fmarples/18649_team4/README.md

# Team 4 Lab 2

**Managed session:** `start.py` starts/connects the Pi bridge and wheel GUI;
`stop.py` stops only the managed pair. Start can cause motion; keep hands clear
and pedals released. See [session ownership and logs](doc/ONE_CLICK_START.md).

`main` contains the combined Part 3 actuator implementation and Part 4 Zephyr
scheduling. Use the current firmware for combined motor, brake, steering and
blinker testing; there is no separate Part 4 application or required rollback.
Part 3.5 ADC acquisition is implemented with nominal ACS712 5A calibration and
upper-ADC-rail clipping at -4320 mA for reversed motor sensors and +4320 mA for
servo. There is no symmetric current cap. Physical calibration and combined timing remain pending.

## Code

- `stm32_zephyr/`: NUCLEO-F401RE firmware, UART parsing, motor/PID control,
  steering, blinkers, self-test, scheduling, current interface and timing markers.
- `pi/`: UDP-to-UART bridge, CRC protocol and optional GPIO timing markers.
- `windows/`: wheel-proxy launcher with event-filtered physical-input logs and
  read-only current charts, servo console and firmware build helper.
- `bringup/encoder_test/` and `bringup/motor_test/`: independent diagnostics.
- `tests/` and `test_protocol.py`: software and explicitly invoked hardware tests.
- `tools/`: generated-build checks, bounded QEMU runner and status-log summary.

The Part 3 integration commit is `3b04a43`; the Part 4 implementation commit is
`18da014`. The retired branches are preserved as archive tags.

## Architecture and operating policy

`Logitech wheel -> Windows proxy -> UDP 8000 -> Pi -> USART1 -> STM32 actuators`

The Pi link uses 115200 baud, 8N1. Commands carry raw wheel/pedal values and
buttons; status carries system state and current validity. Deploy matching
Pi and STM32 versions and all `pi/*.py` dependencies together. Read-only status
returns to the laptop on UDP 8002, separate from force-feedback UDP 8001.

One priority-1 owner applies motor outputs before steering and lamps. Status,
current sampling and USB diagnostics run at priorities 2, 3 and 4 respectively.
The three current channels use ADC1 with nominal calibration; failed or stale
acquisition is unavailable. Current telemetry does not control actuators.

Steering embeds the tracked 1200/1600/2000 us calibration. Boot and fault/link
recovery wait for healthy Pi commands and a centered wheel before LIVE. Vehicle
steering does not require a USB heartbeat; manual calibration retains its lease.
The servo console's OFF command does not stop motors. See the
[integration design](doc/INTEGRATION.md) and [protocol](PROTOCOL.md) for details.

## Team documentation

- [Lab 4 PCB design files, power calculations, pin map and BOM](lab4/README.md)

- [September 28 bench summary: changes, tests and remaining work](doc/SESSION_2026-09-28.md)
- [Actuator stability investigation and verification](doc/ACTUATOR_STABILITY.md)
- [Task table and scheduling rationale](PART4_TASK_TABLE.md)
- [Hardware BOM/power record](doc/HARDWARE.md) and [pin assignments](doc/STM32_PINOUT.md)
- [Encoder calibration](doc/ENCODER_SPEC.md) and [motor characterization](doc/MOTOR_CHARACTERIZATION.md)
- [Current-sensor backend contract](doc/CURRENT_SENSOR_HANDOFF.md)
- [GUI telemetry and physical input logging](doc/GUI_TELEMETRY.md)
- [ADC hang diagnosis and grounding verification](doc/CURRENT_ADC_DIAGNOSIS.md)
- [Centered-start steering policy and evidence](doc/STEERING_AUTONOMOUS.md)
- [Timing points and measurement method](doc/PART4_TIMING.md)
- [Blank measurement worksheet](doc/PART4_MEASUREMENTS.csv)
- [Software verification record](doc/PART4_SOFTWARE_RESULTS.md)
- [Steering evidence](doc/PART3_3_RESULTS.md) and [blinker evidence](doc/PART3_4_RESULTS.md)
- [Lab 2 handout](doc/18-449_649%20Lab2%20-%20Sensors%20and%20Actuators%20v1_0.pdf)

The integrated image builds and software verification is recorded in the linked
reports, including host-dependent test skips. Combined motor/steering operation
and three-channel current acquisition have been observed on the stability branch.
Transient link timeouts, current calibration and physical timing remain open;
software test results do not certify those measurements.

## Build and software checks

From the repository root on Windows, with an installed Zephyr workspace/SDK:

```powershell
.\windows\build_part4.ps1 -ZephyrWorkspace 'C:\path\to\zephyrproject' -Sdk 'C:\path\to\zephyr-sdk'
```

This only builds and checks configuration; it does not flash or open hardware.
Output: `build/part4/zephyr/zephyr.bin`. Generic software checks in the appropriate
Python environment are:

```sh
python -m unittest discover -s tests -p "test_*.py" -v
python test_protocol.py -v
```

Native C wrappers may skip without host GCC; the ARM/QEMU suite lives in
`tests/integration/`. Build outputs and run logs are ignored by Git.
Personal operator walkthroughs and tutoring notes are maintained outside this
repository.
