fmarples/18649_team4/lab4/review-package/Drill-report.txt

Drill report for Lab4.kicad_pcb
Created on 2026-11-02T14:50:01

Copper Layer Stackup:
    =============================================================
    L1 :  F.Cu                      front
    L2 :  In1.Cu                    in1
    L3 :  In2.Cu                    in2
    L4 :  B.Cu                      back

Drill file 'Lab4-PTH.drl' contains
    plated through holes:
    =============================================================
    T1  0.300mm  0.0118"  (997 holes))
    T2  0.400mm  0.0157"  (63 holes))
    T3  0.800mm  0.0315"  (3 holes))
    T4  1.000mm  0.0394"  (192 holes))
    T5  1.020mm  0.0402"  (36 holes))
    T6  1.100mm  0.0433"  (15 holes))
    T7  1.200mm  0.0472"  (2 holes))
    T8  1.780mm  0.0701"  (4 holes))
    T9  1.800mm  0.0709"  (9 holes))
    T10  2.890mm  0.1138"  (2 holes))

    Total plated holes count 1323

Drill file 'Lab4-NPTH.drl' contains
    unplated through holes:
    =============================================================
    T1  1.600mm  0.0630"  (4 holes))
    T2  2.700mm  0.1063"  (4 holes))
    T3  4.000mm  0.1575"  (4 holes))

    Total unplated holes count 12
