fmarples/18649_team4/lab4/CAN-geometry-review.md

# CAN copper geometry review

## November 2 local-pair update

Front B (U15/J14) and Pi B (U35/J34) now share adjacent In2 runs with short
front-layer escapes. Each line uses one via. Same-layer proximity within
1 mm is 93.4%/83.2% for Front B and 90.2%/70.4% for Pi B, with longer local
paths as the tradeoff. Four other local interfaces retain their existing
routes. This is not complete pair coupling or signal-integrity qualification.
See [the complete comparison](November2-Anson-review-check.json).
The main bus routes are unchanged; the current reference-plane scan below
is regenerated against the revised fills.

## November 1 update

The new 0.381 mm CAN-to-zone clearance enlarges the cleared areas around
plated contacts. The refreshed scan records 41 reference-plane gaps outside
the older 1 mm hole-exclusion screen: 12 on CAN_A_H, 10 on CAN_A_L, 10 on
CAN_B_H and 9 on CAN_B_L. All 41 lie within the required clearance around
the actual CAN pad/via shapes; none is an unexplained gap away from those
contacts. [CAN-geometry-check.json](CAN-geometry-check.json) retains their
coordinates and classification. These intentional gaps are still gaps:
the classification does not establish continuous reference copper or
qualify signal integrity. The zero-gap result below describes the earlier
October revision, before the larger clearance rule.

26 October 2026. We measured the saved board geometry with
`check_can_geometry.py`; [CAN-geometry-check.json](CAN-geometry-check.json)
records the source hash and individual inspection coordinates. This review
does not qualify signal integrity or release the board for fabrication.

## Recorded geometry

| Net | Total copper length, including branches | In2 portion | Signal vias |
| --- | ---: | ---: | ---: |
| CAN_A_H | 256.566 mm | 32.471 mm | 4 |
| CAN_A_L | 251.328 mm | 66.210 mm | 13 |
| CAN_B_H | 242.011 mm | 32.471 mm | 4 |
| CAN_B_L | 236.772 mm | 72.710 mm | 13 |

All four nets use 0.20 mm traces on F.Cu and In2.Cu. Totals include test,
termination and node branches; subtracting H and L totals does not give
end-to-end timing skew. About 52–60% of their length has the opposite line
within 0.65 mm on the same layer. This nearest-line measurement does not
establish parallel coupling, nor is that fraction a pass/fail criterion.

For a straight front-layer pair with 0.20 mm traces and 0.40 mm edge spacing,
the approximate microstrip equations in [TI SLVA531A, section 7.1](https://www.ti.com/lit/an/slva531a/slva531a.pdf)
give 124 ohms differential using our [reference stack](Layer-stack.md):
0.21040 mm dielectric, Dk 4.4 and 0.035 mm copper. This is a nominal geometry
calculation. It omits solder mask, nearby coplanar fill, bends, pad transitions,
In2 routing and fabrication tolerances; it is not a whole-bus impedance claim.

## Ground-reference repair and remaining review

The checker samples trace centerlines at intervals no greater than 0.5 mm,
excluding samples within 1 mm of the same signal's through-hole pads/vias.
The F.Cu routes have In1 ground underneath at the remaining sample points.
In2 is closest to B.Cu, whose ground fill contains other routes.

The previous scan found nine CAN_A_H and three CAN_A_L reference-void samples
near the front CAN circuit. We rerouted the bottom 3.3 V feed around the
affected area and moved the F_MOSI crossing. The updated scan finds **zero
reference-void samples on all four nets** outside the excluded pad/via areas.
The CAN backbone copper itself is unchanged, so the lengths above are unchanged.
Sampling does not establish a continuous reference everywhere.

The replacement 3.3 V feed uses four added vias and a 0.50 mm minimum width;
its length increases from 10.833 mm to 47.303 mm. Clear sections are wider.
The F_MOSI replacement decreases from 10.533 mm to 9.292 mm without added
signal vias. [Supply-path-review.md](Supply-path-review.md) records the
resistance cost of preserving the CAN reference. We also added one ground
stitch near the CAN_B_L transition at (151.4, 209.4) mm after relocating a
ground via away from a solder pad. Coordinates are KiCad board coordinates.

## Branch and detour assessment — October 27

The new [digital geometry check](Digital-geometry-check.json) separates the
termination-to-termination path from branch copper. Whole segments and full
1.6 mm via barrels are counted; these are not extracted electrical lengths.

| Net | Main path | Vias on main path | Longest bus-side branch |
| --- | ---: | ---: | ---: |
| A H | 238.781 mm | 4 | 18.591 mm |
| A L | 231.967 mm | 8 | 24.921 mm |
| B H | 220.098 mm | 4 | 24.450 mm |
| B L | 213.284 mm | 8 | 30.921 mm |

Local transceiver-to-isolation copper adds 24.290–35.468 mm and two vias,
plus the jumper contact. Even adding the two largest figures gives about
66.4 mm before the contact, below the 0.3 m stub guideline for 1 Mbps in
[TI's CAN physical-layer guide](https://www.ti.com/lit/an/slla270/slla270.pdf).
That comparison is a scale check, not a controlled-impedance guarantee.

At an assumed 7 ps/mm propagation delay, a roughly 0.31 m path including
local connections has about 2.2 ns one-way delay. This is short relative to
the transceiver's 25 ns minimum high-speed rise-time test value. We therefore
keep the short routes rather than add length merely to equalize the counts.
The recorded main H/L difference is 6.814 mm on each bus; whole-item lengths
cannot establish precise skew. Preserve ground references, separation from
switching copper and the documented stack in subsequent edits. Source:
[SN65HVD231 datasheet](https://www.ti.com/lit/ds/symlink/sn65hvd231.pdf).

The digital branch/detour assessment is complete for this revision. Exact
impedance, reflections and EMC remain unqualified; evaluate the assembled
bus rather than treating this comparison as a measured waveform result.

The distance calculation passed analytic checks for a point on a segment,
beside it and beyond its endpoint. Native DRC and targeted connectivity checks
verify connections separately; they do not validate transmission-line behavior.
