fmarples/18649_team4/lab4/Layer-stack.md

# Four-layer routing reference

**October 30 fabrication handoff:** 4 layers, nominal 1.6 mm,
**JLC04161H-7628, 1 oz outer / 0.5 oz inner copper**. These are the current
saved-board settings; no 2 oz copper or controlled-impedance order is requested.
The same specification is included in the review package's `REVIEW-ONLY.txt`.
This records the intended order settings, not a message sent to staff or an order.

26 October 2026. We use **JLC04161H-7628**, nominal 1.6 mm, as the
reference stack for the remaining layout review. The intended copper weights
are 1 oz outer / 0.5 oz inner. This records a design baseline, not an order or
a controlled-impedance qualification. Confirm the same stack in the final
fabrication package and order settings.

| Layer / material | Published thickness | Our use |
| --- | ---: | --- |
| F.Cu | 0.035 mm | Components, local signals, power and ground fill |
| 7628 prepreg | 0.21040 mm | Dielectric, published Dk 4.4 |
| In1.Cu | 0.0152 mm | Ground plane |
| Core | 1.065 mm | Dielectric, published Dk 4.6 |
| In2.Cu | 0.0152 mm | Signals and provisional supply branches |
| 7628 prepreg | 0.21040 mm | Dielectric, published Dk 4.4 |
| B.Cu | 0.035 mm | Pi socket, signals, power and ground fill |

Source: [JLCPCB stackup table](https://jlcpcb.com/impedance), checked October 26.
These are the fabricator's listed nominal values; they are not measurements of
our board. KiCad now records the detailed copper/dielectric thicknesses and
dielectric constants above as well as four copper layers and nominal 1.6 mm
board thickness. The copper/dielectric sum is 1.5862 mm, before solder mask;
it is consistent with the fabricator's nominal 1.6 mm stack description.
The same published table was rechecked on October 28. This is still not an
impedance-controlled order or a production thickness measurement.

In2 is much closer to B.Cu than to In1.Cu in this arrangement. We therefore
must review the bottom ground fill beneath inner signal routes as well as the
In1 plane. Merely moving a signal to an inner layer does not give it a
continuous nearby ground reference. CAN pair spacing, detours, layer changes
and return continuity still need final refinement. The initial
[CAN geometry audit](CAN-geometry-review.md) records the measured copper and
the repaired reference crossings; its nominal front-pair estimate is not a fabrication
impedance qualification.

The inner copper is thinner than the outer copper. The new supply joins
establish connectivity; they are not a final current rating. Before release,
check the worst supply-path voltage drop and widen or parallel the trunks as
needed. The multiamp Pi, servo and motor paths need their own copper-width and
via review. No hardware tests or fabrication approval are implied.
