fmarples/18649_team4/lab4/Return-path-review.md

# Ground, feedback and supply routing review

26 October 2026. This is a review of the saved copper, not a powered test or
fabrication release. [Return-path-check.json](Return-path-check.json) records
the board hash and geometric/connectivity observations. Run
`check_return_paths.py` with KiCad Python to regenerate it; use the native DRC
report for disconnected copper islands.

## Connections and remaining geometry checks

The three lower feedback resistors now have explicit 0.20 mm front-copper
branches to their regulator ground pins. All three paths pass a connectivity
check with zones excluded during traversal. Their pad-center separation is
6.729 mm. The earlier revision connected them through pours only; that
limitation is now corrected. Because the traces share the ground pour, these
checks do not establish an isolated quiet return or measured noise performance.
Before release, review the actual feedback branch and input/output capacitor
return geometry against the [TPS564252 layout guidance](https://www.ti.com/lit/ds/symlink/tps564252.pdf),
especially the separate feedback return, compact input loop and wide output
capacitor return. Effective capacitance under DC bias remains a separate check.

Both INA180 inputs have explicit paths to the corresponding R1 shunt pads.
Keep these as separate sense branches at the shunt terminals while refining
the connected servo load route; do not move a sense connection onto a distant power
trace. The [INA180 layout guidance](https://www.ti.com/lit/ds/symlink/ina180.pdf)
calls for Kelvin connections and closely matched input routing. Final loop
area and noise coupling still need review. U2/U3 are ACS712 magnetic current
sensors; their motor-current paths need a width/return review, not external
shunt-input routing.

## CAN ground transitions

We added twenty ground vias near CAN signal-layer transitions. The placement
search targeted sites with no ground via or ground through-hole pad within
3 mm, then added a clear site within 2.5 mm. These distances are design-review
targets, not a manufacturer signal-integrity limit. The JSON records every
CAN signal via's distance to the nearest ground transition.

The plane-centerline samples also include ordinary pad/via clearance holes.
A sampled void is a location to inspect, not automatically an electrical
failure. Check the filled In1 plane and bottom ground fill, especially where
routes change layers. [Layer-stack.md](Layer-stack.md) explains why In2 signals
also need the nearby B.Cu reference reviewed. The [CAN geometry audit](CAN-geometry-review.md) now records branch-inclusive
lengths, pair proximity and the repaired bus-A reference crossings. Rerouting
the adjacent 3.3 V and MOSI copper leaves zero CAN reference-void samples
outside the checker's own-pad/via exclusions. That checker uses In1 for F.Cu
and B.Cu for In2, unlike the broad In1-only screening in Return-path-check.json.
We added one further ground stitch near CAN_B_L after moving a ground via
off a solder land. All CAN transitions remain within our 3 mm review target.
The branch/detour assessment is recorded in CAN-geometry-review.md.
Controlled impedance and assembled-bus waveforms remain unqualified.

## Initial supply resistance screening

The new 3.3 V joins connect the main MCU/CAN supply groups to the regulator;
both encoder pull-ups are now connected. The 5 V regulator now reaches all
5 V load groups. The servo shunt reaches J90, and the motor outputs reach
their sensors, connectors and flyback diodes. The existing input-power circuit is now connected. Final current/return
sizing and battery/protection decisions remain unfinished.

[Supply-path-review.md](Supply-path-review.md) now uses actual saved conductor
geometry to screen 3.3 V, 5 V, motor and servo paths. It flags the long supply paths for
load allocation and widening/parallel-via review. The October 27 allocation
and widening results are now recorded in that review. The calculation does not
establish thermal current capability or guaranteed load voltage.

As a calculation example, using copper resistivity 1.72e-8 ohm-metres at about
20 degrees C, a 100 mm long, 0.8 mm wide trace has resistance
`R = resistivity * length / (width * thickness)`:

| Copper thickness | Calculated resistance | Drop at assumed 0.8 A |
| --- | ---: | ---: |
| 0.0152 mm inner copper | 0.141 ohm | 0.113 V |
| 0.035 mm outer copper | 0.0614 ohm | 0.0491 V |

These examples exclude vias, connectors, return resistance and heating, and
are not a calculation of the complete board. Use actual branch loads and
route lengths to check the worst load voltage, then widen or parallel supply
trunks as needed. Check thermal current capability separately. A successful
connectivity check alone does not settle either requirement.

## Routed sense/feedback geometry — October 27

The three feedback returns are explicit 9.250 mm front traces with no vias.
The shunt IN+ route is 22.912 mm with two vias; IN− is 21.453 mm with four.
The servo load route from R1.2 to J90.2 is 98.918 mm with one via. The
shared-conductor check uses object identities and finds zero shared trace/via
objects between either sense branch and its corresponding load route.
This confirms separate routed taps at the shunt. It does not establish
matched loop area, immunity to switching pickup or zero current in shared
pad copper. Keep the sense taps at the shunt; do not add balancing meanders
merely to equalize via count.

The geometry review is complete at this level. The later
[ground-plane DC screen](Ground-plane-review.md) now models the saved In1
fill and shared return currents. It closes the bulk-plane calculation for
the stated scenarios, not local connection resistance or thermal/noise
qualification. Zero unconnected items proves connectivity, not a bound on
ground bounce. Ripple, ADC noise and loaded temperature are assembly/bring-up
tests, not requests to measure the unbuilt PCB before Thursday.

## Supply-width follow-up — October 27

The later supply widening preserves the CAN backbones, via locations,
reference-plane definitions and all pad connections. We restored the old
widths around six front-ground patches after the initial candidate split
one patch; the accepted revision has zero missing ground connections. Fresh
CAN-reference and nearest-ground-transition checks pass their existing
criteria. This verifies connectivity/reference coverage at the checked
locations, not plane voltage drop or switching-noise performance.
