fmarples/18649_team4/doc/INTEGRATION.md

# Integrated firmware

`main` contains one Zephyr application combining Parts 3.1-3.4 with Part 4
scheduling and instrumentation. Part 4 is not a separate replacement for the
actuator implementation: combined Part 3 tests use this same firmware.
The older motor-only commit is an archived diagnostic baseline, not required
for normal combined testing.

## Components and integration decisions

- Motor/encoder/PID implementation from `983cb1b`, combined with steering,
  blinkers and self-test in `3b04a43`.
- Existing 1320 counts/revolution, corrected forward signs, average wheel-speed
  control, 23..300 RPM active targets, 60%/200 ms startup and 40..100% running
  PWM policy retained. Motor/PID tuning was not changed by Part 4.
- Motor PWM remains on TIM3/PB4 and TIM2/PB10 at 10 kHz. Servo PWM is independently
  generated on TIM4/PB9 at 50 Hz. PA5/D13 belongs only to front-right blinker.
- One owner applies motor outputs before servicing servo and lamps. Status,
  current workqueue and USB console have lower application priorities.
- State codes: motor fault 5, self-test 6, actuator fault 7. Pi and STM32 modules
  must use the matching CRC protocol; deploy all `pi/*.py` dependencies together.
- Team steering calibration is tracked as 1200/1600/2000 us in
  `config/servo_calibration.json`; actual mechanical limits require verification
  after linkage changes.

## Fault and operating policy

A/button 0 now latches self-test on the Pi, which stops every UART command
write instead of forwarding A. The existing 60 ms STM32 timeout then requests
dynamic motor braking and hazards and disables LIVE steering. The Pi preserves
the 400 ms double-press window and 20 ms release debounce; status reception and
forwarding continue while latched. A self-test appears as ERROR_TIMEOUT (2),
not the firmware's direct-command SELF_TEST (6). See
[the protocol](../PROTOCOL.md#blinkers-self-test-and-steering) for recovery and
the 10 ms requirements-table versus 100 ms checkoff timing conflict. B1 retains the motor implementation's latched
enable-low/coast stop until reset. A peripheral output failure latches an
actuator fault. Failed output hardware cannot guarantee physical braking.

Servo embeds the 1200/1600/2000 us calibration and waits for healthy Pi commands
and a centered wheel before LIVE, both at boot and after link/fault recovery.
Vehicle steering requires no USB heartbeat. Manual calibration retains its
500 ms USB lease. Explicit OFF stays off until AUTO or a manual command; the
servo console's OFF command does not stop motors. See [steering policy and
verification](STEERING_AUTONOMOUS.md).

## Part 4 additions

Commit `18da014` adds the priority-3 dedicated current workqueue/cache interface,
timing markers, logging and build/test support. Application priorities are
control 1, status 2, current workqueue 3 and console 4. The UART command timeout
is 60 ms; Pi UDP freshness is 80 ms. See the [task table](../PART4_TASK_TABLE.md)
for cadence, synchronization, latency targets and upstream fault distinctions.

Part 3.5 now acquires ADC1 channels 0/1/8 with nominal ACS712 5A calibration,
signed readings and upper-ADC-rail endpoints of -4320 mA for reversed motor
sensors and +4320 mA for servo, without a symmetric current cap. Failed or stale
acquisition is unavailable. No current-based control decision is implemented.
Physical calibration remains pending; the [sensor interface](CURRENT_SENSOR_HANDOFF.md)
defines conversion, validity and verification limits.

## Verification and references

The integrated image builds and software tests pass. Individual steering and
blinker operation has been reported; combined-board operation and physical
timing have not been demonstrated by these commits. See the
[software evidence](PART4_SOFTWARE_RESULTS.md), [pin map](STM32_PINOUT.md),
[hardware record](HARDWARE.md), [timing points](PART4_TIMING.md) and
[measurement worksheet](PART4_MEASUREMENTS.csv).

Firmware build output is `build/part4/zephyr/zephyr.bin`. No rollback to the
motor-only image is required to test the integrated implementation.
