fmarples/18649_team4/lab4/review-package/Current-evidence.md

# Current evidence and measurement record

## Current operating estimate — October 29

The bare-Pi planning allowance is now 1.5 A plus 0.3 A for other 5 V loads.
The regulated-output total is 14.4084 W; with the 0.72 A motor proxy,
Ibat is 2.247 A at 11.1 V / 85% before input losses. The updated 80%-efficiency
model including stated hot-copper/FET/fuse/harness allowances gives
2.19–2.50 A across 12.6–10.5 V. None is a measured or guaranteed maximum.
The servo duty assumption gives 0.39 A average and 0.953 A RMS; heating must
not be calculated from the average alone. See
[Prototype-operating-review.md](Prototype-operating-review.md) and
[Prototype-power-check.json](Prototype-power-check.json).

The older 3.3 A 5 V cases below are retained as dated stress records. They
are not the current normal-use budget or required sustained 3 A Pi tests.
Actual startup/workload/temperature tests follow assembly.

## Selected LiPo scenario — October 28

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

## October 24 review clarification

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

## Existing Lab 2 evidence

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

## Values used for design

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

For measured rail averages at their actual voltages:

`Ibat ≈ Imotor_supply + (Vservo·Iservo/ηservo + V5·I5/η5 + Vlogic·Ilogic/ηlogic)/Vbat`.

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

## Estimates and assignment requirements

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

## Measurement protocol

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

## October 24 servo source review and preliminary average case

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

## October 25 estimate sensitivity and measurement scope

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

We checked how the existing estimates change with input voltage and efficiency:

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
