fmarples/18649_team4/doc/assets/JGB37-520R30-12-spec.png

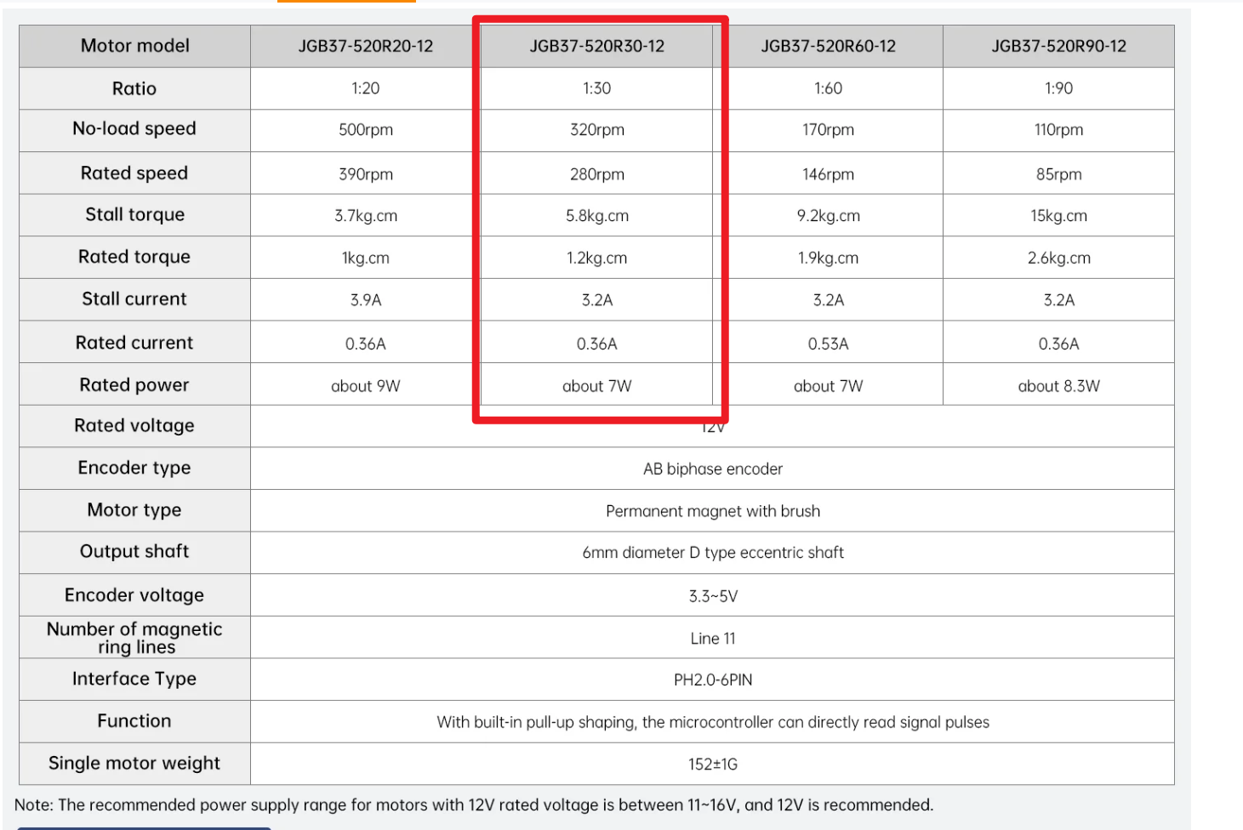
doc/assets/JGB37-520R30-12-spec.png
