fmarples/18649_team4/lab4/Chassis-CAD-comparison.png

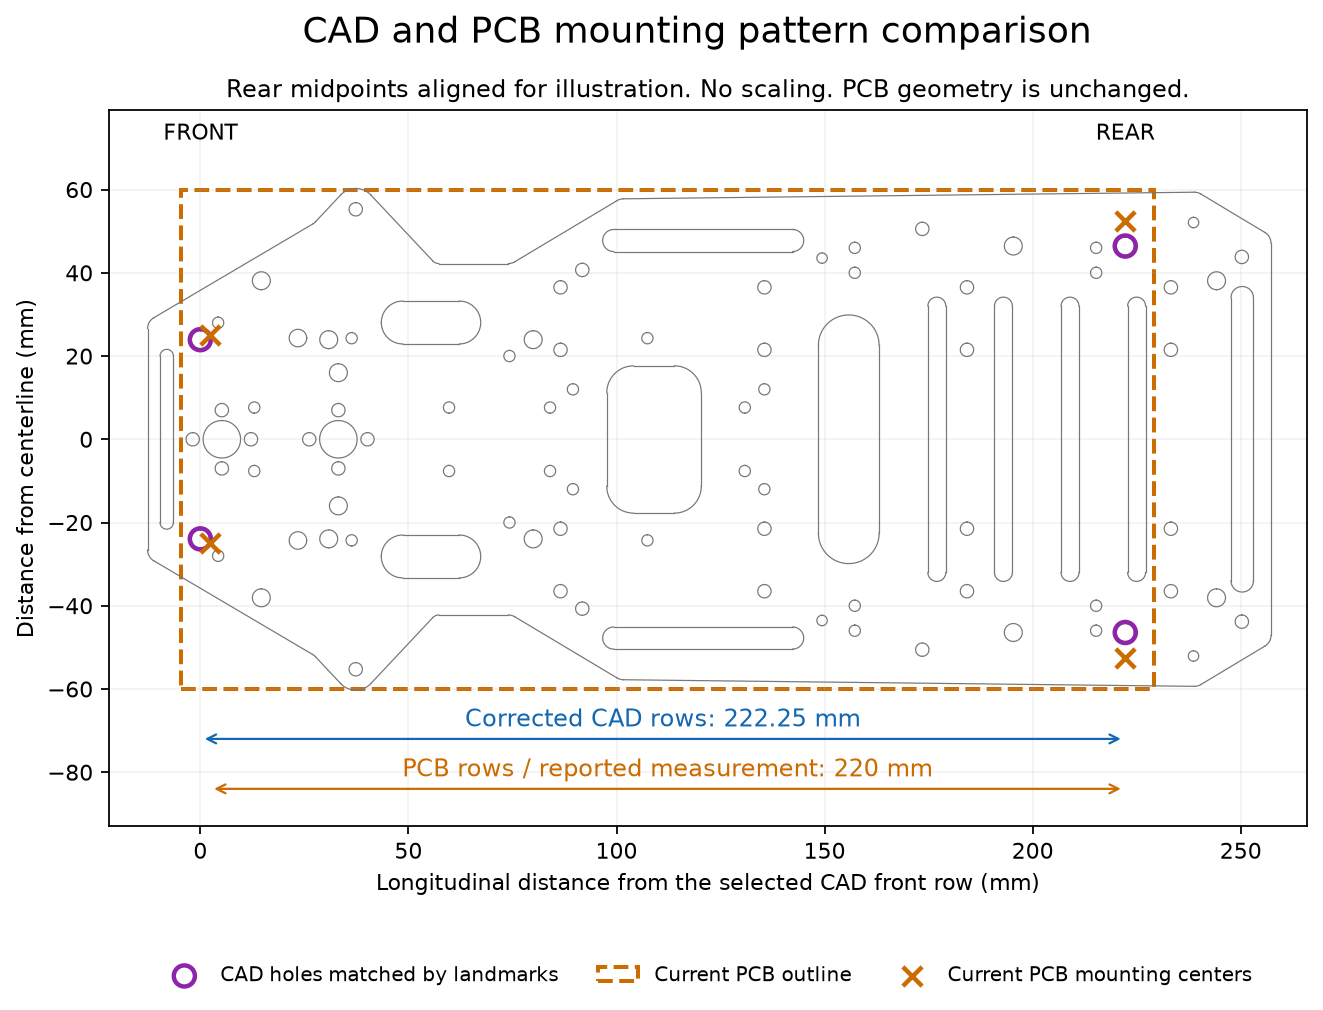
lab4/Chassis-CAD-comparison.png
