fmarples/18649_team4/lab4/Chassis-hole-correspondence.png

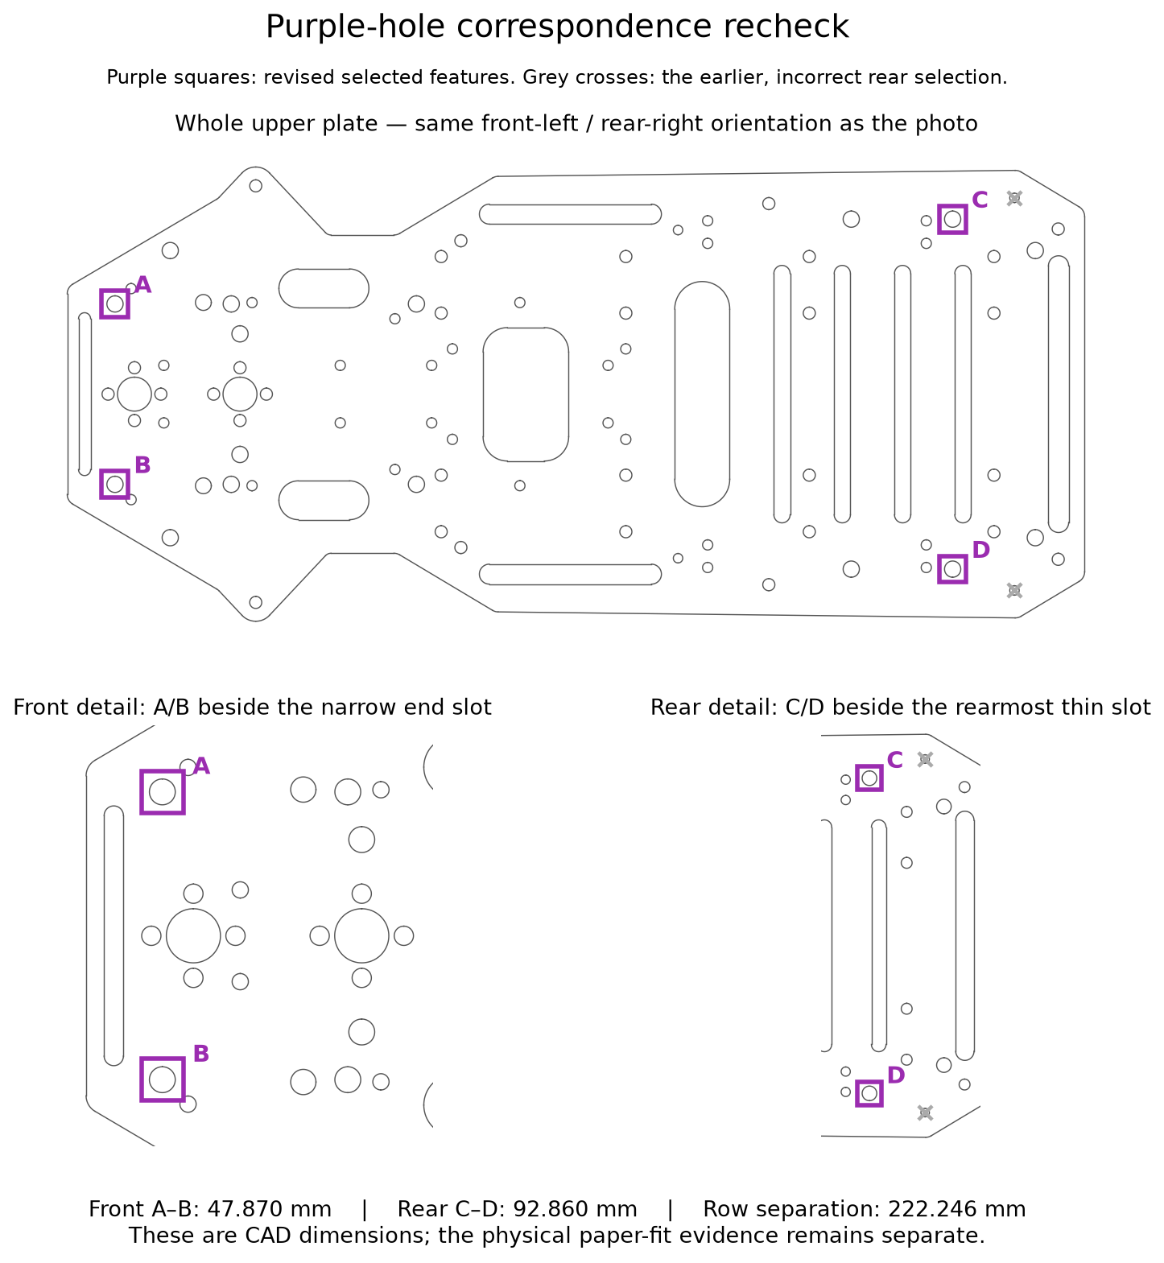
lab4/Chassis-hole-correspondence.png
