fmarples/18649_team4/lab4/measurements/chassis-mounting-2026-10-23.jpg

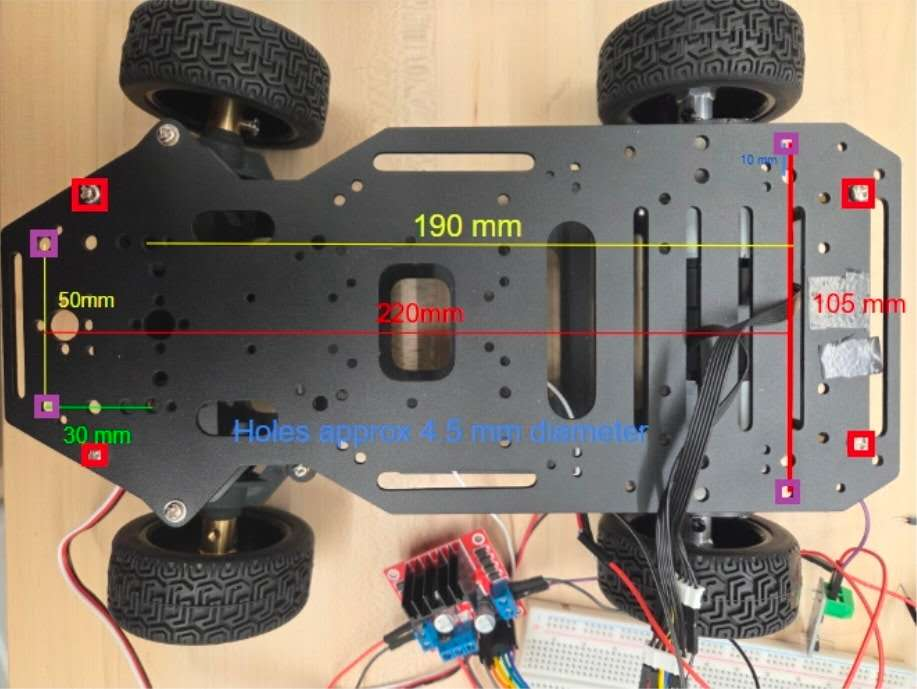
lab4/measurements/chassis-mounting-2026-10-23.jpg
