fmarples/18649_team4/lab4/Pi-stack-side-view.png

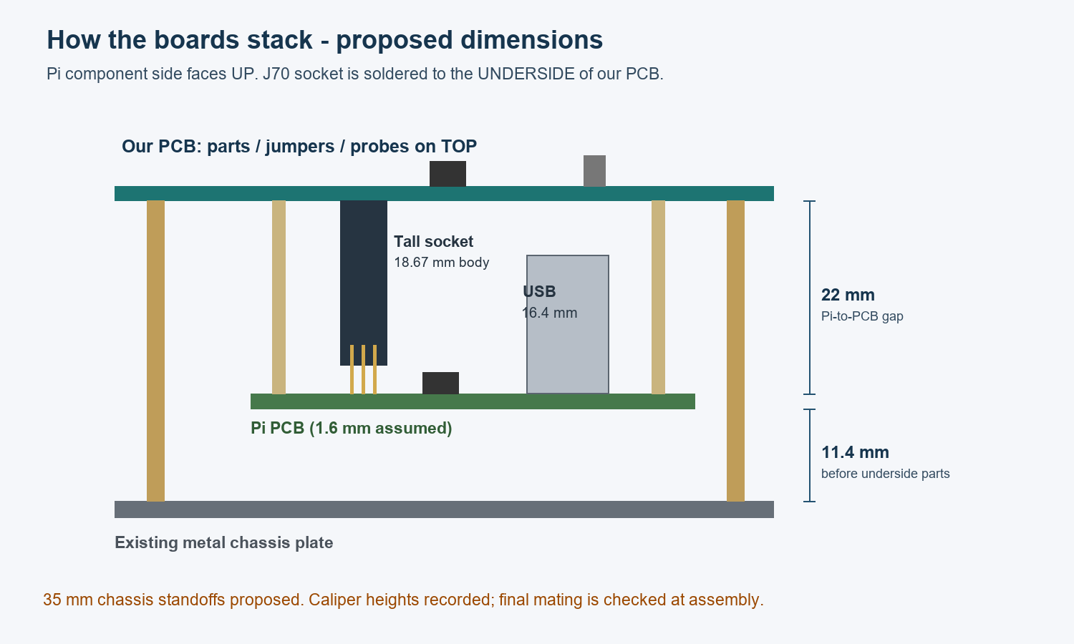
lab4/Pi-stack-side-view.png
