fmarples/18649_team4/lab4/Placement-overview.png

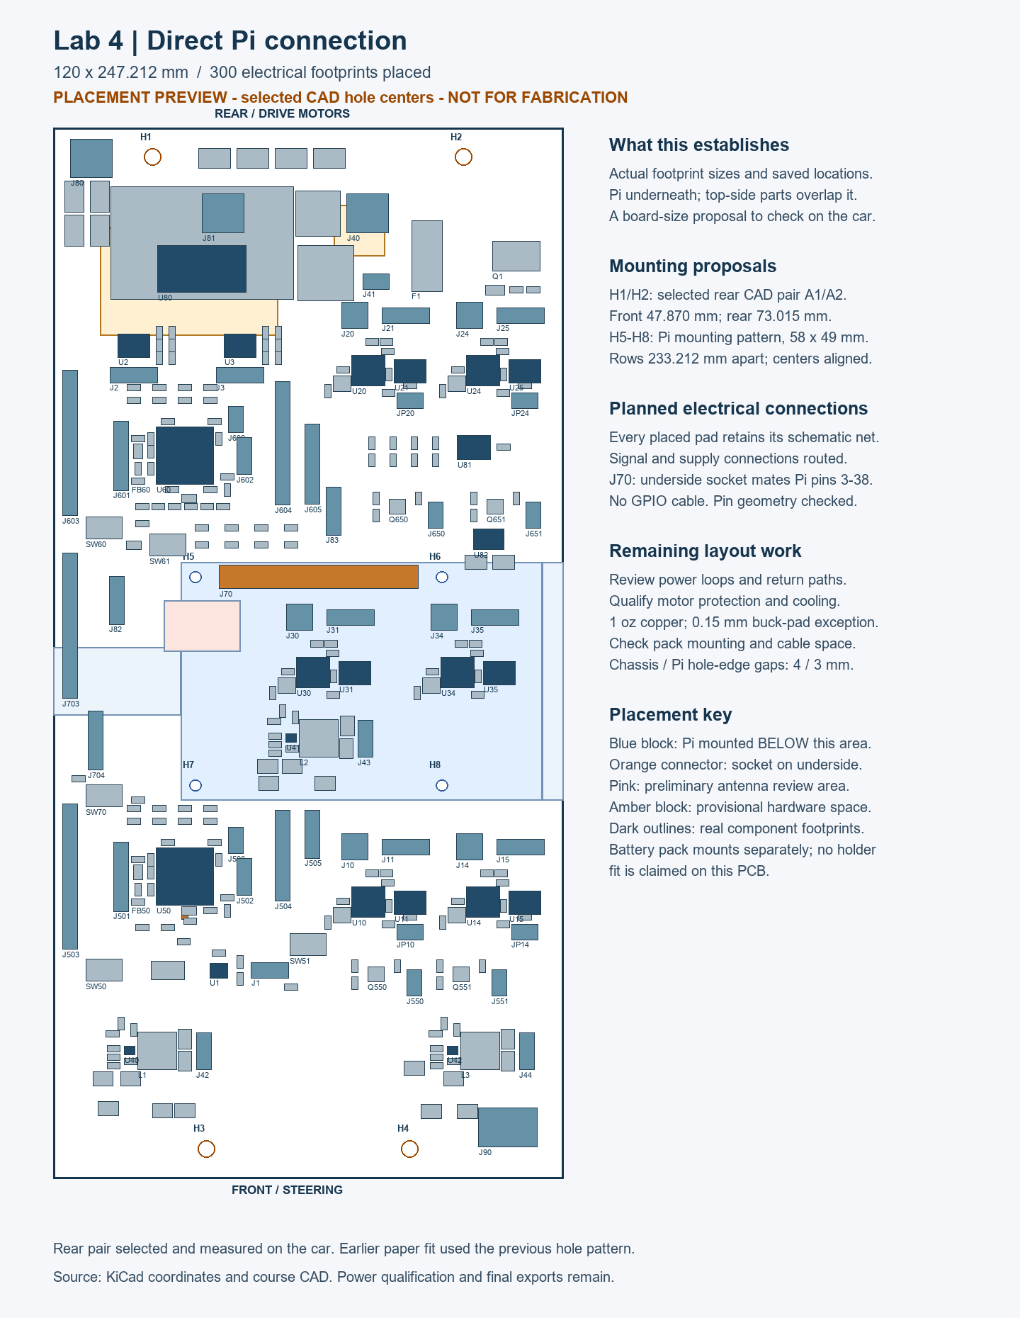
lab4/Placement-overview.png
