fmarples/18649_team4/lab4/review-package/Gerber-bottom.png

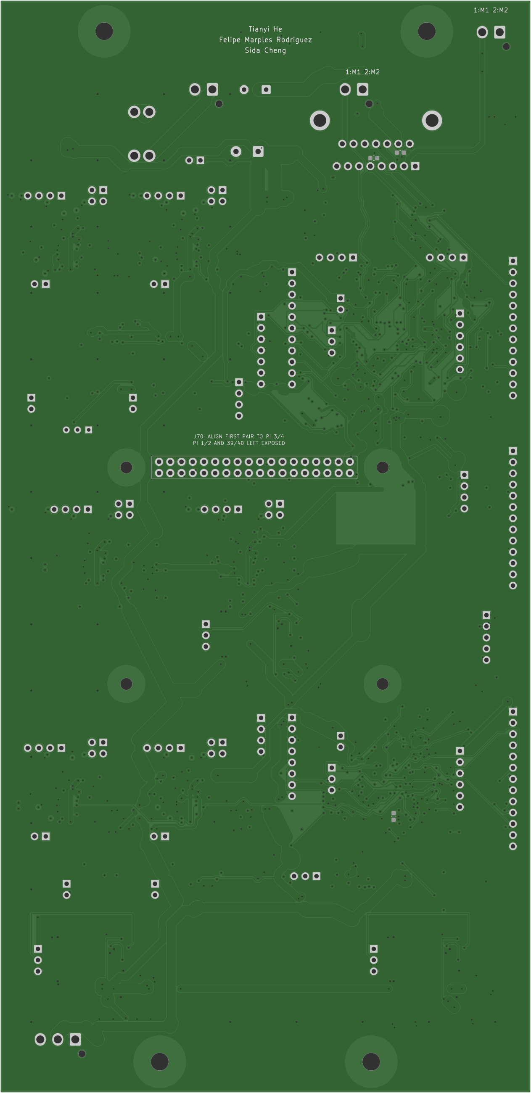
lab4/review-package/Gerber-bottom.png
