fmarples/18649_team4/lab4/review-package/Gerber-top.png

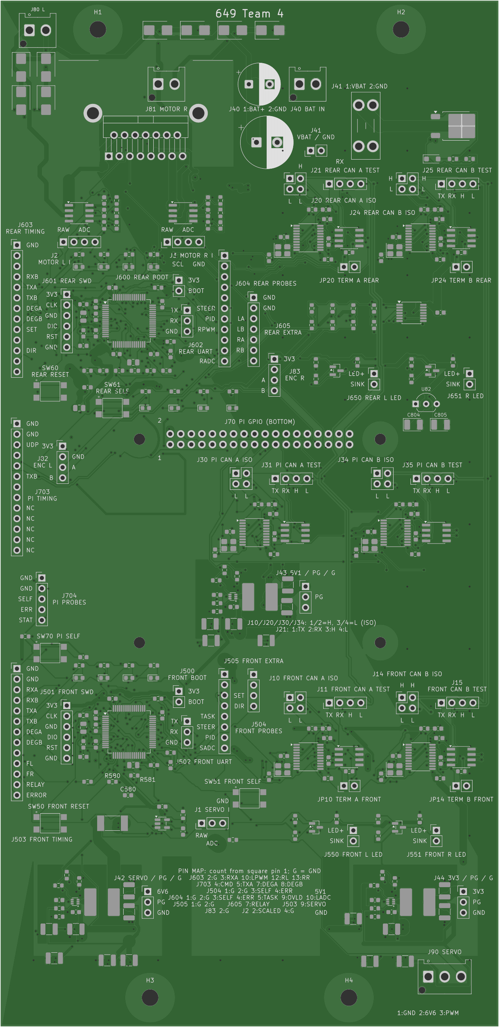
lab4/review-package/Gerber-top.png
