fmarples/18649_team4/lab4/review-package/PCB-bottom.png

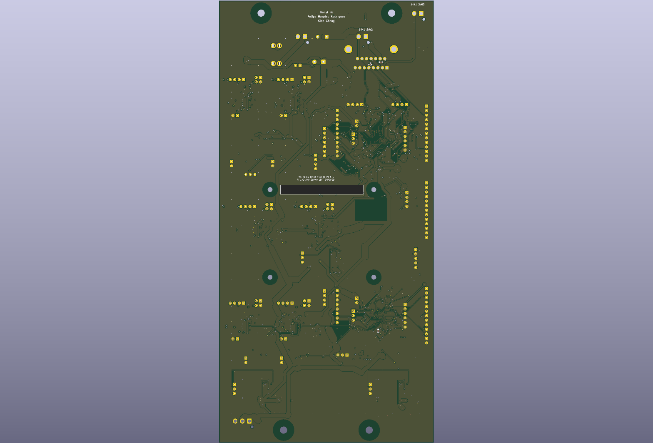
lab4/review-package/PCB-bottom.png
