fmarples/18649_team4/lab4/review-package/PCB-top.png

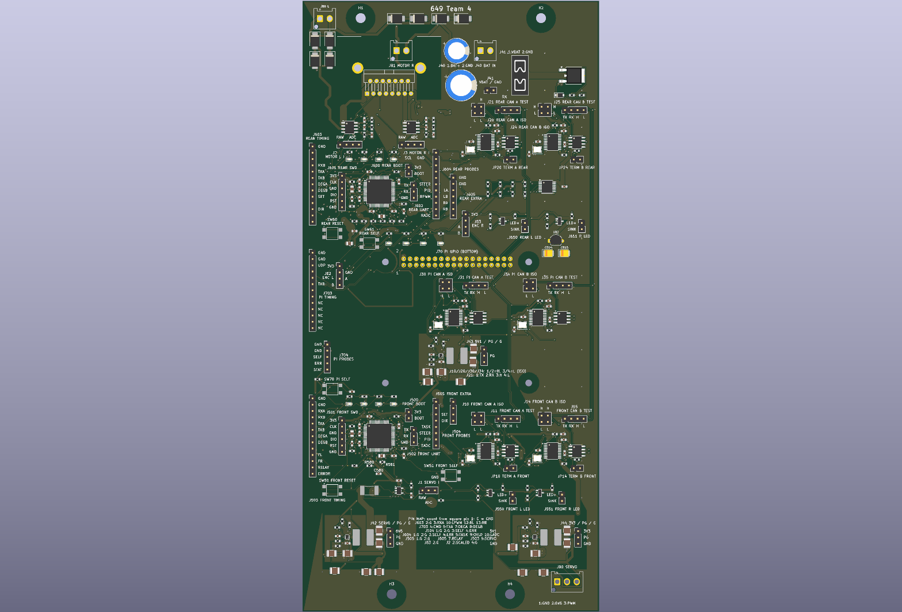
lab4/review-package/PCB-top.png
