fmarples/18649_team4/lab4/BOM-JLC-hybrid.csv

References | Quantity | MPN | Value | Footprint | Extra_for_hand_rework | Check | Assembly | Procurement | LCSC | Source_URL | Manufacturer | Course_stock | Supplier_URL | JLC_selected_MPN | Match_status
U10 U14 U20 U24 U30 U34 | 6 | MCP2515T-I/ST | MCP2515T-I/ST | Package_SO:TSSOP-20_4.4x6.5mm_P0.65mm | 1 | Preliminary; verify before fabrication | Historical JLC comparison; course requires team assembly | Not selected for assembly ordering; use BOM-Hand-assembly.csv | C185941 | https://jlcpcb.com/partdetail/MicrochipTech-MCP2515T_IST/C185941 | Microchip Technology | Course v3 exact MPN | https://www.digikey.com/short/9n43978z | MCP2515T-I/ST | Exact MPN/package catalog identity verified; live stock/quote pending
U11 U15 U21 U25 U31 U35 | 6 | SN65HVD231DR | SN65HVD231DR | Package_SO:SOIC-8_3.9x4.9mm_P1.27mm | 1 | Exact MPN appears in course v3 stock list; TI SOIC-8 pinout checked | Historical JLC comparison; course requires team assembly | Not selected for assembly ordering; use BOM-Hand-assembly.csv | C129257 | https://jlcpcb.com/partdetail/TexasInstruments-SN65HVD231DR/C129257 | Texas Instruments | Course v3 exact MPN | https://www.digikey.com/short/2q3q8t40 | SN65HVD231DR | Exact MPN/package catalog identity verified; live stock/quote pending
Y10 Y14 Y20 Y24 Y30 Y34 | 6 | CX3225SB16000H0FLJCC | 16 MHz | Crystal:Crystal_SMD_3225-4Pin_3.2x2.5mm | 1 | Load capacitor values require crystal CL and PCB stray capacitance | Historical JLC comparison; course requires team assembly | Not selected for assembly ordering; use BOM-Hand-assembly.csv |  |  | KYOCERA AVX | Course v3 exact MPN | https://www.digikey.com/short/vq8f334d | CX3225SB16000H0FLJCC | Exact library match pending
C100 C101 C140 C141 C200 C201 C240 C241 C300 C301 C340 C341 | 12 | GRM1885C1H180JA01D | 18p C0G 50V | Capacitor_SMD:C_0603_1608Metric | 1 | CL=12pF; equal 18pF caps assume 3pF effective stray; tune after layout/clock measurement | Historical JLC comparison; course requires team assembly | Not selected for assembly ordering; use BOM-Hand-assembly.csv |  |  | Murata | Not in course v3 by exact MPN; additional sourcing | https://www.digikey.com/en/products/detail/murata-electronics/GRM1885C1H180JA01D/586919 | GRM1885C1H180JA01D | Exact library match pending
R100 R101 R140 R141 R200 R201 R240 R241 R300 R301 R340 R341 R3 R4 R6 R7 R400 R413 R423 R433 R804 R805 R806 R807 | 24 | CRCW060310K0FKEA | 10k | Resistor_SMD:R_0603_1608Metric | 2 | Preliminary; verify before fabrication; Calculated design; not bench validated; Calculated circuit; not hardware validated | Historical JLC comparison; course requires team assembly | Not selected for assembly ordering; use BOM-Hand-assembly.csv |  |  | Vishay | Course v3 exact MPN | https://www.digikey.com/short/br7d02pp | CRCW060310K0FKEA | Exact library match pending
C102 C103 C104 C142 C143 C144 C202 C203 C204 C242 C243 C244 C302 C303 C304 C342 C343 C344 C1 C2 C3 C5 C6 C8 C701 C801 C803 C580 | 28 | KGM15AR71C104KT | 100n | Capacitor_SMD:C_0603_1608Metric | 3 | Preliminary; verify before fabrication; Locate at associated supply pin; verify effective capacitance; Local decoupling; effective capacitance and layout to verify | Historical JLC comparison; course requires team assembly | Not selected for assembly ordering; use BOM-Hand-assembly.csv |  |  | KYOCERA AVX | Course v3 exact MPN | https://www.digikey.com/short/dzn7v8v4 | KGM15AR71C104KT | Exact library match pending
J10 J20 J30 | 3 |  | CAN A isolation | Connector_PinHeader_2.54mm:PinHeader_2x02_P2.54mm_Vertical | 1 | Shunts 1-2 and 3-4; remove both to isolate this node | Historical JLC comparison; course requires team assembly | Not selected for assembly ordering; use BOM-Hand-assembly.csv |  |  | Unspecified | Course v3 generic header; verify row/pin dimensions |  |  | Exact library match pending
J11 J21 J31 | 3 |  | CAN A test | Connector_PinHeader_2.54mm:PinHeader_1x04_P2.54mm_Vertical | 1 | Preliminary; verify before fabrication | Historical JLC comparison; course requires team assembly | Not selected for assembly ordering; use BOM-Hand-assembly.csv |  |  | Unspecified | Course v3 generic header; verify row/pin dimensions |  |  | Exact library match pending
JP10 JP20 | 2 |  | TERM A | Connector_PinHeader_2.54mm:PinHeader_1x02_P2.54mm_Vertical | 1 | Preliminary; verify before fabrication | Historical JLC comparison; course requires team assembly | Not selected for assembly ordering; use BOM-Hand-assembly.csv |  |  | Unspecified | Course v3 generic header; verify row/pin dimensions |  |  | Exact library match pending
R102 R142 R202 R242 | 4 | RC0603FR-07120RL | 120R | Resistor_SMD:R_0603_1608Metric | 1 | Preliminary; verify before fabrication | Historical JLC comparison; course requires team assembly | Not selected for assembly ordering; use BOM-Hand-assembly.csv |  |  | YAGEO | Course v3 exact MPN | https://www.digikey.com/short/3v4wdv91 | RC0603FR-07120RL | Exact library match pending
J14 J24 J34 | 3 |  | CAN B isolation | Connector_PinHeader_2.54mm:PinHeader_2x02_P2.54mm_Vertical | 1 | Shunts 1-2 and 3-4; remove both to isolate this node | Historical JLC comparison; course requires team assembly | Not selected for assembly ordering; use BOM-Hand-assembly.csv |  |  | Unspecified | Course v3 generic header; verify row/pin dimensions |  |  | Exact library match pending
J15 J25 J35 | 3 |  | CAN B test | Connector_PinHeader_2.54mm:PinHeader_1x04_P2.54mm_Vertical | 1 | Preliminary; verify before fabrication | Historical JLC comparison; course requires team assembly | Not selected for assembly ordering; use BOM-Hand-assembly.csv |  |  | Unspecified | Course v3 generic header; verify row/pin dimensions |  |  | Exact library match pending
JP14 JP24 | 2 |  | TERM B | Connector_PinHeader_2.54mm:PinHeader_1x02_P2.54mm_Vertical | 1 | Preliminary; verify before fabrication | Historical JLC comparison; course requires team assembly | Not selected for assembly ordering; use BOM-Hand-assembly.csv |  |  | Unspecified | Course v3 generic header; verify row/pin dimensions |  |  | Exact library match pending
R1 | 1 | WSL2512R0100FEA | 10mR / 1W / 1% | Lab4_Power:Vishay_WSL2512_7m_to_500m | 4 | Vishay 30100 p2 land pattern; 10mOhm 1W 1%; 0.16W at 4A; Kelvin routing still required | Historical JLC comparison; course requires team assembly | Not selected for assembly ordering; use BOM-Hand-assembly.csv | C844901 | https://jlcpcb.com/partdetail/VishayIntertech-WSL2512R0100FEA/C844901 | Vishay Dale | Additional purchase / exact candidate | https://www.digikey.com/en/products/detail/vishay-dale/WSL2512R0100FEA/712561 | WSL2512R0100FEA | Exact MPN/package catalog identity verified; live stock/quote pending
U1 | 1 | INA180A2IDBVR | INA180A2IDBVR | Package_TO_SOT_SMD:SOT-23-5 | 1 | Preliminary; verify before fabrication | Historical JLC comparison; course requires team assembly | Not selected for assembly ordering; use BOM-Hand-assembly.csv | C192764 | https://jlcpcb.com/partdetail/TexasInstruments-INA180A2IDBVR/C192764 | Texas Instruments | Additional purchase / exact candidate | https://www.digikey.com/en/products/detail/texas-instruments/INA180A2IDBVR/8132987 | INA180A2IDBVR | Exact MPN/package catalog identity verified; live stock/quote pending
R2 | 1 | RC0603FR-074K7L | 4.7k | Resistor_SMD:R_0603_1608Metric | 1 | Preliminary; verify before fabrication | Historical JLC comparison; course requires team assembly | Not selected for assembly ordering; use BOM-Hand-assembly.csv |  |  | YAGEO | Course v3 exact MPN | https://www.digikey.com/short/p9rj0720 | RC0603FR-074K7L | Exact library match pending
J1 | 1 |  | Sense test points | Connector_PinHeader_2.54mm:PinHeader_1x03_P2.54mm_Vertical | 1 | Preliminary; verify before fabrication | Historical JLC comparison; course requires team assembly | Not selected for assembly ordering; use BOM-Hand-assembly.csv |  |  | Unspecified | Course v3 generic header; verify row/pin dimensions |  |  | Exact library match pending
U2 U3 | 2 | ACS712ELCTR-05B-T | ACS712ELCTR-05B-T | Package_SO:SOIC-8_3.9x4.9mm_P1.27mm | 1 | Preliminary; verify before fabrication | Historical JLC comparison; course requires team assembly | Not selected for assembly ordering; use BOM-Hand-assembly.csv | C44471 | https://jlcpcb.com/partdetail/45473-ACS712ELCTR_05BT/C44471 | Allegro MicroSystems | Course v3 exact MPN | https://www.digikey.com/short/jv429bvf | ACS712ELCTR-05B-T | Exact manufacturer/MPN/package catalog identity; stock and assembly acceptance pending
C4 C7 | 2 | GCM1885C2A102FA16D | 1n | Capacitor_SMD:C_0603_1608Metric | 1 | Preliminary; verify before fabrication | Historical JLC comparison; course requires team assembly | Not selected for assembly ordering; use BOM-Hand-assembly.csv |  |  | Murata | Course v3 exact MPN | https://www.digikey.com/short/9t2hw2r4 | GCM1885C2A102FA16D | Exact library match pending
R5 R8 R510 R511 R512 R513 R610 R611 R612 R613 R710 R711 R712 R713 | 14 | ERJ-3EKF1001V | 1k | Resistor_SMD:R_0603_1608Metric | 1 | Preliminary; verify before fabrication; Schematic connected; placement and hardware validation pending | Historical JLC comparison; course requires team assembly | Not selected for assembly ordering; use BOM-Hand-assembly.csv |  |  | Panasonic | Course v3 exact MPN | https://www.digikey.com/short/n7qdn882 | ERJ-3EKF1001V | Exact library match pending
J2 J3 | 2 |  | Current test | Connector_PinHeader_2.54mm:PinHeader_1x04_P2.54mm_Vertical | 1 | Preliminary; verify before fabrication | Historical JLC comparison; course requires team assembly | Not selected for assembly ordering; use BOM-Hand-assembly.csv |  |  | Unspecified | Course v3 generic header; verify row/pin dimensions |  |  | Exact library match pending
J40 | 1 | DF63M-2P-3.96DSA | Battery input: 1=+ 2=GND | Connector_Hirose:Hirose_DF63M-2P-3.96DSA_1x02_P3.96mm_Vertical | 1 | Teammate connector proposal; 14A header rating; verify wire/contact derating and fuse | Historical JLC comparison; course requires team assembly | Not selected for assembly ordering; use BOM-Hand-assembly.csv |  |  | Hirose | Not in course v3 by exact MPN; additional sourcing | https://www.digikey.com/en/products/detail/hirose-electric-co-ltd/DF63M-2P-3-96DSA/9695031 | DF63M-2P-3.96DSA | Exact library match pending
F1 | 1 | 3568 | Fuse: rating TBD | Fuse:Fuseholder_Blade_Mini_Keystone_3568 | 1 | Fuse must coordinate with holder/wire rating and measured inrush; not selected from peak estimate alone | Historical JLC comparison; course requires team assembly | Not selected for assembly ordering; use BOM-Hand-assembly.csv |  |  | Keystone Electronics | Not in course v3 by exact MPN; additional sourcing | https://www.digikey.com/en/products/detail/keystone-electronics/3568/2137306 | 3568 | Exact library match pending
Q1 | 1 | DMPH3010LK3-13 | DMPH3010LK3-13 | Package_TO_SOT_SMD:TO-252-2 | 1 | Reverse-polarity: drain toward battery, source toward load. Manufacturer G1 D2 S3. Not a reverse-current blocker. | Historical JLC comparison; course requires team assembly | Not selected for assembly ordering; use BOM-Hand-assembly.csv |  |  | Diodes Incorporated | Not in course v3 by exact MPN; additional sourcing | https://www.digikey.com/en/products/detail/diodes-incorporated/DMPH3010LK3-13/7352990 | DMPH3010LK3-13 | Exact library match pending
R401 R412 | 2 | RC0603FR-0747KL | 47k | Resistor_SMD:R_0603_1608Metric | 1 | Calculated design; not bench validated | Historical JLC comparison; course requires team assembly | Not selected for assembly ordering; use BOM-Hand-assembly.csv |  |  | YAGEO | Course v3 exact MPN | https://www.digikey.com/short/c4nn83n9 | RC0603FR-0747KL | Exact library match pending
D40 | 1 | BZT52C12 | 12V gate clamp | Diode_SMD:D_SOD-123F | 1 | Cathode at source, anode at gate; clamp protects VGS, not the battery rail | Historical JLC comparison; course requires team assembly | Not selected for assembly ordering; use BOM-Hand-assembly.csv |  |  | Diotec | Not in course v3 by exact MPN; additional sourcing | https://www.digikey.com/en/products/detail/diotec-semiconductor/BZT52C12/22189788 | BZT52C12 | Exact library match pending
C400 | 1 | UPW1E102MHD | 1000u / 25V | Capacitor_THT:CP_Radial_D12.5mm_P5.00mm | 1 | Nichicon: diameter 12.5 mm, height 20 mm, pitch 5 mm; 1.66 A high-frequency ripple rating. Application ripple/thermal check pending. | Historical JLC comparison; course requires team assembly | Not selected for assembly ordering; use BOM-Hand-assembly.csv |  |  | Nichicon | Not in course v3 by exact MPN; additional sourcing | https://www.digikey.com/en/products/detail/nichicon/UPW1E102MHD/589572 | UPW1E102MHD | Exact library match pending
J41 | 1 |  | VBAT test | Connector_PinHeader_2.54mm:PinHeader_1x02_P2.54mm_Vertical | 1 | Calculated design; not bench validated | Historical JLC comparison; course requires team assembly | Not selected for assembly ordering; use BOM-Hand-assembly.csv |  |  | Unspecified | Course v3 generic header; verify row/pin dimensions |  |  | Exact library match pending
U40 U41 U42 | 3 | TPS564252DRLR | TPS564252DRLR | Package_TO_SOT_SMD:SOT-563 | 1 | Calculated design; not bench validated | Historical JLC comparison; course requires team assembly | Not selected for assembly ordering; use BOM-Hand-assembly.csv | C19191267 | https://jlcpcb.com/partdetail/TexasInstruments-TPS564252DRLR/C19191267 | Texas Instruments | Course v3 exact MPN | https://www.digikey.com/short/b8vwdnm0 | TPS564252DRLR | Exact MPN/package catalog identity verified; live stock/quote pending
L1 L2 L3 | 3 | SDCHA1V8040-4R7-R | 4.7uH / 5.8A | Lab4_Power:Eaton_SDCHA1V8040 | 1 | 5.8 A thermal / 6.7 A saturation at datasheet conditions; validate ripple/temperature | Historical JLC comparison; course requires team assembly | Not selected for assembly ordering; use BOM-Hand-assembly.csv |  |  | Eaton | Course v3 exact MPN | https://www.digikey.com/short/v01w3qmn | SDCHA1V8040-4R7-R | Exact library match pending
C410 C412 C413 C415 C416 C417 C418 C420 C422 C423 C425 C426 C427 C430 C432 C433 C435 C436 C437 | 19 | GRM32ER61E226KE15L | 22u 25V X5R 10%, input/output banks | Capacitor_SMD:C_1210_3225Metric | 4 | Revised banks; 3 per input; 4/3/3 servo/Pi/logic outputs. See Capacitor-bank-review.md. | Historical JLC comparison; course requires team assembly | Not selected for assembly ordering; use BOM-Hand-assembly.csv |  |  | Murata | Not in course v3 by exact MPN; additional sourcing | https://www.digikey.com/en/products/detail/murata-electronics/GRM32ER61E226KE15L/965931 | GRM32ER61E226KE15L | Exact library match pending; no assembly order
C411 C421 C431 | 3 | GRM188R71H104KA93D | 100n / 50V | Capacitor_SMD:C_0603_1608Metric | 1 | Higher voltage input bypass than 16 V shelf capacitor | Historical JLC comparison; course requires team assembly | Not selected for assembly ordering; use BOM-Hand-assembly.csv |  |  | Murata | Not in course v3 by exact MPN; additional sourcing | https://www.digikey.com/en/products/detail/murata-electronics/GRM188R71H104KA93D/587143 | GRM188R71H104KA93D | Exact library match pending
R410 | 1 | RC0603FR-07100KL | 100k 1% | Resistor_SMD:R_0603_1608Metric | 1 | Calculated design; not bench validated | Historical JLC comparison; course requires team assembly | Not selected for assembly ordering; use BOM-Hand-assembly.csv |  |  | YAGEO | Not in course v3 by exact MPN; additional sourcing | https://www.digikey.com/en/products/detail/yageo/RC0603FR-07100KL/726889 | RC0603FR-07100KL | Exact library match pending
R411 | 1 | CRCW060310K0FKEA | 10k 1% | Resistor_SMD:R_0603_1608Metric | 1 | Calculated design; not bench validated | Historical JLC comparison; course requires team assembly | Not selected for assembly ordering; use BOM-Hand-assembly.csv |  |  | Vishay | Course v3 exact MPN | https://www.digikey.com/short/br7d02pp | CRCW060310K0FKEA | Exact library match pending
R431 R421 R581 | 3 | RT0603BRD0710KL | 10k 0.1% | Resistor_SMD:R_0603_1608Metric | 2 | Calculated design; not bench validated | Historical JLC comparison; course requires team assembly | Not selected for assembly ordering; use BOM-Hand-assembly.csv |  |  | YAGEO | Additional DigiKey purchase; 0.1% logic feedback divider | https://www.digikey.com/en/products/detail/yageo/RT0603BRD0710KL/4340589 | RT0603BRD0710KL | Historical comparison only; library match not verified
R414 R424 R434 | 3 | CRCW060310K0FKEA | 10k PG pullup | Resistor_SMD:R_0603_1608Metric | 1 | Calculated design; not bench validated | Historical JLC comparison; course requires team assembly | Not selected for assembly ordering; use BOM-Hand-assembly.csv |  |  | Vishay | Course v3 exact MPN | https://www.digikey.com/short/br7d02pp | CRCW060310K0FKEA | Exact library match pending
J42 J43 J44 | 3 |  | Rail / PG / GND | Connector_PinHeader_2.54mm:PinHeader_1x03_P2.54mm_Vertical | 1 | Calculated design; not bench validated | Historical JLC comparison; course requires team assembly | Not selected for assembly ordering; use BOM-Hand-assembly.csv |  |  | Unspecified | Course v3 generic header; verify row/pin dimensions |  |  | Exact library match pending
R420 | 1 | RT0603BRD0775KL | 75k 0.1% | Resistor_SMD:R_0603_1608Metric | 1 | Calculated design; not bench validated Procurement alternate: Susumu RG1608P-753-B-T5 (75k 0.1% 0.1W 0603 25ppm/C); use instead of primary, not both. Primary out of stock2026-10-24; alternate stock not reserved. | Historical JLC comparison; course requires team assembly | Not selected for assembly ordering; use BOM-Hand-assembly.csv |  |  | YAGEO | Not in course v3 by exact MPN; additional sourcing | https://www.digikey.com/en/products/detail/susumu/RG1608P-753-B-T5/1240628 | RT0603BRD0775KL | Exact library match pending
R422 | 1 | RC0603FR-0733KL | 33k | Resistor_SMD:R_0603_1608Metric | 1 | Calculated design; not bench validated | Historical JLC comparison; course requires team assembly | Not selected for assembly ordering; use BOM-Hand-assembly.csv |  |  | YAGEO | Not in course v3 by exact MPN; additional sourcing | https://www.digikey.com/en/products/detail/yageo/RC0603FR-0733KL/727159 | RC0603FR-0733KL | Exact library match pending
R430 | 1 | RT0603BRD0745K3L | 45.3k 0.1% | Resistor_SMD:R_0603_1608Metric | 1 | Calculated design; not bench validated | Historical JLC comparison; course requires team assembly | Not selected for assembly ordering; use BOM-Hand-assembly.csv |  |  | YAGEO | Additional DigiKey purchase; 0.1% logic feedback divider | https://www.digikey.com/en/products/detail/yageo/RT0603BRD0745K3L/5139111 | RT0603BRD0745K3L | Historical comparison only; library match not verified
R432 | 1 | RC0603FR-0722KL | 22k | Resistor_SMD:R_0603_1608Metric | 1 | Calculated design; not bench validated Procurement alternate: Panasonic Industry ERJ-3EKF2202V (22k 1% 0.1W 0603 100ppm/C); use instead of primary, not both. Primary out of stock2026-10-24; alternate stock not reserved. | Historical JLC comparison; course requires team assembly | Not selected for assembly ordering; use BOM-Hand-assembly.csv |  |  | YAGEO | Not in course v3 by exact MPN; additional sourcing | https://www.digikey.com/en/products/detail/panasonic-industry/ERJ-3EKF2202V/1746336 | RC0603FR-0722KL | Exact library match pending
U50 U60 | 2 | STM32F401RET6TR | STM32F401RET6TR | Package_QFP:LQFP-64_10x10mm_P0.5mm | 1 | DS10086 LQFP64; pin 30 VCAP1 needs 4.7uF; no PB11; GPIO modes require PCB firmware port | Historical JLC comparison; course requires team assembly | Not selected for assembly ordering; use BOM-Hand-assembly.csv | C116978 | https://jlcpcb.com/partdetail/STMicroelectronics-STM32F401RET6/C116978 | STMicroelectronics | Course v3 exact MPN | https://www.digikey.com/short/p2012wpj | STM32F401RET6TR | Carrier-only alternative verified from ST: RET6 tray, RET6TR tape/reel; same LQFP64 device
C500 C600 | 2 | KGM15AR71C104KT | 100n VDD19 | Capacitor_SMD:C_0603_1608Metric | 1 | Locate at associated supply pin; verify effective capacitance | Historical JLC comparison; course requires team assembly | Not selected for assembly ordering; use BOM-Hand-assembly.csv |  |  | KYOCERA AVX | Course v3 exact MPN | https://www.digikey.com/short/dzn7v8v4 | KGM15AR71C104KT | Exact library match pending
C501 C601 | 2 | KGM15AR71C104KT | 100n VDD32 | Capacitor_SMD:C_0603_1608Metric | 1 | Locate at associated supply pin; verify effective capacitance | Historical JLC comparison; course requires team assembly | Not selected for assembly ordering; use BOM-Hand-assembly.csv |  |  | KYOCERA AVX | Course v3 exact MPN | https://www.digikey.com/short/dzn7v8v4 | KGM15AR71C104KT | Exact library match pending
C502 C602 | 2 | KGM15AR71C104KT | 100n VDD48 | Capacitor_SMD:C_0603_1608Metric | 1 | Locate at associated supply pin; verify effective capacitance | Historical JLC comparison; course requires team assembly | Not selected for assembly ordering; use BOM-Hand-assembly.csv |  |  | KYOCERA AVX | Course v3 exact MPN | https://www.digikey.com/short/dzn7v8v4 | KGM15AR71C104KT | Exact library match pending
C503 C603 | 2 | KGM15AR71C104KT | 100n VDD64 | Capacitor_SMD:C_0603_1608Metric | 1 | Locate at associated supply pin; verify effective capacitance | Historical JLC comparison; course requires team assembly | Not selected for assembly ordering; use BOM-Hand-assembly.csv |  |  | KYOCERA AVX | Course v3 exact MPN | https://www.digikey.com/short/dzn7v8v4 | KGM15AR71C104KT | Exact library match pending
C504 C604 | 2 | KGM15AR71C104KT | 100n VBAT | Capacitor_SMD:C_0603_1608Metric | 1 | Locate at associated supply pin; verify effective capacitance | Historical JLC comparison; course requires team assembly | Not selected for assembly ordering; use BOM-Hand-assembly.csv |  |  | KYOCERA AVX | Course v3 exact MPN | https://www.digikey.com/short/dzn7v8v4 | KGM15AR71C104KT | Exact library match pending
C505 C605 | 2 | GRM21BR71C475KE51L | 4.7u VDD bulk | Capacitor_SMD:C_0805_2012Metric | 1 | Locate at associated supply pin; verify effective capacitance | Historical JLC comparison; course requires team assembly | Not selected for assembly ordering; use BOM-Hand-assembly.csv |  |  | Murata | Course v3 exact MPN | https://www.digikey.com/short/fh8p2bz3 | GRM21BR71C475KE51L | Exact library match pending
C506 C606 | 2 | GRM21BR71C475KE51L | 4.7u VCAP1 | Capacitor_SMD:C_0805_2012Metric | 1 | Locate at associated supply pin; verify effective capacitance | Historical JLC comparison; course requires team assembly | Not selected for assembly ordering; use BOM-Hand-assembly.csv |  |  | Murata | Course v3 exact MPN | https://www.digikey.com/short/fh8p2bz3 | GRM21BR71C475KE51L | Exact library match pending
FB50 FB60 | 2 | 742863160 | 600R @100MHz | Inductor_SMD:L_0603_1608Metric | 1 | VDDA analog filter; VSSA joins quiet common ground | Historical JLC comparison; course requires team assembly | Not selected for assembly ordering; use BOM-Hand-assembly.csv |  |  | Wurth Elektronik | Course v3 exact MPN | https://www.digikey.com/short/1807nprh | 742863160 | Exact library match pending
C507 C607 | 2 | KGM15AR71C104KT | 100n VDDA | Capacitor_SMD:C_0603_1608Metric | 1 | Locate at associated supply pin; verify effective capacitance | Historical JLC comparison; course requires team assembly | Not selected for assembly ordering; use BOM-Hand-assembly.csv |  |  | KYOCERA AVX | Course v3 exact MPN | https://www.digikey.com/short/dzn7v8v4 | KGM15AR71C104KT | Exact library match pending
C508 C608 | 2 | CC0603JRX7R7BB105 | 1u VDDA | Capacitor_SMD:C_0603_1608Metric | 1 | Locate at associated supply pin; verify effective capacitance | Historical JLC comparison; course requires team assembly | Not selected for assembly ordering; use BOM-Hand-assembly.csv |  |  | YAGEO | Not in course v3 by exact MPN; additional sourcing | https://www.digikey.com/en/products/detail/yageo/CC0603JRX7R7BB105/7164369 | CC0603JRX7R7BB105 | Exact library match pending
R500 R600 | 2 | CRCW060310K0FKEA | 10k BOOT0 | Resistor_SMD:R_0603_1608Metric | 1 | Schematic connected; placement and hardware validation pending | Historical JLC comparison; course requires team assembly | Not selected for assembly ordering; use BOM-Hand-assembly.csv |  |  | Vishay | Course v3 exact MPN | https://www.digikey.com/short/br7d02pp | CRCW060310K0FKEA | Exact library match pending
J500 J600 | 2 | 2.54 mm breakaway header | BOOT recovery | Connector_PinHeader_2.54mm:PinHeader_1x02_P2.54mm_Vertical | 1 | Course stock; label pin 1 and every signal; preserve physical access | Historical JLC comparison; course requires team assembly | Not selected for assembly ordering; use BOM-Hand-assembly.csv |  |  | Unspecified | Course v3 generic header; verify row/pin dimensions |  | 2.54 mm breakaway header | Exact library match pending
R501 R601 | 2 | CRCW060310K0FKEA | 10k NRST | Resistor_SMD:R_0603_1608Metric | 1 | Schematic connected; placement and hardware validation pending | Historical JLC comparison; course requires team assembly | Not selected for assembly ordering; use BOM-Hand-assembly.csv |  |  | Vishay | Course v3 exact MPN | https://www.digikey.com/short/br7d02pp | CRCW060310K0FKEA | Exact library match pending
C509 C609 | 2 | KGM15AR71C104KT | 100n NRST | Capacitor_SMD:C_0603_1608Metric | 1 | Locate at associated supply pin; verify effective capacitance | Historical JLC comparison; course requires team assembly | Not selected for assembly ordering; use BOM-Hand-assembly.csv |  |  | KYOCERA AVX | Course v3 exact MPN | https://www.digikey.com/short/dzn7v8v4 | KGM15AR71C104KT | Exact library match pending
SW50 SW51 SW60 SW61 SW70 | 5 | SWT0210-045026GSA | SWT0210-045026GSA | Lab4_Switches:GCT_SWT0210_4.5x4.5mm | 1 | GCT A1 drawing verified: physical terminals 1/2 -> logical pad 1; 3/4 -> pad 2. See Switch-footprint-review.md. | Historical JLC comparison; course requires team assembly | Not selected for assembly ordering; use BOM-Hand-assembly.csv |  |  | GCT | Course v3 exact MPN | https://www.digikey.com/short/fb4tj3c7 | SWT0210-045026GSA | Exact library match pending
J501 J601 | 2 | 2.54 mm breakaway header | SWD (2.54mm) | Connector_PinHeader_2.54mm:PinHeader_1x06_P2.54mm_Vertical | 1 | Course stock; label pin 1 and every signal; preserve physical access | Historical JLC comparison; course requires team assembly | Not selected for assembly ordering; use BOM-Hand-assembly.csv |  |  | Unspecified | Course v3 generic header; verify row/pin dimensions |  | 2.54 mm breakaway header | Exact library match pending
J502 J602 | 2 | 2.54 mm breakaway header | 3.3V TTL UART | Connector_PinHeader_2.54mm:PinHeader_1x03_P2.54mm_Vertical | 1 | Course stock; label pin 1 and every signal; preserve physical access | Historical JLC comparison; course requires team assembly | Not selected for assembly ordering; use BOM-Hand-assembly.csv |  |  | Unspecified | Course v3 generic header; verify row/pin dimensions |  | 2.54 mm breakaway header | Exact library match pending
R502 R602 R700 | 3 | CRCW060310K0FKEA | 10k TEST pullup | Resistor_SMD:R_0603_1608Metric | 1 | Schematic connected; placement and hardware validation pending | Historical JLC comparison; course requires team assembly | Not selected for assembly ordering; use BOM-Hand-assembly.csv |  |  | Vishay | Course v3 exact MPN | https://www.digikey.com/short/br7d02pp | CRCW060310K0FKEA | Exact library match pending
C510 C610 C702 | 3 | KGM15AR71C104KT | 100n TEST | Capacitor_SMD:C_0603_1608Metric | 1 | Locate at associated supply pin; verify effective capacitance | Historical JLC comparison; course requires team assembly | Not selected for assembly ordering; use BOM-Hand-assembly.csv |  |  | KYOCERA AVX | Course v3 exact MPN | https://www.digikey.com/short/dzn7v8v4 | KGM15AR71C104KT | Exact library match pending
D510 D610 D710 | 3 | LTST-C190GKT | STATUS green | LED_SMD:LED_0603_1608Metric | 1 | Active high; 1k limits current below 3.4 mA even at zero LED drop; verify visibility | Historical JLC comparison; course requires team assembly | Not selected for assembly ordering; use BOM-Hand-assembly.csv |  |  | Lite-On | Course v3 exact MPN | https://www.digikey.com/short/j2q28bwj | LTST-C190GKT | Exact library match pending
D511 D611 D711 | 3 | LTST-C190KRKT | ERR red | LED_SMD:LED_0603_1608Metric | 1 | Active high; 1k limits current below 3.4 mA even at zero LED drop; verify visibility | Historical JLC comparison; course requires team assembly | Not selected for assembly ordering; use BOM-Hand-assembly.csv |  |  | Lite-On | Course v3 exact MPN | https://www.digikey.com/short/r70ftq33 | LTST-C190KRKT | Exact library match pending
D512 D612 D712 | 3 | LTST-C190KSKT | DEG_A yellow | LED_SMD:LED_0603_1608Metric | 1 | Active high; 1k limits current below 3.4 mA even at zero LED drop; verify visibility | Historical JLC comparison; course requires team assembly | Not selected for assembly ordering; use BOM-Hand-assembly.csv |  |  | Lite-On | Course v3 exact MPN | https://www.digikey.com/short/p3j5fdrv | LTST-C190KSKT | Exact library match pending
D513 D613 D713 | 3 | LTST-C190KSKT | DEG_B yellow | LED_SMD:LED_0603_1608Metric | 1 | Active high; 1k limits current below 3.4 mA even at zero LED drop; verify visibility | Historical JLC comparison; course requires team assembly | Not selected for assembly ordering; use BOM-Hand-assembly.csv |  |  | Lite-On | Course v3 exact MPN | https://www.digikey.com/short/p3j5fdrv | LTST-C190KSKT | Exact library match pending
J503 J603 J703 | 3 | 2.54 mm breakaway header | LAB3 rows 1-13 | Connector_PinHeader_2.54mm:PinHeader_1x13_P2.54mm_Vertical | 1 | Course stock; label pin 1 and every signal; preserve physical access | Historical JLC comparison; course requires team assembly | Not selected for assembly ordering; use BOM-Hand-assembly.csv |  |  | Unspecified | Course v3 generic header; verify row/pin dimensions |  | 2.54 mm breakaway header | Exact library match pending
J504 | 1 | 2.54 mm breakaway header | Additional probes | Connector_PinHeader_2.54mm:PinHeader_1x08_P2.54mm_Vertical | 1 | Course stock; label pin 1 and every signal; preserve physical access | Historical JLC comparison; course requires team assembly | Not selected for assembly ordering; use BOM-Hand-assembly.csv |  |  | Unspecified | Course v3 generic header; verify row/pin dimensions |  | 2.54 mm breakaway header | Exact library match pending
R530 | 1 | CRCW060310K0FKEA | 10k PWM pulldown | Resistor_SMD:R_0603_1608Metric | 1 | Schematic connected; placement and hardware validation pending | Historical JLC comparison; course requires team assembly | Not selected for assembly ordering; use BOM-Hand-assembly.csv |  |  | Vishay | Course v3 exact MPN | https://www.digikey.com/short/br7d02pp | CRCW060310K0FKEA | Exact library match pending
J604 | 1 | 2.54 mm breakaway header | Additional probes | Connector_PinHeader_2.54mm:PinHeader_1x11_P2.54mm_Vertical | 1 | Course stock; label pin 1 and every signal; preserve physical access | Historical JLC comparison; course requires team assembly | Not selected for assembly ordering; use BOM-Hand-assembly.csv |  |  | Unspecified | Course v3 generic header; verify row/pin dimensions |  | 2.54 mm breakaway header | Exact library match pending
R630 R631 R632 R633 R634 R635 | 6 | CRCW060310K0FKEA | 10k boot pulldown | Resistor_SMD:R_0603_1608Metric | 1 | Schematic connected; placement and hardware validation pending | Historical JLC comparison; course requires team assembly | Not selected for assembly ordering; use BOM-Hand-assembly.csv |  |  | Vishay | Course v3 exact MPN | https://www.digikey.com/short/br7d02pp | CRCW060310K0FKEA | Exact library match pending
J70 | 1 | ESQ-118-44-L-D | Pi GPIO pins3-38 / ESQ-118-44-L-D | Lab4_Mechanical:Samtec_ESQ-118-44_2x18_PiPins3-38_H18.67 | 1 | Bottom 36-contact socket mates Pi physical pins3-38; omit1/2/39/40 to clear all Pi holes by3mm from edge. Pin4 alone supplies5V; all used signals unchanged. Align to Pi3/4, not1/2. 22mm nominal gap. Samtec ESQ/TSW catalog5.7A/contact is supporting evidence, not a tested Pi assembly. Hand solder per Samtec process limits. | Historical JLC comparison; course requires team assembly | Not selected for assembly ordering; use BOM-Hand-assembly.csv |  |  | Samtec | Not in course v3 by exact MPN; additional sourcing | https://www.mouser.co.uk/en/ProductDetail/Samtec/ESQ-118-44-L-D?qs=PB6%2FjmICvI2MYbzEyjh0rw%3D%3D | ESQ-118-44-L-D | Exact library match pending
C700 | 1 | GRM219R61C226ME15L | 22u /16V | Capacitor_SMD:C_0805_2012Metric | 1 | Locate at associated supply pin; verify effective capacitance | Historical JLC comparison; course requires team assembly | Not selected for assembly ordering; use BOM-Hand-assembly.csv |  |  | Murata | Course v3 exact MPN | https://www.digikey.com/short/tmfw2f4h | GRM219R61C226ME15L | Exact library match pending
J704 | 1 | 2.54 mm breakaway header | Pi extra probes | Connector_PinHeader_2.54mm:PinHeader_1x05_P2.54mm_Vertical | 1 | Course stock; label pin 1 and every signal; preserve physical access | Historical JLC comparison; course requires team assembly | Not selected for assembly ordering; use BOM-Hand-assembly.csv |  |  | Unspecified | Course v3 generic header; verify row/pin dimensions |  | 2.54 mm breakaway header | Exact library match pending
J505 | 1 | 2.54 mm breakaway header | Reserved / encoder probes | Connector_PinHeader_2.54mm:PinHeader_1x04_P2.54mm_Vertical | 1 | Test access; not a substitute for final rated actuator connectors | Historical JLC comparison; course requires team assembly | Not selected for assembly ordering; use BOM-Hand-assembly.csv |  |  | Unspecified | Course v3 generic header; verify row/pin dimensions |  | 2.54 mm breakaway header | Exact library match pending
J605 | 1 | 2.54 mm breakaway header | Reserved / encoder probes | Connector_PinHeader_2.54mm:PinHeader_1x07_P2.54mm_Vertical | 1 | Test access; not a substitute for final rated actuator connectors | Historical JLC comparison; course requires team assembly | Not selected for assembly ordering; use BOM-Hand-assembly.csv |  |  | Unspecified | Course v3 generic header; verify row/pin dimensions |  | 2.54 mm breakaway header | Exact library match pending
U80 | 1 | L298N | L298N | Lab4_Power:ST_L298N_Multiwatt15V_D1.1 | 1 | ST L298 rev5: 2A DC per bridge and 2A braking; no hardware current limiter in this revision | Historical JLC comparison; course requires team assembly | Not selected for assembly ordering; use BOM-Hand-assembly.csv | C19922 | https://jlcpcb.com/partdetail/STMicroelectronics-L298N/C19922 | STMicroelectronics | Course v3 exact MPN | https://www.digikey.com/short/38hmjrmb | L298N | Exact manufacturer/MPN/package catalog identity; stock and assembly acceptance pending
C800 | 1 | GRM188R71H104KA93D | 100n 50V | Capacitor_SMD:C_0603_1608Metric | 1 | Local decoupling; effective capacitance and layout to verify | Historical JLC comparison; course requires team assembly | Not selected for assembly ordering; use BOM-Hand-assembly.csv |  |  | Murata | Not in course v3 by exact MPN; additional sourcing | https://www.digikey.com/en/products/detail/murata-electronics/GRM188R71H104KA93D/587143 | GRM188R71H104KA93D | Exact library match pending
C802 | 1 | EEU-FR1E471 | 470u 25V | Capacitor_THT:CP_Radial_D10.0mm_P5.00mm | 1 | Local decoupling; effective capacitance and layout to verify | Historical JLC comparison; course requires team assembly | Not selected for assembly ordering; use BOM-Hand-assembly.csv |  |  | Panasonic | Not in course v3 by exact MPN; additional sourcing | https://www.digikey.com/en/products/detail/panasonic-electronic-components/EEU-FR1E471/2433553 | EEU-FR1E471 | Exact library match pending
D800 D801 D802 D803 D804 D805 D806 D807 | 8 | SK520B | SK520B | Diode_SMD:D_SMB | 1 | SMC Diode Solutions 5A/200V SMB; exact MPN appears in course v3 list; motor clamp polarity checked | Historical JLC comparison; course requires team assembly | Not selected for assembly ordering; use BOM-Hand-assembly.csv |  |  | SMC Diode Solutions | Course v3 exact MPN | https://www.digikey.com/short/3fz7wn2w | SK520B | Exact library match pending
J80 | 1 | DF63M-2P-3.96DSA | LEFT motor | Connector_Hirose:Hirose_DF63M-2P-3.96DSA_1x02_P3.96mm_Vertical | 1 | Board-defined pin order; build/verify adapter to existing cable before power | Historical JLC comparison; course requires team assembly | Not selected for assembly ordering; use BOM-Hand-assembly.csv |  |  | Hirose | Not in course v3 by exact MPN; additional sourcing | https://www.digikey.com/en/products/detail/hirose-electric-co-ltd/DF63M-2P-3-96DSA/9695031 | DF63M-2P-3.96DSA | Exact library match pending
J81 | 1 | DF63M-2P-3.96DSA | RIGHT motor | Connector_Hirose:Hirose_DF63M-2P-3.96DSA_1x02_P3.96mm_Vertical | 1 | Board-defined pin order; build/verify adapter to existing cable before power | Historical JLC comparison; course requires team assembly | Not selected for assembly ordering; use BOM-Hand-assembly.csv |  |  | Hirose | Not in course v3 by exact MPN; additional sourcing | https://www.digikey.com/en/products/detail/hirose-electric-co-ltd/DF63M-2P-3-96DSA/9695031 | DF63M-2P-3.96DSA | Exact library match pending
J82 | 1 | 2.54 mm breakaway header | LEFT encoder | Connector_PinHeader_2.54mm:PinHeader_1x04_P2.54mm_Vertical | 1 | Board-defined pin order; build/verify adapter to existing cable before power | Historical JLC comparison; course requires team assembly | Not selected for assembly ordering; use BOM-Hand-assembly.csv |  |  | Unspecified | Course v3 generic header; verify row/pin dimensions |  | 2.54 mm breakaway header | Exact library match pending
R800 R801 R802 R803 R540 | 5 | CRCW0603100RFKEA | 100R | Resistor_SMD:R_0603_1608Metric | 1 | Calculated circuit; not hardware validated | Historical JLC comparison; course requires team assembly | Not selected for assembly ordering; use BOM-Hand-assembly.csv |  |  | Vishay Dale | Not in course v3 by exact MPN; additional sourcing | https://www.digikey.com/en/products/detail/vishay-dale/CRCW0603100RFKEA/1174554 | CRCW0603100RFKEA | Exact library match pending
J83 | 1 | 2.54 mm breakaway header | RIGHT encoder | Connector_PinHeader_2.54mm:PinHeader_1x04_P2.54mm_Vertical | 1 | Board-defined pin order; build/verify adapter to existing cable before power | Historical JLC comparison; course requires team assembly | Not selected for assembly ordering; use BOM-Hand-assembly.csv |  |  | Unspecified | Course v3 generic header; verify row/pin dimensions |  | 2.54 mm breakaway header | Exact library match pending
U81 | 1 | SN74LVC14APWR | SN74LVC14APWR | Package_SO:TSSOP-14_4.4x5mm_P0.65mm | 1 | Inputs <=5.5V; both A/B inverted so quadrature phase order preserved; verify counter direction in firmware Source resolved: DigiKey showed 291 SN74LVC14APW available at $1.05 each on 24Oct2026. Original PWR listing is out of stock. Stock/price not reserved; confirm at purchase. | Historical JLC comparison; course requires team assembly | Not selected for assembly ordering; use BOM-Hand-assembly.csv | C7663 | https://jlcpcb.com/partdetail/TexasInstruments-SN74LVC14APWR/C7663 | Texas Instruments | Additional purchase / exact candidate | https://www.digikey.com/en/products/detail/texas-instruments/SN74LVC14APW/1591867 | SN74LVC14APWR | Exact MPN/package catalog identity verified; live stock/quote pending
J90 | 1 | DF63M-3P-3.96DSA | Servo: GND / 6.6V / PWM | Connector_Hirose:Hirose_DF63M-3P-3.96DSA_1x03_P3.96mm_Vertical | 1 | Board-defined pin order; build/verify adapter to existing cable before power | Historical JLC comparison; course requires team assembly | Not selected for assembly ordering; use BOM-Hand-assembly.csv |  |  | Hirose | Not in course v3 by exact MPN; additional sourcing | https://www.digikey.com/en/products/detail/hirose-electric-co-ltd/DF63M-3P-3-96DSA/9695039 | DF63M-3P-3.96DSA | Exact library match pending
R550 R551 R650 R651 | 4 | CRCW06032K20FKEA | 2.2k | Resistor_SMD:R_0603_1608Metric | 1 | Calculated circuit; not hardware validated | Historical JLC comparison; course requires team assembly | Not selected for assembly ordering; use BOM-Hand-assembly.csv |  |  | Vishay Dale | Not in course v3 by exact MPN; additional sourcing | https://www.digikey.com/en/products/detail/vishay-dale/CRCW06032K20FKEA/1174704 | CRCW06032K20FKEA | Exact library match pending
R560 R561 R660 R661 | 4 | CRCW0603100KFKEA | 100k | Resistor_SMD:R_0603_1608Metric | 1 | Calculated circuit; not hardware validated | Historical JLC comparison; course requires team assembly | Not selected for assembly ordering; use BOM-Hand-assembly.csv |  |  | Vishay Dale | Not in course v3 by exact MPN; additional sourcing | https://www.digikey.com/en/products/detail/vishay-dale/CRCW0603100KFKEA/1180038 | CRCW0603100KFKEA | Exact library match pending
Q550 Q551 Q650 Q651 | 4 | MMBT3904-7-F | MMBT3904 | Package_TO_SOT_SMD:SOT-23 | 1 | Low-side lamp switch; 220R limits 5.1V LED current; not for incandescent lamps | Historical JLC comparison; course requires team assembly | Not selected for assembly ordering; use BOM-Hand-assembly.csv | C94514 | https://jlcpcb.com/partdetail/DiodesIncorporated-MMBT3904_7F/C94514 | Diodes Incorporated | Not in course v3 by exact MPN; additional sourcing | https://www.digikey.com/en/products/detail/diodes-incorporated/MMBT3904-7-F/814494 | MMBT3904-7-F | Exact MPN/package catalog identity verified; live stock/quote pending
R570 R571 R670 R671 | 4 | CRCW0603220RFKEA | 220R | Resistor_SMD:R_0603_1608Metric | 1 | Calculated circuit; not hardware validated | Historical JLC comparison; course requires team assembly | Not selected for assembly ordering; use BOM-Hand-assembly.csv |  |  | Vishay Dale | Not in course v3 by exact MPN; additional sourcing | https://www.digikey.com/en/products/detail/vishay-dale/CRCW0603220RFKEA/1174590 | CRCW0603220RFKEA | Exact library match pending
J550 | 1 | 2.54 mm breakaway header | FRONT LEFT lamp | Connector_PinHeader_2.54mm:PinHeader_1x02_P2.54mm_Vertical | 1 | Board-defined pin order; build/verify adapter to existing cable before power | Historical JLC comparison; course requires team assembly | Not selected for assembly ordering; use BOM-Hand-assembly.csv |  |  | Unspecified | Course v3 generic header; verify row/pin dimensions |  | 2.54 mm breakaway header | Exact library match pending
J551 | 1 | 2.54 mm breakaway header | FRONT RIGHT lamp | Connector_PinHeader_2.54mm:PinHeader_1x02_P2.54mm_Vertical | 1 | Board-defined pin order; build/verify adapter to existing cable before power | Historical JLC comparison; course requires team assembly | Not selected for assembly ordering; use BOM-Hand-assembly.csv |  |  | Unspecified | Course v3 generic header; verify row/pin dimensions |  | 2.54 mm breakaway header | Exact library match pending
J650 | 1 | 2.54 mm breakaway header | REAR LEFT lamp | Connector_PinHeader_2.54mm:PinHeader_1x02_P2.54mm_Vertical | 1 | Board-defined pin order; build/verify adapter to existing cable before power | Historical JLC comparison; course requires team assembly | Not selected for assembly ordering; use BOM-Hand-assembly.csv |  |  | Unspecified | Course v3 generic header; verify row/pin dimensions |  | 2.54 mm breakaway header | Exact library match pending
J651 | 1 | 2.54 mm breakaway header | REAR RIGHT lamp | Connector_PinHeader_2.54mm:PinHeader_1x02_P2.54mm_Vertical | 1 | Board-defined pin order; build/verify adapter to existing cable before power | Historical JLC comparison; course requires team assembly | Not selected for assembly ordering; use BOM-Hand-assembly.csv |  |  | Unspecified | Course v3 generic header; verify row/pin dimensions |  | 2.54 mm breakaway header | Exact library match pending
U82 | 1 | MCP1700-4002E/TO | MCP1700-4002E/TO | Package_TO_SOT_THT:TO-92_Inline_Wide | 1 | 4V encoder supply; 250mA rating; 40mA planning load; pin1 GND,2 input,3 output | Historical JLC comparison; course requires team assembly | Not selected for assembly ordering; use BOM-Hand-assembly.csv |  | https://www.digikey.com/en/products/detail/microchip-technology/MCP1700-4002E-TO/2614904 | Microchip Technology | Not in course v3 by exact MPN; request from DigiKey | https://www.digikey.com/en/products/detail/microchip-technology/MCP1700-4002E-TO/2614904 | MCP1700-4002E/TO | Not selected for JLC; added for schematic consistency
C804 C805 | 2 | TPSB106K016R0800 | 10u 16V 10% low-ESR | Capacitor_Tantalum_SMD:CP_EIA-3528-21_Kemet-B | 1 | Polarized 10uF/16V tantalum; 0.8ohm maximum ESR at100kHz/25C; pad1 positive; input/output bypass for U82 | Historical JLC comparison; course requires team assembly | Not selected for assembly ordering; use BOM-Hand-assembly.csv |  | https://www.digikey.com/en/products/detail/kyocera-avx/TPSB106K016R0800/678477 | KYOCERA AVX | Not in course v3 by exact MPN; request from DigiKey | https://www.digikey.com/en/products/detail/kyocera-avx/TPSB106K016R0800/678477 | TPSB106K016R0800 | Not selected for JLC; added for schematic consistency
R580 | 1 | RT0603BRD07100KL | 100k 0.1% | Resistor_SMD:R_0603_1608Metric | 1 | Battery divider high side. 15V design ceiling; 0.1% ratio resistors. | Historical JLC comparison; course requires team assembly | Not selected for assembly ordering; use BOM-Hand-assembly.csv |  |  | YAGEO | Not in course v3; source through DigiKey | https://www.digikey.com/en/products/detail/yageo/RT0603BRD07100KL/1072187 | RT0603BRD07100KL
C414 | 1 | GRM1885C1H680JA01D | 68p C0G | Capacitor_SMD:C_0603_1608Metric | 1 | Revised with capacitor banks: servo/Pi zero near 23kHz; logic follows TI 3.3V example. Within 10-100pF guidance. Transient/phase margin unmeasured. | Historical JLC comparison; course requires team assembly | Not selected for assembly ordering; use BOM-Hand-assembly.csv |  |  | Murata | Not on course v3 list by exact MPN | https://www.digikey.com/en/products/detail/murata-electronics/GRM1885C1H680JA01D/586916 | GRM1885C1H680JA01D | Exact library match pending; no assembly order
C424 | 1 | GRM1885C1H910JA01D | 91p C0G | Capacitor_SMD:C_0603_1608Metric | 1 | Revised with capacitor banks: servo/Pi zero near 23kHz; logic follows TI 3.3V example. Within 10-100pF guidance. Transient/phase margin unmeasured. | Historical JLC comparison; course requires team assembly | Not selected for assembly ordering; use BOM-Hand-assembly.csv |  |  | Murata | Not on course v3 list by exact MPN | https://www.digikey.com/en/products/detail/murata-electronics/GRM1885C1H910JA01D/586935 | GRM1885C1H910JA01D | Exact library match pending; no assembly order
C434 | 1 | GRM1885C1H300JA01D | 30p C0G | Capacitor_SMD:C_0603_1608Metric | 1 | Revised with capacitor banks: servo/Pi zero near 23kHz; logic follows TI 3.3V example. Within 10-100pF guidance. Transient/phase margin unmeasured. | Historical JLC comparison; course requires team assembly | Not selected for assembly ordering; use BOM-Hand-assembly.csv |  |  | Murata | Not on course v3 list by exact MPN | https://www.digikey.com/en/products/detail/murata-electronics/GRM1885C1H300JA01D/587619 | GRM1885C1H300JA01D | Exact library match pending; no assembly order
