fmarples/18649_team4/lab4/TEAM_4_BOM_Lab4.xlsx

Sheet: Specialty parts
Team 4 Lab 4 BOM — specialty parts
Specialty = absent from the course v3 list. Yellow rows identify specialty parts.
Totals include proposed spares. Buy only the shortfall after checking course/team stock. OPEN items require TA review.
Source purchasing BOM (https://github.com/fmarples/18649_team4/blob/lab4/lab4/Preliminary-BOM.csv) | Course common-list confirmation (https://18449-f26.slack.com/archives/C0BRYGTD4HH/p1792789284321879) |  |  |  |  |  | TA announcement (https://18449-f26.slack.com/archives/C0BRYGTD4HH/p1793052274317539)
Reconciled October 28, 2026. 57 consolidated lines. Zero-quantity historical alternatives omitted.
Part / MPN / specification | Description | In design | Off-board | Spares | Total requested | Unit | Supplier / source | TA review / purchasing note | References | Footprint / package | Manufacturer
GRM1885C1H180JA01D | 18p C0G 50V | 12 | 0 | 1 | 13 | each | DigiKey (https://www.digikey.com/en/products/detail/murata-electronics/GRM1885C1H180JA01D/586919) | CL=12pF; equal 18pF caps assume 3pF effective stray; tune after layout/clock measurement | C100 C101 C140 C141 C200 C201 C240 C241 C300 C301 C340 C341 | Capacitor_SMD:C_0603_1608Metric | Murata
WSL2512R0100FEA | 10mR / 1W / 1% | 1 | 0 | 4 | 5 | each | DigiKey (https://www.digikey.com/en/products/detail/vishay-dale/WSL2512R0100FEA/712561) | Vishay 30100 p2 land pattern; 10mOhm 1W 1%; 0.16W at 4A; Kelvin routing still required | R1 | Lab4_Power:Vishay_WSL2512_7m_to_500m | Vishay Dale
INA180A2IDBVR | INA180A2IDBVR | 1 | 0 | 1 | 2 | each | DigiKey (https://www.digikey.com/en/products/detail/texas-instruments/INA180A2IDBVR/8132987) | Preliminary; verify before fabrication | U1 | Package_TO_SOT_SMD:SOT-23-5 | Texas Instruments
DF63M-2P-3.96DSA | Battery input: 1=+ 2=GND; LEFT motor; RIGHT motor | 3 | 0 | 3 | 6 | each | DigiKey (https://www.digikey.com/en/products/detail/hirose-electric-co-ltd/DF63M-2P-3-96DSA/9695031) | Teammate connector proposal; 14A header rating; verify wire/contact derating and fuse | J40 J80 J81 | Connector_Hirose:Hirose_DF63M-2P-3.96DSA_1x02_P3.96mm_Vertical | Hirose
3568 | Fuse: rating TBD | 1 | 0 | 1 | 2 | each | DigiKey (https://www.digikey.com/en/products/detail/keystone-electronics/3568/2137306) | Fuse must coordinate with holder/wire rating and measured inrush; not selected from peak estimate alone | F1 | Fuse:Fuseholder_Blade_Mini_Keystone_3568 | Keystone Electronics
DMPH3010LK3-13 | DMPH3010LK3-13 | 1 | 0 | 1 | 2 | each | DigiKey (https://www.digikey.com/en/products/detail/diodes-incorporated/DMPH3010LK3-13/7352990) | Reverse-polarity: drain toward battery, source toward load. Manufacturer G1 D2 S3. Not a reverse-current blocker. | Q1 | Package_TO_SOT_SMD:TO-252-2 | Diodes Incorporated
BZT52C12 | 12V gate clamp | 1 | 0 | 1 | 2 | each | DigiKey (https://www.digikey.com/en/products/detail/diotec-semiconductor/BZT52C12/22189788) | Cathode at source, anode at gate; clamp protects VGS, not the battery rail | D40 | Diode_SMD:D_SOD-123F | Diotec
UPW1E102MHD | 1000u / 25V | 1 | 0 | 1 | 2 | each | DigiKey (https://www.digikey.com/en/products/detail/nichicon/UPW1E102MHD/589572) | Nichicon: diameter 12.5 mm, height 20 mm, pitch 5 mm; 1.66 A high-frequency ripple rating. Application ripple/thermal check pending. | C400 | Capacitor_THT:CP_Radial_D12.5mm_P5.00mm | Nichicon
GRM32ER61E226KE15L | 22u 25V X5R 10%, input/output banks | 19 | 0 | 4 | 23 | each | DigiKey (https://www.digikey.com/en/products/detail/murata-electronics/GRM32ER61E226KE15L/965931) | 19 fitted + 4 spares. New 1210 banks replace six 0805 buck-output capacitors and add ten parts. Rated/typical-data sensitivity documented; transient/temperature checks follow assembly. | C410 C412 C413 C415 C416 C417 C418 C420 C422 C423 C425 C426 C427 C430 C432 C433 C435 C436 C437 | Capacitor_SMD:C_1210_3225Metric | Murata
GRM188R71H104KA93D | 100n / 50V; 100n 50V | 4 | 0 | 2 | 6 | each | DigiKey (https://www.digikey.com/en/products/detail/murata-electronics/GRM188R71H104KA93D/587143) | Higher voltage input bypass than 16 V shelf capacitor | C411 C421 C431 C800 | Capacitor_SMD:C_0603_1608Metric | Murata
RC0603FR-07100KL | 100k 1% | 1 | 0 | 1 | 2 | each | DigiKey (https://www.digikey.com/en/products/detail/yageo/RC0603FR-07100KL/726889) | Calculated design; not bench validated | R410 | Resistor_SMD:R_0603_1608Metric | YAGEO
RT0603BRD0710KL | 10k 0.1% | 3 | 0 | 2 | 5 | each | DigiKey (https://www.digikey.com/en/products/detail/yageo/RT0603BRD0710KL/4340589) | 0.1% tolerance required. Three fitted (R421/R431 feedback and R581 battery divider) plus two spares = five requested. Do not substitute 1% parts. | R431 R421 R581 | Resistor_SMD:R_0603_1608Metric | YAGEO
RT0603BRD0775KL | 75k 0.1% | 1 | 0 | 1 | 2 | each | DigiKey | Original listing out of stock. Approved equivalent: Susumu RG1608P-753-B-T5, 75k 0.1% 0603. Buy one variant only. See active CSV. | R420 | Resistor_SMD:R_0603_1608Metric | YAGEO
RC0603FR-0733KL | 33k | 1 | 0 | 1 | 2 | each | DigiKey (https://www.digikey.com/en/products/detail/yageo/RC0603FR-0733KL/727159) | Calculated design; not bench validated | R422 | Resistor_SMD:R_0603_1608Metric | YAGEO
RT0603BRD0745K3L | 45.3k 0.1% | 1 | 0 | 1 | 2 | each | DigiKey (https://www.digikey.com/en/products/detail/yageo/RT0603BRD0745K3L/5139111) | 0.1% tolerance required for revised logic-rail margin; do not substitute a 1% course resistor. One fitted plus one spare. | R430 | Resistor_SMD:R_0603_1608Metric | YAGEO
RC0603FR-0722KL | 22k | 1 | 0 | 1 | 2 | each | DigiKey | Original listing out of stock. Equivalent Panasonic ERJ-3EKF2202V, 22k 1% 0603. Buy one variant only. See active CSV. | R432 | Resistor_SMD:R_0603_1608Metric | YAGEO
CC0603JRX7R7BB105 | 1u VDDA | 2 | 0 | 1 | 3 | each | DigiKey (https://www.digikey.com/en/products/detail/yageo/CC0603JRX7R7BB105/7164369) | Locate at associated supply pin; verify effective capacitance | C508 C608 | Capacitor_SMD:C_0603_1608Metric | YAGEO
ESQ-118-44-L-D | Pi GPIO pins3-38 / ESQ-118-44-L-D | 1 | 0 | 1 | 2 | each | Review source (https://www.mouser.co.uk/en/ProductDetail/Samtec/ESQ-118-44-L-D?qs=PB6%2FjmICvI2MYbzEyjh0rw%3D%3D) | NEW Oct27 socket substitution to meet3mm hole-edge clearance. Replace old ESQ-120 request; total2 including spare. Listed stock1 only; confirm US delivery/spare availability. Pin4 supplies5V; align socket toPi3/4. | J70 | Lab4_Mechanical:Samtec_ESQ-118-44_2x18_PiPins3-38_H18.67 | Samtec
EEU-FR1E471 | 470u 25V | 1 | 0 | 1 | 2 | each | DigiKey (https://www.digikey.com/en/products/detail/panasonic-electronic-components/EEU-FR1E471/2433553) | Panasonic drawing: 10 mm diameter, 12.5 mm body length, 5 mm lead pitch; PCB footprint corrected. 25 V rating; application ripple/temperature still to qualify. | C802 | Capacitor_THT:CP_Radial_D10.0mm_P5.00mm | Panasonic
CRCW0603100RFKEA | 100R | 5 | 0 | 1 | 6 | each | DigiKey (https://www.digikey.com/en/products/detail/vishay-dale/CRCW0603100RFKEA/1174554) | Calculated circuit; not hardware validated | R800 R801 R802 R803 R540 | Resistor_SMD:R_0603_1608Metric | Vishay Dale
SN74LVC14APW | SN74LVC14APWR | 1 | 0 | 1 | 2 | each | DigiKey (https://www.digikey.com/en/products/detail/texas-instruments/SN74LVC14APW/1591867) | RESOLVED SOURCE - use reviewed SN74LVC14APW tube-pack alternative for U81, quantity 2 total. TI identifies PW/PWR as the same device in different carriers. Recheck supplier stock at purchase and record the fitted ordering code. No circuit or footprint change. | U81 | Package_SO:TSSOP-14_4.4x5mm_P0.65mm | Texas Instruments
DF63M-3P-3.96DSA | Servo: GND / 6.6V / PWM | 1 | 0 | 1 | 2 | each | DigiKey (https://www.digikey.com/en/products/detail/hirose-electric-co-ltd/DF63M-3P-3-96DSA/9695039) | Board-defined pin order; build/verify adapter to existing cable before power | J90 | Connector_Hirose:Hirose_DF63M-3P-3.96DSA_1x03_P3.96mm_Vertical | Hirose
CRCW06032K20FKEA | 2.2k | 4 | 0 | 1 | 5 | each | DigiKey (https://www.digikey.com/en/products/detail/vishay-dale/CRCW06032K20FKEA/1174704) | Calculated circuit; not hardware validated | R550 R551 R650 R651 | Resistor_SMD:R_0603_1608Metric | Vishay Dale
CRCW0603100KFKEA | 100k | 4 | 0 | 1 | 5 | each | DigiKey (https://www.digikey.com/en/products/detail/vishay-dale/CRCW0603100KFKEA/1180038) | Calculated circuit; not hardware validated | R560 R561 R660 R661 | Resistor_SMD:R_0603_1608Metric | Vishay Dale
MMBT3904-7-F | MMBT3904 | 4 | 0 | 1 | 5 | each | DigiKey (https://www.digikey.com/en/products/detail/diodes-incorporated/MMBT3904-7-F/814494) | Low-side lamp switch; 220R limits 5.1V LED current; not for incandescent lamps | Q550 Q551 Q650 Q651 | Package_TO_SOT_SMD:SOT-23 | Diodes Incorporated
CRCW0603220RFKEA | 220R | 4 | 0 | 1 | 5 | each | DigiKey (https://www.digikey.com/en/products/detail/vishay-dale/CRCW0603220RFKEA/1174590) | Calculated circuit; not hardware validated | R570 R571 R670 R671 | Resistor_SMD:R_0603_1608Metric | Vishay Dale
SNT-100-BK-T-H | Handled 2.54mm jumper caps | 0 | 18 | 2 | 20 | each | DigiKey (https://www.digikey.com/en/products/detail/samtec-inc/SNT-100-BK-T-H/2345103) | 12 isolation + 4 termination + 2 optional BOOT0 recovery caps; 2 spares. BOOT0 caps stored off-board during normal operation. Handle improves access. Reuse matching stock if available. | Off-board | Off-board / mechanical | Samtec
0297010.L | 10A MINI blade fuse: review candidate, not qualified | 0 | 2 | 2 | 4 | each | DigiKey (https://www.digikey.com/en/products/detail/littelfuse-inc/0297010-L/3305626) | OPEN: 10 A fuse candidate. Two fitted (PCB and pack-side holder) plus two spares. Coordinate with startup current, holder, wires and connectors; not per-motor protection. | Off-board | Off-board / mechanical | Littelfuse
970350365 | M3 female/female nylon chassis spacer; 35mm body, 6mm AF | 0 | 4 | 1 | 5 | each | DigiKey (https://www.digikey.com/en/products/detail/würth-elektronik/970350365/9488738) | 35mm gap; M3x0.5 threads, 10mm thread depth. Screws/washers listed separately. Smooth4.5mm chassis holes and nominal35mm/22mm stack reviewed in Mechanical-evidence.md; no repeat height measurement requested. Actual retention and full installed steering are assembly checks. | Off-board | Off-board / mechanical | Wurth Elektronik
M1269-2545-AL | M2.5 female/female aluminum Pi spacer; 22mm body, 4.5mm hex AF | 0 | 4 | 1 | 5 | each | DigiKey (https://www.digikey.com/en/products/detail/raf-electronic-hardware/M1269-2545-AL/7680971) | DigiKey-listed substitute. About5.20mm across corners within5.5mm maximum envelope; saved socket body leaves0.595mm nominal clearance at5.5mm OD. Min4.70mm thread depth; use5mm screws. Nominal22mm Pi gap/5.17mm engagement checked; mating/retention are assembly checks. The shortened Pi3-38 socket now meets the 3mm hole-edge rule; see Mounting-and-encoder-revision.md. | Off-board | Off-board / mechanical | RAF Electronic Hardware
DF63-2S-3.96C | Battery/motor cable housings | 0 | 3 | 1 | 4 | each | DigiKey (https://www.digikey.com/en/products/detail/hirose-electric-co-ltd/DF63-2S-3-96C/4972157) | One battery and two motor adapters. Exact mating family selected; pinout and actual cable continuity still require verification. | Off-board | Off-board / mechanical | Hirose
DF63A-1618SC | Battery/motor crimp contacts | 0 | 6 | 4 | 10 | each | DigiKey (https://www.digikey.com/en/products/detail/hirose-electric-co-ltd/DF63A-1618SC/14564650) | Six installed contacts plus four spares. Selected 16AWG adapter wire; original motor/battery tails may need insulated gauge transitions. Match crimp tooling to terminal and insulation; do not force thin motor wires into a 16-18AWG crimp. | Off-board | Off-board / mechanical | Hirose
DF63-3S-3.96C | Servo adapter cable housing | 0 | 1 | 1 | 2 | each | DigiKey (https://www.digikey.com/en/products/detail/hirose-electric-co-ltd/DF63-3S-3-96C/4972158) | Board-side mating family selected. J90:1GND/2sensed6.6V/3PWM. Servo-side lead/transition still unresolved under purchasing rule; see Parts-review.md. | Off-board | Off-board / mechanical | Hirose
DF63A-2022SC | Servo cable contacts / adapter harness | 0 | 3 | 3 | 6 | each | DigiKey (https://www.digikey.com/en/products/detail/hirose-electric-co-ltd/DF63A-2022SC/14564655) | Three contacts+three spares, for20-22AWG adapter wire only. Existing servo wire gauge unverified; use an appropriate insulated transition if needed. Servo-side mate/current capability unresolved. | Off-board | Off-board / mechanical | Hirose
M20-1060400 | Encoder board-side 4-position 2.54mm cable housings | 0 | 2 | 1 | 3 | each | DigiKey (https://www.digikey.com/en/products/detail/harwin-inc/M20-1060400/3728193) | J82/J83 pin 1=nominal4.0V, 2=GND, 3=A, 4=B. Unkeyed: mark pin1 and polarity. Vehicle end uses existing PH2.0-6 cable / course FIT0587 if physically matching. Do not infer motor-cable colors. | Off-board | Off-board / mechanical | Harwin
97790803111 | M3x8 nylon pan-head screws for chassis spacers | 0 | 8 | 2 | 10 | each | DigiKey (https://www.digikey.com/en/products/detail/würth-elektronik/97790803111/10056388) | 8 installed+2spares; one at each spacer end. About5.9mm top engagement with1.6mm PCB and0.5mm washer; spacer thread depth10mm. Check actual lower plate thickness and tightening. | Off-board | Off-board / mechanical | Wurth Elektronik
MFW030A | M3 nylon washers; 3.2mm ID x7mm OD x0.5mm | 0 | 8 | 2 | 10 | each | DigiKey (https://www.digikey.com/en/products/detail/essentra-components/MFW030A/4105389) | 8 installed+2spares; under screw heads. Bridges 4.0mm NPTH PCB holes and confirmed4.5mm smooth chassis holes; use washers at both ends. Does not add to35mm plate gap; check load retention. | Off-board | Off-board / mechanical | Essentra Components
50M025045P005 | M2.5x5 nylon pan Phillips screws; 5mm head diameter | 0 | 8 | 2 | 10 | each | DigiKey (https://www.digikey.com/en/products/detail/essentra-components/50M025045P005/11639454) | 8 installed+2spares; two per Pi spacer. Approx3.4mm engagement through1.6mm board versus RAF min4.70mm thread depth; no spacing washers. Check actual fit and retention. | Off-board | Off-board / mechanical | Essentra Components
M20-1180046 | Encoder housing loose female crimp contacts; 22-30AWG | 0 | 8 | 4 | 12 | each | DigiKey (https://www.digikey.com/en/products/detail/harwin-inc/M20-1180046/3728125) | Four contacts per encoder; four spares. For M20-1060400 and 0.64mm square header pins. Match actual wire insulation and verified crimp tooling. | Off-board | Off-board / mechanical | Harwin
3057 (red/black cut lengths) | 16AWG stranded UL1007 power wire; total metres, half red/half black | 0 | 4 | 2 | 6 | m | DigiKey | Request 3m red AND 3m black (2m planned +1m routing/spare each). DF63A-1618SC crimp range includes 16AWG. Exact installed length, temperature, bundling and fuse coordination still require verification. Do not buy full reels if lab can supply cut lengths. Linked RD005/BK005 listings are 100ft (30.5m) spools. Requested_total is metres, not spools. If lab cut lengths are unavailable, reconcile order units and cost before procurement. | Off-board | Off-board / mechanical | Alpha Wire
WP7113ID | 5mm red vehicle LED: front-left | 0 | 1 | 1 | 2 | each | DigiKey (https://www.digikey.com/en/products/detail/kingbright/WP7113ID/1747663) | One installed plus one color-matched spare. Replacement baseline; reuse existing LED only if its ratings/polarity are compatible. Existing 220R/5.1V transistor stage gives approximately 7-14mA with typical Vf; calculate/verify actual brightness. Not listed by exact MPN in course v3. | Off-board | Off-board / mechanical | Kingbright
WP7113QWC/D | 5mm white vehicle LED: front-right | 0 | 1 | 1 | 2 | each | DigiKey (https://www.digikey.com/en/products/detail/kingbright/WP7113QWC-D/26231031) | One installed plus one color-matched spare. Replacement baseline; reuse existing LED only if its ratings/polarity are compatible. Existing 220R/5.1V transistor stage gives approximately 7-14mA with typical Vf; calculate/verify actual brightness. Not listed by exact MPN in course v3. | Off-board | Off-board / mechanical | Kingbright
WP7113YD | 5mm yellow vehicle LED: rear-left | 0 | 1 | 1 | 2 | each | DigiKey (https://www.digikey.com/en/products/detail/kingbright/WP7113YD/1747683) | One installed plus one color-matched spare. Replacement baseline; reuse existing LED only if its ratings/polarity are compatible. Existing 220R/5.1V transistor stage gives approximately 7-14mA with typical Vf; calculate/verify actual brightness. Not listed by exact MPN in course v3. | Off-board | Off-board / mechanical | Kingbright
WP7113QBC/D | 5mm blue vehicle LED: rear-right | 0 | 1 | 1 | 2 | each | DigiKey (https://www.digikey.com/en/products/detail/kingbright/WP7113QBC-D/2261460) | One installed plus one color-matched spare. Replacement baseline; reuse existing LED only if its ratings/polarity are compatible. Existing 220R/5.1V transistor stage gives approximately 7-14mA with typical Vf; calculate/verify actual brightness. Not listed by exact MPN in course v3. | Off-board | Off-board / mechanical | Kingbright
SPECIFIED: L298N-to-6396BG attachment | One mounting kit: M3 steel screw/nut/washers and thermal grease | 0 | 1 | 0 | 1 | assembly | Review source (https://github.com/fmarples/18649_team4/blob/lab4/lab4/Heatsink-mounting-review.md) | OPEN - course-stock allocation only: can the course supply one specified kit or equivalent? Drawing-based mounting method is resolved. Buy any shortfall from the linked DigiKey/Mouser sources; do not order bulk packs without reconciling shared demand. | Off-board | Off-board / mechanical | Keystone / BFirst / MG Chemicals, or documented course equivalents
UNRESOLVED: servo-side adapter lead | One servo adapter; SparkFun19224 candidate only; Hirose parts listed separately | 0 | 1 | 0 | 1 | each | Review needed (https://github.com/fmarples/18649_team4/blob/lab4/lab4/Parts-review.md) | OPEN - TA recommendation requested: which course-stock or DigiKey/Mouser male servo lead should we use for the LD-1501MG? SparkFun19224 is only a candidate; its contact/cable current rating is undocumented for the listed 2.4-3A stall range. Final selection and fit/polarity/continuity/voltage-drop/heating checks are required before powered use, not completed October24 measurements. | Off-board | External / mechanical | Unselected; SparkFun candidate
MCP1700-4002E/TO | MCP1700-4002E/TO | 1 | 0 | 1 | 2 | each | DigiKey (https://www.digikey.com/en/products/detail/microchip-technology/MCP1700-4002E-TO/2614904) | NEW October 27 encoder-supply revision: request listed total from DigiKey less any confirmed course allocation; not in the October 26 purchasing snapshot. | U82 | Package_TO_SOT_THT:TO-92_Inline_Wide | Microchip Technology
TPSB106K016R0800 | 10u 16V 10% low-ESR | 2 | 0 | 1 | 3 | each | DigiKey (https://www.digikey.com/en/products/detail/kyocera-avx/TPSB106K016R0800/678477) | NEW October 27 encoder-supply revision: request listed total from DigiKey less any confirmed course allocation; not in the October 26 purchasing snapshot. | C804 C805 | Capacitor_Tantalum_SMD:CP_EIA-3528-21_Kemet-B | KYOCERA AVX
RT0603BRD07100KL | 100k 0.1% battery divider | 1 | 0 | 1 | 2 | each | DigiKey (https://www.digikey.com/en/products/detail/yageo/RT0603BRD07100KL/1072187) | Battery divider high side. 15V design ceiling; 0.1% ratio resistors. | R580 | Resistor_SMD:R_0603_1608Metric | YAGEO
S220403BK / Amazon B0DQP7SKGV | CNHL 3S 11.1V 2200mAh 40C shorty LiPo; one TWO-PACK listing | 0 | 1 | 0 | 1 | two-pack | Amazon (https://www.amazon.com/dp/B0DQP7SKGV) | APPROVED replacement pair Oct28. Confirm exact variant/seller/delivery and any existing order before purchasing. One requested unit is a TWO-PACK listing, not two listings. | Off-board | 77x33x26mm nominal; +5mm dimensional allowance fits measured envelope | CNHL
44295 / HRC44295 | Hitec RDX1 Mini AC65W balance/storage charger | 0 | 1 | 0 | 1 | each | Amazon (https://www.amazon.com/dp/B07ZDKT6BD) | APPROVED replacement pair Oct28. Confirm exact variant/seller/delivery and any existing order before purchasing. One charger; use standard 3S LiPo balance mode with the selected pack. | Off-board | External AC100-240V; 2-4S LiPo;0.1-6A | Hitec
PRT-10474 / 10474 | XT60 male/female connector pairs for vehicle and charge harnesses | 0 | 3 | 0 | 3 | pair | DigiKey (https://www.digikey.com/en/products/detail/sparkfun-electronics/10474/8258064) | Reserve one mating end for the vehicle adapter and two for charger extension if needed; unused ends are spares. Assemble from16AWG stock with insulated joints. Match actual contact sex/keying at both ends; do not modify battery terminals or balance lead. Current capability and polarity must hold for complete harness; charging adapter is separate from vehicle adapter. | Off-board | Three pairs = six connector bodies; not three assembled leads | SparkFun
0FHM0001ZXJ | Pack-side MINI inline fuse holder with cover | 0 | 1 | 0 | 1 | each | DigiKey (https://www.digikey.com/en/products/detail/littelfuse-commercial-vehicle-products/0FHM0001ZXJ/2004060) | Place in positive vehicle adapter near battery connector, before long cable. Transition14AWG holder leads to16AWG DF63 contacts using insulated splice; never force14AWG into16-18AWG crimp. Separate0297010.L10A candidate element. Complete fuse/wire/connector coordination remains open. Do not count the PCB fuse as protecting the upstream cable. | Off-board | 14AWG prewired leads; MINI fuse;32VDC | Littelfuse
Course LiPo charging bag | Fire-resistant LiPo charging bag required by handout | 0 | 1 | 0 | 1 | each | Course request — open (https://18449-f26.slack.com/archives/C0BRYGTD4HH/p1792789284321879) | Can the course supply a suitable LiPo charging bag? If not, provide a permitted purchase source before charging. | Off-board | Must close around one82x38x31mm pack allowance with charge leads exiting | Course stock
GRM1885C1H680JA01D | 68p C0G | 1 | 0 | 1 | 2 | each | DigiKey (https://www.digikey.com/en/products/detail/murata-electronics/GRM1885C1H680JA01D/586916) | 1 fitted + 1 spare. Replaces 22pF at this reference; no footprint change. See Capacitor-bank-review.md. | C414 | Capacitor_SMD:C_0603_1608Metric | Murata
GRM1885C1H910JA01D | 91p C0G | 1 | 0 | 1 | 2 | each | DigiKey (https://www.digikey.com/en/products/detail/murata-electronics/GRM1885C1H910JA01D/586935) | 1 fitted + 1 spare. Replaces 22pF at this reference; no footprint change. See Capacitor-bank-review.md. | C424 | Capacitor_SMD:C_0603_1608Metric | Murata
GRM1885C1H300JA01D | 30p C0G | 1 | 0 | 1 | 2 | each | DigiKey (https://www.digikey.com/en/products/detail/murata-electronics/GRM1885C1H300JA01D/587619) | 1 fitted + 1 spare. Replaces 22pF at this reference; no footprint change. See Capacitor-bank-review.md. | C434 | Capacitor_SMD:C_0603_1608Metric | Murata

Sheet: Common parts
Team 4 Lab 4 BOM — common parts
Common = exact MPN or generic header entry in the course v3 list. Allocation is unconfirmed.
Totals include proposed spares. Buy only the shortfall after checking course/team stock. OPEN items require TA review.
Source purchasing BOM (https://github.com/fmarples/18649_team4/blob/lab4/lab4/Preliminary-BOM.csv) | Course common-list confirmation (https://18449-f26.slack.com/archives/C0BRYGTD4HH/p1792789284321879) |  |  |  |  |  | TA announcement (https://18449-f26.slack.com/archives/C0BRYGTD4HH/p1793052274317539)
Reconciled October 28, 2026. 35 consolidated lines. Zero-quantity historical alternatives omitted.
Part / MPN / specification | Description | In design | Off-board | Spares | Total requested | Unit | Supplier / source | TA review / purchasing note | References | Footprint / package | Manufacturer
MCP2515T-I/ST | MCP2515T-I/ST | 6 | 0 | 1 | 7 | each | DigiKey (https://www.digikey.com/short/9n43978z) | OPEN - course-stock allocation: please confirm how many of Requested_total the course can supply; request only the shortfall from DigiKey/Mouser. Requested_total includes proposed spares and is total demand, not confirmed stock or an additional buy quantity. | U10 U14 U20 U24 U30 U34 | Package_SO:TSSOP-20_4.4x6.5mm_P0.65mm | Microchip Technology
SN65HVD231DR | SN65HVD231DR | 6 | 0 | 1 | 7 | each | DigiKey (https://www.digikey.com/short/2q3q8t40) | OPEN - course-stock allocation: please confirm how many of Requested_total the course can supply; request only the shortfall from DigiKey/Mouser. Requested_total includes proposed spares and is total demand, not confirmed stock or an additional buy quantity. | U11 U15 U21 U25 U31 U35 | Package_SO:SOIC-8_3.9x4.9mm_P1.27mm | Texas Instruments
CX3225SB16000H0FLJCC | 16 MHz | 6 | 0 | 1 | 7 | each | DigiKey (https://www.digikey.com/short/vq8f334d) | OPEN - course-stock allocation: please confirm how many of Requested_total the course can supply; request only the shortfall from DigiKey/Mouser. Requested_total includes proposed spares and is total demand, not confirmed stock or an additional buy quantity. | Y10 Y14 Y20 Y24 Y30 Y34 | Crystal:Crystal_SMD_3225-4Pin_3.2x2.5mm | KYOCERA AVX
CRCW060310K0FKEA | 10k; 10k 1%; 10k PG pullup; 10k BOOT0; 10k NRST; 10k TEST pullup; 10k PWM pulldown; 10k boot pulldown | 42 | 0 | 9 | 51 | each | DigiKey (https://www.digikey.com/short/br7d02pp) | OPEN - course-stock allocation: please confirm how many of Requested_total the course can supply; request only the shortfall from DigiKey/Mouser. Requested_total includes proposed spares and is total demand, not confirmed stock or an additional buy quantity. | R100 R101 R140 R141 R200 R201 R240 R241 R300 R301 R340 R341 R3 R4 R6 R7 R400 R413 R423 R433 R804 R805 R806 R807 R411 R414 R424 R434 R500 R600 R501 R601 R502 R602 R700 R530 R630 R631 R632 R633 R634 R635 | Resistor_SMD:R_0603_1608Metric | Vishay
KGM15AR71C104KT | 100n; 100n VDD19; 100n VDD32; 100n VDD48; 100n VDD64; 100n VBAT; 100n VDDA; 100n NRST; 100n TEST | 45 | 0 | 11 | 56 | each | DigiKey (https://www.digikey.com/short/dzn7v8v4) | OPEN - course-stock allocation: please confirm how many of Requested_total the course can supply; request only the shortfall from DigiKey/Mouser. Requested_total includes proposed spares and is total demand, not confirmed stock or an additional buy quantity. | C102 C103 C104 C142 C143 C144 C202 C203 C204 C242 C243 C244 C302 C303 C304 C342 C343 C344 C1 C2 C3 C5 C6 C8 C701 C801 C803 C580 C500 C600 C501 C601 C502 C602 C503 C603 C504 C604 C507 C607 C509 C609 C510 C610 C702 | Capacitor_SMD:C_0603_1608Metric | KYOCERA AVX
Header 2x02 / 2.54 mm / vertical | CAN A isolation; CAN B isolation | 6 | 0 | 2 | 8 | each | Course stock (https://18449-f26.slack.com/archives/C0BRYGTD4HH/p1792789284321879) | OPEN - course-stock allocation: please confirm how many of Requested_total the course can supply; request only the shortfall from DigiKey/Mouser. Requested_total includes proposed spares and is total demand, not confirmed stock or an additional buy quantity. Confirm the row/pin dimensions in Footprint for these generic headers. | J10 J20 J30 J14 J24 J34 | Connector_PinHeader_2.54mm:PinHeader_2x02_P2.54mm_Vertical | Unspecified
Header 1x04 / 2.54 mm / vertical | CAN A test; CAN B test; Current test; Reserved / encoder probes; LEFT encoder; RIGHT encoder | 11 | 0 | 6 | 17 | each | Course stock (https://18449-f26.slack.com/archives/C0BRYGTD4HH/p1792789284321879) | OPEN - course-stock allocation: please confirm how many of Requested_total the course can supply; request only the shortfall from DigiKey/Mouser. Requested_total includes proposed spares and is total demand, not confirmed stock or an additional buy quantity. Confirm the row/pin dimensions in Footprint for these generic headers. | J11 J21 J31 J15 J25 J35 J2 J3 J505 J82 J83 | Connector_PinHeader_2.54mm:PinHeader_1x04_P2.54mm_Vertical | Unspecified
Header 1x02 / 2.54 mm / vertical | TERM A; TERM B; VBAT test; BOOT recovery; FRONT LEFT lamp; FRONT RIGHT lamp; REAR LEFT lamp; REAR RIGHT lamp | 11 | 0 | 8 | 19 | each | Course stock (https://18449-f26.slack.com/archives/C0BRYGTD4HH/p1792789284321879) | OPEN - course-stock allocation: please confirm how many of Requested_total the course can supply; request only the shortfall from DigiKey/Mouser. Requested_total includes proposed spares and is total demand, not confirmed stock or an additional buy quantity. Confirm the row/pin dimensions in Footprint for these generic headers. | JP10 JP20 JP14 JP24 J41 J500 J600 J550 J551 J650 J651 | Connector_PinHeader_2.54mm:PinHeader_1x02_P2.54mm_Vertical | Unspecified
RC0603FR-07120RL | 120R | 4 | 0 | 1 | 5 | each | DigiKey (https://www.digikey.com/short/3v4wdv91) | OPEN - course-stock allocation: please confirm how many of Requested_total the course can supply; request only the shortfall from DigiKey/Mouser. Requested_total includes proposed spares and is total demand, not confirmed stock or an additional buy quantity. | R102 R142 R202 R242 | Resistor_SMD:R_0603_1608Metric | YAGEO
RC0603FR-074K7L | 4.7k | 1 | 0 | 1 | 2 | each | DigiKey (https://www.digikey.com/short/p9rj0720) | OPEN - course-stock allocation: please confirm how many of Requested_total the course can supply; request only the shortfall from DigiKey/Mouser. Requested_total includes proposed spares and is total demand, not confirmed stock or an additional buy quantity. | R2 | Resistor_SMD:R_0603_1608Metric | YAGEO
Header 1x03 / 2.54 mm / vertical | Sense test points; Rail / PG / GND; 3.3V TTL UART | 6 | 0 | 3 | 9 | each | Course stock (https://18449-f26.slack.com/archives/C0BRYGTD4HH/p1792789284321879) | OPEN - course-stock allocation: please confirm how many of Requested_total the course can supply; request only the shortfall from DigiKey/Mouser. Requested_total includes proposed spares and is total demand, not confirmed stock or an additional buy quantity. Confirm the row/pin dimensions in Footprint for these generic headers. | J1 J42 J43 J44 J502 J602 | Connector_PinHeader_2.54mm:PinHeader_1x03_P2.54mm_Vertical | Unspecified
ACS712ELCTR-05B-T | ACS712ELCTR-05B-T | 2 | 0 | 1 | 3 | each | DigiKey (https://www.digikey.com/short/jv429bvf) | OPEN - course-stock allocation: please confirm how many of Requested_total the course can supply; request only the shortfall from DigiKey/Mouser. Requested_total includes proposed spares and is total demand, not confirmed stock or an additional buy quantity. | U2 U3 | Package_SO:SOIC-8_3.9x4.9mm_P1.27mm | Allegro MicroSystems
GCM1885C2A102FA16D | 1n | 2 | 0 | 1 | 3 | each | DigiKey (https://www.digikey.com/short/9t2hw2r4) | OPEN - course-stock allocation: please confirm how many of Requested_total the course can supply; request only the shortfall from DigiKey/Mouser. Requested_total includes proposed spares and is total demand, not confirmed stock or an additional buy quantity. | C4 C7 | Capacitor_SMD:C_0603_1608Metric | Murata
ERJ-3EKF1001V | 1k | 14 | 0 | 1 | 15 | each | DigiKey (https://www.digikey.com/short/n7qdn882) | OPEN - course-stock allocation: please confirm how many of Requested_total the course can supply; request only the shortfall from DigiKey/Mouser. Requested_total includes proposed spares and is total demand, not confirmed stock or an additional buy quantity. | R5 R8 R510 R511 R512 R513 R610 R611 R612 R613 R710 R711 R712 R713 | Resistor_SMD:R_0603_1608Metric | Panasonic
RC0603FR-0747KL | 47k | 2 | 0 | 1 | 3 | each | DigiKey (https://www.digikey.com/short/c4nn83n9) | OPEN - course-stock allocation: please confirm how many of Requested_total the course can supply; request only the shortfall from DigiKey/Mouser. Requested_total includes proposed spares and is total demand, not confirmed stock or an additional buy quantity. | R401 R412 | Resistor_SMD:R_0603_1608Metric | YAGEO
TPS564252DRLR | TPS564252DRLR | 3 | 0 | 1 | 4 | each | DigiKey (https://www.digikey.com/short/b8vwdnm0) | OPEN - course-stock allocation: please confirm how many of Requested_total the course can supply; request only the shortfall from DigiKey/Mouser. Requested_total includes proposed spares and is total demand, not confirmed stock or an additional buy quantity. | U40 U41 U42 | Package_TO_SOT_SMD:SOT-563 | Texas Instruments
SDCHA1V8040-4R7-R | 4.7uH / 5.8A | 3 | 0 | 1 | 4 | each | DigiKey (https://www.digikey.com/short/v01w3qmn) | OPEN - course-stock allocation: please confirm how many of Requested_total the course can supply; request only the shortfall from DigiKey/Mouser. Requested_total includes proposed spares and is total demand, not confirmed stock or an additional buy quantity. | L1 L2 L3 | Lab4_Power:Eaton_SDCHA1V8040 | Eaton
STM32F401RET6TR | STM32F401RET6TR | 2 | 0 | 1 | 3 | each | DigiKey (https://www.digikey.com/short/p2012wpj) | OPEN - course-stock allocation: please confirm how many of Requested_total the course can supply; request only the shortfall from DigiKey/Mouser. Requested_total includes proposed spares and is total demand, not confirmed stock or an additional buy quantity. | U50 U60 | Package_QFP:LQFP-64_10x10mm_P0.5mm | STMicroelectronics
GRM21BR71C475KE51L | 4.7u VDD bulk; 4.7u VCAP1 | 4 | 0 | 2 | 6 | each | DigiKey (https://www.digikey.com/short/fh8p2bz3) | OPEN - course-stock allocation: please confirm how many of Requested_total the course can supply; request only the shortfall from DigiKey/Mouser. Requested_total includes proposed spares and is total demand, not confirmed stock or an additional buy quantity. | C505 C605 C506 C606 | Capacitor_SMD:C_0805_2012Metric | Murata
742863160 | 600R @100MHz | 2 | 0 | 1 | 3 | each | DigiKey (https://www.digikey.com/short/1807nprh) | OPEN - course-stock allocation: please confirm how many of Requested_total the course can supply; request only the shortfall from DigiKey/Mouser. Requested_total includes proposed spares and is total demand, not confirmed stock or an additional buy quantity. | FB50 FB60 | Inductor_SMD:L_0603_1608Metric | Wurth Elektronik
SWT0210-045026GSA | SWT0210-045026GSA | 5 | 0 | 1 | 6 | each | DigiKey (https://www.digikey.com/short/fb4tj3c7) | OPEN - course-stock allocation: please confirm how many of Requested_total the course can supply; request only the shortfall from DigiKey/Mouser. Requested_total includes proposed spares and is total demand, not confirmed stock or an additional buy quantity. | SW50 SW51 SW60 SW61 SW70 | Lab4_Switches:GCT_SWT0210_4.5x4.5mm | GCT
Header 1x06 / 2.54 mm / vertical | SWD (2.54mm) | 2 | 0 | 1 | 3 | each | Course stock (https://18449-f26.slack.com/archives/C0BRYGTD4HH/p1792789284321879) | OPEN - course-stock allocation: please confirm how many of Requested_total the course can supply; request only the shortfall from DigiKey/Mouser. Requested_total includes proposed spares and is total demand, not confirmed stock or an additional buy quantity. Confirm the row/pin dimensions in Footprint for these generic headers. | J501 J601 | Connector_PinHeader_2.54mm:PinHeader_1x06_P2.54mm_Vertical | Unspecified
LTST-C190GKT | STATUS green | 3 | 0 | 1 | 4 | each | DigiKey (https://www.digikey.com/short/j2q28bwj) | OPEN - course-stock allocation: please confirm how many of Requested_total the course can supply; request only the shortfall from DigiKey/Mouser. Requested_total includes proposed spares and is total demand, not confirmed stock or an additional buy quantity. | D510 D610 D710 | LED_SMD:LED_0603_1608Metric | Lite-On
LTST-C190KRKT | ERR red | 3 | 0 | 1 | 4 | each | DigiKey (https://www.digikey.com/short/r70ftq33) | OPEN - course-stock allocation: please confirm how many of Requested_total the course can supply; request only the shortfall from DigiKey/Mouser. Requested_total includes proposed spares and is total demand, not confirmed stock or an additional buy quantity. | D511 D611 D711 | LED_SMD:LED_0603_1608Metric | Lite-On
LTST-C190KSKT | DEG_A yellow; DEG_B yellow | 6 | 0 | 2 | 8 | each | DigiKey (https://www.digikey.com/short/p3j5fdrv) | OPEN - course-stock allocation: please confirm how many of Requested_total the course can supply; request only the shortfall from DigiKey/Mouser. Requested_total includes proposed spares and is total demand, not confirmed stock or an additional buy quantity. | D512 D612 D712 D513 D613 D713 | LED_SMD:LED_0603_1608Metric | Lite-On
Header 1x13 / 2.54 mm / vertical | LAB3 rows 1-13 | 3 | 0 | 1 | 4 | each | Course stock (https://18449-f26.slack.com/archives/C0BRYGTD4HH/p1792789284321879) | OPEN - course-stock allocation: please confirm how many of Requested_total the course can supply; request only the shortfall from DigiKey/Mouser. Requested_total includes proposed spares and is total demand, not confirmed stock or an additional buy quantity. Confirm the row/pin dimensions in Footprint for these generic headers. | J503 J603 J703 | Connector_PinHeader_2.54mm:PinHeader_1x13_P2.54mm_Vertical | Unspecified
Header 1x08 / 2.54 mm / vertical | Additional probes | 1 | 0 | 1 | 2 | each | Course stock (https://18449-f26.slack.com/archives/C0BRYGTD4HH/p1792789284321879) | OPEN - course-stock allocation: please confirm how many of Requested_total the course can supply; request only the shortfall from DigiKey/Mouser. Requested_total includes proposed spares and is total demand, not confirmed stock or an additional buy quantity. Confirm the row/pin dimensions in Footprint for these generic headers. | J504 | Connector_PinHeader_2.54mm:PinHeader_1x08_P2.54mm_Vertical | Unspecified
Header 1x11 / 2.54 mm / vertical | Additional probes | 1 | 0 | 1 | 2 | each | Course stock (https://18449-f26.slack.com/archives/C0BRYGTD4HH/p1792789284321879) | OPEN - course-stock allocation: please confirm how many of Requested_total the course can supply; request only the shortfall from DigiKey/Mouser. Requested_total includes proposed spares and is total demand, not confirmed stock or an additional buy quantity. Confirm the row/pin dimensions in Footprint for these generic headers. | J604 | Connector_PinHeader_2.54mm:PinHeader_1x11_P2.54mm_Vertical | Unspecified
GRM219R61C226ME15L | 22u /16V | 1 | 0 | 1 | 2 | each | DigiKey (https://www.digikey.com/short/tmfw2f4h) | Confirm course allocation (1 fitted + 1 spare). Pi-local supplemental bypass; not a buck output-bank component. Keep the 0805 footprint. | C700 | Capacitor_SMD:C_0805_2012Metric | Murata
Header 1x05 / 2.54 mm / vertical | Pi extra probes | 1 | 0 | 1 | 2 | each | Course stock (https://18449-f26.slack.com/archives/C0BRYGTD4HH/p1792789284321879) | OPEN - course-stock allocation: please confirm how many of Requested_total the course can supply; request only the shortfall from DigiKey/Mouser. Requested_total includes proposed spares and is total demand, not confirmed stock or an additional buy quantity. Confirm the row/pin dimensions in Footprint for these generic headers. | J704 | Connector_PinHeader_2.54mm:PinHeader_1x05_P2.54mm_Vertical | Unspecified
Header 1x07 / 2.54 mm / vertical | Reserved / encoder probes | 1 | 0 | 1 | 2 | each | Course stock (https://18449-f26.slack.com/archives/C0BRYGTD4HH/p1792789284321879) | OPEN - course-stock allocation: please confirm how many of Requested_total the course can supply; request only the shortfall from DigiKey/Mouser. Requested_total includes proposed spares and is total demand, not confirmed stock or an additional buy quantity. Confirm the row/pin dimensions in Footprint for these generic headers. | J605 | Connector_PinHeader_2.54mm:PinHeader_1x07_P2.54mm_Vertical | Unspecified
L298N | L298N | 1 | 0 | 1 | 2 | each | DigiKey (https://www.digikey.com/short/38hmjrmb) | OPEN - course-stock allocation: please confirm how many of Requested_total the course can supply; request only the shortfall from DigiKey/Mouser. Requested_total includes proposed spares and is total demand, not confirmed stock or an additional buy quantity. | U80 | Lab4_Power:ST_L298N_Multiwatt15V_D1.1 | STMicroelectronics
SK520B | SK520B | 8 | 0 | 1 | 9 | each | DigiKey (https://www.digikey.com/short/3fz7wn2w) | OPEN - course-stock allocation: please confirm how many of Requested_total the course can supply; request only the shortfall from DigiKey/Mouser. Requested_total includes proposed spares and is total demand, not confirmed stock or an additional buy quantity. | D800 D801 D802 D803 D804 D805 D806 D807 | Diode_SMD:D_SMB | SMC Diode Solutions
6396BG | L298 heatsink; hardware NOT included | 0 | 1 | 0 | 1 | each | DigiKey (https://www.digikey.com/short/bw1zhdwb) | HS80 implemented on PCB: two soldered anchors plus M3 tab clamp. Drawing-based fit checked; assembly and thermal behavior untested. Confirm course allocation. | HS80 | Lab4_Mechanical:Boyd_6396BG_StraightPins; installed in PCB | Boyd Laconia
FIT0587 | PH2.0-6 cable for motor/encoder adapter donor | 0 | 2 | 1 | 3 | each | DigiKey (https://www.digikey.com/short/mz7mrwr2) | OPEN - course-stock allocation: please confirm how many of Requested_total the course can supply; request only the shortfall from DigiKey/Mouser. Requested_total includes proposed spares and is total demand, not confirmed stock or an additional buy quantity. | Off-board | Off-board / mechanical | DFRobot
