fmarples/18649_team4/lab4/Preliminary-BOM.csv

Part | Value | Qty_in_current_schematic | Additional_planned_qty | Spare_qty_proposed | References | Footprint | Source | LCSC | Assembly_class | Status | Manufacturer | Source_URL | Stock_status | Requested_total | TA_review
MCP2515T-I/ST | MCP2515T-I/ST | 6 | 0 | 1 | U10 U14 U20 U24 U30 U34 | Package_SO:TSSOP-20_4.4x6.5mm_P0.65mm | Course stock list v3, 2026-10-23 |  | Course/team assembly; active list BOM-Hand-assembly.csv | Preliminary; verify before fabrication | Microchip Technology | https://www.digikey.com/short/9n43978z | Course v3 exact MPN | 7 | OPEN - course-stock allocation: please confirm how many of Requested_total the course can supply; request only the shortfall from DigiKey/Mouser. Requested_total includes proposed spares and is total demand, not confirmed stock or an additional buy quantity.
SN65HVD231DR | SN65HVD231DR | 6 | 0 | 1 | U11 U15 U21 U25 U31 U35 | Package_SO:SOIC-8_3.9x4.9mm_P1.27mm | Course stock list v3, 2026-10-23 | C129257 | Course/team assembly; active list BOM-Hand-assembly.csv | Exact MPN appears in course v3 stock list; TI SOIC-8 pinout checked | Texas Instruments | https://www.digikey.com/short/2q3q8t40 | Course v3 exact MPN | 7 | OPEN - course-stock allocation: please confirm how many of Requested_total the course can supply; request only the shortfall from DigiKey/Mouser. Requested_total includes proposed spares and is total demand, not confirmed stock or an additional buy quantity.
CX3225SB16000H0FLJCC | 16 MHz | 6 | 0 | 1 | Y10 Y14 Y20 Y24 Y30 Y34 | Crystal:Crystal_SMD_3225-4Pin_3.2x2.5mm | Course stock list v3, 2026-10-23 |  | Course/team assembly; active list BOM-Hand-assembly.csv | Load capacitor values require crystal CL and PCB stray capacitance | KYOCERA AVX | https://www.digikey.com/short/vq8f334d | Course v3 exact MPN | 7 | OPEN - course-stock allocation: please confirm how many of Requested_total the course can supply; request only the shortfall from DigiKey/Mouser. Requested_total includes proposed spares and is total demand, not confirmed stock or an additional buy quantity.
GRM1885C1H180JA01D | 18p C0G 50V | 12 | 0 | 1 | C100 C101 C140 C141 C200 C201 C240 C241 C300 C301 C340 C341 | Capacitor_SMD:C_0603_1608Metric | Exact MPN candidate; confirm course stock / supplier |  | Course/team assembly; active list BOM-Hand-assembly.csv | CL=12pF; equal 18pF caps assume 3pF effective stray; tune after layout/clock measurement | Murata | https://www.digikey.com/en/products/detail/murata-electronics/GRM1885C1H180JA01D/586919 | Exact part documented; additional sourcing; stock not reserved | 13
CRCW060310K0FKEA | 10k | 24 | 0 | 2 | R100 R101 R140 R141 R200 R201 R240 R241 R300 R301 R340 R341 R3 R4 R6 R7 R400 R413 R423 R433 R804 R805 R806 R807 | Resistor_SMD:R_0603_1608Metric | Course stock list v3, 2026-10-23 |  | Course/team assembly; active list BOM-Hand-assembly.csv | Preliminary; verify before fabrication; Calculated design; not bench validated; Calculated circuit; not hardware validated | Vishay | https://www.digikey.com/short/br7d02pp | Course v3 exact MPN | 26 | OPEN - course-stock allocation: please confirm how many of Requested_total the course can supply; request only the shortfall from DigiKey/Mouser. Requested_total includes proposed spares and is total demand, not confirmed stock or an additional buy quantity.
KGM15AR71C104KT | 100n | 28 | 0 | 3 | C102 C103 C104 C142 C143 C144 C202 C203 C204 C242 C243 C244 C302 C303 C304 C342 C343 C344 C1 C2 C3 C5 C6 C8 C701 C801 C803 C580 | Capacitor_SMD:C_0603_1608Metric | Course stock list v3, 2026-10-23 |  | Course/team assembly; active list BOM-Hand-assembly.csv | Preliminary; verify before fabrication; Locate at associated supply pin; verify effective capacitance; Local decoupling; effective capacitance and layout to verify | KYOCERA AVX | https://www.digikey.com/short/dzn7v8v4 | Course v3 exact MPN | 31 | OPEN - course-stock allocation: please confirm how many of Requested_total the course can supply; request only the shortfall from DigiKey/Mouser. Requested_total includes proposed spares and is total demand, not confirmed stock or an additional buy quantity.
 | CAN A isolation | 3 | 0 | 1 | J10 J20 J30 | Connector_PinHeader_2.54mm:PinHeader_2x02_P2.54mm_Vertical | Course stock v3 only; confirm quantities and row/pin dimensions. Any new purchase must be DigiKey/Mouser; replacement MPN not selected. |  | Course/team assembly; active list BOM-Hand-assembly.csv | Shunts 1-2 and 3-4; remove both to isolate this node | Unspecified |  | Course stock requested; quantity not confirmed. Original course-list Amazon link is provenance only, not a team purchase source. | 4 | OPEN - course-stock allocation: please confirm how many of Requested_total the course can supply; request only the shortfall from DigiKey/Mouser. Requested_total includes proposed spares and is total demand, not confirmed stock or an additional buy quantity. Confirm the row/pin dimensions in Footprint for these generic headers.
 | CAN A test | 3 | 0 | 1 | J11 J21 J31 | Connector_PinHeader_2.54mm:PinHeader_1x04_P2.54mm_Vertical | Course stock v3 only; confirm quantities and row/pin dimensions. Any new purchase must be DigiKey/Mouser; replacement MPN not selected. |  | Course/team assembly; active list BOM-Hand-assembly.csv | Preliminary; verify before fabrication | Unspecified |  | Course stock requested; quantity not confirmed. Original course-list Amazon link is provenance only, not a team purchase source. | 4 | OPEN - course-stock allocation: please confirm how many of Requested_total the course can supply; request only the shortfall from DigiKey/Mouser. Requested_total includes proposed spares and is total demand, not confirmed stock or an additional buy quantity. Confirm the row/pin dimensions in Footprint for these generic headers.
 | TERM A | 2 | 0 | 1 | JP10 JP20 | Connector_PinHeader_2.54mm:PinHeader_1x02_P2.54mm_Vertical | Course stock v3 only; confirm quantities and row/pin dimensions. Any new purchase must be DigiKey/Mouser; replacement MPN not selected. |  | Course/team assembly; active list BOM-Hand-assembly.csv | Preliminary; verify before fabrication | Unspecified |  | Course stock requested; quantity not confirmed. Original course-list Amazon link is provenance only, not a team purchase source. | 3 | OPEN - course-stock allocation: please confirm how many of Requested_total the course can supply; request only the shortfall from DigiKey/Mouser. Requested_total includes proposed spares and is total demand, not confirmed stock or an additional buy quantity. Confirm the row/pin dimensions in Footprint for these generic headers.
RC0603FR-07120RL | 120R | 4 | 0 | 1 | R102 R142 R202 R242 | Resistor_SMD:R_0603_1608Metric | Course stock list v3, 2026-10-23 |  | Course/team assembly; active list BOM-Hand-assembly.csv | Preliminary; verify before fabrication | YAGEO | https://www.digikey.com/short/3v4wdv91 | Course v3 exact MPN | 5 | OPEN - course-stock allocation: please confirm how many of Requested_total the course can supply; request only the shortfall from DigiKey/Mouser. Requested_total includes proposed spares and is total demand, not confirmed stock or an additional buy quantity.
 | CAN B isolation | 3 | 0 | 1 | J14 J24 J34 | Connector_PinHeader_2.54mm:PinHeader_2x02_P2.54mm_Vertical | Course stock v3 only; confirm quantities and row/pin dimensions. Any new purchase must be DigiKey/Mouser; replacement MPN not selected. |  | Course/team assembly; active list BOM-Hand-assembly.csv | Shunts 1-2 and 3-4; remove both to isolate this node | Unspecified |  | Course stock requested; quantity not confirmed. Original course-list Amazon link is provenance only, not a team purchase source. | 4 | OPEN - course-stock allocation: please confirm how many of Requested_total the course can supply; request only the shortfall from DigiKey/Mouser. Requested_total includes proposed spares and is total demand, not confirmed stock or an additional buy quantity. Confirm the row/pin dimensions in Footprint for these generic headers.
 | CAN B test | 3 | 0 | 1 | J15 J25 J35 | Connector_PinHeader_2.54mm:PinHeader_1x04_P2.54mm_Vertical | Course stock v3 only; confirm quantities and row/pin dimensions. Any new purchase must be DigiKey/Mouser; replacement MPN not selected. |  | Course/team assembly; active list BOM-Hand-assembly.csv | Preliminary; verify before fabrication | Unspecified |  | Course stock requested; quantity not confirmed. Original course-list Amazon link is provenance only, not a team purchase source. | 4 | OPEN - course-stock allocation: please confirm how many of Requested_total the course can supply; request only the shortfall from DigiKey/Mouser. Requested_total includes proposed spares and is total demand, not confirmed stock or an additional buy quantity. Confirm the row/pin dimensions in Footprint for these generic headers.
 | TERM B | 2 | 0 | 1 | JP14 JP24 | Connector_PinHeader_2.54mm:PinHeader_1x02_P2.54mm_Vertical | Course stock v3 only; confirm quantities and row/pin dimensions. Any new purchase must be DigiKey/Mouser; replacement MPN not selected. |  | Course/team assembly; active list BOM-Hand-assembly.csv | Preliminary; verify before fabrication | Unspecified |  | Course stock requested; quantity not confirmed. Original course-list Amazon link is provenance only, not a team purchase source. | 3 | OPEN - course-stock allocation: please confirm how many of Requested_total the course can supply; request only the shortfall from DigiKey/Mouser. Requested_total includes proposed spares and is total demand, not confirmed stock or an additional buy quantity. Confirm the row/pin dimensions in Footprint for these generic headers.
WSL2512R0100FEA | 10mR / 1W / 1% | 1 | 0 | 4 | R1 | Lab4_Power:Vishay_WSL2512_7m_to_500m | Exact procurement selection pending |  | Course/team assembly; active list BOM-Hand-assembly.csv | Vishay 30100 p2 land pattern; 10mOhm 1W 1%; 0.16W at 4A; Kelvin routing still required | Vishay Dale | https://www.digikey.com/en/products/detail/vishay-dale/WSL2512R0100FEA/712561 | Additional purchase / exact candidate | 5
INA180A2IDBVR | INA180A2IDBVR | 1 | 0 | 1 | U1 | Package_TO_SOT_SMD:SOT-23-5 | Outside common list; verify purchase/assembly | C192764 | Course/team assembly; active list BOM-Hand-assembly.csv | Preliminary; verify before fabrication | Texas Instruments | https://www.digikey.com/en/products/detail/texas-instruments/INA180A2IDBVR/8132987 | DigiKey listing verified2026-10-24; quantity/lead time not reserved; physical fit untested | 2
RC0603FR-074K7L | 4.7k | 1 | 0 | 1 | R2 | Resistor_SMD:R_0603_1608Metric | Course stock list v3, 2026-10-23 |  | Course/team assembly; active list BOM-Hand-assembly.csv | Preliminary; verify before fabrication | YAGEO | https://www.digikey.com/short/p9rj0720 | Course v3 exact MPN | 2 | OPEN - course-stock allocation: please confirm how many of Requested_total the course can supply; request only the shortfall from DigiKey/Mouser. Requested_total includes proposed spares and is total demand, not confirmed stock or an additional buy quantity.
 | Sense test points | 1 | 0 | 1 | J1 | Connector_PinHeader_2.54mm:PinHeader_1x03_P2.54mm_Vertical | Course stock v3 only; confirm quantities and row/pin dimensions. Any new purchase must be DigiKey/Mouser; replacement MPN not selected. |  | Course/team assembly; active list BOM-Hand-assembly.csv | Preliminary; verify before fabrication | Unspecified |  | Course stock requested; quantity not confirmed. Original course-list Amazon link is provenance only, not a team purchase source. | 2 | OPEN - course-stock allocation: please confirm how many of Requested_total the course can supply; request only the shortfall from DigiKey/Mouser. Requested_total includes proposed spares and is total demand, not confirmed stock or an additional buy quantity. Confirm the row/pin dimensions in Footprint for these generic headers.
ACS712ELCTR-05B-T | ACS712ELCTR-05B-T | 2 | 0 | 1 | U2 U3 | Package_SO:SOIC-8_3.9x4.9mm_P1.27mm | Course stock list v3, 2026-10-23 |  | Course/team assembly; active list BOM-Hand-assembly.csv | Preliminary; verify before fabrication | Allegro MicroSystems | https://www.digikey.com/short/jv429bvf | Course v3 exact MPN | 3 | OPEN - course-stock allocation: please confirm how many of Requested_total the course can supply; request only the shortfall from DigiKey/Mouser. Requested_total includes proposed spares and is total demand, not confirmed stock or an additional buy quantity.
GCM1885C2A102FA16D | 1n | 2 | 0 | 1 | C4 C7 | Capacitor_SMD:C_0603_1608Metric | Course stock list v3, 2026-10-23 |  | Course/team assembly; active list BOM-Hand-assembly.csv | Preliminary; verify before fabrication | Murata | https://www.digikey.com/short/9t2hw2r4 | Course v3 exact MPN | 3 | OPEN - course-stock allocation: please confirm how many of Requested_total the course can supply; request only the shortfall from DigiKey/Mouser. Requested_total includes proposed spares and is total demand, not confirmed stock or an additional buy quantity.
ERJ-3EKF1001V | 1k | 14 | 0 | 1 | R5 R8 R510 R511 R512 R513 R610 R611 R612 R613 R710 R711 R712 R713 | Resistor_SMD:R_0603_1608Metric | Course stock list v3, 2026-10-23 |  | Course/team assembly; active list BOM-Hand-assembly.csv | Preliminary; verify before fabrication; Schematic connected; placement and hardware validation pending | Panasonic | https://www.digikey.com/short/n7qdn882 | Course v3 exact MPN | 15 | OPEN - course-stock allocation: please confirm how many of Requested_total the course can supply; request only the shortfall from DigiKey/Mouser. Requested_total includes proposed spares and is total demand, not confirmed stock or an additional buy quantity.
 | Current test | 2 | 0 | 1 | J2 J3 | Connector_PinHeader_2.54mm:PinHeader_1x04_P2.54mm_Vertical | Course stock v3 only; confirm quantities and row/pin dimensions. Any new purchase must be DigiKey/Mouser; replacement MPN not selected. |  | Course/team assembly; active list BOM-Hand-assembly.csv | Preliminary; verify before fabrication | Unspecified |  | Course stock requested; quantity not confirmed. Original course-list Amazon link is provenance only, not a team purchase source. | 3 | OPEN - course-stock allocation: please confirm how many of Requested_total the course can supply; request only the shortfall from DigiKey/Mouser. Requested_total includes proposed spares and is total demand, not confirmed stock or an additional buy quantity. Confirm the row/pin dimensions in Footprint for these generic headers.
DF63M-2P-3.96DSA | Battery input: 1=+ 2=GND | 1 | 0 | 1 | J40 | Connector_Hirose:Hirose_DF63M-2P-3.96DSA_1x02_P3.96mm_Vertical | DigiKey exact MPN; listing showed stock on 24Oct2026; not reserved or ordered. |  | Course/team assembly; active list BOM-Hand-assembly.csv | Teammate connector proposal; 14A header rating; verify wire/contact derating and fuse | Hirose | https://www.digikey.com/en/products/detail/hirose-electric-co-ltd/DF63M-2P-3-96DSA/9695031 | DigiKey exact MPN; listing showed stock on 24Oct2026; not reserved or ordered. | 2
3568 | Fuse: rating TBD | 1 | 0 | 1 | F1 | Fuse:Fuseholder_Blade_Mini_Keystone_3568 | Course list where exact MPN matches; confirm stock |  | Course/team assembly; active list BOM-Hand-assembly.csv | Fuse must coordinate with holder/wire rating and measured inrush; not selected from peak estimate alone | Keystone Electronics | https://www.digikey.com/en/products/detail/keystone-electronics/3568/2137306 | DigiKey listing verified2026-10-24; quantity/lead time not reserved; physical fit untested | 2
DMPH3010LK3-13 | DMPH3010LK3-13 | 1 | 0 | 1 | Q1 | Package_TO_SOT_SMD:TO-252-2 | Outside common list; verify purchase/assembly |  | Course/team assembly; active list BOM-Hand-assembly.csv | Reverse-polarity: drain toward battery, source toward load. Manufacturer G1 D2 S3. Not a reverse-current blocker. | Diodes Incorporated | https://www.digikey.com/en/products/detail/diodes-incorporated/DMPH3010LK3-13/7352990 | DigiKey listing verified2026-10-24; quantity/lead time not reserved; physical fit untested | 2
RC0603FR-0747KL | 47k | 2 | 0 | 1 | R401 R412 | Resistor_SMD:R_0603_1608Metric | Course stock list v3, 2026-10-23 |  | Course/team assembly; active list BOM-Hand-assembly.csv | Calculated design; not bench validated | YAGEO | https://www.digikey.com/short/c4nn83n9 | Course v3 exact MPN | 3 | OPEN - course-stock allocation: please confirm how many of Requested_total the course can supply; request only the shortfall from DigiKey/Mouser. Requested_total includes proposed spares and is total demand, not confirmed stock or an additional buy quantity.
BZT52C12 | 12V gate clamp | 1 | 0 | 1 | D40 | Diode_SMD:D_SOD-123F | Outside common list; verify purchase/assembly |  | Course/team assembly; active list BOM-Hand-assembly.csv | Cathode at source, anode at gate; clamp protects VGS, not the battery rail | Diotec | https://www.digikey.com/en/products/detail/diotec-semiconductor/BZT52C12/22189788 | DigiKey listing verified2026-10-24; quantity/lead time not reserved; physical fit untested | 2
UPW1E102MHD | 1000u / 25V | 1 | 0 | 1 | C400 | Capacitor_THT:CP_Radial_D12.5mm_P5.00mm | Outside common list; verify purchase/assembly |  | Course/team assembly; active list BOM-Hand-assembly.csv | Nichicon: diameter 12.5 mm, height 20 mm, pitch 5 mm; 1.66 A high-frequency ripple rating. Application ripple/thermal check pending. | Nichicon | https://www.digikey.com/en/products/detail/nichicon/UPW1E102MHD/589572 | DigiKey listing verified2026-10-24; quantity/lead time not reserved; physical fit untested | 2
 | VBAT test | 1 | 0 | 1 | J41 | Connector_PinHeader_2.54mm:PinHeader_1x02_P2.54mm_Vertical | Course stock v3 only; confirm quantities and row/pin dimensions. Any new purchase must be DigiKey/Mouser; replacement MPN not selected. |  | Course/team assembly; active list BOM-Hand-assembly.csv | Calculated design; not bench validated | Unspecified |  | Course stock requested; quantity not confirmed. Original course-list Amazon link is provenance only, not a team purchase source. | 2 | OPEN - course-stock allocation: please confirm how many of Requested_total the course can supply; request only the shortfall from DigiKey/Mouser. Requested_total includes proposed spares and is total demand, not confirmed stock or an additional buy quantity. Confirm the row/pin dimensions in Footprint for these generic headers.
TPS564252DRLR | TPS564252DRLR | 3 | 0 | 1 | U40 U41 U42 | Package_TO_SOT_SMD:SOT-563 | Course stock list v3, 2026-10-23 | C19191267 | Course/team assembly; active list BOM-Hand-assembly.csv | Calculated design; not bench validated | Texas Instruments | https://www.digikey.com/short/b8vwdnm0 | Course v3 exact MPN | 4 | OPEN - course-stock allocation: please confirm how many of Requested_total the course can supply; request only the shortfall from DigiKey/Mouser. Requested_total includes proposed spares and is total demand, not confirmed stock or an additional buy quantity.
SDCHA1V8040-4R7-R | 4.7uH / 5.8A | 3 | 0 | 1 | L1 L2 L3 | Lab4_Power:Eaton_SDCHA1V8040 | Course stock list v3, 2026-10-23 |  | Course/team assembly; active list BOM-Hand-assembly.csv | 5.8 A thermal / 6.7 A saturation at datasheet conditions; validate ripple/temperature | Eaton | https://www.digikey.com/short/v01w3qmn | Course v3 exact MPN | 4 | OPEN - course-stock allocation: please confirm how many of Requested_total the course can supply; request only the shortfall from DigiKey/Mouser. Requested_total includes proposed spares and is total demand, not confirmed stock or an additional buy quantity.
GRM32ER61E226KE15L | 22u 25V X5R 10%, input/output banks | 19 | 0 | 4 | C410 C412 C413 C415 C416 C417 C418 C420 C422 C423 C425 C426 C427 C430 C432 C433 C435 C436 C437 | Capacitor_SMD:C_1210_3225Metric | Outside common list; verify purchase/assembly |  | Course/team assembly; active list BOM-Hand-assembly.csv | Revised banks: 3 per input; outputs 4 servo, 3 Pi, 3 logic. See Capacitor-bank-review.md. | Murata | https://www.digikey.com/en/products/detail/murata-electronics/GRM32ER61E226KE15L/965931 | Exact part documented; additional sourcing; stock not reserved | 23 | 19 fitted + 4 spares. New 1210 banks replace six 0805 buck-output capacitors and add ten parts. Rated/typical-data sensitivity documented; transient/temperature checks follow assembly.
GRM188R71H104KA93D | 100n / 50V | 3 | 0 | 1 | C411 C421 C431 | Capacitor_SMD:C_0603_1608Metric | Outside common list; verify purchase/assembly |  | Course/team assembly; active list BOM-Hand-assembly.csv | Higher voltage input bypass than 16 V shelf capacitor | Murata | https://www.digikey.com/en/products/detail/murata-electronics/GRM188R71H104KA93D/587143 | Exact part documented; additional sourcing; stock not reserved | 4
GRM219R61C226ME15L | 22u / 16V | 0 | 0 | 0 | C412 C413 C422 C423 C432 C433 | Capacitor_SMD:C_0805_2012Metric | Course stock list v3, 2026-10-23 |  | Course/team assembly; active list BOM-Hand-assembly.csv | Superseded buck-output bank; do not order this line. | Murata | https://www.digikey.com/short/tmfw2f4h | Course v3 exact MPN | 0 | Replaced with GRM32ER61E226KE15L / 1210. C700 remains a separate active 0805 line.
RC0603FR-07100KL | 100k 1% | 1 | 0 | 1 | R410 | Resistor_SMD:R_0603_1608Metric | Outside common list; verify purchase/assembly |  | Course/team assembly; active list BOM-Hand-assembly.csv | Calculated design; not bench validated | YAGEO | https://www.digikey.com/en/products/detail/yageo/RC0603FR-07100KL/726889 | Exact part documented; additional sourcing; stock not reserved | 2
CRCW060310K0FKEA | 10k 1% | 1 | 0 | 1 | R411 | Resistor_SMD:R_0603_1608Metric | Course stock list v3, 2026-10-23 |  | Course/team assembly; active list BOM-Hand-assembly.csv | Calculated design; not bench validated | Vishay | https://www.digikey.com/short/br7d02pp | Course v3 exact MPN | 2 | OPEN - course-stock allocation: please confirm how many of Requested_total the course can supply; request only the shortfall from DigiKey/Mouser. Requested_total includes proposed spares and is total demand, not confirmed stock or an additional buy quantity.
RT0603BRD0710KL | 10k 0.1% | 3 | 0 | 2 | R431 R421 R581 | Resistor_SMD:R_0603_1608Metric | Additional DigiKey purchase request; not ordered |  | Course/team assembly; active list BOM-Hand-assembly.csv | Calculated design; not bench validated | YAGEO | https://www.digikey.com/en/products/detail/yageo/RT0603BRD0710KL/4340589 | Exact part documented 26Oct2026; stock not reserved | 5 | 0.1% tolerance required. Three fitted (R421/R431 feedback and R581 battery divider) plus two spares = five requested. Do not substitute 1% parts.
CRCW060310K0FKEA | 10k PG pullup | 3 | 0 | 1 | R414 R424 R434 | Resistor_SMD:R_0603_1608Metric | Course stock list v3, 2026-10-23 |  | Course/team assembly; active list BOM-Hand-assembly.csv | Calculated design; not bench validated | Vishay | https://www.digikey.com/short/br7d02pp | Course v3 exact MPN | 4 | OPEN - course-stock allocation: please confirm how many of Requested_total the course can supply; request only the shortfall from DigiKey/Mouser. Requested_total includes proposed spares and is total demand, not confirmed stock or an additional buy quantity.
 | Rail / PG / GND | 3 | 0 | 1 | J42 J43 J44 | Connector_PinHeader_2.54mm:PinHeader_1x03_P2.54mm_Vertical | Course stock v3 only; confirm quantities and row/pin dimensions. Any new purchase must be DigiKey/Mouser; replacement MPN not selected. |  | Course/team assembly; active list BOM-Hand-assembly.csv | Calculated design; not bench validated | Unspecified |  | Course stock requested; quantity not confirmed. Original course-list Amazon link is provenance only, not a team purchase source. | 4 | OPEN - course-stock allocation: please confirm how many of Requested_total the course can supply; request only the shortfall from DigiKey/Mouser. Requested_total includes proposed spares and is total demand, not confirmed stock or an additional buy quantity. Confirm the row/pin dimensions in Footprint for these generic headers.
RT0603BRD0775KL | 75k 0.1% | 1 | 0 | 1 | R420 | Resistor_SMD:R_0603_1608Metric | Outside common list; verify purchase/assembly |  | Course/team assembly; active list BOM-Hand-assembly.csv | Calculated design; not bench validated Procurement alternate: Susumu RG1608P-753-B-T5 (75k 0.1% 0.1W 0603 25ppm/C); purchase two total instead of primary, not both; record fitted MPN. Primary schematic identity retained. | YAGEO | https://www.digikey.com/en/products/detail/yageo/RT0603BRD0775KL/5139178 ; alternate: https://www.digikey.com/en/products/detail/susumu/RG1608P-753-B-T5/1240628 | Primary out of stock; named alternate listed in stock2026-10-24, not reserved. | 2
RC0603FR-0733KL | 33k | 1 | 0 | 1 | R422 | Resistor_SMD:R_0603_1608Metric | Outside common list; verify purchase/assembly |  | Course/team assembly; active list BOM-Hand-assembly.csv | Calculated design; not bench validated | YAGEO | https://www.digikey.com/en/products/detail/yageo/RC0603FR-0733KL/727159 | Exact part documented; additional sourcing; stock not reserved | 2
RT0603BRD0745K3L | 45.3k 0.1% | 1 | 0 | 1 | R430 | Resistor_SMD:R_0603_1608Metric | Additional DigiKey purchase request; not ordered |  | Course/team assembly; active list BOM-Hand-assembly.csv | Calculated design; not bench validated | YAGEO | https://www.digikey.com/en/products/detail/yageo/RT0603BRD0745K3L/5139111 | Exact part documented 26Oct2026; stock not reserved | 2 | 0.1% tolerance required for revised logic-rail margin; do not substitute a 1% course resistor. One fitted plus one spare.
RC0603FR-0722KL | 22k | 1 | 0 | 1 | R432 | Resistor_SMD:R_0603_1608Metric | Outside common list; verify purchase/assembly |  | Course/team assembly; active list BOM-Hand-assembly.csv | Calculated design; not bench validated Procurement alternate: Panasonic Industry ERJ-3EKF2202V (22k 1% 0.1W 0603 100ppm/C); purchase two total instead of primary, not both; record fitted MPN. Primary schematic identity retained. | YAGEO | https://www.digikey.com/en/products/detail/yageo/RC0603FR-0722KL/730003 ; alternate: https://www.digikey.com/en/products/detail/panasonic-industry/ERJ-3EKF2202V/1746336 | Primary out of stock; named alternate listed in stock2026-10-24, not reserved. | 2
STM32F401RET6TR | STM32F401RET6TR | 2 | 0 | 1 | U50 U60 | Package_QFP:LQFP-64_10x10mm_P0.5mm | Course stock list v3, 2026-10-23 |  | Course/team assembly; active list BOM-Hand-assembly.csv | DS10086 LQFP64; pin 30 VCAP1 needs 4.7uF; no PB11; GPIO modes require PCB firmware port | STMicroelectronics | https://www.digikey.com/short/p2012wpj | Course v3 exact MPN | 3 | OPEN - course-stock allocation: please confirm how many of Requested_total the course can supply; request only the shortfall from DigiKey/Mouser. Requested_total includes proposed spares and is total demand, not confirmed stock or an additional buy quantity.
KGM15AR71C104KT | 100n VDD19 | 2 | 0 | 1 | C500 C600 | Capacitor_SMD:C_0603_1608Metric | Course stock list v3, 2026-10-23 |  | Course/team assembly; active list BOM-Hand-assembly.csv | Locate at associated supply pin; verify effective capacitance | KYOCERA AVX | https://www.digikey.com/short/dzn7v8v4 | Course v3 exact MPN | 3 | OPEN - course-stock allocation: please confirm how many of Requested_total the course can supply; request only the shortfall from DigiKey/Mouser. Requested_total includes proposed spares and is total demand, not confirmed stock or an additional buy quantity.
KGM15AR71C104KT | 100n VDD32 | 2 | 0 | 1 | C501 C601 | Capacitor_SMD:C_0603_1608Metric | Course stock list v3, 2026-10-23 |  | Course/team assembly; active list BOM-Hand-assembly.csv | Locate at associated supply pin; verify effective capacitance | KYOCERA AVX | https://www.digikey.com/short/dzn7v8v4 | Course v3 exact MPN | 3 | OPEN - course-stock allocation: please confirm how many of Requested_total the course can supply; request only the shortfall from DigiKey/Mouser. Requested_total includes proposed spares and is total demand, not confirmed stock or an additional buy quantity.
KGM15AR71C104KT | 100n VDD48 | 2 | 0 | 1 | C502 C602 | Capacitor_SMD:C_0603_1608Metric | Course stock list v3, 2026-10-23 |  | Course/team assembly; active list BOM-Hand-assembly.csv | Locate at associated supply pin; verify effective capacitance | KYOCERA AVX | https://www.digikey.com/short/dzn7v8v4 | Course v3 exact MPN | 3 | OPEN - course-stock allocation: please confirm how many of Requested_total the course can supply; request only the shortfall from DigiKey/Mouser. Requested_total includes proposed spares and is total demand, not confirmed stock or an additional buy quantity.
KGM15AR71C104KT | 100n VDD64 | 2 | 0 | 1 | C503 C603 | Capacitor_SMD:C_0603_1608Metric | Course stock list v3, 2026-10-23 |  | Course/team assembly; active list BOM-Hand-assembly.csv | Locate at associated supply pin; verify effective capacitance | KYOCERA AVX | https://www.digikey.com/short/dzn7v8v4 | Course v3 exact MPN | 3 | OPEN - course-stock allocation: please confirm how many of Requested_total the course can supply; request only the shortfall from DigiKey/Mouser. Requested_total includes proposed spares and is total demand, not confirmed stock or an additional buy quantity.
KGM15AR71C104KT | 100n VBAT | 2 | 0 | 1 | C504 C604 | Capacitor_SMD:C_0603_1608Metric | Course stock list v3, 2026-10-23 |  | Course/team assembly; active list BOM-Hand-assembly.csv | Locate at associated supply pin; verify effective capacitance | KYOCERA AVX | https://www.digikey.com/short/dzn7v8v4 | Course v3 exact MPN | 3 | OPEN - course-stock allocation: please confirm how many of Requested_total the course can supply; request only the shortfall from DigiKey/Mouser. Requested_total includes proposed spares and is total demand, not confirmed stock or an additional buy quantity.
GRM21BR71C475KE51L | 4.7u VDD bulk | 2 | 0 | 1 | C505 C605 | Capacitor_SMD:C_0805_2012Metric | Course stock list v3, 2026-10-23 |  | Course/team assembly; active list BOM-Hand-assembly.csv | Locate at associated supply pin; verify effective capacitance | Murata | https://www.digikey.com/short/fh8p2bz3 | Course v3 exact MPN | 3 | OPEN - course-stock allocation: please confirm how many of Requested_total the course can supply; request only the shortfall from DigiKey/Mouser. Requested_total includes proposed spares and is total demand, not confirmed stock or an additional buy quantity.
GRM21BR71C475KE51L | 4.7u VCAP1 | 2 | 0 | 1 | C506 C606 | Capacitor_SMD:C_0805_2012Metric | Course stock list v3, 2026-10-23 |  | Course/team assembly; active list BOM-Hand-assembly.csv | Locate at associated supply pin; verify effective capacitance | Murata | https://www.digikey.com/short/fh8p2bz3 | Course v3 exact MPN | 3 | OPEN - course-stock allocation: please confirm how many of Requested_total the course can supply; request only the shortfall from DigiKey/Mouser. Requested_total includes proposed spares and is total demand, not confirmed stock or an additional buy quantity.
742863160 | 600R @100MHz | 2 | 0 | 1 | FB50 FB60 | Inductor_SMD:L_0603_1608Metric | Course stock list v3, 2026-10-23 |  | Course/team assembly; active list BOM-Hand-assembly.csv | VDDA analog filter; VSSA joins quiet common ground | Wurth Elektronik | https://www.digikey.com/short/1807nprh | Course v3 exact MPN | 3 | OPEN - course-stock allocation: please confirm how many of Requested_total the course can supply; request only the shortfall from DigiKey/Mouser. Requested_total includes proposed spares and is total demand, not confirmed stock or an additional buy quantity.
KGM15AR71C104KT | 100n VDDA | 2 | 0 | 1 | C507 C607 | Capacitor_SMD:C_0603_1608Metric | Course stock list v3, 2026-10-23 |  | Course/team assembly; active list BOM-Hand-assembly.csv | Locate at associated supply pin; verify effective capacitance | KYOCERA AVX | https://www.digikey.com/short/dzn7v8v4 | Course v3 exact MPN | 3 | OPEN - course-stock allocation: please confirm how many of Requested_total the course can supply; request only the shortfall from DigiKey/Mouser. Requested_total includes proposed spares and is total demand, not confirmed stock or an additional buy quantity.
CC0603JRX7R7BB105 | 1u VDDA | 2 | 0 | 1 | C508 C608 | Capacitor_SMD:C_0603_1608Metric | Course list; confirm availability |  | Course/team assembly; active list BOM-Hand-assembly.csv | Locate at associated supply pin; verify effective capacitance | YAGEO | https://www.digikey.com/en/products/detail/yageo/CC0603JRX7R7BB105/7164369 | Exact part documented; additional sourcing; stock not reserved | 3
CRCW060310K0FKEA | 10k BOOT0 | 2 | 0 | 1 | R500 R600 | Resistor_SMD:R_0603_1608Metric | Course stock list v3, 2026-10-23 |  | Course/team assembly; active list BOM-Hand-assembly.csv | Schematic connected; placement and hardware validation pending | Vishay | https://www.digikey.com/short/br7d02pp | Course v3 exact MPN | 3 | OPEN - course-stock allocation: please confirm how many of Requested_total the course can supply; request only the shortfall from DigiKey/Mouser. Requested_total includes proposed spares and is total demand, not confirmed stock or an additional buy quantity.
2.54 mm breakaway header | BOOT recovery | 2 | 0 | 1 | J500 J600 | Connector_PinHeader_2.54mm:PinHeader_1x02_P2.54mm_Vertical | Course stock v3 only; confirm quantities and row/pin dimensions. Any new purchase must be DigiKey/Mouser; replacement MPN not selected. |  | Course/team assembly; active list BOM-Hand-assembly.csv | Course stock; label pin 1 and every signal; preserve physical access | Unspecified |  | Course stock requested; quantity not confirmed. Original course-list Amazon link is provenance only, not a team purchase source. | 3 | OPEN - course-stock allocation: please confirm how many of Requested_total the course can supply; request only the shortfall from DigiKey/Mouser. Requested_total includes proposed spares and is total demand, not confirmed stock or an additional buy quantity. Confirm the row/pin dimensions in Footprint for these generic headers.
CRCW060310K0FKEA | 10k NRST | 2 | 0 | 1 | R501 R601 | Resistor_SMD:R_0603_1608Metric | Course stock list v3, 2026-10-23 |  | Course/team assembly; active list BOM-Hand-assembly.csv | Schematic connected; placement and hardware validation pending | Vishay | https://www.digikey.com/short/br7d02pp | Course v3 exact MPN | 3 | OPEN - course-stock allocation: please confirm how many of Requested_total the course can supply; request only the shortfall from DigiKey/Mouser. Requested_total includes proposed spares and is total demand, not confirmed stock or an additional buy quantity.
KGM15AR71C104KT | 100n NRST | 2 | 0 | 1 | C509 C609 | Capacitor_SMD:C_0603_1608Metric | Course stock list v3, 2026-10-23 |  | Course/team assembly; active list BOM-Hand-assembly.csv | Locate at associated supply pin; verify effective capacitance | KYOCERA AVX | https://www.digikey.com/short/dzn7v8v4 | Course v3 exact MPN | 3 | OPEN - course-stock allocation: please confirm how many of Requested_total the course can supply; request only the shortfall from DigiKey/Mouser. Requested_total includes proposed spares and is total demand, not confirmed stock or an additional buy quantity.
SWT0210-045026GSA | SWT0210-045026GSA | 5 | 0 | 1 | SW50 SW51 SW60 SW61 SW70 | Lab4_Switches:GCT_SWT0210_4.5x4.5mm | Course stock list v3, 2026-10-23 |  | Course/team assembly; active list BOM-Hand-assembly.csv | GCT A1 drawing verified: physical terminals 1/2 -> logical pad 1; 3/4 -> pad 2. See Switch-footprint-review.md. | GCT | https://www.digikey.com/short/fb4tj3c7 | Course v3 exact MPN | 6 | OPEN - course-stock allocation: please confirm how many of Requested_total the course can supply; request only the shortfall from DigiKey/Mouser. Requested_total includes proposed spares and is total demand, not confirmed stock or an additional buy quantity.
2.54 mm breakaway header | SWD (2.54mm) | 2 | 0 | 1 | J501 J601 | Connector_PinHeader_2.54mm:PinHeader_1x06_P2.54mm_Vertical | Course stock v3 only; confirm quantities and row/pin dimensions. Any new purchase must be DigiKey/Mouser; replacement MPN not selected. |  | Course/team assembly; active list BOM-Hand-assembly.csv | Course stock; label pin 1 and every signal; preserve physical access | Unspecified |  | Course stock requested; quantity not confirmed. Original course-list Amazon link is provenance only, not a team purchase source. | 3 | OPEN - course-stock allocation: please confirm how many of Requested_total the course can supply; request only the shortfall from DigiKey/Mouser. Requested_total includes proposed spares and is total demand, not confirmed stock or an additional buy quantity. Confirm the row/pin dimensions in Footprint for these generic headers.
2.54 mm breakaway header | 3.3V TTL UART | 2 | 0 | 1 | J502 J602 | Connector_PinHeader_2.54mm:PinHeader_1x03_P2.54mm_Vertical | Course stock v3 only; confirm quantities and row/pin dimensions. Any new purchase must be DigiKey/Mouser; replacement MPN not selected. |  | Course/team assembly; active list BOM-Hand-assembly.csv | Course stock; label pin 1 and every signal; preserve physical access | Unspecified |  | Course stock requested; quantity not confirmed. Original course-list Amazon link is provenance only, not a team purchase source. | 3 | OPEN - course-stock allocation: please confirm how many of Requested_total the course can supply; request only the shortfall from DigiKey/Mouser. Requested_total includes proposed spares and is total demand, not confirmed stock or an additional buy quantity. Confirm the row/pin dimensions in Footprint for these generic headers.
CRCW060310K0FKEA | 10k TEST pullup | 3 | 0 | 1 | R502 R602 R700 | Resistor_SMD:R_0603_1608Metric | Course stock list v3, 2026-10-23 |  | Course/team assembly; active list BOM-Hand-assembly.csv | Schematic connected; placement and hardware validation pending | Vishay | https://www.digikey.com/short/br7d02pp | Course v3 exact MPN | 4 | OPEN - course-stock allocation: please confirm how many of Requested_total the course can supply; request only the shortfall from DigiKey/Mouser. Requested_total includes proposed spares and is total demand, not confirmed stock or an additional buy quantity.
KGM15AR71C104KT | 100n TEST | 3 | 0 | 1 | C510 C610 C702 | Capacitor_SMD:C_0603_1608Metric | Course stock list v3, 2026-10-23 |  | Course/team assembly; active list BOM-Hand-assembly.csv | Locate at associated supply pin; verify effective capacitance | KYOCERA AVX | https://www.digikey.com/short/dzn7v8v4 | Course v3 exact MPN | 4 | OPEN - course-stock allocation: please confirm how many of Requested_total the course can supply; request only the shortfall from DigiKey/Mouser. Requested_total includes proposed spares and is total demand, not confirmed stock or an additional buy quantity.
LTST-C190GKT | STATUS green | 3 | 0 | 1 | D510 D610 D710 | LED_SMD:LED_0603_1608Metric | Course stock list v3, 2026-10-23 |  | Course/team assembly; active list BOM-Hand-assembly.csv | Active high; 1k limits current below 3.4 mA even at zero LED drop; verify visibility | Lite-On | https://www.digikey.com/short/j2q28bwj | Course v3 exact MPN | 4 | OPEN - course-stock allocation: please confirm how many of Requested_total the course can supply; request only the shortfall from DigiKey/Mouser. Requested_total includes proposed spares and is total demand, not confirmed stock or an additional buy quantity.
LTST-C190KRKT | ERR red | 3 | 0 | 1 | D511 D611 D711 | LED_SMD:LED_0603_1608Metric | Course stock list v3, 2026-10-23 |  | Course/team assembly; active list BOM-Hand-assembly.csv | Active high; 1k limits current below 3.4 mA even at zero LED drop; verify visibility | Lite-On | https://www.digikey.com/short/r70ftq33 | Course v3 exact MPN | 4 | OPEN - course-stock allocation: please confirm how many of Requested_total the course can supply; request only the shortfall from DigiKey/Mouser. Requested_total includes proposed spares and is total demand, not confirmed stock or an additional buy quantity.
LTST-C190KSKT | DEG_A yellow | 3 | 0 | 1 | D512 D612 D712 | LED_SMD:LED_0603_1608Metric | Course stock list v3, 2026-10-23 |  | Course/team assembly; active list BOM-Hand-assembly.csv | Active high; 1k limits current below 3.4 mA even at zero LED drop; verify visibility | Lite-On | https://www.digikey.com/short/p3j5fdrv | Course v3 exact MPN | 4 | OPEN - course-stock allocation: please confirm how many of Requested_total the course can supply; request only the shortfall from DigiKey/Mouser. Requested_total includes proposed spares and is total demand, not confirmed stock or an additional buy quantity.
LTST-C190KSKT | DEG_B yellow | 3 | 0 | 1 | D513 D613 D713 | LED_SMD:LED_0603_1608Metric | Course stock list v3, 2026-10-23 |  | Course/team assembly; active list BOM-Hand-assembly.csv | Active high; 1k limits current below 3.4 mA even at zero LED drop; verify visibility | Lite-On | https://www.digikey.com/short/p3j5fdrv | Course v3 exact MPN | 4 | OPEN - course-stock allocation: please confirm how many of Requested_total the course can supply; request only the shortfall from DigiKey/Mouser. Requested_total includes proposed spares and is total demand, not confirmed stock or an additional buy quantity.
2.54 mm breakaway header | LAB3 rows 1-13 | 3 | 0 | 1 | J503 J603 J703 | Connector_PinHeader_2.54mm:PinHeader_1x13_P2.54mm_Vertical | Course stock v3 only; confirm quantities and row/pin dimensions. Any new purchase must be DigiKey/Mouser; replacement MPN not selected. |  | Course/team assembly; active list BOM-Hand-assembly.csv | Course stock; label pin 1 and every signal; preserve physical access | Unspecified |  | Course stock requested; quantity not confirmed. Original course-list Amazon link is provenance only, not a team purchase source. | 4 | OPEN - course-stock allocation: please confirm how many of Requested_total the course can supply; request only the shortfall from DigiKey/Mouser. Requested_total includes proposed spares and is total demand, not confirmed stock or an additional buy quantity. Confirm the row/pin dimensions in Footprint for these generic headers.
2.54 mm breakaway header | Additional probes | 1 | 0 | 1 | J504 | Connector_PinHeader_2.54mm:PinHeader_1x08_P2.54mm_Vertical | Course stock v3 only; confirm quantities and row/pin dimensions. Any new purchase must be DigiKey/Mouser; replacement MPN not selected. |  | Course/team assembly; active list BOM-Hand-assembly.csv | Course stock; label pin 1 and every signal; preserve physical access | Unspecified |  | Course stock requested; quantity not confirmed. Original course-list Amazon link is provenance only, not a team purchase source. | 2 | OPEN - course-stock allocation: please confirm how many of Requested_total the course can supply; request only the shortfall from DigiKey/Mouser. Requested_total includes proposed spares and is total demand, not confirmed stock or an additional buy quantity. Confirm the row/pin dimensions in Footprint for these generic headers.
CRCW060310K0FKEA | 10k PWM pulldown | 1 | 0 | 1 | R530 | Resistor_SMD:R_0603_1608Metric | Course stock list v3, 2026-10-23 |  | Course/team assembly; active list BOM-Hand-assembly.csv | Schematic connected; placement and hardware validation pending | Vishay | https://www.digikey.com/short/br7d02pp | Course v3 exact MPN | 2 | OPEN - course-stock allocation: please confirm how many of Requested_total the course can supply; request only the shortfall from DigiKey/Mouser. Requested_total includes proposed spares and is total demand, not confirmed stock or an additional buy quantity.
2.54 mm breakaway header | Additional probes | 1 | 0 | 1 | J604 | Connector_PinHeader_2.54mm:PinHeader_1x11_P2.54mm_Vertical | Course stock v3 only; confirm quantities and row/pin dimensions. Any new purchase must be DigiKey/Mouser; replacement MPN not selected. |  | Course/team assembly; active list BOM-Hand-assembly.csv | Course stock; label pin 1 and every signal; preserve physical access | Unspecified |  | Course stock requested; quantity not confirmed. Original course-list Amazon link is provenance only, not a team purchase source. | 2 | OPEN - course-stock allocation: please confirm how many of Requested_total the course can supply; request only the shortfall from DigiKey/Mouser. Requested_total includes proposed spares and is total demand, not confirmed stock or an additional buy quantity. Confirm the row/pin dimensions in Footprint for these generic headers.
CRCW060310K0FKEA | 10k boot pulldown | 6 | 0 | 1 | R630 R631 R632 R633 R634 R635 | Resistor_SMD:R_0603_1608Metric | Course stock list v3, 2026-10-23 |  | Course/team assembly; active list BOM-Hand-assembly.csv | Schematic connected; placement and hardware validation pending | Vishay | https://www.digikey.com/short/br7d02pp | Course v3 exact MPN | 7 | OPEN - course-stock allocation: please confirm how many of Requested_total the course can supply; request only the shortfall from DigiKey/Mouser. Requested_total includes proposed spares and is total demand, not confirmed stock or an additional buy quantity.
ESQ-118-44-L-D | Pi GPIO pins3-38 / ESQ-118-44-L-D | 1 | 0 | 1 | J70 | Lab4_Mechanical:Samtec_ESQ-118-44_2x18_PiPins3-38_H18.67 | Mouser200-ESQ11844LD; listing checked2026-10-27; not ordered |  | Course/team assembly; active list BOM-Hand-assembly.csv | Bottom 36-contact socket mates Pi physical pins3-38; omit1/2/39/40 to clear all Pi holes by3mm from edge. Pin4 alone supplies5V; all used signals unchanged. Align to Pi3/4, not1/2. 22mm nominal gap. Samtec ESQ/TSW catalog5.7A/contact is supporting evidence, not a tested Pi assembly. Hand solder per Samtec process limits. | Samtec | https://www.mouser.co.uk/en/ProductDetail/Samtec/ESQ-118-44-L-D?qs=PB6%2FjmICvI2MYbzEyjh0rw%3D%3D | Mouser UK listing showed1 available; demand2 including spare is not fully reserved. Verify US delivery/remaining lead time. | 2 | NEW Oct27 socket substitution to meet3mm hole-edge clearance. Replace old ESQ-120 request; total2 including spare. Listed stock1 only; confirm US delivery/spare availability. Pin4 supplies5V; align socket toPi3/4.
GRM219R61C226ME15L | 22u /16V | 1 | 0 | 1 | C700 | Capacitor_SMD:C_0805_2012Metric | Course stock list v3, 2026-10-23 |  | Course/team assembly; active list BOM-Hand-assembly.csv | Locate at associated supply pin; verify effective capacitance | Murata | https://www.digikey.com/short/tmfw2f4h | Course v3 exact MPN | 2 | Confirm course allocation (1 fitted + 1 spare). Pi-local supplemental bypass; not a buck output-bank component. Keep the 0805 footprint.
2.54 mm breakaway header | Pi extra probes | 1 | 0 | 1 | J704 | Connector_PinHeader_2.54mm:PinHeader_1x05_P2.54mm_Vertical | Course stock v3 only; confirm quantities and row/pin dimensions. Any new purchase must be DigiKey/Mouser; replacement MPN not selected. |  | Course/team assembly; active list BOM-Hand-assembly.csv | Course stock; label pin 1 and every signal; preserve physical access | Unspecified |  | Course stock requested; quantity not confirmed. Original course-list Amazon link is provenance only, not a team purchase source. | 2 | OPEN - course-stock allocation: please confirm how many of Requested_total the course can supply; request only the shortfall from DigiKey/Mouser. Requested_total includes proposed spares and is total demand, not confirmed stock or an additional buy quantity. Confirm the row/pin dimensions in Footprint for these generic headers.
2.54 mm breakaway header | Reserved / encoder probes | 1 | 0 | 1 | J505 | Connector_PinHeader_2.54mm:PinHeader_1x04_P2.54mm_Vertical | Course stock v3 only; confirm quantities and row/pin dimensions. Any new purchase must be DigiKey/Mouser; replacement MPN not selected. |  | Course/team assembly; active list BOM-Hand-assembly.csv | Test access; not a substitute for final rated actuator connectors | Unspecified |  | Course stock requested; quantity not confirmed. Original course-list Amazon link is provenance only, not a team purchase source. | 2 | OPEN - course-stock allocation: please confirm how many of Requested_total the course can supply; request only the shortfall from DigiKey/Mouser. Requested_total includes proposed spares and is total demand, not confirmed stock or an additional buy quantity. Confirm the row/pin dimensions in Footprint for these generic headers.
2.54 mm breakaway header | Reserved / encoder probes | 1 | 0 | 1 | J605 | Connector_PinHeader_2.54mm:PinHeader_1x07_P2.54mm_Vertical | Course stock v3 only; confirm quantities and row/pin dimensions. Any new purchase must be DigiKey/Mouser; replacement MPN not selected. |  | Course/team assembly; active list BOM-Hand-assembly.csv | Test access; not a substitute for final rated actuator connectors | Unspecified |  | Course stock requested; quantity not confirmed. Original course-list Amazon link is provenance only, not a team purchase source. | 2 | OPEN - course-stock allocation: please confirm how many of Requested_total the course can supply; request only the shortfall from DigiKey/Mouser. Requested_total includes proposed spares and is total demand, not confirmed stock or an additional buy quantity. Confirm the row/pin dimensions in Footprint for these generic headers.
L298N | L298N | 1 | 0 | 1 | U80 | Package_TO_SOT_THT:TO-220-15_P2.54x5.08mm_StaggerOdd_Lead4.58mm_Vertical | Course stock list v3, 2026-10-23 |  | Course/team assembly; active list BOM-Hand-assembly.csv | ST L298 rev5: 2A DC per bridge and 2A braking; no hardware current limiter in this revision | STMicroelectronics | https://www.digikey.com/short/38hmjrmb | Course v3 exact MPN | 2 | OPEN - course-stock allocation: please confirm how many of Requested_total the course can supply; request only the shortfall from DigiKey/Mouser. Requested_total includes proposed spares and is total demand, not confirmed stock or an additional buy quantity.
GRM188R71H104KA93D | 100n 50V | 1 | 0 | 1 | C800 | Capacitor_SMD:C_0603_1608Metric | Exact MPN candidate; confirm course stock / supplier |  | Course/team assembly; active list BOM-Hand-assembly.csv | Local decoupling; effective capacitance and layout to verify | Murata | https://www.digikey.com/en/products/detail/murata-electronics/GRM188R71H104KA93D/587143 | Exact part documented; additional sourcing; stock not reserved | 2
EEU-FR1E471 | 470u 25V | 1 | 0 | 1 | C802 | Capacitor_THT:CP_Radial_D8.0mm_P3.50mm | Exact MPN candidate; confirm course stock / supplier |  | Course/team assembly; active list BOM-Hand-assembly.csv | Local decoupling; effective capacitance and layout to verify | Panasonic | https://www.digikey.com/en/products/detail/panasonic-electronic-components/EEU-FR1E471/2433553 | Exact part documented; additional sourcing; stock not reserved | 2
SK520B | SK520B | 8 | 0 | 1 | D800 D801 D802 D803 D804 D805 D806 D807 | Diode_SMD:D_SMB | Course stock list v3, 2026-10-23 |  | Course/team assembly; active list BOM-Hand-assembly.csv | SMC Diode Solutions 5A/200V SMB; exact MPN appears in course v3 list; motor clamp polarity checked | SMC Diode Solutions | https://www.digikey.com/short/3fz7wn2w | Course v3 exact MPN | 9 | OPEN - course-stock allocation: please confirm how many of Requested_total the course can supply; request only the shortfall from DigiKey/Mouser. Requested_total includes proposed spares and is total demand, not confirmed stock or an additional buy quantity.
DF63M-2P-3.96DSA | LEFT motor | 1 | 0 | 1 | J80 | Connector_Hirose:Hirose_DF63M-2P-3.96DSA_1x02_P3.96mm_Vertical | DigiKey exact MPN; listing showed stock on 24Oct2026; not reserved or ordered. |  | Course/team assembly; active list BOM-Hand-assembly.csv | Board-defined pin order; build/verify adapter to existing cable before power | Hirose | https://www.digikey.com/en/products/detail/hirose-electric-co-ltd/DF63M-2P-3-96DSA/9695031 | DigiKey exact MPN; listing showed stock on 24Oct2026; not reserved or ordered. | 2
DF63M-2P-3.96DSA | RIGHT motor | 1 | 0 | 1 | J81 | Connector_Hirose:Hirose_DF63M-2P-3.96DSA_1x02_P3.96mm_Vertical | DigiKey exact MPN; listing showed stock on 24Oct2026; not reserved or ordered. |  | Course/team assembly; active list BOM-Hand-assembly.csv | Board-defined pin order; build/verify adapter to existing cable before power | Hirose | https://www.digikey.com/en/products/detail/hirose-electric-co-ltd/DF63M-2P-3-96DSA/9695031 | DigiKey exact MPN; listing showed stock on 24Oct2026; not reserved or ordered. | 2
2.54 mm breakaway header | LEFT encoder | 1 | 0 | 1 | J82 | Connector_PinHeader_2.54mm:PinHeader_1x04_P2.54mm_Vertical | Course stock v3 only; confirm quantities and row/pin dimensions. Any new purchase must be DigiKey/Mouser; replacement MPN not selected. |  | Course/team assembly; active list BOM-Hand-assembly.csv | Board-defined pin order; build/verify adapter to existing cable before power | Unspecified |  | Course stock requested; quantity not confirmed. Original course-list Amazon link is provenance only, not a team purchase source. | 2 | OPEN - course-stock allocation: please confirm how many of Requested_total the course can supply; request only the shortfall from DigiKey/Mouser. Requested_total includes proposed spares and is total demand, not confirmed stock or an additional buy quantity. Confirm the row/pin dimensions in Footprint for these generic headers.
CRCW0603100RFKEA | 100R | 5 | 0 | 1 | R800 R801 R802 R803 R540 | Resistor_SMD:R_0603_1608Metric | Exact MPN candidate; confirm course stock / supplier |  | Course/team assembly; active list BOM-Hand-assembly.csv | Calculated circuit; not hardware validated | Vishay Dale | https://www.digikey.com/en/products/detail/vishay-dale/CRCW0603100RFKEA/1174554 | Exact part documented; additional sourcing; stock not reserved | 6
2.54 mm breakaway header | RIGHT encoder | 1 | 0 | 1 | J83 | Connector_PinHeader_2.54mm:PinHeader_1x04_P2.54mm_Vertical | Course stock v3 only; confirm quantities and row/pin dimensions. Any new purchase must be DigiKey/Mouser; replacement MPN not selected. |  | Course/team assembly; active list BOM-Hand-assembly.csv | Board-defined pin order; build/verify adapter to existing cable before power | Unspecified |  | Course stock requested; quantity not confirmed. Original course-list Amazon link is provenance only, not a team purchase source. | 2 | OPEN - course-stock allocation: please confirm how many of Requested_total the course can supply; request only the shortfall from DigiKey/Mouser. Requested_total includes proposed spares and is total demand, not confirmed stock or an additional buy quantity. Confirm the row/pin dimensions in Footprint for these generic headers.
SN74LVC14APWR | SN74LVC14APWR | 1 | 0 | 1 | U81 | Package_SO:TSSOP-14_4.4x5mm_P0.65mm | DigiKey SN74LVC14APW / 296-26584-5-ND is the reviewed tube-pack alternative to SN74LVC14APWR. Same TI device and PW/TSSOP-14 package; see Parts-review.md. Buy 2 individual ICs total (1 installed + 1 spare), not both ordering codes. | C7663 | Course/team assembly; active list BOM-Hand-assembly.csv | Inputs <=5.5V; both A/B inverted so quadrature phase order preserved; verify counter direction in firmware | Texas Instruments | https://www.digikey.com/en/products/detail/texas-instruments/SN74LVC14APW/1591867 | Source resolved: DigiKey showed 291 SN74LVC14APW available at $1.05 each on 24Oct2026. Original PWR listing is out of stock. Stock/price not reserved; confirm at purchase. | 2 | RESOLVED SOURCE - use reviewed SN74LVC14APW tube-pack alternative for U81, quantity 2 total. TI identifies PW/PWR as the same device in different carriers. Recheck supplier stock at purchase and record the fitted ordering code. No circuit or footprint change.
DF63M-3P-3.96DSA | Servo: GND / 6.6V / PWM | 1 | 0 | 1 | J90 | Connector_Hirose:Hirose_DF63M-3P-3.96DSA_1x03_P3.96mm_Vertical | DigiKey exact MPN; listing showed stock on 24Oct2026; not reserved or ordered. |  | Course/team assembly; active list BOM-Hand-assembly.csv | Board-defined pin order; build/verify adapter to existing cable before power | Hirose | https://www.digikey.com/en/products/detail/hirose-electric-co-ltd/DF63M-3P-3-96DSA/9695039 | DigiKey exact MPN; listing showed stock on 24Oct2026; not reserved or ordered. | 2
CRCW06032K20FKEA | 2.2k | 4 | 0 | 1 | R550 R551 R650 R651 | Resistor_SMD:R_0603_1608Metric | Exact MPN candidate; confirm course stock / supplier |  | Course/team assembly; active list BOM-Hand-assembly.csv | Calculated circuit; not hardware validated | Vishay Dale | https://www.digikey.com/en/products/detail/vishay-dale/CRCW06032K20FKEA/1174704 | Exact part documented; additional sourcing; stock not reserved | 5
CRCW0603100KFKEA | 100k | 4 | 0 | 1 | R560 R561 R660 R661 | Resistor_SMD:R_0603_1608Metric | Exact MPN candidate; confirm course stock / supplier |  | Course/team assembly; active list BOM-Hand-assembly.csv | Calculated circuit; not hardware validated | Vishay Dale | https://www.digikey.com/en/products/detail/vishay-dale/CRCW0603100KFKEA/1180038 | Exact part documented; additional sourcing; stock not reserved | 5
MMBT3904-7-F | MMBT3904 | 4 | 0 | 1 | Q550 Q551 Q650 Q651 | Package_TO_SOT_SMD:SOT-23 | DigiKey exact MPN; listing showed stock on 24Oct2026; not reserved or ordered. |  | Course/team assembly; active list BOM-Hand-assembly.csv | Low-side lamp switch; 220R limits 5.1V LED current; not for incandescent lamps | Diodes Incorporated | https://www.digikey.com/en/products/detail/diodes-incorporated/MMBT3904-7-F/814494 | DigiKey exact MPN; listing showed stock on 24Oct2026; not reserved or ordered. | 5
CRCW0603220RFKEA | 220R | 4 | 0 | 1 | R570 R571 R670 R671 | Resistor_SMD:R_0603_1608Metric | Exact MPN candidate; confirm course stock / supplier |  | Course/team assembly; active list BOM-Hand-assembly.csv | Calculated circuit; not hardware validated | Vishay Dale | https://www.digikey.com/en/products/detail/vishay-dale/CRCW0603220RFKEA/1174590 | Exact part documented; additional sourcing; stock not reserved | 5
2.54 mm breakaway header | FRONT LEFT lamp | 1 | 0 | 1 | J550 | Connector_PinHeader_2.54mm:PinHeader_1x02_P2.54mm_Vertical | Course stock v3 only; confirm quantities and row/pin dimensions. Any new purchase must be DigiKey/Mouser; replacement MPN not selected. |  | Course/team assembly; active list BOM-Hand-assembly.csv | Board-defined pin order; build/verify adapter to existing cable before power | Unspecified |  | Course stock requested; quantity not confirmed. Original course-list Amazon link is provenance only, not a team purchase source. | 2 | OPEN - course-stock allocation: please confirm how many of Requested_total the course can supply; request only the shortfall from DigiKey/Mouser. Requested_total includes proposed spares and is total demand, not confirmed stock or an additional buy quantity. Confirm the row/pin dimensions in Footprint for these generic headers.
2.54 mm breakaway header | FRONT RIGHT lamp | 1 | 0 | 1 | J551 | Connector_PinHeader_2.54mm:PinHeader_1x02_P2.54mm_Vertical | Course stock v3 only; confirm quantities and row/pin dimensions. Any new purchase must be DigiKey/Mouser; replacement MPN not selected. |  | Course/team assembly; active list BOM-Hand-assembly.csv | Board-defined pin order; build/verify adapter to existing cable before power | Unspecified |  | Course stock requested; quantity not confirmed. Original course-list Amazon link is provenance only, not a team purchase source. | 2 | OPEN - course-stock allocation: please confirm how many of Requested_total the course can supply; request only the shortfall from DigiKey/Mouser. Requested_total includes proposed spares and is total demand, not confirmed stock or an additional buy quantity. Confirm the row/pin dimensions in Footprint for these generic headers.
2.54 mm breakaway header | REAR LEFT lamp | 1 | 0 | 1 | J650 | Connector_PinHeader_2.54mm:PinHeader_1x02_P2.54mm_Vertical | Course stock v3 only; confirm quantities and row/pin dimensions. Any new purchase must be DigiKey/Mouser; replacement MPN not selected. |  | Course/team assembly; active list BOM-Hand-assembly.csv | Board-defined pin order; build/verify adapter to existing cable before power | Unspecified |  | Course stock requested; quantity not confirmed. Original course-list Amazon link is provenance only, not a team purchase source. | 2 | OPEN - course-stock allocation: please confirm how many of Requested_total the course can supply; request only the shortfall from DigiKey/Mouser. Requested_total includes proposed spares and is total demand, not confirmed stock or an additional buy quantity. Confirm the row/pin dimensions in Footprint for these generic headers.
2.54 mm breakaway header | REAR RIGHT lamp | 1 | 0 | 1 | J651 | Connector_PinHeader_2.54mm:PinHeader_1x02_P2.54mm_Vertical | Course stock v3 only; confirm quantities and row/pin dimensions. Any new purchase must be DigiKey/Mouser; replacement MPN not selected. |  | Course/team assembly; active list BOM-Hand-assembly.csv | Board-defined pin order; build/verify adapter to existing cable before power | Unspecified |  | Course stock requested; quantity not confirmed. Original course-list Amazon link is provenance only, not a team purchase source. | 2 | OPEN - course-stock allocation: please confirm how many of Requested_total the course can supply; request only the shortfall from DigiKey/Mouser. Requested_total includes proposed spares and is total demand, not confirmed stock or an additional buy quantity. Confirm the row/pin dimensions in Footprint for these generic headers.
SNT-100-BK-T-H | Handled 2.54mm jumper caps | 0 | 18 | 2 | Off-board | Off-board / mechanical | Additional purchase request; not ordered |  | Team mechanical / wiring | 12 isolation + 4 termination + 2 optional BOOT0 recovery caps; 2 spares. BOOT0 caps stored off-board during normal operation. Handle improves access. Reuse matching stock if available. | Samtec | https://www.digikey.com/en/products/detail/samtec-inc/SNT-100-BK-T-H/2345103 | Not on course v3 exact-MPN list; request purchase or documented stock equivalent; not ordered | 20
01025 | REFERENCE / HOLD: Tenergy charger for 11609 pack | 0 | 0 | 0 | Not placed yet | External charger compatible with the selected ten-cell NiMH pack | Reference only; do not purchase |  | Unverified | Permitted DigiKey/Mouser source not verified. Manufacturer-listed compatible charger; NiMH5-10cells; selectable1A/2A; negative-delta-V termination. Keyed correctly polarized harness adapter needed. Not ordered. | Tenergy | https://power.tenergy.com/tenergy-smart-universal-charger-for-nimh-nicd-battery-packs-6v-12v-ul/ | Not an active purchase request | 0
0297010.L | 10A MINI blade fuse: review candidate, not qualified | 0 | 2 | 2 | Off-board | Off-board / mechanical | Additional purchase request; not ordered |  | Team mechanical / wiring | Fits Keystone 3568. Candidate based on 5.22A nominal planning case / 7.47A low-input screening case, not handout 10A peak. See Parts-review.md. Actual inrush, all wiring/branch ratings and thermal coordination still required; not per-motor current limiting. Include one element in the new pack-side inline holder plus the PCB fuse. 10A remains a review candidate; no selective coordination or per-motor protection claimed. | Littelfuse | https://www.digikey.com/en/products/detail/littelfuse-inc/0297010-L/3305626 | Not on course v3 exact-MPN list; request purchase or documented stock equivalent; not ordered | 4
6396BG | L298 heatsink; hardware NOT included | 0 | 1 | 0 | HS80 | Lab4_Mechanical:Boyd_6396BG_StraightPins; installed in PCB | Course stock list v3, 2026-10-23 |  | Course heatsink accepted for October 24 review | October24 TA acceptance reported. October27 Boyd/ST drawing review specifies two solder anchors and M3 tab clamp with thermal grease. Footprint library checked; active PCB installation/rerouting and operating-temperature qualification remain open. See Heatsink-mounting-review.md. | Boyd Laconia | https://www.digikey.com/short/bw1zhdwb | Course v3 exact MPN; allocation unconfirmed; drawing-based mounting now specified | 1 | HS80 implemented on PCB: two soldered anchors plus M3 tab clamp. Drawing-based fit checked; assembly and thermal behavior untested. Confirm course allocation.
970350365 | M3 female/female nylon chassis spacer; 35mm body, 6mm AF | 0 | 4 | 1 | Off-board | Off-board / mechanical | Additional purchase request; not ordered |  | Team mechanical / wiring | 35mm gap; M3x0.5 threads, 10mm thread depth. Screws/washers listed separately. Smooth4.5mm chassis holes and nominal35mm/22mm stack reviewed in Mechanical-evidence.md; no repeat height measurement requested. Actual retention and full installed steering are assembly checks. | Wurth Elektronik | https://www.digikey.com/en/products/detail/w%C3%BCrth-elektronik/970350365/9488738 | DigiKey listing verified2026-10-24; quantity/lead time not reserved; physical fit untested | 5
M1269-2545-AL | M2.5 female/female aluminum Pi spacer; 22mm body, 4.5mm hex AF | 0 | 4 | 1 | Off-board | Off-board / mechanical | DigiKey purchase request; not ordered |  | Team mechanical / wiring | DigiKey-listed substitute. About5.20mm across corners within5.5mm maximum envelope; saved socket body leaves0.595mm nominal clearance at5.5mm OD. Min4.70mm thread depth; use5mm screws. Nominal22mm Pi gap/5.17mm engagement checked; mating/retention are assembly checks. The shortened Pi3-38 socket now meets the 3mm hole-edge rule; see Mounting-and-encoder-revision.md. | RAF Electronic Hardware | https://www.digikey.com/en/products/detail/raf-electronic-hardware/M1269-2545-AL/7680971 | DigiKey listing verified2026-10-24; quantity/lead time not reserved; physical fit untested | 5
CMP-AA-21-37 | Historical alternative: 12V 2.1Ah ten-AA NiMH pack | 0 | 0 | 0 | Off-board | Off-board / mechanical | Team candidate; specification confirmation required |  | Team mechanical / wiring | Historical candidate only; discharge rating and compatible charger unverified. No battery purchase selected. Do not order. | Dantona Industries | https://www.digikey.com/en/products/detail/dantona-industries/CMP-AA-21-37/19186159 | Not requested | 0
DF63-2S-3.96C | Battery/motor cable housings | 0 | 3 | 1 | Off-board | Off-board / mechanical | Team candidate; specification confirmation required |  | Team mechanical / wiring | One battery and two motor adapters. Exact mating family selected; pinout and actual cable continuity still require verification. | Hirose | https://www.digikey.com/en/products/detail/hirose-electric-co-ltd/DF63-2S-3-96C/4972157 | DigiKey listing verified2026-10-24; quantity/lead time not reserved; physical fit untested | 4
DF63A-1618SC | Battery/motor crimp contacts | 0 | 6 | 4 | Off-board | Off-board / mechanical | Team candidate; specification confirmation required |  | Team mechanical / wiring | Six installed contacts plus four spares. Selected 16AWG adapter wire; original motor/battery tails may need insulated gauge transitions. Match crimp tooling to terminal and insulation; do not force thin motor wires into a 16-18AWG crimp. | Hirose | https://www.digikey.com/en/products/detail/hirose-electric-co-ltd/DF63A-1618SC/14564650 | DigiKey listing verified2026-10-24; quantity/lead time not reserved; physical fit untested | 10
DF63-3S-3.96C | Servo adapter cable housing | 0 | 1 | 1 | Off-board | Off-board / mechanical | Team candidate; specification confirmation required |  | Team mechanical / wiring | Board-side mating family selected. J90:1GND/2sensed6.6V/3PWM. Servo-side lead/transition still unresolved under purchasing rule; see Parts-review.md. | Hirose | https://www.digikey.com/en/products/detail/hirose-electric-co-ltd/DF63-3S-3-96C/4972158 | DigiKey listing verified2026-10-24; quantity/lead time not reserved; physical fit untested | 2
DF63A-2022SC | Servo cable contacts / adapter harness | 0 | 3 | 3 | Off-board | Off-board / mechanical | Team candidate; specification confirmation required |  | Team mechanical / wiring | Three contacts+three spares, for20-22AWG adapter wire only. Existing servo wire gauge unverified; use an appropriate insulated transition if needed. Servo-side mate/current capability unresolved. | Hirose | https://www.digikey.com/en/products/detail/hirose-electric-co-ltd/DF63A-2022SC/14564655 | DigiKey listing verified2026-10-24; quantity/lead time not reserved; physical fit untested | 6
M20-1060400 | Encoder board-side 4-position 2.54mm cable housings | 0 | 2 | 1 | Off-board | Off-board / mechanical | Additional purchase request; not ordered |  | Team mechanical / wiring | J82/J83 pin 1=nominal4.0V, 2=GND, 3=A, 4=B. Unkeyed: mark pin1 and polarity. Vehicle end uses existing PH2.0-6 cable / course FIT0587 if physically matching. Do not infer motor-cable colors. | Harwin | https://www.digikey.com/en/products/detail/harwin-inc/M20-1060400/3728193 | Not on course v3 exact-MPN list; request purchase or documented stock equivalent; not ordered | 3
11609 | REFERENCE / HOLD: 12V 4.2Ah ten-Sub-C NiMH pack | 0 | 0 | 0 | Off-board | 115x44.4x46.76mm; cardboard envelope fit checked | Reference only; do not purchase |  | Team mechanical / wiring | TA17:44EDT reply allows Amazon for BATTERY ONLY; exact Amazon listing for11609 not verified. Tenergy direct source still needs a vendor exception. Manufacturer:30A continuous;0.4A standard/2A rapid charge;3-7 business-day build before shipping. Team24Oct cardboard115x50x50mm fits; reported height51.75mm. Final retention, lead route and keyed adapter unverified; not ordered. Later TA DMs accept proceeding with this design reference for tonight and allow somewhat longer delivery; they do not finalize an order. | Tenergy | https://power.tenergy.com/at-tenergy-12v-4200mah-nimh-rechargeable-battery-pack-10s1p-50-4wh-30a-rate/ | Not an active purchase request | 0
97790803111 | M3x8 nylon pan-head screws for chassis spacers | 0 | 8 | 2 | Off-board | Off-board / mechanical | DigiKey purchase request; not ordered |  | Team mechanical / wiring | 8 installed+2spares; one at each spacer end. About5.9mm top engagement with1.6mm PCB and0.5mm washer; spacer thread depth10mm. Check actual lower plate thickness and tightening. | Wurth Elektronik | https://www.digikey.com/en/products/detail/w%C3%BCrth-elektronik/97790803111/10056388 | DigiKey listing verified2026-10-24; quantity/lead time not reserved; physical fit untested | 10
MFW030A | M3 nylon washers; 3.2mm ID x7mm OD x0.5mm | 0 | 8 | 2 | Off-board | Off-board / mechanical | DigiKey purchase request; not ordered |  | Team mechanical / wiring | 8 installed+2spares; under screw heads. Bridges 4.0mm NPTH PCB holes and confirmed4.5mm smooth chassis holes; use washers at both ends. Does not add to35mm plate gap; check load retention. | Essentra Components | https://www.digikey.com/en/products/detail/essentra-components/MFW030A/4105389 | DigiKey listing verified2026-10-24; quantity/lead time not reserved; physical fit untested | 10
50M025045P005 | M2.5x5 nylon pan Phillips screws; 5mm head diameter | 0 | 8 | 2 | Off-board | Off-board / mechanical | DigiKey purchase request; not ordered |  | Team mechanical / wiring | 8 installed+2spares; two per Pi spacer. Approx3.4mm engagement through1.6mm board versus RAF min4.70mm thread depth; no spacing washers. Check actual fit and retention. | Essentra Components | https://www.digikey.com/en/products/detail/essentra-components/50M025045P005/11639454 | DigiKey listing verified2026-10-24; quantity/lead time not reserved; physical fit untested | 10
M20-1180046 | Encoder housing loose female crimp contacts; 22-30AWG | 0 | 8 | 4 | Off-board | Off-board / mechanical | Additional purchase request; not ordered |  | Team mechanical / wiring | Four contacts per encoder; four spares. For M20-1060400 and 0.64mm square header pins. Match actual wire insulation and verified crimp tooling. | Harwin | https://www.digikey.com/en/products/detail/harwin-inc/M20-1180046/3728125 | Not on course v3 exact-MPN list; request purchase or documented stock equivalent; not ordered | 12
FIT0587 | PH2.0-6 cable for motor/encoder adapter donor | 0 | 2 | 1 | Off-board | Off-board / mechanical | Course v3 stock / reuse existing; pickup quantities not confirmed |  | Team mechanical / wiring | Reuse two existing motor cables if suitable; otherwise obtain course-listed FIT0587 after latch/pinout check. These are donor cables, not an asserted pin-for-pin replacement. Required=2, spare=1; do not buy duplicate cables if supplied. | DFRobot | https://www.digikey.com/short/mz7mrwr2 | Specification selected; availability/fit not reserved or tested | 3 | OPEN - course-stock allocation: please confirm how many of Requested_total the course can supply; request only the shortfall from DigiKey/Mouser. Requested_total includes proposed spares and is total demand, not confirmed stock or an additional buy quantity.
2184 | REFERENCE / HOLD: Servo adapter donor: 300mm JR/Futaba extension; 22AWG | 0 | 0 | 0 | Off-board | Off-board / mechanical | Reference only; do not purchase |  | Team mechanical / wiring | Permitted DigiKey/Mouser source not verified. Retain male servo-mating end; replace the other end with DF63-3S-3.96C and DF63A-2022SC contacts. Verify installed servo plug/polarity. 22AWG and contact fit do not establish continuous 4A operation of the original servo plug. | Pololu | https://www.pololu.com/product/2184 | Not an active purchase request | 0
DF63A-2EP-3.96C | REFERENCE / HOLD: Charger adapter inline plug housing | 0 | 0 | 0 | Off-board | Off-board / mechanical | Reference only; do not purchase |  | Team mechanical / wiring | Dependent on unselected charger and actual lead size. Mates with battery DF63-2S-3.96C socket. Use 1=positive, 2=negative at the mating interface. Modify the charger-supplied clip-adapter tail, preserving its matching Tamiya end; verify actual wire size and polarity. | Hirose | https://www.hirose.com/en/product/p/CL0680-0535-5-00 | Not an active purchase request | 0
DF63-2022PC | REFERENCE / HOLD: Charger inline plug male contacts; 20-22AWG | 0 | 0 | 0 | Off-board | Off-board / mechanical | Reference only; do not purchase |  | Team mechanical / wiring | Dependent on unselected charger and actual lead size. For 2A charger tail only, NOT vehicle battery-current cable. Use specified 22AWG transition wire if supplied tail is another gauge; no oversize/undersize wire in this crimp. Physical tail gauge and crimp-tool access remain checks. | Hirose | https://www.digikey.com/en/products/detail/hirose-electric-co-ltd/DF63-2022PC/8561673 | Not an active purchase request | 0
3057 (red/black cut lengths) | 16AWG stranded UL1007 power wire; total metres, half red/half black | 0 | 4 | 2 | Off-board | Off-board / mechanical | Request lab cut lengths first; DigiKey spool listings are sourcing references, not spool purchase quantities. |  | Team mechanical / wiring | Request 3m red AND 3m black (2m planned +1m routing/spare each). DF63A-1618SC crimp range includes 16AWG. Exact installed length, temperature, bundling and fuse coordination still require verification. Do not buy full reels if lab can supply cut lengths. Linked RD005/BK005 listings are 100ft (30.5m) spools. Requested_total is metres, not spools. If lab cut lengths are unavailable, reconcile order units and cost before procurement. | Alpha Wire | https://www.digikey.com/en/products/detail/alpha-wire/3057-RD005/204432 ; https://www.digikey.com/en/products/detail/alpha-wire/3057-BK005/204430 | Specification selected; availability/fit not reserved or tested | 6
3051 (red/black cut lengths) | 22AWG stranded UL1007 charger wire; total metres, half red/half black | 0 | 0 | 0 | Off-board | Off-board / mechanical | Historical NiMH charger adapter; not required for selected LiPo harness |  | Team mechanical / wiring | Request 1m red AND 1m black. Use only for 1/2A charger adapter; actual length set by fit. Insulate and strain-relieve any transition splice. Not main battery wiring. Linked RD005/BK005 listings are 100ft (30.5m) spools. Requested_total is metres, not spools. If lab cut lengths are unavailable, reconcile order units and cost before procurement. | Alpha Wire | https://www.digikey.com/en/products/detail/alpha-wire/3051-RD005/204372 ; https://www.digikey.com/en/products/detail/alpha-wire/3051-BK005/204370 | Not an active purchase request | 0
WP7113ID | 5mm red vehicle LED: front-left | 0 | 1 | 1 | Off-board | Off-board / mechanical | Additional purchase request; not ordered |  | Team mechanical / wiring | One installed plus one color-matched spare. Replacement baseline; reuse existing LED only if its ratings/polarity are compatible. Existing 220R/5.1V transistor stage gives approximately 7-14mA with typical Vf; calculate/verify actual brightness. Not listed by exact MPN in course v3. | Kingbright | https://www.digikey.com/en/products/detail/kingbright/WP7113ID/1747663 | DigiKey listing verified2026-10-24; quantity/lead time not reserved; physical fit untested | 2
WP7113QWC/D | 5mm white vehicle LED: front-right | 0 | 1 | 1 | Off-board | Off-board / mechanical | Additional purchase request; not ordered |  | Team mechanical / wiring | One installed plus one color-matched spare. Replacement baseline; reuse existing LED only if its ratings/polarity are compatible. Existing 220R/5.1V transistor stage gives approximately 7-14mA with typical Vf; calculate/verify actual brightness. Not listed by exact MPN in course v3. | Kingbright | https://www.digikey.com/en/products/detail/kingbright/WP7113QWC-D/26231031 | DigiKey listing verified2026-10-24; quantity/lead time not reserved; physical fit untested | 2
WP7113YD | 5mm yellow vehicle LED: rear-left | 0 | 1 | 1 | Off-board | Off-board / mechanical | Additional purchase request; not ordered |  | Team mechanical / wiring | One installed plus one color-matched spare. Replacement baseline; reuse existing LED only if its ratings/polarity are compatible. Existing 220R/5.1V transistor stage gives approximately 7-14mA with typical Vf; calculate/verify actual brightness. Not listed by exact MPN in course v3. | Kingbright | https://www.digikey.com/en/products/detail/kingbright/WP7113YD/1747683 | DigiKey listing verified2026-10-24; quantity/lead time not reserved; physical fit untested | 2
WP7113QBC/D | 5mm blue vehicle LED: rear-right | 0 | 1 | 1 | Off-board | Off-board / mechanical | Additional purchase request; not ordered |  | Team mechanical / wiring | One installed plus one color-matched spare. Replacement baseline; reuse existing LED only if its ratings/polarity are compatible. Existing 220R/5.1V transistor stage gives approximately 7-14mA with typical Vf; calculate/verify actual brightness. Not listed by exact MPN in course v3. | Kingbright | https://www.digikey.com/en/products/detail/kingbright/WP7113QBC-D/2261460 | DigiKey listing verified2026-10-24; quantity/lead time not reserved; physical fit untested | 2
SPECIFIED: L298N-to-6396BG attachment | One mounting kit: M3 steel screw/nut/washers and thermal grease | 0 | 1 | 0 | Off-board | Off-board / mechanical | Course equivalent if available; DigiKey/Mouser references in Heatsink-mounting-review.md; not ordered |  | Team mechanical / wiring | One each: Keystone29314 M3x12 steel screw; Keystone4708 M3 nut; MFWZ003 flat washer; MLWZ003 split washer; thin MG860 grease or documented equivalent. No additional kit/spares counted. Assemble clamp before soldering per ST AN260. Drawing selection complete; PCB installation and physical fit/temperature untested. | Keystone / BFirst / MG Chemicals, or documented course equivalents | https://github.com/fmarples/18649_team4/blob/lab4/lab4/Heatsink-mounting-review.md | Course allocation unconfirmed. Washer listings have larger minimum order quantities; one kit is installed demand, not distributor pack quantity. No purchase placed. | 1 | OPEN - course-stock allocation only: can the course supply one specified kit or equivalent? Drawing-based mounting method is resolved. Buy any shortfall from the linked DigiKey/Mouser sources; do not order bulk packs without reconciling shared demand.
PROVISIONAL: Tenergy Amazon B077Y9HNTF | REFERENCE / HOLD: 12V 2000mAh NiMH pack; 2A maximum continuous discharge; unqualified review candidate | 0 | 0 | 0 | Off-board | External / mechanical | Superseded by selected 3S LiPo pair; reference only |  | Team mechanical / wiring | Historical October24 candidate. Replaced by CNHL S220403BK and Hitec44295. No NiMH pack/charger requested. | Tenergy | https://www.amazon.com/dp/B077Y9HNTF | Not an active purchase request; do not order | 0
UNRESOLVED: NiMH charger | REFERENCE / HOLD: One charger explicitly compatible with selected ten-cell pack | 0 | 0 | 0 | Off-board | External / mechanical | Superseded by selected 3S LiPo pair; reference only |  | Team mechanical / wiring | Historical October24 candidate. Replaced by CNHL S220403BK and Hitec44295. No NiMH pack/charger requested. | Unselected |  | Not an active purchase request; do not order | 0
UNRESOLVED: servo-side adapter lead | One servo adapter; SparkFun19224 candidate only; Hirose parts listed separately | 0 | 1 | 0 | Off-board | External / mechanical | DigiKey candidate1568-19224-ND; TA review exception; do not order |  | Team mechanical / wiring | Candidate SparkFun19224 / ROB-19224:170mm26AWG shrouded male servo lead; published drawing specifies2.54mm JR-FU. No contact/cable current rating found; not qualified for2.4-3A servo stall range. Conditional26-to22AWG transition needed for DF63A-2022SC; original servo lead stays intact. See Parts-review.md and Actuator-design.md. One adapter need, not an additional donor order; zero spares proposed. | Unselected; SparkFun candidate | https://www.digikey.com/en/products/detail/sparkfun-electronics/19224/16511100 | Candidate listing24Oct2026:19 available at$2.25; not reserved. Selection/current rating/fit unresolved; not ordered | 1 | OPEN - TA recommendation requested: which course-stock or DigiKey/Mouser male servo lead should we use for the LD-1501MG? SparkFun19224 is only a candidate; its contact/cable current rating is undocumented for the listed 2.4-3A stall range. Final selection and fit/polarity/continuity/voltage-drop/heating checks are required before powered use, not completed October24 measurements.
MCP1700-4002E/TO | MCP1700-4002E/TO | 1 | 0 | 1 | U82 | Package_TO_SOT_THT:TO-92_Inline_Wide | DigiKey; additional part request |  | Course/team assembly; active list BOM-Hand-assembly.csv | 4V encoder supply; 250mA rating; 40mA planning load; pin1 GND,2 input,3 output | Microchip Technology | https://www.digikey.com/en/products/detail/microchip-technology/MCP1700-4002E-TO/2614904 | 638 listed in stock 2026-10-27; not reserved | 2 | NEW October 27 encoder-supply revision: request listed total from DigiKey less any confirmed course allocation; not in the October 26 purchasing snapshot.
TPSB106K016R0800 | 10u 16V 10% low-ESR | 2 | 0 | 1 | C804 C805 | Capacitor_Tantalum_SMD:CP_EIA-3528-21_Kemet-B | DigiKey; additional part request |  | Course/team assembly; active list BOM-Hand-assembly.csv | Polarized 10uF/16V tantalum; 0.8ohm maximum ESR at100kHz/25C; pad1 positive; input/output bypass for U82 | KYOCERA AVX | https://www.digikey.com/en/products/detail/kyocera-avx/TPSB106K016R0800/678477 | 50064 listed in stock 2026-10-27; not reserved | 3 | NEW October 27 encoder-supply revision: request listed total from DigiKey less any confirmed course allocation; not in the October 26 purchasing snapshot.
RT0603BRD07100KL | 100k 0.1% battery divider | 1 | 0 | 1 | R580 | Resistor_SMD:R_0603_1608Metric | Design selected; not measured |  | Team solder / local reflow | Battery divider high side. 15V design ceiling; 0.1% ratio resistors. | YAGEO | https://www.digikey.com/en/products/detail/yageo/RT0603BRD07100KL/1072187 | DigiKey exact MPN; stock/delivery not reserved; not ordered | 2
S220403BK / Amazon B0DQP7SKGV | CNHL 3S 11.1V 2200mAh 40C shorty LiPo; one TWO-PACK listing | 0 | 1 | 0 | Off-board | 77x33x26mm nominal; +5mm dimensional allowance fits measured envelope | Amazon; Anson approved this pair Oct28; not ordered |  | Team mechanical / wiring | One lot contains TWO packs: one fitted, one spare. Never parallel or series-connect them. Manufacturer-listed40C continuous =88A advertised capability, not a vehicle current setting or our test. 12.6V full; XT60 and JST-XH balance lead. Amazon allowed for battery and charger per team28Oct confirmation. Use off-board3S balance charging and software undervoltage cutoff. See Battery-LiPo.md. Approval: https://18449-f26.slack.com/archives/D0C53Q3DN9X/p1793220604820219 Approval: https://18449-f26.slack.com/archives/D0C53Q3DN9X/p1793220604820219 | CNHL | https://www.amazon.com/dp/B0DQP7SKGV | Source documented; price/seller/delivery to check at purchase | 1 | APPROVED replacement pair Oct28. Confirm exact variant/seller/delivery and any existing order before purchasing. One requested unit is a TWO-PACK listing, not two listings.
44295 / HRC44295 | Hitec RDX1 Mini AC65W balance/storage charger | 0 | 1 | 0 | Off-board | External AC100-240V; 2-4S LiPo;0.1-6A | Amazon; Anson approved this pair Oct28; not ordered |  | Team mechanical / wiring | Selected for standard3S LiPo, balance charge2.2A maximum for this plan,4.20V/cell. AC cord included; main XT60 and balance leads both required. Do not assume supplied T-type lead mates. Use XT60 harness materials below; verify final polarity. Not NiMH or LiHV mode. Approval: https://18449-f26.slack.com/archives/D0C53Q3DN9X/p1793220604820219 Approval: https://18449-f26.slack.com/archives/D0C53Q3DN9X/p1793220604820219 | Hitec | https://www.amazon.com/dp/B07ZDKT6BD | Source documented; price/seller/delivery to check at purchase | 1 | APPROVED replacement pair Oct28. Confirm exact variant/seller/delivery and any existing order before purchasing. One charger; use standard 3S LiPo balance mode with the selected pack.
PRT-10474 / 10474 | XT60 male/female connector pairs for vehicle and charge harnesses | 0 | 3 | 0 | Off-board | Three pairs = six connector bodies; not three assembled leads | Selected design item; not ordered |  | Team mechanical / wiring | Reserve one mating end for the vehicle adapter and two for charger extension if needed; unused ends are spares. Assemble from16AWG stock with insulated joints. Match actual contact sex/keying at both ends; do not modify battery terminals or balance lead. Current capability and polarity must hold for complete harness; charging adapter is separate from vehicle adapter. | SparkFun | https://www.digikey.com/en/products/detail/sparkfun-electronics/10474/8258064 | Source documented; price/seller/delivery to check at purchase | 3
0FHM0001ZXJ | Pack-side MINI inline fuse holder with cover | 0 | 1 | 0 | Off-board | 14AWG prewired leads; MINI fuse;32VDC | Selected design item; not ordered |  | Team mechanical / wiring | Place in positive vehicle adapter near battery connector, before long cable. Transition14AWG holder leads to16AWG DF63 contacts using insulated splice; never force14AWG into16-18AWG crimp. Separate0297010.L10A candidate element. Complete fuse/wire/connector coordination remains open. Do not count the PCB fuse as protecting the upstream cable. | Littelfuse | https://www.digikey.com/en/products/detail/littelfuse-commercial-vehicle-products/0FHM0001ZXJ/2004060 | Source documented; price/seller/delivery to check at purchase | 1
Course LiPo charging bag | Fire-resistant LiPo charging bag required by handout | 0 | 1 | 0 | Off-board | Must close around one82x38x31mm pack allowance with charge leads exiting | Course-stock request; allocation and permitted fallback source unconfirmed |  | Team mechanical / wiring | Request a course-provided bag first. No source or stock availability is claimed. A bag does not make unattended charging safe. | Course stock |  | Unconfirmed course availability; no supplier link or stock claim | 1 | Can the course supply a suitable LiPo charging bag? If not, provide a permitted purchase source before charging.
GRM1885C1H680JA01D | 68p C0G | 1 | 0 | 1 | C414 | Capacitor_SMD:C_0603_1608Metric | DigiKey; additional sourcing |  | Course/team assembly; active list BOM-Hand-assembly.csv | Revised with capacitor banks: servo/Pi zero near 23kHz; logic follows TI 3.3V example. Within 10-100pF guidance. Transient/phase margin unmeasured. | Murata | https://www.digikey.com/en/products/detail/murata-electronics/GRM1885C1H680JA01D/586916 | Exact supplier listing checked 2026-10-28; stock not reserved | 2 | 1 fitted + 1 spare. Replaces 22pF at this reference; no footprint change. See Capacitor-bank-review.md.
GRM1885C1H910JA01D | 91p C0G | 1 | 0 | 1 | C424 | Capacitor_SMD:C_0603_1608Metric | DigiKey; additional sourcing |  | Course/team assembly; active list BOM-Hand-assembly.csv | Revised with capacitor banks: servo/Pi zero near 23kHz; logic follows TI 3.3V example. Within 10-100pF guidance. Transient/phase margin unmeasured. | Murata | https://www.digikey.com/en/products/detail/murata-electronics/GRM1885C1H910JA01D/586935 | Exact supplier listing checked 2026-10-28; stock not reserved | 2 | 1 fitted + 1 spare. Replaces 22pF at this reference; no footprint change. See Capacitor-bank-review.md.
GRM1885C1H300JA01D | 30p C0G | 1 | 0 | 1 | C434 | Capacitor_SMD:C_0603_1608Metric | DigiKey; additional sourcing |  | Course/team assembly; active list BOM-Hand-assembly.csv | Revised with capacitor banks: servo/Pi zero near 23kHz; logic follows TI 3.3V example. Within 10-100pF guidance. Transient/phase margin unmeasured. | Murata | https://www.digikey.com/en/products/detail/murata-electronics/GRM1885C1H300JA01D/587619 | Exact supplier listing checked 2026-10-28; stock not reserved | 2 | 1 fitted + 1 spare. Replaces 22pF at this reference; no footprint change. See Capacitor-bank-review.md.
