fmarples/18649_team4/lab4/review-package/BOM-JLC-format-REVIEW.csv

Comment | Designator | Footprint | LCSC Part # | Manufacturer Part Number | Quantity | Assembly Status | Course stock | Spare quantity
MCP2515T-I/ST | U10,U14,U20,U24,U30,U34 | Package_SO:TSSOP-20_4.4x6.5mm_P0.65mm | N/A | MCP2515T-I/ST | 6 | Team hand assembly; review only | Course v3 exact MPN | 1
SN65HVD231DR | U11,U15,U21,U25,U31,U35 | Package_SO:SOIC-8_3.9x4.9mm_P1.27mm | N/A | SN65HVD231DR | 6 | Team hand assembly; review only | Course v3 exact MPN | 1
16 MHz | Y10,Y14,Y20,Y24,Y30,Y34 | Crystal:Crystal_SMD_3225-4Pin_3.2x2.5mm | N/A | CX3225SB16000H0FLJCC | 6 | Team hand assembly; review only | Course v3 exact MPN | 1
18p C0G 50V | C100,C101,C140,C141,C200,C201,C240,C241,C300,C301,C340,C341 | Capacitor_SMD:C_0603_1608Metric | N/A | GRM1885C1H180JA01D | 12 | Team hand assembly; review only | Not in course v3 by exact MPN; additional sourcing | 1
10k | R100,R101,R140,R141,R200,R201,R240,R241,R300,R301,R340,R341,R3,R4,R6,R7,R400,R413,R423,R433,R804,R805,R806,R807 | Resistor_SMD:R_0603_1608Metric | N/A | CRCW060310K0FKEA | 24 | Team hand assembly; review only | Course v3 exact MPN | 2
100n | C102,C103,C104,C142,C143,C144,C202,C203,C204,C242,C243,C244,C302,C303,C304,C342,C343,C344,C1,C2,C3,C5,C6,C8,C701,C801,C803,C580 | Capacitor_SMD:C_0603_1608Metric | N/A | KGM15AR71C104KT | 28 | Team hand assembly; review only | Course v3 exact MPN | 3
CAN A isolation | J10,J20,J30 | Connector_PinHeader_2.54mm:PinHeader_2x02_P2.54mm_Vertical | N/A |  | 3 | Team hand assembly; review only | Course v3 generic header; verify row/pin dimensions | 1
CAN A test | J11,J21,J31 | Connector_PinHeader_2.54mm:PinHeader_1x04_P2.54mm_Vertical | N/A |  | 3 | Team hand assembly; review only | Course v3 generic header; verify row/pin dimensions | 1
TERM A | JP10,JP20 | Connector_PinHeader_2.54mm:PinHeader_1x02_P2.54mm_Vertical | N/A |  | 2 | Team hand assembly; review only | Course v3 generic header; verify row/pin dimensions | 1
120R | R102,R142,R202,R242 | Resistor_SMD:R_0603_1608Metric | N/A | RC0603FR-07120RL | 4 | Team hand assembly; review only | Course v3 exact MPN | 1
CAN B isolation | J14,J24,J34 | Connector_PinHeader_2.54mm:PinHeader_2x02_P2.54mm_Vertical | N/A |  | 3 | Team hand assembly; review only | Course v3 generic header; verify row/pin dimensions | 1
CAN B test | J15,J25,J35 | Connector_PinHeader_2.54mm:PinHeader_1x04_P2.54mm_Vertical | N/A |  | 3 | Team hand assembly; review only | Course v3 generic header; verify row/pin dimensions | 1
TERM B | JP14,JP24 | Connector_PinHeader_2.54mm:PinHeader_1x02_P2.54mm_Vertical | N/A |  | 2 | Team hand assembly; review only | Course v3 generic header; verify row/pin dimensions | 1
10mR / 1W / 1% | R1 | Lab4_Power:Vishay_WSL2512_7m_to_500m | N/A | WSL2512R0100FEA | 1 | Team hand assembly; review only | Additional purchase / exact candidate | 4
INA180A2IDBVR | U1 | Package_TO_SOT_SMD:SOT-23-5 | N/A | INA180A2IDBVR | 1 | Team hand assembly; review only | Additional purchase / exact candidate | 1
4.7k | R2 | Resistor_SMD:R_0603_1608Metric | N/A | RC0603FR-074K7L | 1 | Team hand assembly; review only | Course v3 exact MPN | 1
Sense test points | J1 | Connector_PinHeader_2.54mm:PinHeader_1x03_P2.54mm_Vertical | N/A |  | 1 | Team hand assembly; review only | Course v3 generic header; verify row/pin dimensions | 1
ACS712ELCTR-05B-T | U2,U3 | Package_SO:SOIC-8_3.9x4.9mm_P1.27mm | N/A | ACS712ELCTR-05B-T | 2 | Team hand assembly; review only | Course v3 exact MPN | 1
1n | C4,C7 | Capacitor_SMD:C_0603_1608Metric | N/A | GCM1885C2A102FA16D | 2 | Team hand assembly; review only | Course v3 exact MPN | 1
1k | R5,R8,R510,R511,R512,R513,R610,R611,R612,R613,R710,R711,R712,R713 | Resistor_SMD:R_0603_1608Metric | N/A | ERJ-3EKF1001V | 14 | Team hand assembly; review only | Course v3 exact MPN | 1
Current test | J2,J3 | Connector_PinHeader_2.54mm:PinHeader_1x04_P2.54mm_Vertical | N/A |  | 2 | Team hand assembly; review only | Course v3 generic header; verify row/pin dimensions | 1
Battery input: 1=+ 2=GND | J40 | Connector_Hirose:Hirose_DF63M-2P-3.96DSA_1x02_P3.96mm_Vertical | N/A | DF63M-2P-3.96DSA | 1 | Team hand assembly; review only | Not in course v3 by exact MPN; additional sourcing | 1
Fuse: rating TBD | F1 | Fuse:Fuseholder_Blade_Mini_Keystone_3568 | N/A | 3568 | 1 | Team hand assembly; review only | Not in course v3 by exact MPN; additional sourcing | 1
DMPH3010LK3-13 | Q1 | Package_TO_SOT_SMD:TO-252-2 | N/A | DMPH3010LK3-13 | 1 | Team hand assembly; review only | Not in course v3 by exact MPN; additional sourcing | 1
47k | R401,R412 | Resistor_SMD:R_0603_1608Metric | N/A | RC0603FR-0747KL | 2 | Team hand assembly; review only | Course v3 exact MPN | 1
12V gate clamp | D40 | Diode_SMD:D_SOD-123F | N/A | BZT52C12 | 1 | Team hand assembly; review only | Not in course v3 by exact MPN; additional sourcing | 1
1000u / 25V | C400 | Capacitor_THT:CP_Radial_D12.5mm_P5.00mm | N/A | UPW1E102MHD | 1 | Team hand assembly; review only | Not in course v3 by exact MPN; additional sourcing | 1
VBAT test | J41 | Connector_PinHeader_2.54mm:PinHeader_1x02_P2.54mm_Vertical | N/A |  | 1 | Team hand assembly; review only | Course v3 generic header; verify row/pin dimensions | 1
TPS564252DRLR | U40,U41,U42 | Package_TO_SOT_SMD:SOT-563 | N/A | TPS564252DRLR | 3 | Team hand assembly; review only | Course v3 exact MPN | 1
4.7uH / 5.8A | L1,L2,L3 | Lab4_Power:Eaton_SDCHA1V8040 | N/A | SDCHA1V8040-4R7-R | 3 | Team hand assembly; review only | Course v3 exact MPN | 1
22u 25V X5R 10%, input/output banks | C410,C412,C413,C415,C416,C417,C418,C420,C422,C423,C425,C426,C427,C430,C432,C433,C435,C436,C437 | Capacitor_SMD:C_1210_3225Metric | N/A | GRM32ER61E226KE15L | 19 | Team hand assembly; review only | Not in course v3 by exact MPN; additional sourcing | 4
100n / 50V | C411,C421,C431 | Capacitor_SMD:C_0603_1608Metric | N/A | GRM188R71H104KA93D | 3 | Team hand assembly; review only | Not in course v3 by exact MPN; additional sourcing | 1
100k 1% | R410 | Resistor_SMD:R_0603_1608Metric | N/A | RC0603FR-07100KL | 1 | Team hand assembly; review only | Not in course v3 by exact MPN; additional sourcing | 1
10k 1% | R411 | Resistor_SMD:R_0603_1608Metric | N/A | CRCW060310K0FKEA | 1 | Team hand assembly; review only | Course v3 exact MPN | 1
10k 0.1% | R431,R421,R581 | Resistor_SMD:R_0603_1608Metric | N/A | RT0603BRD0710KL | 3 | Team hand assembly; review only | Additional DigiKey purchase; 0.1% logic feedback divider | 2
10k PG pullup | R414,R424,R434 | Resistor_SMD:R_0603_1608Metric | N/A | CRCW060310K0FKEA | 3 | Team hand assembly; review only | Course v3 exact MPN | 1
Rail / PG / GND | J42,J43,J44 | Connector_PinHeader_2.54mm:PinHeader_1x03_P2.54mm_Vertical | N/A |  | 3 | Team hand assembly; review only | Course v3 generic header; verify row/pin dimensions | 1
75k 0.1% | R420 | Resistor_SMD:R_0603_1608Metric | N/A | RT0603BRD0775KL | 1 | Team hand assembly; review only | Not in course v3 by exact MPN; additional sourcing | 1
33k | R422 | Resistor_SMD:R_0603_1608Metric | N/A | RC0603FR-0733KL | 1 | Team hand assembly; review only | Not in course v3 by exact MPN; additional sourcing | 1
45.3k 0.1% | R430 | Resistor_SMD:R_0603_1608Metric | N/A | RT0603BRD0745K3L | 1 | Team hand assembly; review only | Additional DigiKey purchase; 0.1% logic feedback divider | 1
22k | R432 | Resistor_SMD:R_0603_1608Metric | N/A | RC0603FR-0722KL | 1 | Team hand assembly; review only | Not in course v3 by exact MPN; additional sourcing | 1
STM32F401RET6TR | U50,U60 | Package_QFP:LQFP-64_10x10mm_P0.5mm | N/A | STM32F401RET6TR | 2 | Team hand assembly; review only | Course v3 exact MPN | 1
100n VDD19 | C500,C600 | Capacitor_SMD:C_0603_1608Metric | N/A | KGM15AR71C104KT | 2 | Team hand assembly; review only | Course v3 exact MPN | 1
100n VDD32 | C501,C601 | Capacitor_SMD:C_0603_1608Metric | N/A | KGM15AR71C104KT | 2 | Team hand assembly; review only | Course v3 exact MPN | 1
100n VDD48 | C502,C602 | Capacitor_SMD:C_0603_1608Metric | N/A | KGM15AR71C104KT | 2 | Team hand assembly; review only | Course v3 exact MPN | 1
100n VDD64 | C503,C603 | Capacitor_SMD:C_0603_1608Metric | N/A | KGM15AR71C104KT | 2 | Team hand assembly; review only | Course v3 exact MPN | 1
100n VBAT | C504,C604 | Capacitor_SMD:C_0603_1608Metric | N/A | KGM15AR71C104KT | 2 | Team hand assembly; review only | Course v3 exact MPN | 1
4.7u VDD bulk | C505,C605 | Capacitor_SMD:C_0805_2012Metric | N/A | GRM21BR71C475KE51L | 2 | Team hand assembly; review only | Course v3 exact MPN | 1
4.7u VCAP1 | C506,C606 | Capacitor_SMD:C_0805_2012Metric | N/A | GRM21BR71C475KE51L | 2 | Team hand assembly; review only | Course v3 exact MPN | 1
600R @100MHz | FB50,FB60 | Inductor_SMD:L_0603_1608Metric | N/A | 742863160 | 2 | Team hand assembly; review only | Course v3 exact MPN | 1
100n VDDA | C507,C607 | Capacitor_SMD:C_0603_1608Metric | N/A | KGM15AR71C104KT | 2 | Team hand assembly; review only | Course v3 exact MPN | 1
1u VDDA | C508,C608 | Capacitor_SMD:C_0603_1608Metric | N/A | CC0603JRX7R7BB105 | 2 | Team hand assembly; review only | Not in course v3 by exact MPN; additional sourcing | 1
10k BOOT0 | R500,R600 | Resistor_SMD:R_0603_1608Metric | N/A | CRCW060310K0FKEA | 2 | Team hand assembly; review only | Course v3 exact MPN | 1
BOOT recovery | J500,J600 | Connector_PinHeader_2.54mm:PinHeader_1x02_P2.54mm_Vertical | N/A | 2.54 mm breakaway header | 2 | Team hand assembly; review only | Course v3 generic header; verify row/pin dimensions | 1
10k NRST | R501,R601 | Resistor_SMD:R_0603_1608Metric | N/A | CRCW060310K0FKEA | 2 | Team hand assembly; review only | Course v3 exact MPN | 1
100n NRST | C509,C609 | Capacitor_SMD:C_0603_1608Metric | N/A | KGM15AR71C104KT | 2 | Team hand assembly; review only | Course v3 exact MPN | 1
SWT0210-045026GSA | SW50,SW51,SW60,SW61,SW70 | Lab4_Switches:GCT_SWT0210_4.5x4.5mm | N/A | SWT0210-045026GSA | 5 | Team hand assembly; review only | Course v3 exact MPN | 1
SWD (2.54mm) | J501,J601 | Connector_PinHeader_2.54mm:PinHeader_1x06_P2.54mm_Vertical | N/A | 2.54 mm breakaway header | 2 | Team hand assembly; review only | Course v3 generic header; verify row/pin dimensions | 1
3.3V TTL UART | J502,J602 | Connector_PinHeader_2.54mm:PinHeader_1x03_P2.54mm_Vertical | N/A | 2.54 mm breakaway header | 2 | Team hand assembly; review only | Course v3 generic header; verify row/pin dimensions | 1
10k TEST pullup | R502,R602,R700 | Resistor_SMD:R_0603_1608Metric | N/A | CRCW060310K0FKEA | 3 | Team hand assembly; review only | Course v3 exact MPN | 1
100n TEST | C510,C610,C702 | Capacitor_SMD:C_0603_1608Metric | N/A | KGM15AR71C104KT | 3 | Team hand assembly; review only | Course v3 exact MPN | 1
STATUS green | D510,D610,D710 | LED_SMD:LED_0603_1608Metric | N/A | LTST-C190GKT | 3 | Team hand assembly; review only | Course v3 exact MPN | 1
ERR red | D511,D611,D711 | LED_SMD:LED_0603_1608Metric | N/A | LTST-C190KRKT | 3 | Team hand assembly; review only | Course v3 exact MPN | 1
DEG_A yellow | D512,D612,D712 | LED_SMD:LED_0603_1608Metric | N/A | LTST-C190KSKT | 3 | Team hand assembly; review only | Course v3 exact MPN | 1
DEG_B yellow | D513,D613,D713 | LED_SMD:LED_0603_1608Metric | N/A | LTST-C190KSKT | 3 | Team hand assembly; review only | Course v3 exact MPN | 1
LAB3 rows 1-13 | J503,J603,J703 | Connector_PinHeader_2.54mm:PinHeader_1x13_P2.54mm_Vertical | N/A | 2.54 mm breakaway header | 3 | Team hand assembly; review only | Course v3 generic header; verify row/pin dimensions | 1
Additional probes | J504 | Connector_PinHeader_2.54mm:PinHeader_1x08_P2.54mm_Vertical | N/A | 2.54 mm breakaway header | 1 | Team hand assembly; review only | Course v3 generic header; verify row/pin dimensions | 1
10k PWM pulldown | R530 | Resistor_SMD:R_0603_1608Metric | N/A | CRCW060310K0FKEA | 1 | Team hand assembly; review only | Course v3 exact MPN | 1
Additional probes | J604 | Connector_PinHeader_2.54mm:PinHeader_1x11_P2.54mm_Vertical | N/A | 2.54 mm breakaway header | 1 | Team hand assembly; review only | Course v3 generic header; verify row/pin dimensions | 1
10k boot pulldown | R630,R631,R632,R633,R634,R635 | Resistor_SMD:R_0603_1608Metric | N/A | CRCW060310K0FKEA | 6 | Team hand assembly; review only | Course v3 exact MPN | 1
Pi GPIO pins3-38 / ESQ-118-44-L-D | J70 | Lab4_Mechanical:Samtec_ESQ-118-44_2x18_PiPins3-38_H18.67 | N/A | ESQ-118-44-L-D | 1 | Team hand assembly; review only | Not in course v3 by exact MPN; additional sourcing | 1
22u /16V | C700 | Capacitor_SMD:C_0805_2012Metric | N/A | GRM219R61C226ME15L | 1 | Team hand assembly; review only | Course v3 exact MPN | 1
Pi extra probes | J704 | Connector_PinHeader_2.54mm:PinHeader_1x05_P2.54mm_Vertical | N/A | 2.54 mm breakaway header | 1 | Team hand assembly; review only | Course v3 generic header; verify row/pin dimensions | 1
Reserved / encoder probes | J505 | Connector_PinHeader_2.54mm:PinHeader_1x04_P2.54mm_Vertical | N/A | 2.54 mm breakaway header | 1 | Team hand assembly; review only | Course v3 generic header; verify row/pin dimensions | 1
Reserved / encoder probes | J605 | Connector_PinHeader_2.54mm:PinHeader_1x07_P2.54mm_Vertical | N/A | 2.54 mm breakaway header | 1 | Team hand assembly; review only | Course v3 generic header; verify row/pin dimensions | 1
L298N | U80 | Lab4_Power:ST_L298N_Multiwatt15V_D1.1 | N/A | L298N | 1 | Team hand assembly; review only | Course v3 exact MPN | 1
100n 50V | C800 | Capacitor_SMD:C_0603_1608Metric | N/A | GRM188R71H104KA93D | 1 | Team hand assembly; review only | Not in course v3 by exact MPN; additional sourcing | 1
470u 25V | C802 | Capacitor_THT:CP_Radial_D10.0mm_P5.00mm | N/A | EEU-FR1E471 | 1 | Team hand assembly; review only | Not in course v3 by exact MPN; additional sourcing | 1
SK520B | D800,D801,D802,D803,D804,D805,D806,D807 | Diode_SMD:D_SMB | N/A | SK520B | 8 | Team hand assembly; review only | Course v3 exact MPN | 1
LEFT motor | J80 | Connector_Hirose:Hirose_DF63M-2P-3.96DSA_1x02_P3.96mm_Vertical | N/A | DF63M-2P-3.96DSA | 1 | Team hand assembly; review only | Not in course v3 by exact MPN; additional sourcing | 1
RIGHT motor | J81 | Connector_Hirose:Hirose_DF63M-2P-3.96DSA_1x02_P3.96mm_Vertical | N/A | DF63M-2P-3.96DSA | 1 | Team hand assembly; review only | Not in course v3 by exact MPN; additional sourcing | 1
LEFT encoder | J82 | Connector_PinHeader_2.54mm:PinHeader_1x04_P2.54mm_Vertical | N/A | 2.54 mm breakaway header | 1 | Team hand assembly; review only | Course v3 generic header; verify row/pin dimensions | 1
100R | R800,R801,R802,R803,R540 | Resistor_SMD:R_0603_1608Metric | N/A | CRCW0603100RFKEA | 5 | Team hand assembly; review only | Not in course v3 by exact MPN; additional sourcing | 1
RIGHT encoder | J83 | Connector_PinHeader_2.54mm:PinHeader_1x04_P2.54mm_Vertical | N/A | 2.54 mm breakaway header | 1 | Team hand assembly; review only | Course v3 generic header; verify row/pin dimensions | 1
SN74LVC14APWR | U81 | Package_SO:TSSOP-14_4.4x5mm_P0.65mm | N/A | SN74LVC14APWR | 1 | Team hand assembly; review only | Additional purchase / exact candidate | 1
Servo: GND / 6.6V / PWM | J90 | Connector_Hirose:Hirose_DF63M-3P-3.96DSA_1x03_P3.96mm_Vertical | N/A | DF63M-3P-3.96DSA | 1 | Team hand assembly; review only | Not in course v3 by exact MPN; additional sourcing | 1
2.2k | R550,R551,R650,R651 | Resistor_SMD:R_0603_1608Metric | N/A | CRCW06032K20FKEA | 4 | Team hand assembly; review only | Not in course v3 by exact MPN; additional sourcing | 1
100k | R560,R561,R660,R661 | Resistor_SMD:R_0603_1608Metric | N/A | CRCW0603100KFKEA | 4 | Team hand assembly; review only | Not in course v3 by exact MPN; additional sourcing | 1
MMBT3904 | Q550,Q551,Q650,Q651 | Package_TO_SOT_SMD:SOT-23 | N/A | MMBT3904-7-F | 4 | Team hand assembly; review only | Not in course v3 by exact MPN; additional sourcing | 1
220R | R570,R571,R670,R671 | Resistor_SMD:R_0603_1608Metric | N/A | CRCW0603220RFKEA | 4 | Team hand assembly; review only | Not in course v3 by exact MPN; additional sourcing | 1
FRONT LEFT lamp | J550 | Connector_PinHeader_2.54mm:PinHeader_1x02_P2.54mm_Vertical | N/A | 2.54 mm breakaway header | 1 | Team hand assembly; review only | Course v3 generic header; verify row/pin dimensions | 1
FRONT RIGHT lamp | J551 | Connector_PinHeader_2.54mm:PinHeader_1x02_P2.54mm_Vertical | N/A | 2.54 mm breakaway header | 1 | Team hand assembly; review only | Course v3 generic header; verify row/pin dimensions | 1
REAR LEFT lamp | J650 | Connector_PinHeader_2.54mm:PinHeader_1x02_P2.54mm_Vertical | N/A | 2.54 mm breakaway header | 1 | Team hand assembly; review only | Course v3 generic header; verify row/pin dimensions | 1
REAR RIGHT lamp | J651 | Connector_PinHeader_2.54mm:PinHeader_1x02_P2.54mm_Vertical | N/A | 2.54 mm breakaway header | 1 | Team hand assembly; review only | Course v3 generic header; verify row/pin dimensions | 1
MCP1700-4002E/TO | U82 | Package_TO_SOT_THT:TO-92_Inline_Wide | N/A | MCP1700-4002E/TO | 1 | Team hand assembly; review only | Not in course v3 by exact MPN; request from DigiKey | 1
10u 16V 10% low-ESR | C804,C805 | Capacitor_Tantalum_SMD:CP_EIA-3528-21_Kemet-B | N/A | TPSB106K016R0800 | 2 | Team hand assembly; review only | Not in course v3 by exact MPN; request from DigiKey | 1
100k 0.1% | R580 | Resistor_SMD:R_0603_1608Metric | N/A | RT0603BRD07100KL | 1 | Team hand assembly; review only | Not in course v3; source through DigiKey | 1
68p C0G | C414 | Capacitor_SMD:C_0603_1608Metric | N/A | GRM1885C1H680JA01D | 1 | Team hand assembly; review only | Not on course v3 list by exact MPN | 1
91p C0G | C424 | Capacitor_SMD:C_0603_1608Metric | N/A | GRM1885C1H910JA01D | 1 | Team hand assembly; review only | Not on course v3 list by exact MPN | 1
30p C0G | C434 | Capacitor_SMD:C_0603_1608Metric | N/A | GRM1885C1H300JA01D | 1 | Team hand assembly; review only | Not on course v3 list by exact MPN | 1
