fmarples/18649_team4/doc/MOTOR_CHARACTERIZATION.md

# Motor startup, holding and PID measurements

## Use the simultaneous results

On 2026-09-27 the user changed the test requirement from separate motors to
**both motors driving forward together**, because that is the operating case.
The user confirmed raised wheels, 10 kHz PWM, 200 ms kicks, up to 4-second holds,
and the existing per-wheel motion guards. Units remain wheel RPM and ms/s.

The user also requested a one-command automated sweep and explicitly authorized
checked reflashing after expected no-progress faults. This supersedes the earlier
manual-only sequencing. Failed duties are not automatically retried. Reverse,
encoder, HAL or reset errors abort the batch. No software fault-clear command or
weaker guard was introduced.

These measurements use the same shared **12 V / 2 A supply**, L298N, wiring and
forward polarities documented in [HARDWARE.md](HARDWARE.md) and
[STM32_PINOUT.md](STM32_PINOUT.md). Wheels were unloaded and raised. No current,
temperature, rail transients or PWM waveform measurements were made.

## Full-duty measurement, 2026-09-27

The user requested a fresh direct count/time measurement at **100% duty**, using
only the validated **1320 counts/wheel revolution**. Exactly one BOTH-wheel
trial completed: the existing 60% / 200 ms kick, then 100% for four seconds.
No PID speed target was used. The late powered measurement window was MCU
**9745 to 10646 ms**, an elapsed **901 ms**; startup and coast are excluded.

| Wheel | Raw starting count | Raw ending count | Forward count change | RPM |
|---|---:|---:|---:|---:|
| Left | -20942 | -27227 | 6285 | 317.07 |
| Right | 20838 | 27104 | 6266 | 316.11 |
| Average | | | | **316.59** |

`Left RPM = 6285 * 60000 / (1320 * 901) = 317.07194`

`Right RPM = 6266 * 60000 / (1320 * 901) = 316.11341`

The late-window halves were 316.97/317.17 RPM on the left and
315.96/316.26 RPM on the right, supporting a nearly constant speed in this
window. This is a measured raised-wheel full-duty result for this setup,
not a motor rating, guaranteed loaded speed, or selected full-throttle PID
target. No gearbox-ratio calculation enters these results.

The run reported zero encoder invalid transitions, GPIO errors and firmware
faults. Both outputs returned to IDLE, duty zero, IN=0000 and EN=00. After
coasting, counts remained stationary for at least one second at
left=-33718, right=33727. Nothing restarted afterward. The board remains
flashed with the **60% startup / 100% HOLD / 4000 ms** diagnostic profile;
continuous PID behavior is unchanged and is not running.

Evidence, under `logs/motor-bench/`:

- `hold-both-100-20260927-065715.json`: raw serial records and count/time/RPM report.
- `full-duty-20260927-065706/summary.json`: successful flash/trial summary and image hash.
- The same directory's `flash.serial.log`, `pre-flash-idle.log`,
  `post-flash-idle.log`, and `trial.log`.
- `full-duty-verification/`: default/full-duty C controller tests, Python motor
  regressions and Nucleo build logs.
- `full-duty-20260927-065614/crash.txt`: first preparation stopped on a
  pre-existing board `FAIL.TXT`, before flashing or driving. Its cleanup
  verified live idle/rest telemetry. The subsequent authorized flash cleared
  that old error and its new runtime profile was verified before the one trial.

## Simultaneous startup

Each test starts both wheels from rest with the same duty, without a preceding
kick. Maximum powered time is 200 ms. Either wheel failing to advance four raw
counts within 150 ms stops both and latches its fault.

| Duty | Batch result |
|---|---|
| 60% | Both started, 1/1 |
| 55% | Both started, 3/3 |
| 50% | Neither established forward rotation, 0/1; left no-progress fault 1 stopped both |

**55% is the lowest tested simultaneous startup duty.** The observed transition
is above 50% and at or below 55%; 51–54% are untested. At 50%, the captured counts
moved only 1–3 counts before cutoff and returned to zero. Two preceding manual
simultaneous checks at 60% and 55% also passed, but are not included in batch counts.

Use **60% / 200 ms as a provisional startup kick** to leave margin. Three starts
are not a reliability qualification, and raised-wheel results do not prove loaded
startup or electrical safety.

## Simultaneous holding and speed

Every trial starts both motors with 60% for 200 ms, then switches both to the
listed duty for at most 4 seconds. The same no-progress/reversal guards remain
active across the transition; it does not reset their progress timers.

| Holding duty | Left RPM | Right RPM | Mean RPM | Result |
|---|---:|---:|---:|---|
| 55% | 92.9 | 100.1 | 96.5 | Completed 4 seconds, 1/1 |
| 50% | 64.5 | 74.0 | 69.3 | Completed 4 seconds, 1/1 |
| 45% | 40.7 | 47.6 | 44.1 | Completed 4 seconds, 1/1 |
| 40% | 19.3 | 26.7 | 23.0 | Completed 4 seconds, 3/3; speeds averaged over these three trials |
| 35% | Not a sustained-speed result | Not a sustained-speed result | Not applicable | Left stalled about 2.6 seconds into holding; fault 1 stopped both |

At 40%, individual final-window speeds were LEFT 19.7, 19.8 and 18.5 RPM,
RIGHT 25.9, 27.3 and 26.8 RPM. Both remained forward throughout each completed
hold. Some deceleration remained, especially on the left: first-half to second-half
late-window speed fell by roughly 4–10%. Do not extrapolate this to indefinite
operation or label it an exact steady-state speed.

**40% is the lowest tested duty that kept both motors moving through all three
4-second holds.** 35% failed the joint operating requirement; the cutoff prevents
inferring whether the right motor alone could have continued. 36–39% are untested.
For initial low-speed closed-loop work, 45% has more observed holding margin than
40%, but it is a starting point for testing, not a guaranteed operating floor.
These open-loop measurements did not use a velocity controller. A subsequent
bench PID implementation initially used this table for feedforward and provisional
gains; the [current plain PID](../bringup/motor_test/README.md#continuous-pid-speed-control)
no longer uses feedforward. The first powered
45 RPM test is recorded below. No throttle-to-target-speed mapping or Pi
integration is implemented.

### How speed was measured

The encoder reader timestamps the two raw counts using MCU uptime in milliseconds
under the encoder lock. The control thread publishes a coherent `SAMPLE` record
with applied duties, phase, stage, counts and fault. The console transmits these
at about 20 Hz without blocking the higher-priority cutoff loop.

Only samples in the final approximately one second of the powered HOLD stage are
used, after three seconds of settling for the 4-second trials. Actual windows in
the batch were 952–955 ms. Kick and coast-down samples are excluded. The encoder
sample immediately precedes output updates within the control iteration, so a
stage-boundary sample is not a scope measurement of the switching instant; late
windows are well away from that boundary.

`RPM = forward_count_delta * 60000 / (1320 * elapsed_ms)`

Negate LEFT raw deltas and retain RIGHT raw deltas, then average the two wheel
speeds. The validated **1320 x4 counts/wheel revolution** comes from
[ENCODER_SPEC.md](ENCODER_SPEC.md).
Host USB timestamps are diagnostic only and do not enter the speed calculation.

JSON also records peripheral m/s using the reported 75 mm wheel diameter. That
is not measured vehicle ground speed. The `settled_in_late_window` flag only checks
whether the two half-window RPM estimates differ by at most 10% or 1 RPM; it does
not establish steady state, thermal stability or long-term holding ability.

## Evidence and final state

The complete one-command run is:

`logs/motor-bench/sweep-20260927-044102/summary.json`

Its status is `COMPLETE`. It contains all 12 trial results and absolute paths to
the raw captures. The directory also holds each build/test log, flash capture,
preflight rest check and final stop verification. Relevant raw captures:

- Startup: `startup-both-60-20260927-044127.json`;
  `startup-both-55-20260927-044156.json`, `044255.json`, `044302.json` with the same
  prefix; failed `startup-both-50-20260927-044226.json`.
- Holding: `hold-both-55-20260927-044331.json`,
  `hold-both-50-20260927-044406.json`, `hold-both-45-20260927-044440.json`,
  `hold-both-40-20260927-044514.json`, `hold-both-35-20260927-044548.json`,
  and the two 40% confirmations ending `044622.json` and `044632.json`.

All captures are under ignored `logs/motor-bench/`, not committed evidence files.
Each completed trial ended with disabled outputs and stationary encoders. No
invalid transitions, GPIO errors, unexpected resets or reversal faults occurred
in this simultaneous batch. The two expected failures latched fault 1; the runner
verified rest before the user-authorized reflash.

The sweep's final image restored **startup 60% / 200 ms; holding 60% / 200 ms then
55% / 4000 ms**. That reflash was idle-checked only. Final telemetry reported
IDLE, stage OFF, both duties zero, both encoder counts zero, no fault/errors.
The app is still the independent bench diagnostic, not the Part 2 link app.

## First bounded PID trial

On 2026-09-27 the user requested full PID, reconfirmed securely raised wheels and
unchanged wiring/power, and authorized one flash plus one BOTH-wheel 45 RPM trial.
Interfaces were rediscovered as COM4 and D: / NOD_F401RE. Idle checks passed before
and after flashing. No pins, power setup, PWM frequency or motion guards changed.

That revision used average forward encoder RPM for PID, as Part 3.1 requires,
plus bounded proportional wheel balancing. It used actual MCU elapsed time and the
1320-count calibration. Initial gains are Kp=0.12, Ki=0.35, Kd=0.003 in duty-point
and RPM units; see the [controller details](../bringup/motor_test/README.md#continuous-pid-speed-control).
These are provisional gains, not a completed tuning study.

The single trial used a 60% / 200 ms startup kick, then at most 4000 ms of PID,
with each duty bounded to 0..60% and both wheels driving forward.

| Measurement | Left | Right | Average |
|---|---:|---:|---:|
| Target RPM | 45 | 45 | 45 |
| Raw-count RPM over the last powered 1000 ms | 42.45 | 45.73 | 44.09 |
| Second-half minus first-half speed, RPM | +0.72 | +1.46 | +1.09 |
| Mean commanded duty over the last approximately 1 second | 45.99% | 45.08% | 45.53% |

The checker returned `AT_TARGET`: each wheel was within the provisional +/-5 RPM
band, and half-window drift was less than 5 RPM. Both were still gaining a little
speed. This is one passing bounded run, **not proof of exact steady state,
repeatability, load rejection or long-term stability**. The proportional balance
correction reduces wheel mismatch but does not force identical individual RPM.

The last filtered controller report averaged 44.96 RPM. The table deliberately
uses the independent raw-count window instead. There were 84 PID telemetry
frames and 85 trial-stage samples including the first OFF record; the largest
sample gap was 59 ms. First observed KICK/PID/OFF timestamps were 5443/5643/9656 ms.
Their boundaries are serial telemetry observations, not scope-measured physical
PWM durations. Reported duty never exceeded 60%.

No encoder errors, reversal/stall faults, HAL errors or resets were reported.
Both outputs disabled, all six pin readbacks returned low, and final raw counts
became stationary at left -4217 / right +4510 with fault zero. A separate final
STOP/rest check confirmed the same state. No automatic retry or gain change
occurred during that trial; subsequent user-requested revisions are recorded below.

Persistent local evidence:

- `logs/motor-bench/pid-first-20260927-052513/summary.json`: image SHA-256,
  pre/post-flash checks, the one trial result and final STOP verification.
- The same directory's `analysis.json`, `trial.log`, `pre-flash-idle.log`,
  `post-flash-idle.log` and `final-stop.log`.
- `logs/motor-bench/pid-45-20260927-052521.json` and matching `.serial.log`: raw
  MCU telemetry and host events. Errors would also create `.crash.txt` and
  `.cleanup-crash.txt`; neither was needed for this successful run.

At the end of that first bounded trial, the image included PID plus startup
60% / 200 ms and holding 55% / 4000 ms profiles, and was idle and fault-free.
The subsequent continuous-mode revisions below supersede that PID configuration. The root
Part 2 link app remains unchanged. Other targets, target transitions, externally
applied load, ground operation and current/thermal margins remain untested.

## Earlier single-wheel investigation, not the operating-case table

Separate 4-second holds produced these final-window RPM estimates:

| Duty | Left | Right |
|---|---:|---:|
| 55% | 92.2 | 102.0 |
| 50% | 65.7 | 72.0 |
| 45% | 40.4 | 46.7 |
| 40% | 17.7 | 24.6 |

Initial 2-second tests overestimated some low-duty late speeds because the wheel
was still slowing. LEFT at 35% moved for two seconds but failed the longer test.
The first 4-second attempt tripped the reverse guard after a small backward count
change near rest, `hold-left-35-20260927-041433.json` and matching `.crash.txt`.
The user explicitly requested one repeat and watched it slow smoothly to a stop.
That repeat latched no-progress fault 1 after about 2.4 seconds,
`hold-left-35-20260927-041946.json`. Guards were not relaxed. RIGHT at 35% was not
tested separately. Later tests proceeded at 40% with the user's confirmation.

These are diagnostic history. Use the simultaneous table above for the requested
both-motors operating case, and do not pool separate-wheel trials into its repeat
counts. Wiring, current limits, loaded operation and long-term behavior still
require independent validation.

## Continuous PID decision and first load attempt

The user replaced the four-second cap with continuous PID and B1 stop, then
explicitly removed the PID stall/reversal cutoffs and 60% duty ceiling. The user
retained measured startup/sustaining thresholds: existing 60% / 200 ms kick, then
40..100% running duty. B1/STOP overrides the floor to zero. The current controller
is plain average-speed PID, with no feedforward or balancing correction. Earlier
PID results above used the earlier controller and are not validation of this revision.

The first continuous attempt still had the old motion guard. During the user's
manual-load experiment, the right wheel slowed and its commanded duty rose from
about 45% to 54.25%. Right encoder progress ceased and fault 2 stopped both, not
a duration timer. B1 telemetry remained released/unlatched. Outputs and rest
were verified at raw counts -4033/+3864. No automatic restart followed the fault.
Evidence: `logs/motor-bench/pid-45-20260927-053958.serial.log` and matching JSON/crash
reports. This demonstrated increasing PWM effort, not a measured torque/current.
The subsequent user requests caused the controller revision described above.

The revised plain PID image was flashed and idle-verified, then started at 45 RPM
on both wheels on 2026-09-27 at 05:51. After approximately 12 seconds it remained
RUNNING with fault zero, reporting filtered left/right speeds of 43.11/46.80 RPM,
average 44.95 RPM, and equal 45.47% duties. This confirms operation beyond the old
four-second cap; it is not a long-term/current/thermal qualification. The user
explicitly requested leaving it running until B1/STOP. No automatic stop was sent.
The background logger PID was 3008; its current status, including a later B1 stop,
is in `logs/motor-bench/continuous-20260927-055111/state.json`. Raw telemetry:
`logs/motor-bench/pid-45-20260927-055111.serial.log`. Flash/profile evidence:
`logs/motor-bench/continuous-flash-20260927-055105/summary.json`.

An earlier logger attempt failed before ARM due to a Windows state-file replace
lock. It never drove a motor. Its logs end in `053907`; the host now retries that
specific transient filesystem error, with a regression test.
