fmarples/18649_team4/lab4/Lab4-Circuits.pdf

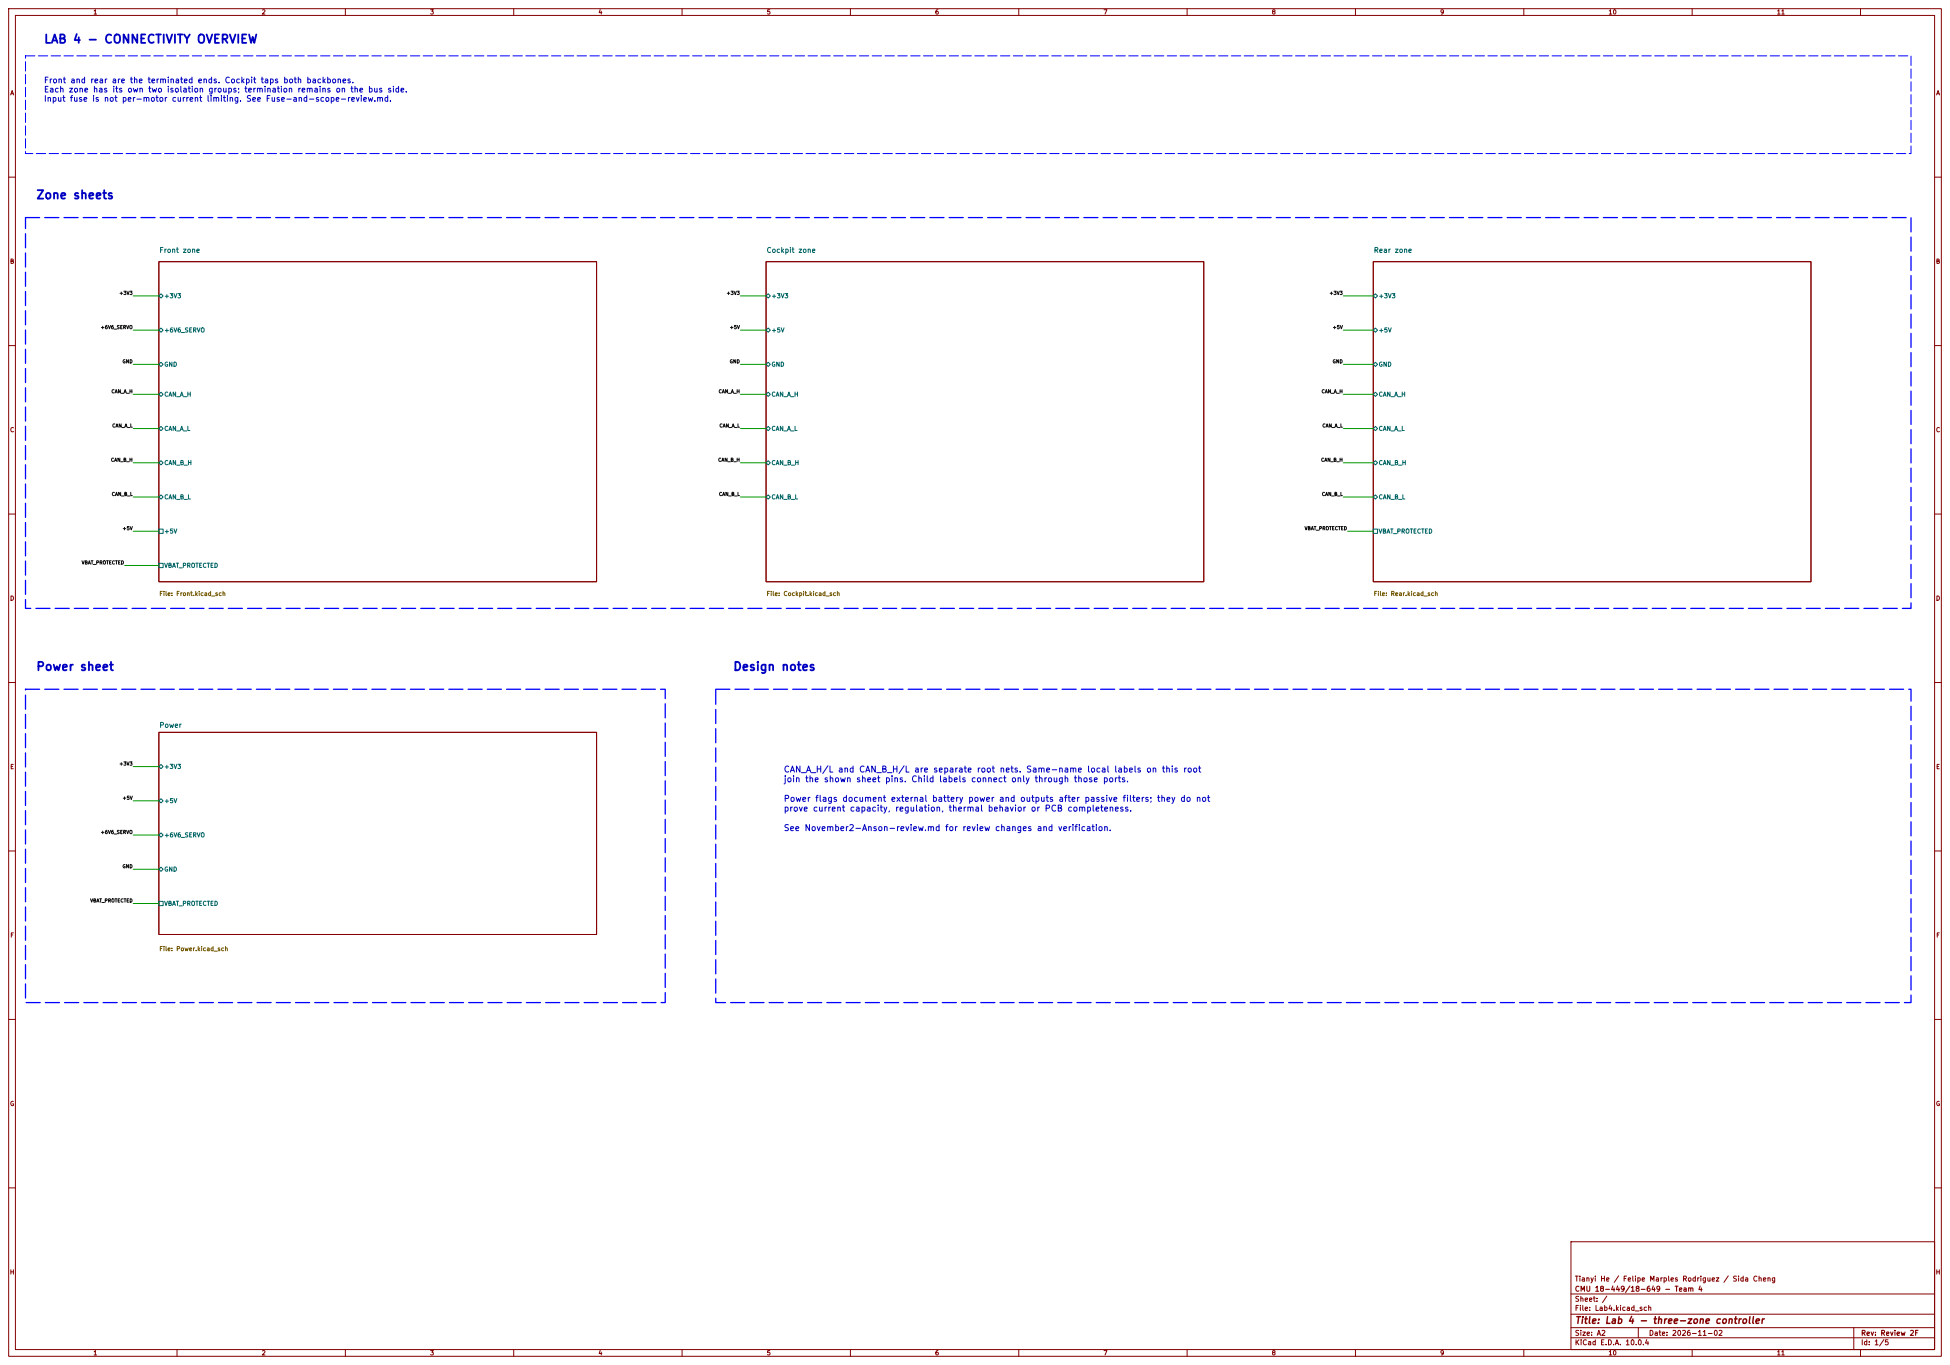
[picture p24: page 1]

Front and rear are the terminated ends. Cockpit taps both backbones.
Each zone has its own two isolation groups; termination remains on the bus side.
Input fuse is not per-motor current limiting. See Fuse-and-scope-review.md.

CAN_B_L VBAT_PROTECTED CAN_A_H/L and CAN_B_H/L are separate root nets. Same-name local labels on this root

join the shown sheet pins. Child labels connect only through those ports.

Power flags document external battery power and outputs after passive filters; they do not
prove current capacity, regulation, thermal behavior or PCB completeness.

See November2-Anson-review.md for review changes and verification.

Tianyi He / Felipe Marples Rodriguez / Sida Cheng
CMU 18-449/18-649 - Team 4
Sheet: /
File: Lab4.kicad_sch
Title: Lab 4 - three-zone controller

Size: A2 | Rev: Review 2F
KiCad E.D.A. 10.0.4 | Id: 1/5

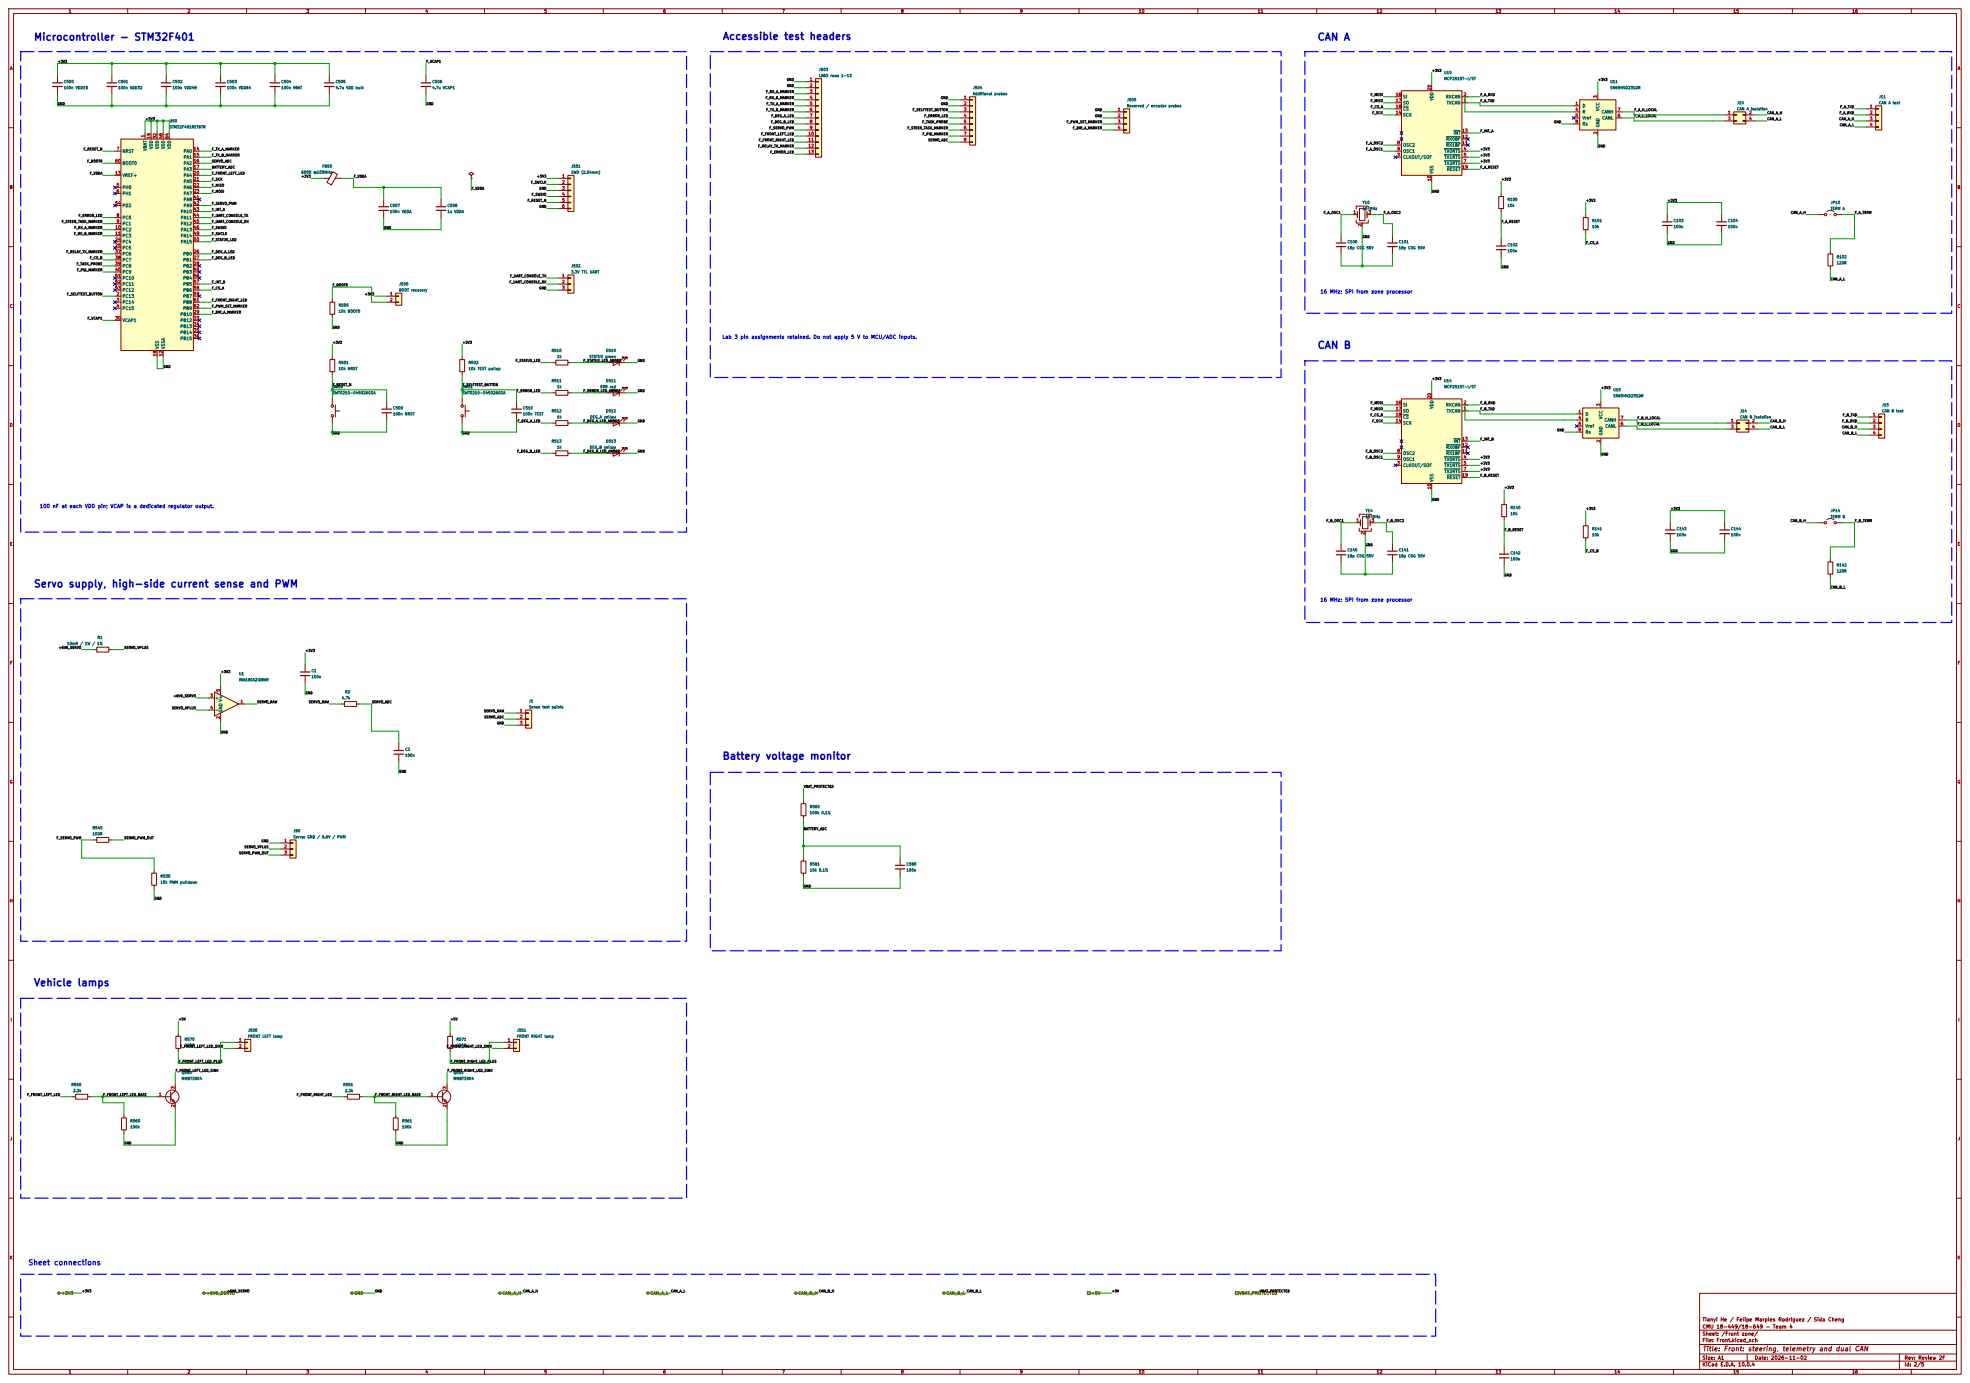
[picture p25: page 2]

16 MHz; SPI from zone processor

Lab 3 pin assignments retained. Do not apply 5 V to MCU/ADC inputs.

100 nF at each VDD pin; VCAP is a dedicated regulator output.

Servo supply, high-side current sense and PWM

Sheet: /Front zone/
File: Front.kicad_sch
Title: Front: steering, telemetry and dual CAN

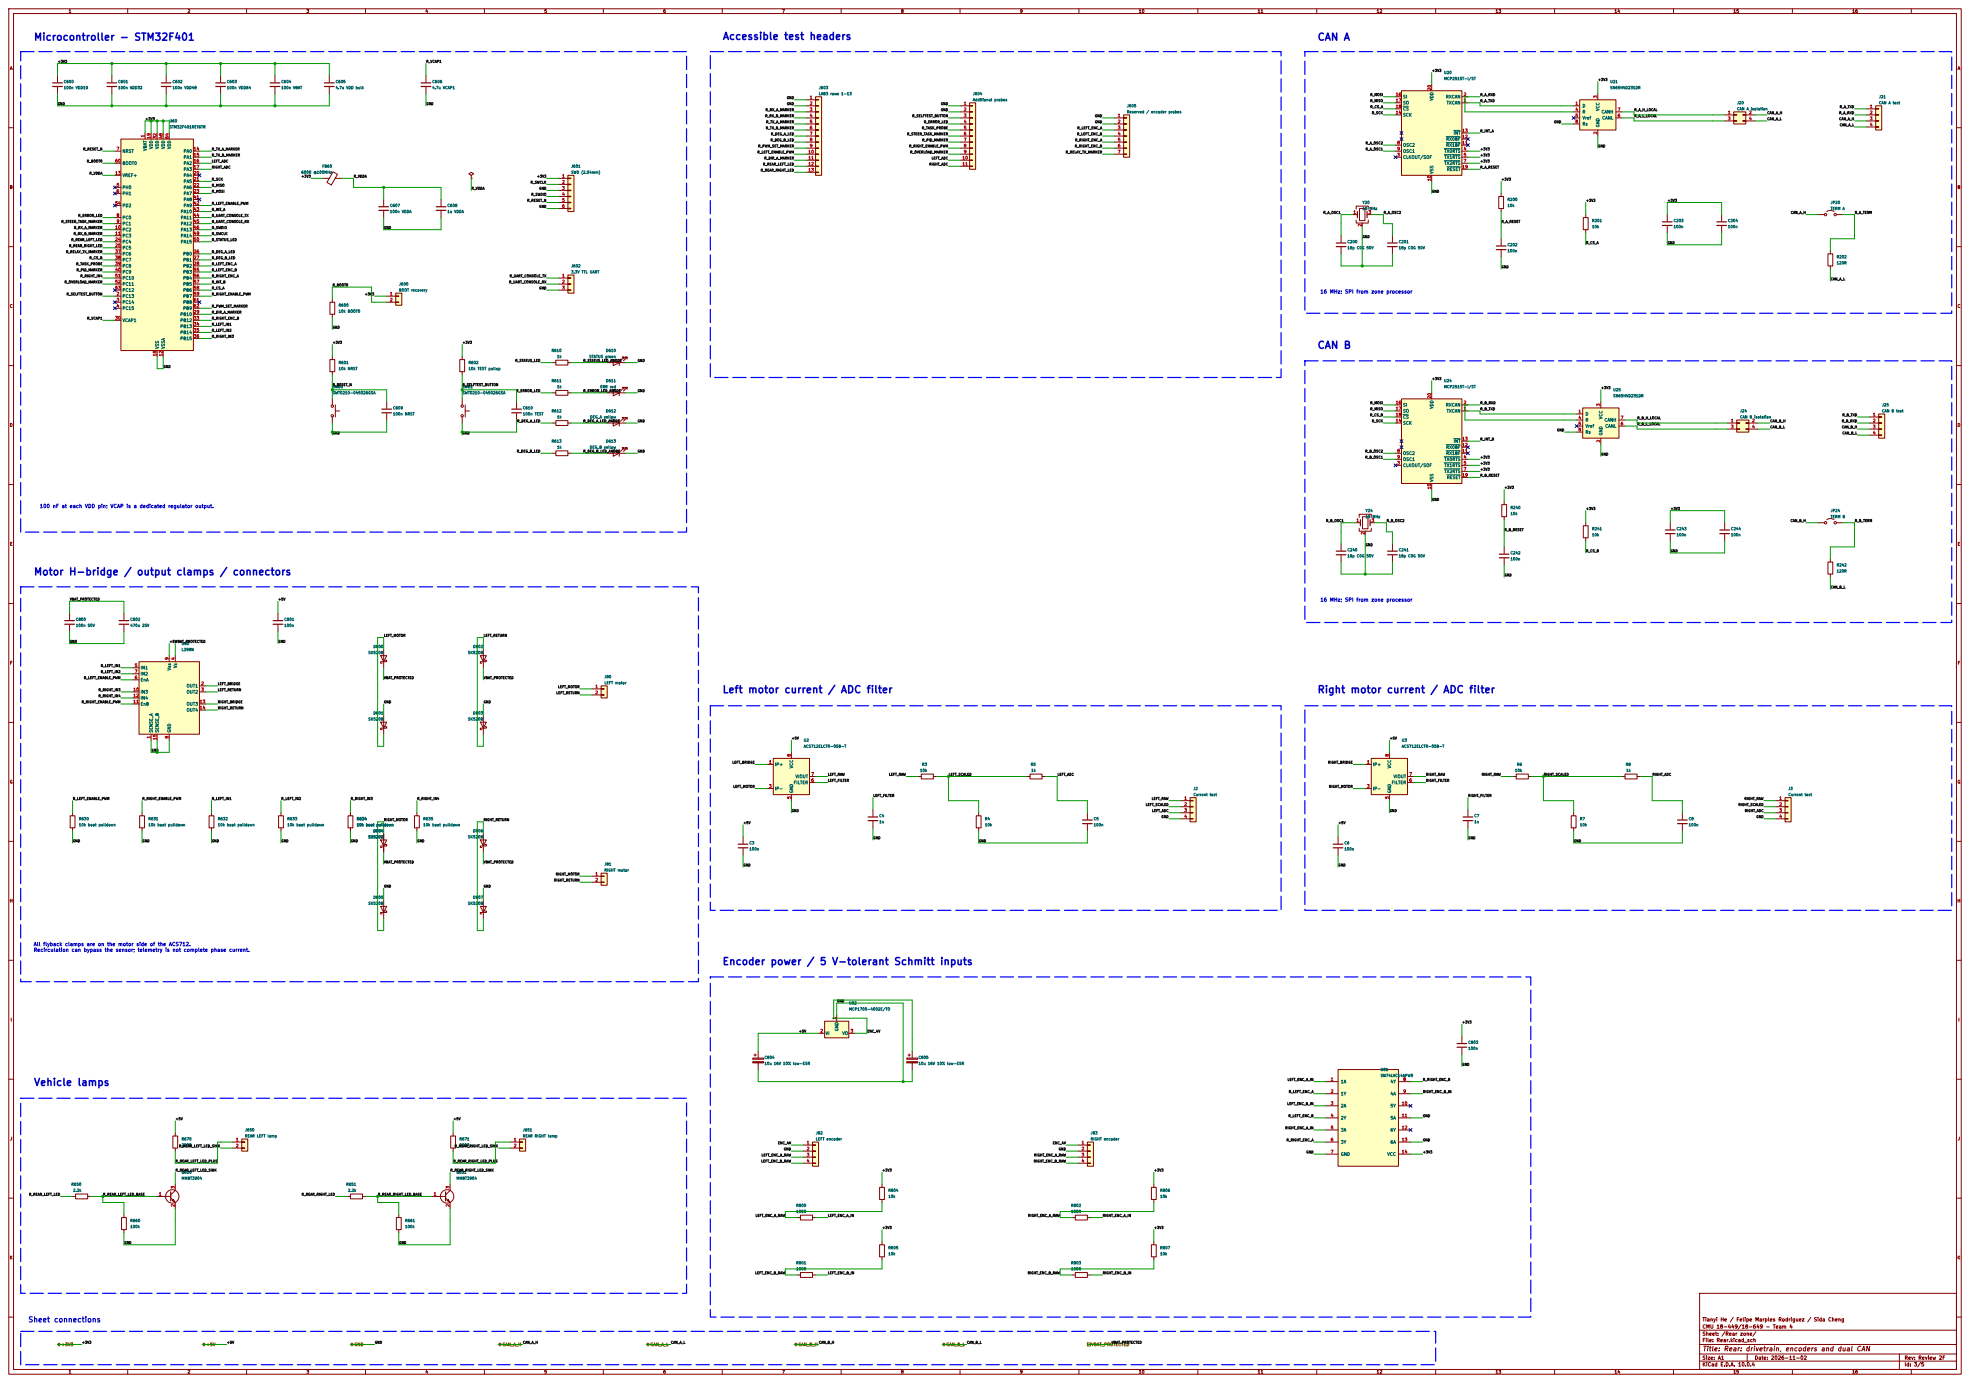
[picture p26: page 3]

16 MHz; SPI from zone processor

100 nF at each VDD pin; VCAP is a dedicated regulator output.

Motor H-bridge / output clamps / connectors

GND Right motor current / ADC filter

Left motor current / ADC filter

All flyback clamps are on the motor side of the ACS712.
Recirculation can bypass the sensor; telemetry is not complete phase current.

Encoder power / 5 V-tolerant Schmitt inputs

Sheet: /Rear zone/
File: Rear.kicad_sch
Title: Rear: drivetrain, encoders and dual CAN

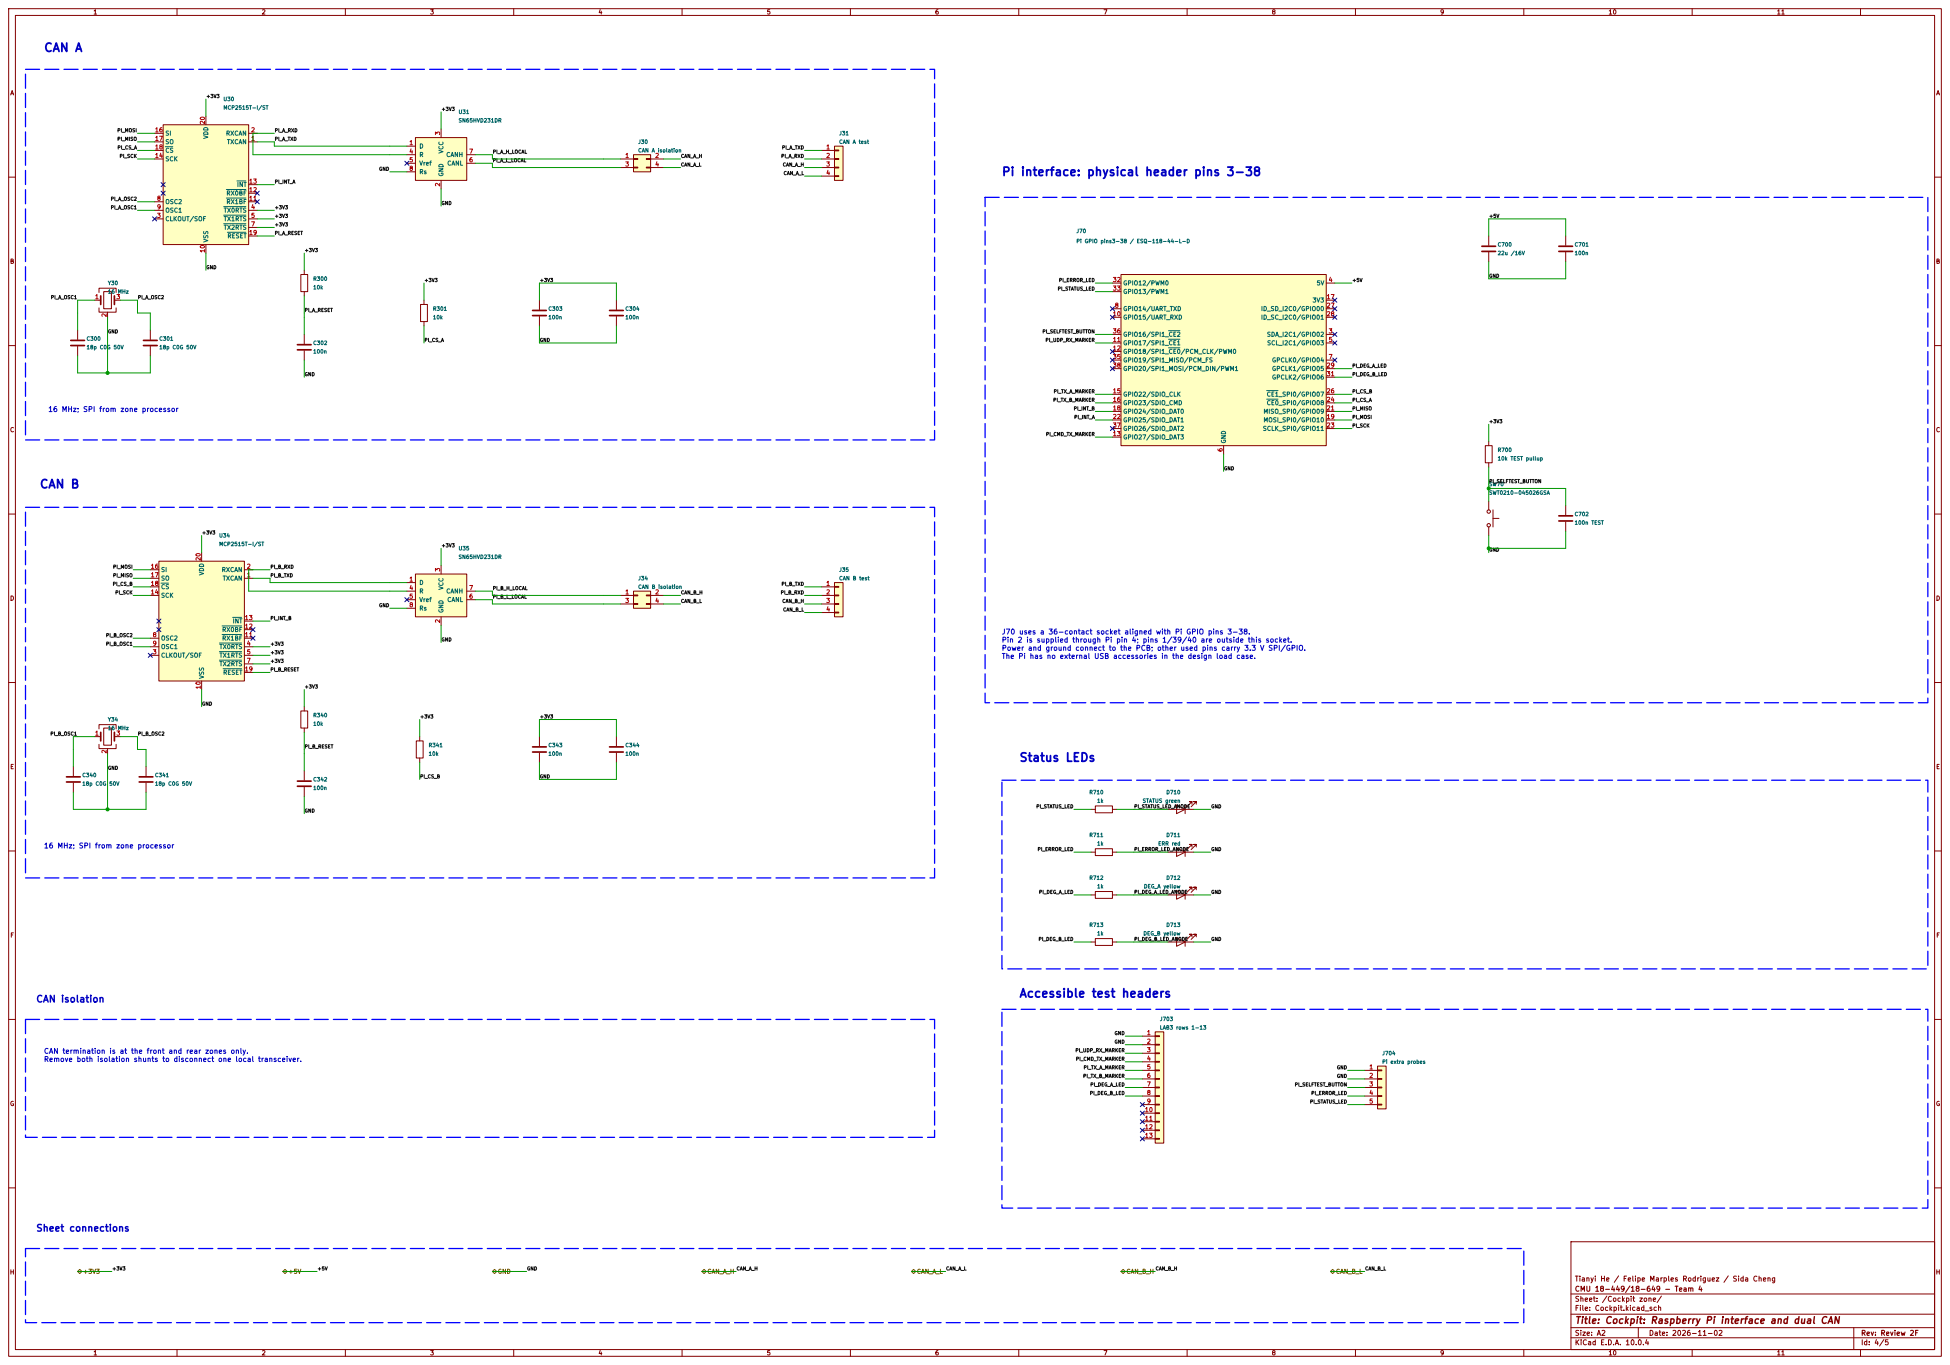
[picture p27: page 4]

16 MHz; SPI from zone processor

J70 uses a 36-contact socket aligned with Pi GPIO pins 3-38.
Pin 2 is supplied through Pi pin 4; pins 1/39/40 are outside this socket.
Power and ground connect to the PCB; other used pins carry 3.3 V SPI/GPIO.
The Pi has no external USB accessories in the design load case. Status LEDs

CAN termination is at the front and rear zones only.
Remove both isolation shunts to disconnect one local transceiver.

Sheet: /Cockpit zone/
File: Cockpit.kicad_sch
Title: Cockpit: Raspberry Pi interface and dual CAN

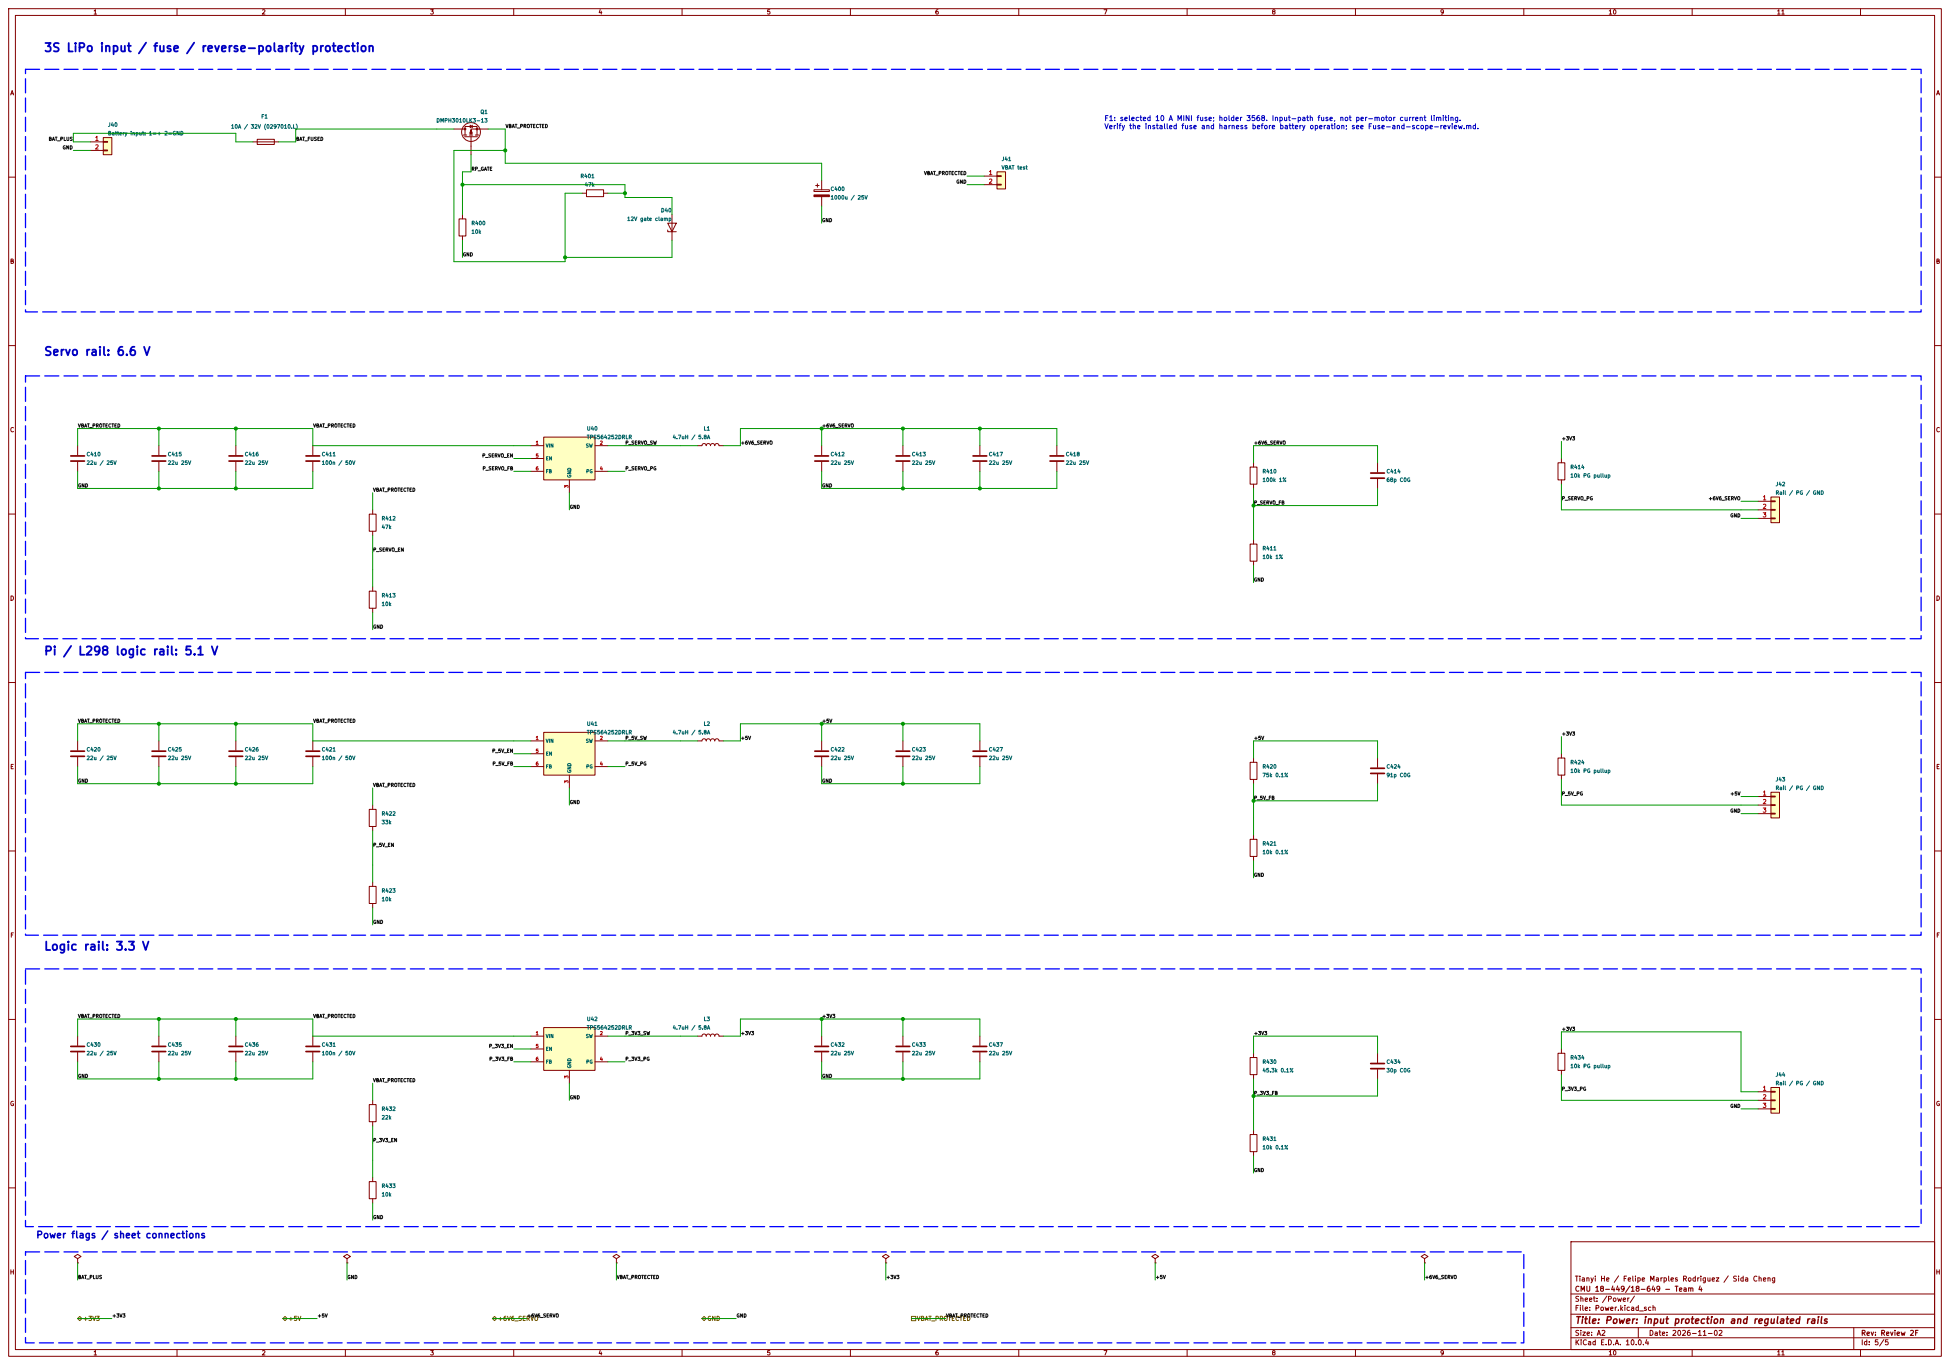
[picture p28: page 5]

3S LiPo input / fuse / reverse-polarity protection

F1: selected 10 A MINI fuse; holder 3568. Input-path fuse, not per-motor current limiting.
Verify the installed fuse and harness before battery operation; see Fuse-and-scope-review.md.

Power flags / sheet connections

Sheet: /Power/
File: Power.kicad_sch
Title: Power: input protection and regulated rails
