fmarples/18649_team4/lab4/review-package/Lab4-Circuits.pdf

1 | 2 | 3 | 4 | 5 | 6 | 7 | 8 | 9 | 10 | 11

AB

C

D

E

### FGH

AB

C

D

E

## FGH Date: 2026-11-02

Size: A2 | Rev: Review 2
KiCad E.D.A. 10.0.4 | Id: 1/5

# Title: Lab 4 - three-zone controller

## File: Lab4.kicad_sch

## Sheet: /

## Team 4

Electrical checks do not replace prototype testing.

Shared nets: two CAN backbones, power and ground only.

## Front zone

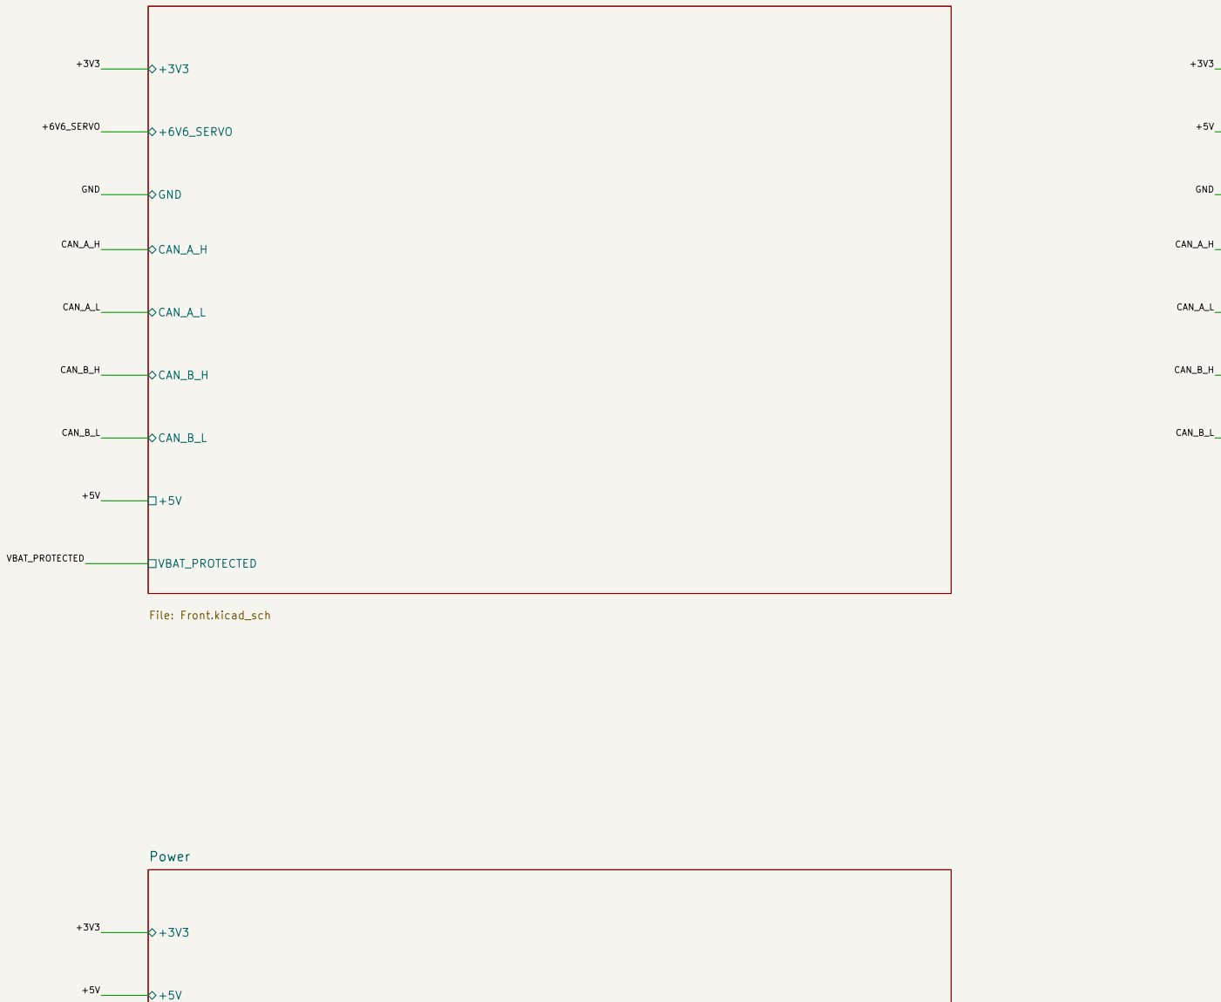
[picture p29: figure]
+3V3 +6V6_SERVO; GND; CAN_A_H; CAN_A_L CAN_B_H; CAN_B_L +5V; VBAT_PROTECTED; GND +3V3; CAN_B_L +5V +5V

# File: Front.kicad_sch +3V3 +5V +6V6_SERVO

### GND

# VBAT_PROTECTED Power File: Power.kicad_sch

# +3V3 +5V GND

### CAN_A_H

### CAN_A_L CAN_B_H

# CAN_B_L Cockpit zone

File: Cockpit.kicad_sch | +3V3 +5V GND

### CAN_A_H

### CAN_A_L CAN_B_H

# CAN_B_L VBAT_PROTECTED Rear zone

### File: Rear.kicad_sch

VBAT_PROTECTED

+6V6_SERVO

+6V6_SERVO

GND

CAN_B_L | VBAT_PROTECTED +3V3 +5V | +5V GND

CAN_A_H

CAN_A_L CAN_B_H

CAN_B_L

Front and rear are the terminated ends. Cockpit taps both backbones.
Each zone has its own two isolation groups; termination remains on the bus side. Input fuse is not per-motor current limiting. See Fuse-and-scope-review.md.

# LAB 4 - CONNECTIVITY OVERVIEW

## CAN_A_H/L and CAN_B_H/L are separate root nets. Same-name local labels on this root

join the shown sheet pins. Child labels connect only through those ports.

Power flags document external battery power and outputs after passive filters; they do not prove current capacity, regulation, thermal behavior or PCB completeness.

See November2-Anson-review.md for review changes and verification.

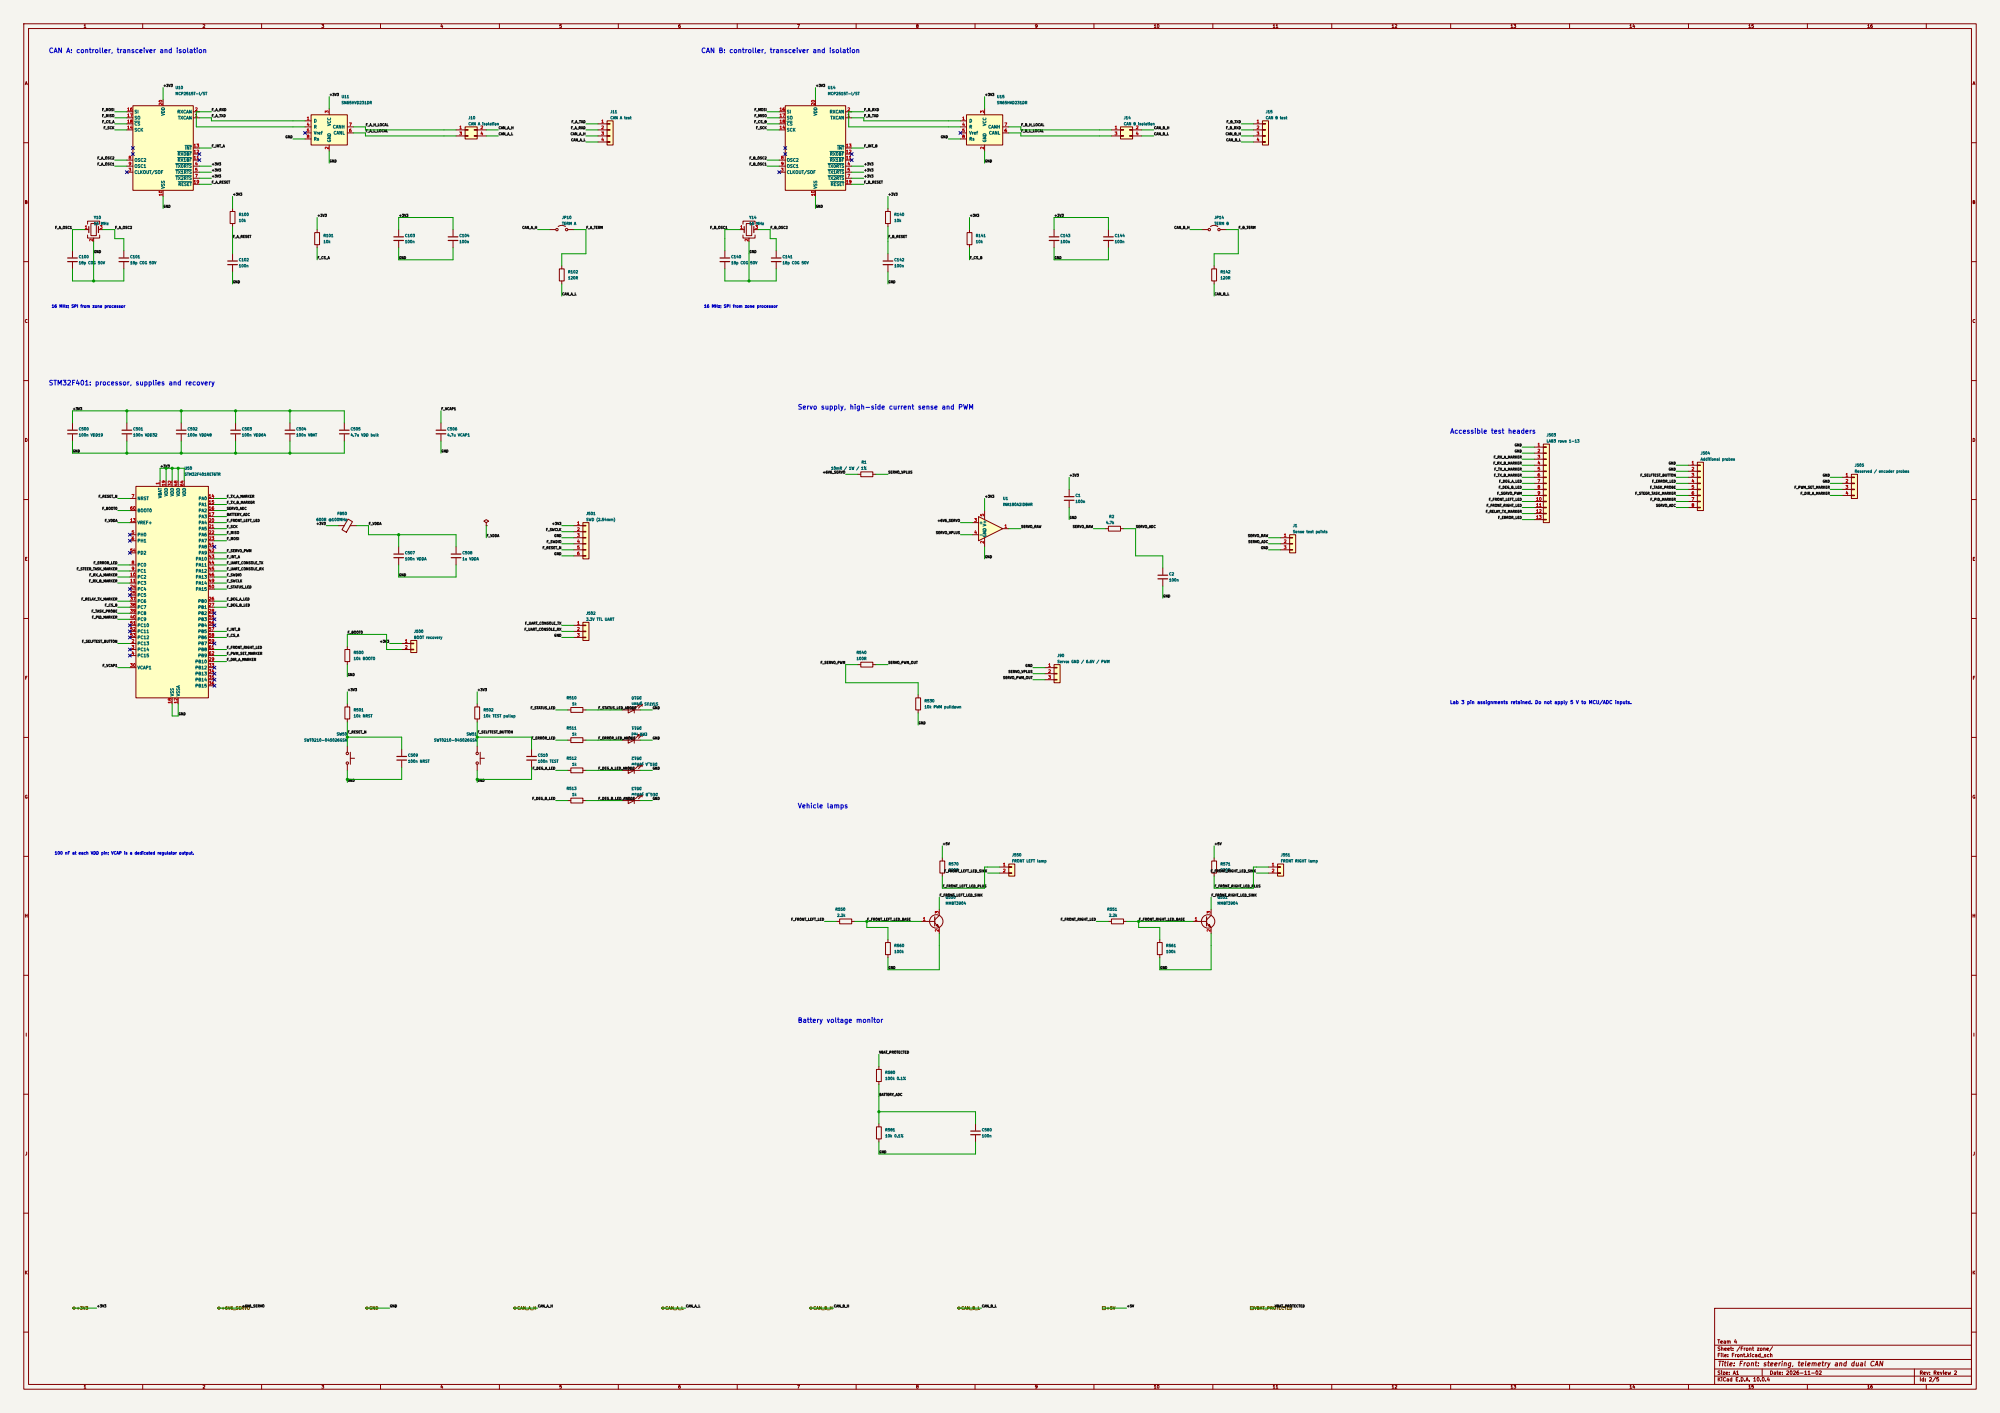
[picture p30: page 2]

16 MHz; SPI from zone processor

STM32F401: processor, supplies and recovery

Lab 3 pin assignments retained. Do not apply 5 V to MCU/ADC inputs.

100 nF at each VDD pin; VCAP is a dedicated regulator output.

Sheet: /Front zone/
File: Front.kicad_sch
Title: Front: steering, telemetry and dual CAN

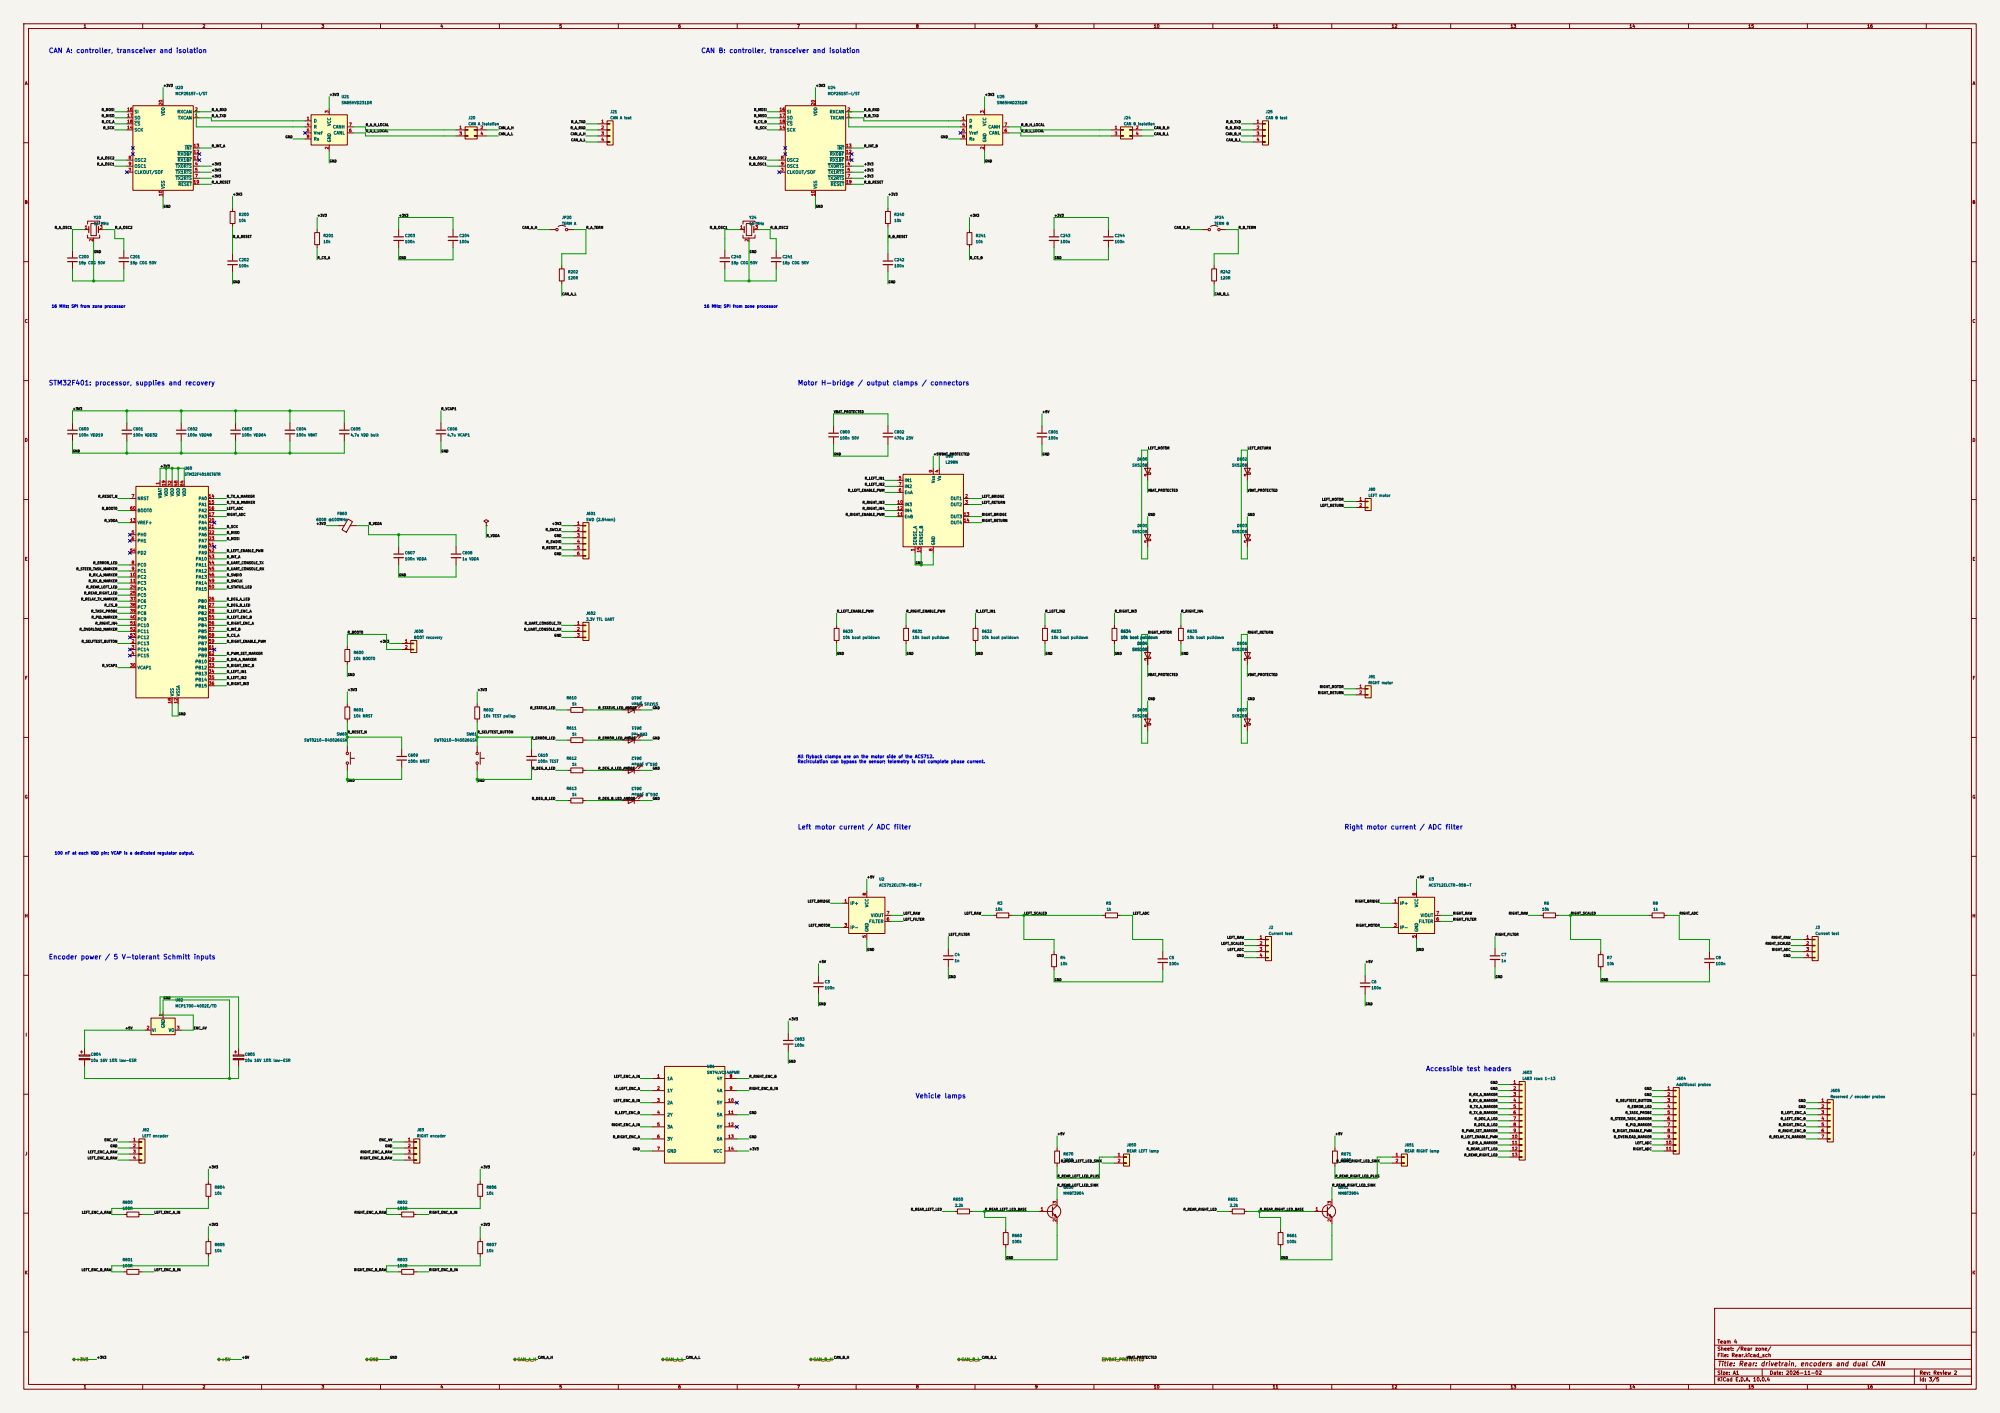
[picture p31: page 3]

CAN A: controller, transceiver and isolation

CAN B: controller, transceiver and isolation
U24 MCP2515T-I/ST C241

16 MHz; SPI from zone processor

All flyback clamps are on the motor side of the ACS712. Recirculation can bypass the sensor; telemetry is not complete phase current.

Left motor current / ADC filter

Right motor current / ADC filter

100 nF at each VDD pin; VCAP is a dedicated regulator output.

Encoder power / 5 V-tolerant Schmitt inputs

Sheet: /Rear zone/
File: Rear.kicad_sch
Title: Rear: drivetrain, encoders and dual CAN

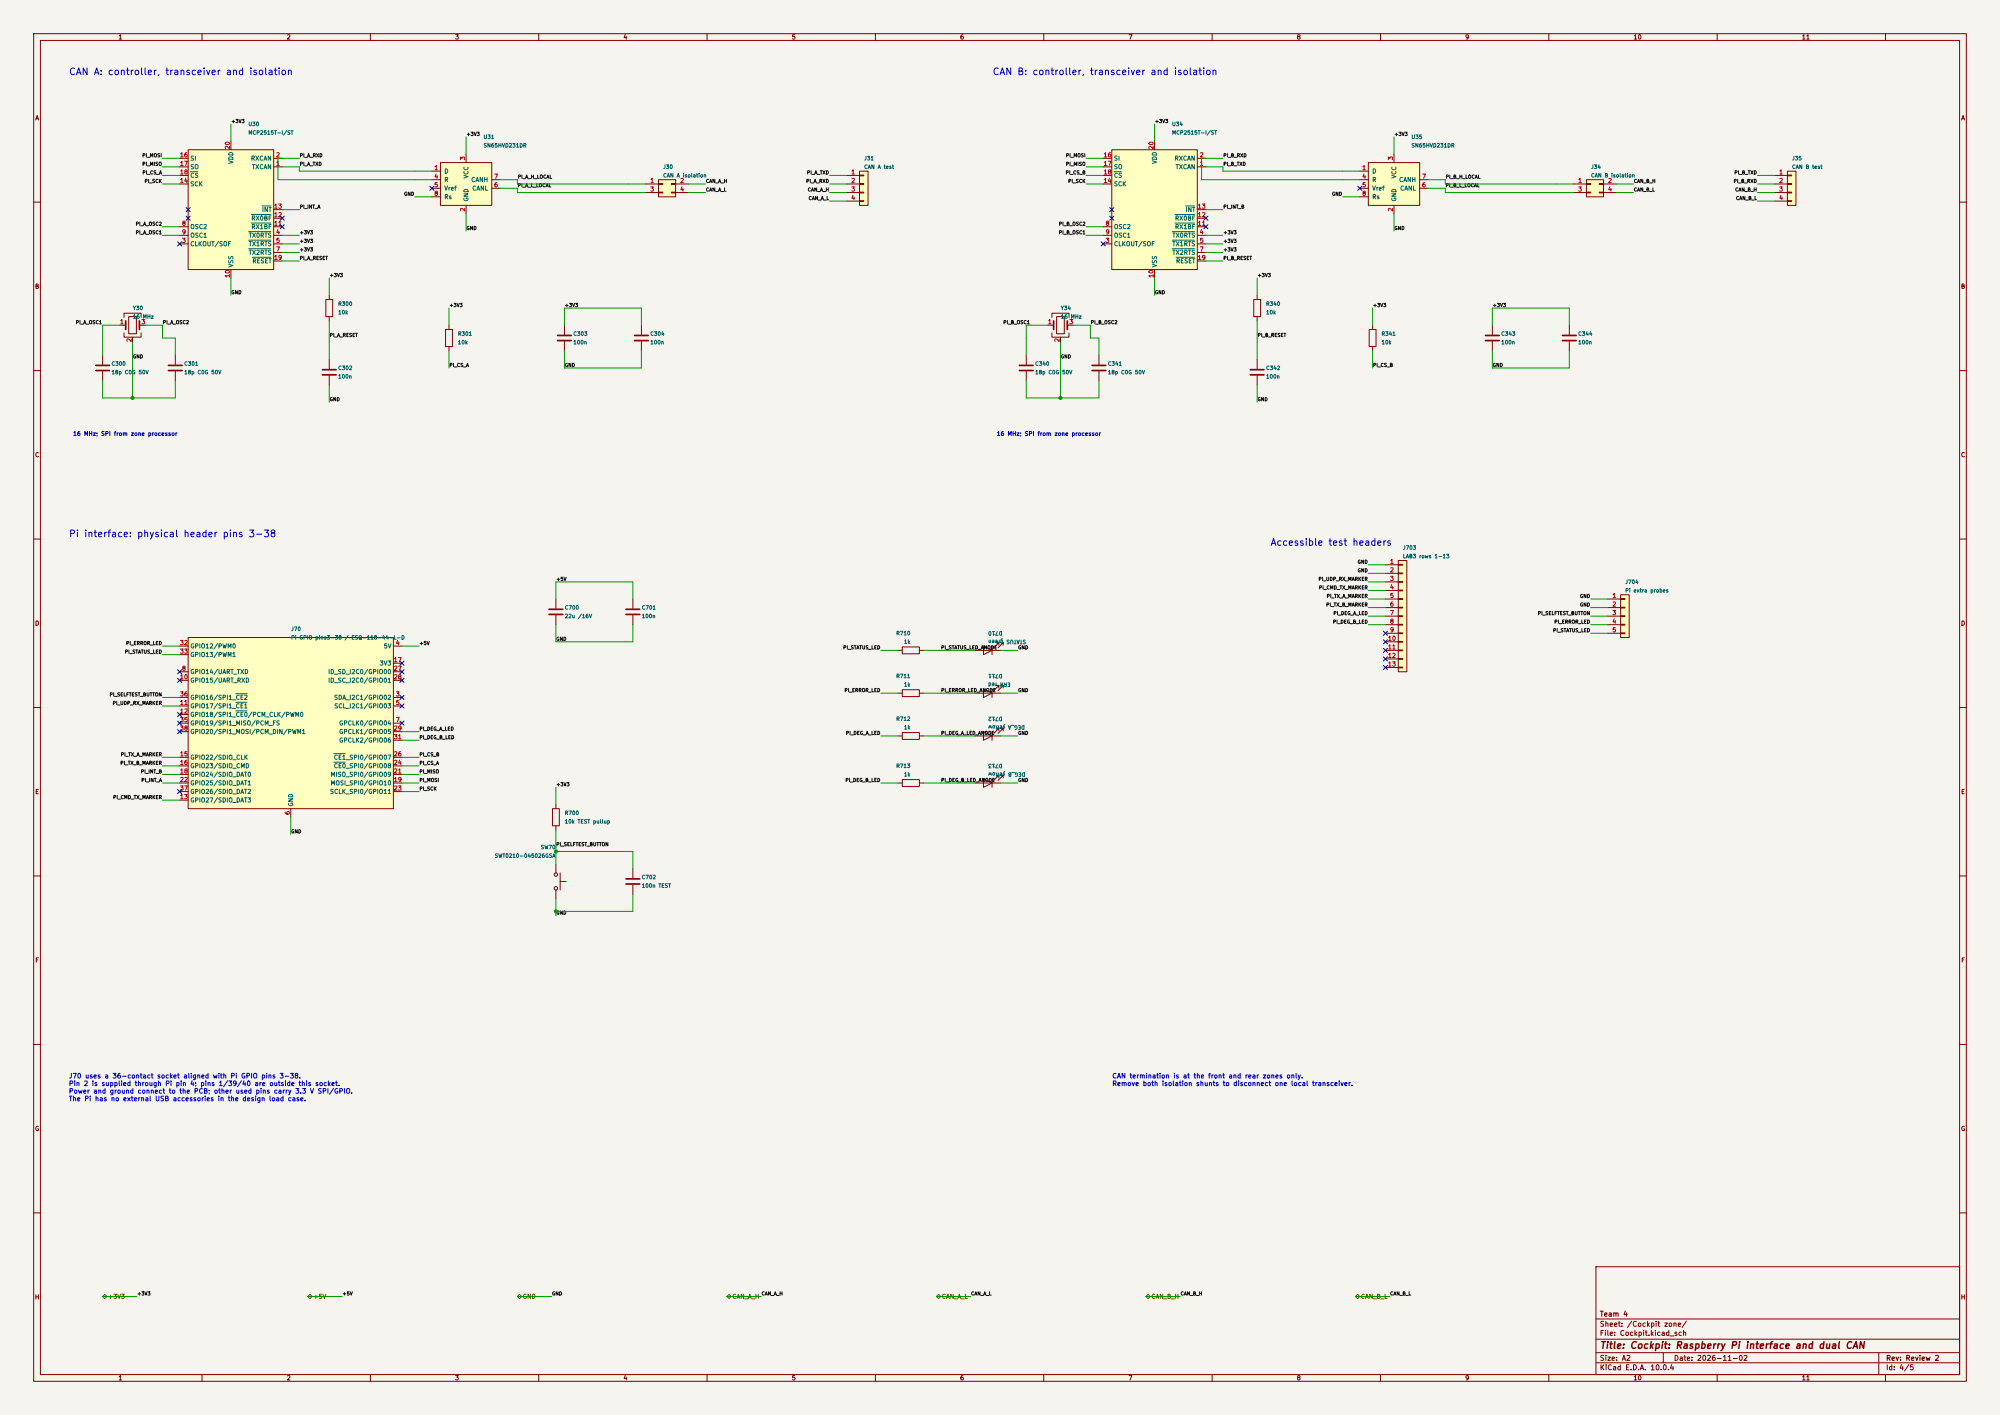
[picture p32: page 4]

PI_B_RESET +3V3 CAN A: controller, transceiver and isolation

Pi interface: physical header pins 3-38

J70 uses a 36-contact socket aligned with Pi GPIO pins 3-38. Pin 2 is supplied through Pi pin 4; pins 1/39/40 are outside this socket. Power and ground connect to the PCB; other used pins carry 3.3 V SPI/GPIO. The Pi has no external USB accessories in the design load case.

CAN termination is at the front and rear zones only. Remove both isolation shunts to disconnect one local transceiver.

Sheet: /Cockpit zone/
File: Cockpit.kicad_sch
Title: Cockpit: Raspberry Pi interface and dual CAN

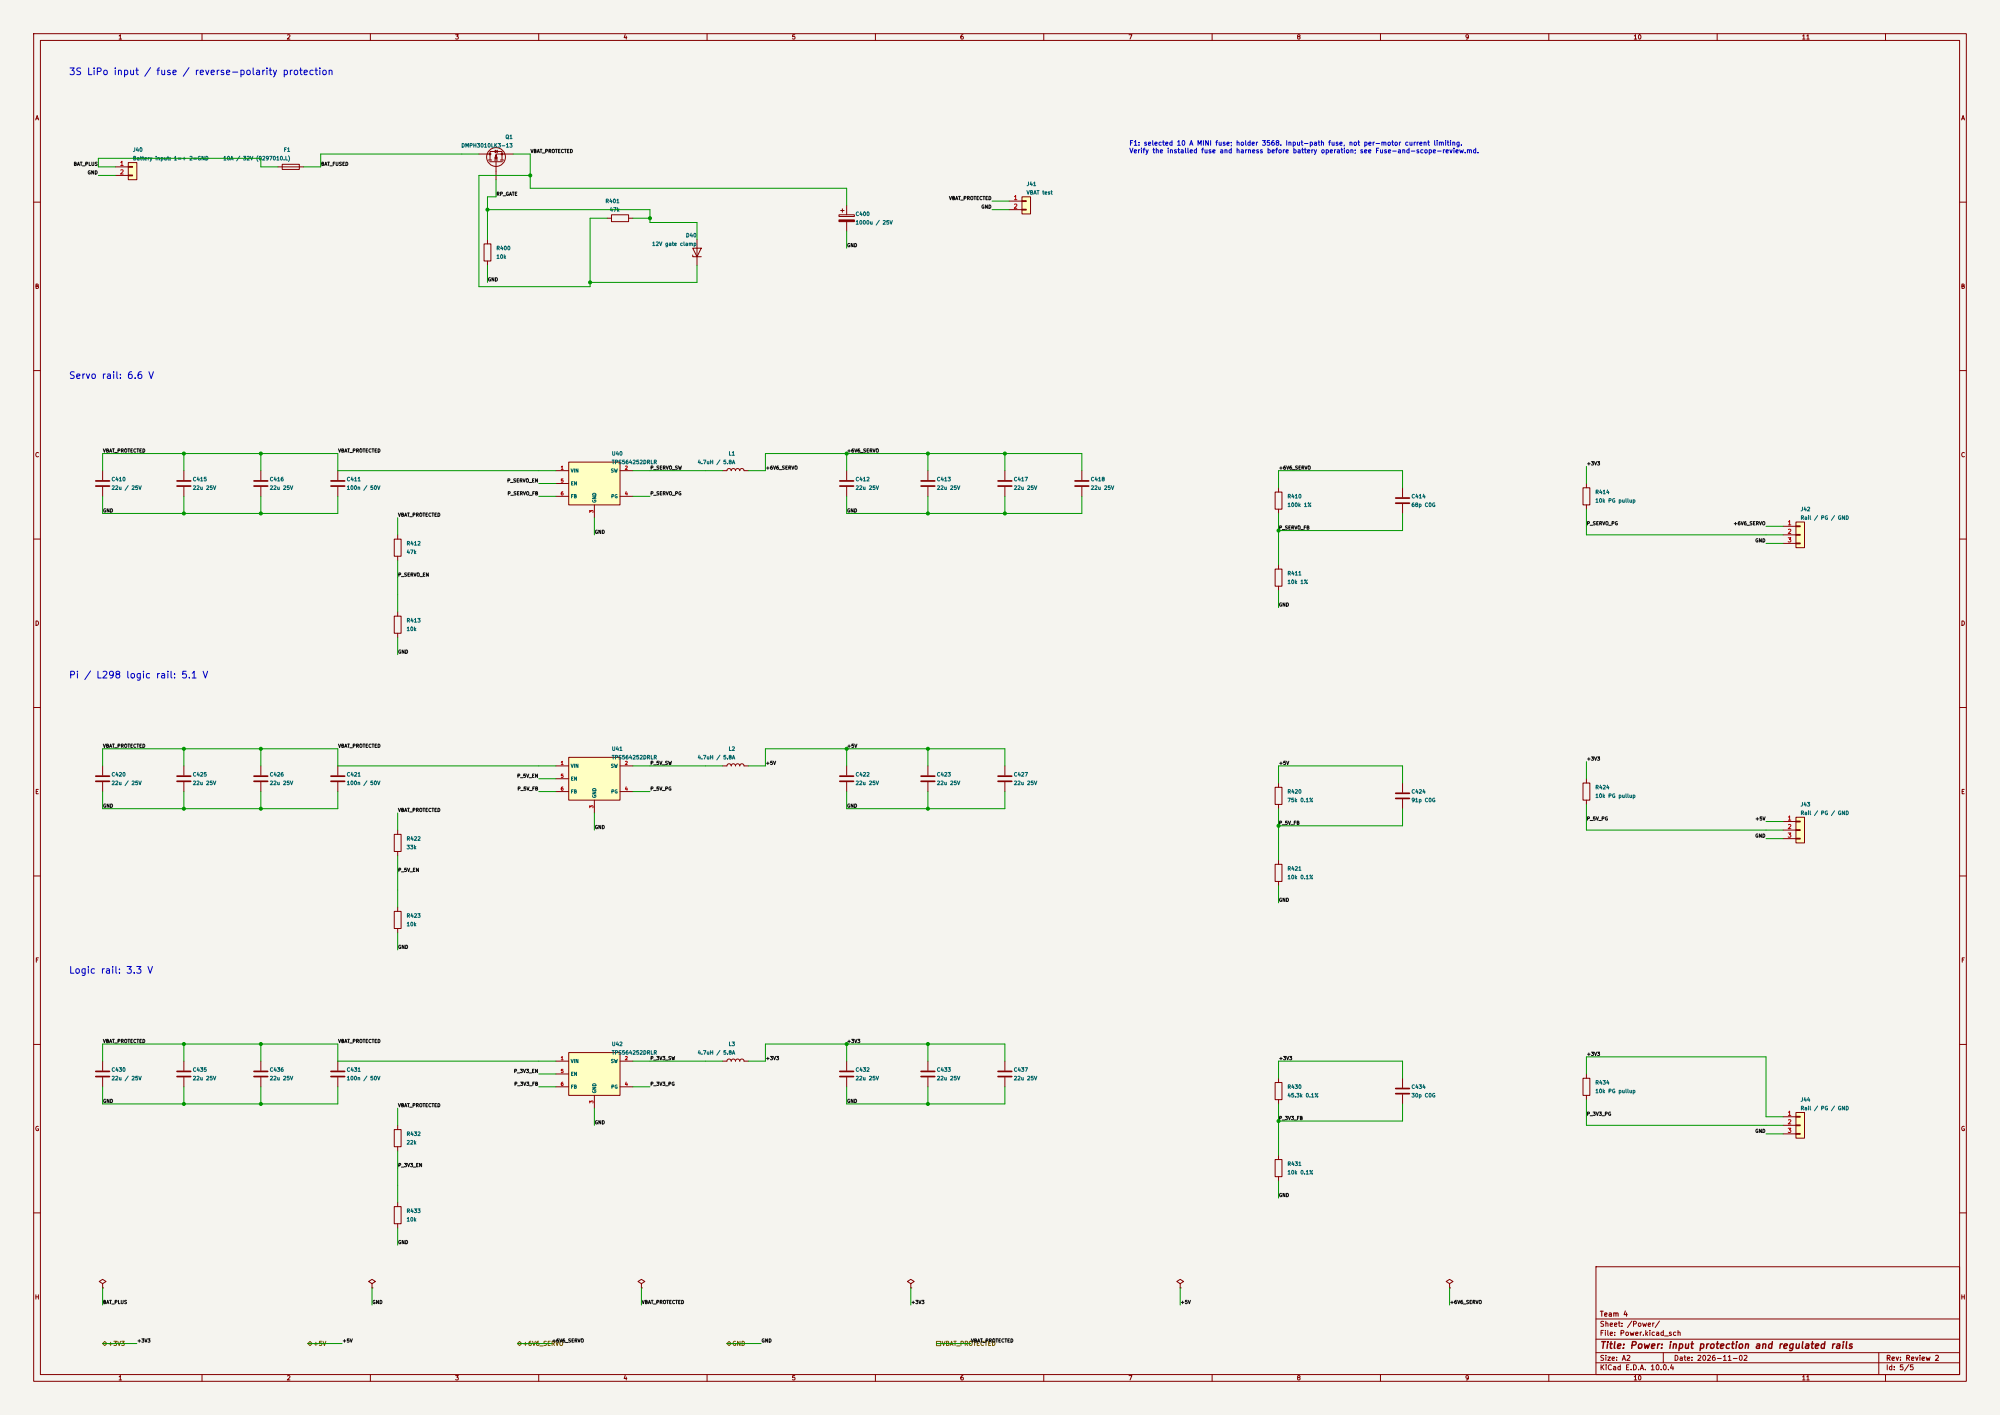
[picture p33: page 5]

3S LiPo input / fuse / reverse-polarity protection

F1: selected 10 A MINI fuse; holder 3568. Input-path fuse, not per-motor current limiting.
Verify the installed fuse and harness before battery operation; see Fuse-and-scope-review.md.

Sheet: /Power/
File: Power.kicad_sch
Title: Power: input protection and regulated rails
