fmarples/18649_team4/(list of files, drawings)

Other design files:
lab4/review-package/Schematic-format-check.json
