fmarples/18649_team4/lab4/KiCad/Lab4.kicad_pcb

## KiCad design lab4/KiCad/Lab4.kicad_pcb (2026-11-02)

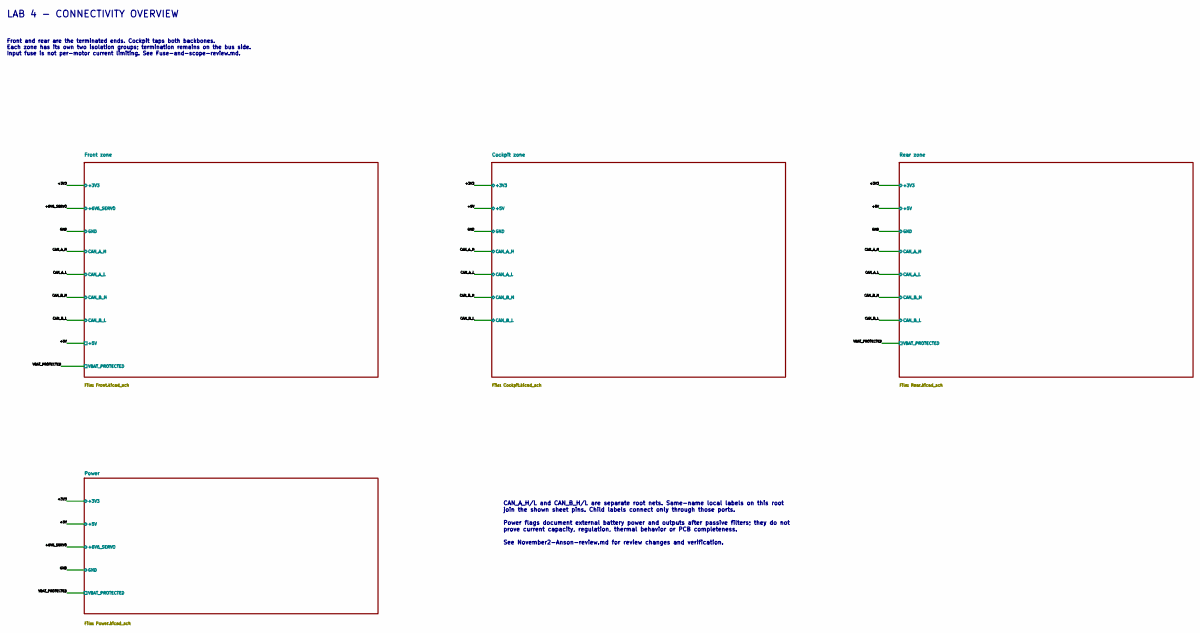
[picture p44: schematic Lab4.kicad_sch, Lab 4 - three-zone controller]

Notes on the sheet:
LAB 4 - CONNECTIVITY OVERVIEW
Front and rear are the terminated ends. Cockpit taps both backbones. Each zone has its own two isolation groups; termination remains on the bus side. Input fuse is not per-motor current limiting. See Fuse-and-scope-review.md.
CAN_A_H/L and CAN_B_H/L are separate root nets. Same-name local labels on this root join the shown sheet pins. Child labels connect only through those ports. Power flags document external battery power and outputs after passive filters; they do not prove current capacity, regulation, thermal behavi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

Schematic: Front.kicad_sch, Front: steering, telemetry and dual CAN

Parts:
C1, C2, C102, C103, C104, C142, C143, C144, C580: 100n; C_0603_1608Metric; MPN KGM15AR71C104KT
C100, C101, C140, C141: 18p C0G 50V; C_0603_1608Metric; MPN GRM1885C1H180JA01D
C500: 100n VDD19; C_0603_1608Metric; MPN KGM15AR71C104KT
C501: 100n VDD32; C_0603_1608Metric; MPN KGM15AR71C104KT
C502: 100n VDD48; C_0603_1608Metric; MPN KGM15AR71C104KT
C503: 100n VDD64; C_0603_1608Metric; MPN KGM15AR71C104KT
C504: 100n VBAT; C_0603_1608Metric; MPN KGM15AR71C104KT
C505: 4.7u VDD bulk; C_0805_2012Metric; MPN GRM21BR71C475KE51L
C506: 4.7u VCAP1; C_0805_2012Metric; MPN GRM21BR71C475KE51L
C507: 100n VDDA; C_0603_1608Metric; MPN KGM15AR71C104KT
C508: 1u VDDA; C_0603_1608Metric; MPN CC0603JRX7R7BB105
C509: 100n NRST; C_0603_1608Metric; MPN KGM15AR71C104KT
C510: 100n TEST; C_0603_1608Metric; MPN KGM15AR71C104KT
D510: STATUS green; LED_0603_1608Metric; MPN LTST-C190GKT
D511: ERR red; LED_0603_1608Metric; MPN LTST-C190KRKT
D512: DEG_A yellow; LED_0603_1608Metric; MPN LTST-C190KSKT
D513: DEG_B yellow; LED_0603_1608Metric; MPN LTST-C190KSKT
FB50: 600R @100MHz; L_0603_1608Metric; MPN 742863160
J1: Sense test points; PinHeader_1x03_P2.54mm_Vertical
J10: CAN A isolation; PinHeader_2x02_P2.54mm_Vertical
J11: CAN A test; PinHeader_1x04_P2.54mm_Vertical
J14: CAN B isolation; PinHeader_2x02_P2.54mm_Vertical
J15: CAN B test; PinHeader_1x04_P2.54mm_Vertical
J90: Servo: GND / 6.6V / PWM; Hirose_DF63M-3P-3.96DSA_1x03_P3.96mm_Vertical; MPN DF63M-3P-3.96DSA
J500: BOOT recovery; PinHeader_1x02_P2.54mm_Vertical; MPN 2.54 mm breakaway header
J501: SWD (2.54mm); PinHeader_1x06_P2.54mm_Vertical; MPN 2.54 mm breakaway header
J502: 3.3V TTL UART; PinHeader_1x03_P2.54mm_Vertical; MPN 2.54 mm breakaway header
J503: LAB3 rows 1-13; PinHeader_1x13_P2.54mm_Vertical; MPN 2.54 mm breakaway header
J504: Additional probes; PinHeader_1x08_P2.54mm_Vertical; MPN 2.54 mm breakaway header
J505: Reserved / encoder probes; PinHeader_1x04_P2.54mm_Vertical; MPN 2.54 mm breakaway header
J550: FRONT LEFT lamp; PinHeader_1x02_P2.54mm_Vertical; MPN 2.54 mm breakaway header
J551: FRONT RIGHT lamp; PinHeader_1x02_P2.54mm_Vertical; MPN 2.54 mm breakaway header
JP10: TERM A; PinHeader_1x02_P2.54mm_Vertical
JP14: TERM B; PinHeader_1x02_P2.54mm_Vertical
Q550, Q551: MMBT3904; SOT-23; MPN MMBT3904-7-F
R1: 10mR / 1W / 1%; Vishay_WSL2512_7m_to_500m; MPN WSL2512R0100FEA
R2: 4.7k; R_0603_1608Metric; MPN RC0603FR-074K7L
R100, R101, R140, R141: 10k; R_0603_1608Metric; MPN CRCW060310K0FKEA
R102, R142: 120R; R_0603_1608Metric; MPN RC0603FR-07120RL
R500: 10k BOOT0; R_0603_1608Metric; MPN CRCW060310K0FKEA
R501: 10k NRST; R_0603_1608Metric; MPN CRCW060310K0FKEA
R502: 10k TEST pullup; R_0603_1608Metric; MPN CRCW060310K0FKEA
R510, R511, R512, R513: 1k; R_0603_1608Metric; MPN ERJ-3EKF1001V
R530: 10k PWM pulldown; R_0603_1608Metric; MPN CRCW060310K0FKEA
R540: 100R; R_0603_1608Metric; MPN CRCW0603100RFKEA
R550, R551: 2.2k; R_0603_1608Metric; MPN CRCW06032K20FKEA
R560, R561: 100k; R_0603_1608Metric; MPN CRCW0603100KFKEA
R570, R571: 220R; R_0603_1608Metric; MPN CRCW0603220RFKEA
R580: 100k 0.1%; R_0603_1608Metric; MPN RT0603BRD07100KL
R581: 10k 0.1%; R_0603_1608Metric; MPN RT0603BRD0710KL
SW50, SW51: SWT0210-045026GSA; GCT_SWT0210_4.5x4.5mm; MPN SWT0210-045026GSA
U1: INA180A2IDBVR; SOT-23-5; MPN INA180A2IDBVR
U10, U14: MCP2515T-I/ST; TSSOP-20_4.4x6.5mm_P0.65mm; MPN MCP2515T-I/ST
U11, U15: SN65HVD231DR; SOIC-8_3.9x4.9mm_P1.27mm; MPN SN65HVD231DR
U50: STM32F401RET6TR; LQFP-64_10x10mm_P0.5mm; MPN STM32F401RET6TR
Y10, Y14: 16 MHz; Crystal_SMD_3225-4Pin_3.2x2.5mm; MPN CX3225SB16000H0FLJCC

Connections:
/+3V3: C1.1, C103.1, C104.1, C143.1, C144.1, C500.1, C501.1, C502.1, C503.1, C504.1, C505.1, FB50.1, J500.1, J501.1, R100.1, R101.1, R140.1, R141.1, R501.1, R502.1, U1.5 (V+), U10.4 (~TX0RTS), U10.5 (~TX1RTS), U10.7 (~TX2RTS), U10.20 (VDD), U11.3 (VCC), U14.4 (~TX0RTS), U14.5 (~TX1RTS), U14.7 (~TX2RTS), U14.20 (VDD), U15.3 (VCC), U50.1 (VBAT), U50.19 (VDD), U50.32 (VDD), U50.48 (VDD), U50.64 (VDD); also elsewhere on the board
/+5V: R570.1, R571.1; also elsewhere on the board
/+6V6_SERVO: R1.1, U1.3 (+); also elsewhere on the board
/CAN_A_H: J10.2, J11.3, JP10.1 (A); also elsewhere on the board
/CAN_A_L: J10.4, J11.4, R102.2; also elsewhere on the board
/CAN_B_H: J14.2, J15.3, JP14.1 (A); also elsewhere on the board
/CAN_B_L: J14.4, J15.4, R142.2; also elsewhere on the board
/Front zone/BATTERY_ADC: C580.1, R580.2, R581.1, U50.17 (PA3)
/Front zone/F_A_H_LOCAL: J10.1, U11.7 (CANH)
/Front zone/F_A_L_LOCAL: J10.3, U11.6 (CANL)
/Front zone/F_A_OSC1: C100.1, U10.9 (OSC1), Y10.1
/Front zone/F_A_OSC2: C101.1, U10.8 (OSC2), Y10.3
/Front zone/F_A_RESET: C102.1, R100.2, U10.19 (~RESET)
/Front zone/F_A_RXD: J11.2, U10.2 (RXCAN), U11.4 (R)
/Front zone/F_A_TERM: JP10.2 (B), R102.1
/Front zone/F_A_TXD: J11.1, U10.1 (TXCAN), U11.1 (D)
/Front zone/F_BOOT0: J500.2, R500.1, U50.60 (BOOT0)
/Front zone/F_B_H_LOCAL: J14.1, U15.7 (CANH)
/Front zone/F_B_L_LOCAL: J14.3, U15.6 (CANL)
/Front zone/F_B_OSC1: C140.1, U14.9 (OSC1), Y14.1
/Front zone/F_B_OSC2: C141.1, U14.8 (OSC2), Y14.3
/Front zone/F_B_RESET: C142.1, R140.2, U14.19 (~RESET)
/Front zone/F_B_RXD: J15.2, U14.2 (RXCAN), U15.4 (R)
/Front zone/F_B_TERM: JP14.2 (B), R142.1
/Front zone/F_B_TXD: J15.1, U14.1 (TXCAN), U15.1 (D)
/Front zone/F_CS_A: R101.2, U10.18 (~CS), U50.58 (PB6)
/Front zone/F_CS_B: R141.2, U14.18 (~CS), U50.38 (PC7)
/Front zone/F_DEG_A_LED: J503.7, R512.1, U50.26 (PB0)
/Front zone/F_DEG_A_LED_ANODE: D512.2 (A), R512.2
/Front zone/F_DEG_B_LED: J503.8, R513.1, U50.27 (PB1)
/Front zone/F_DEG_B_LED_ANODE: D513.2 (A), R513.2
/Front zone/F_DIR_A_MARKER: J505.4, U50.29 (PB10)
/Front zone/F_ERROR_LED: J503.13, J504.4, R511.1, U50.8 (PC0)
/Front zone/F_ERROR_LED_ANODE: D511.2 (A), R511.2
/Front zone/F_FRONT_LEFT_LED: J503.10, R550.1, U50.20 (PA4)
/Front zone/F_FRONT_LEFT_LED_BASE: Q550.1 (B), R550.2, R560.1
/Front zone/F_FRONT_LEFT_LED_PLUS: J550.1, R570.2
/Front zone/F_FRONT_LEFT_LED_SINK: J550.2, Q550.3 (C)
/Front zone/F_FRONT_RIGHT_LED: J503.11, R551.1, U50.61 (PB8)
/Front zone/F_FRONT_RIGHT_LED_BASE: Q551.1 (B), R551.2, R561.1
/Front zone/F_FRONT_RIGHT_LED_PLUS: J551.1, R571.2
/Front zone/F_FRONT_RIGHT_LED_SINK: J551.2, Q551.3 (C)
/Front zone/F_INT_A: U10.13 (~INT), U50.43 (PA10)
/Front zone/F_INT_B: U14.13 (~INT), U50.57 (PB5)
/Front zone/F_MISO: U10.17 (SO), U14.17 (SO), U50.22 (PA6)
/Front zone/F_MOSI: U10.16 (SI), U14.16 (SI), U50.23 (PA7)
/Front zone/F_PID_MARKER: J504.7, U50.40 (PC9)
/Front zone/F_PWM_SET_MARKER: J505.3, U50.62 (PB9)
/Front zone/F_RELAY_TX_MARKER: J503.12, U50.37 (PC6)
/Front zone/F_RESET_N: C509.1, J501.5, R501.2, SW50.1, U50.7 (NRST)
/Front zone/F_RX_A_MARKER: J503.3, U50.10 (PC2)
/Front zone/F_RX_B_MARKER: J503.4, U50.11 (PC3)
/Front zone/F_SCK: U10.14 (SCK), U14.14 (SCK), U50.21 (PA5)
/Front zone/F_SELFTEST_BUTTON: C510.1, J504.3, R502.2, SW51.1, U50.2 (PC13)
/Front zone/F_SERVO_PWM: J503.9, R530.1, R540.1, U50.42 (PA9)
/Front zone/F_STATUS_LED: R510.1, U50.50 (PA15)
/Front zone/F_STATUS_LED_ANODE: D510.2 (A), R510.2
/Front zone/F_STEER_TASK_MARKER: J504.6, U50.9 (PC1)
/Front zone/F_SWCLK: J501.2, U50.49 (PA14)
/Front zone/F_SWDIO: J501.4, U50.46 (PA13)
/Front zone/F_TASK_PROBE: J504.5, U50.39 (PC8)
/Front zone/F_TX_A_MARKER: J503.5, U50.14 (PA0)
/Front zone/F_TX_B_MARKER: J503.6, U50.15 (PA1)
/Front zone/F_UART_CONSOLE_RX: J502.2, U50.45 (PA12)
/Front zone/F_UART_CONSOLE_TX: J502.1, U50.44 (PA11)
/Front zone/F_VCAP1: C506.1, U50.30 (VCAP1)
/Front zone/F_VDDA: C507.1, C508.1, FB50.2, U50.13 (VREF+)
/Front zone/SERVO_ADC: C2.1, J1.2, J504.8, R2.2, U50.16 (PA2)
/Front zone/SERVO_PWM_OUT: J90.3, R540.2
/Front zone/SERVO_RAW: J1.1, R2.1, U1.1
/Front zone/SERVO_VPLUS: J90.2, R1.2, U1.4 (-)
/GND: C1.2, C2.2, C100.2, C101.2, C102.2, C103.2, C104.2, C140.2, C141.2, C142.2, C143.2, C144.2, C500.2, C501.2, C502.2, C503.2, C504.2, C505.2, C506.2, C507.2, C508.2, C509.2, C510.2, C580.2, D510.1 (K), D511.1 (K), D512.1 (K), D513.1 (K), J1.3, J90.1, J501.3, J501.6, J502.3, J503.1, J503.2, J504.1, J504.2, J505.1, J505.2, Q550.2 (E), Q551.2 (E), R500.2, R530.2, R560.2, R561.2, R581.2, SW50.2, SW51.2, U1.2 (GND), U10.10 (VSS), U11.2 (GND), U11.8 (Rs), U14.10 (VSS), U15.2 (GND), U15.8 (Rs), U50.12 (VSSA), U50.18 (VSS), U50.31 (VSS), U50.47 (VSS), U50.63 (VSS), Y10.2 (G), Y10.4 (G), Y14.2 (G), Y14.4 (G); also elsewhere on the board
/VBAT_PROTECTED: R580.1; also elsewhere on the board

Notes on the sheet:
CAN A: controller, transceiver and isolation
16 MHz; SPI from zone processor
CAN B: controller, transceiver and isolation
STM32F401: processor, supplies and recovery
100 nF at each VDD pin; VCAP is a dedicated regulator output.
Servo supply, high-side current sense and PWM
Vehicle lamps
Battery voltage monitor
Accessible test headers
Lab 3 pin assignments retained. Do not apply 5 V to MCU/ADC inputs.

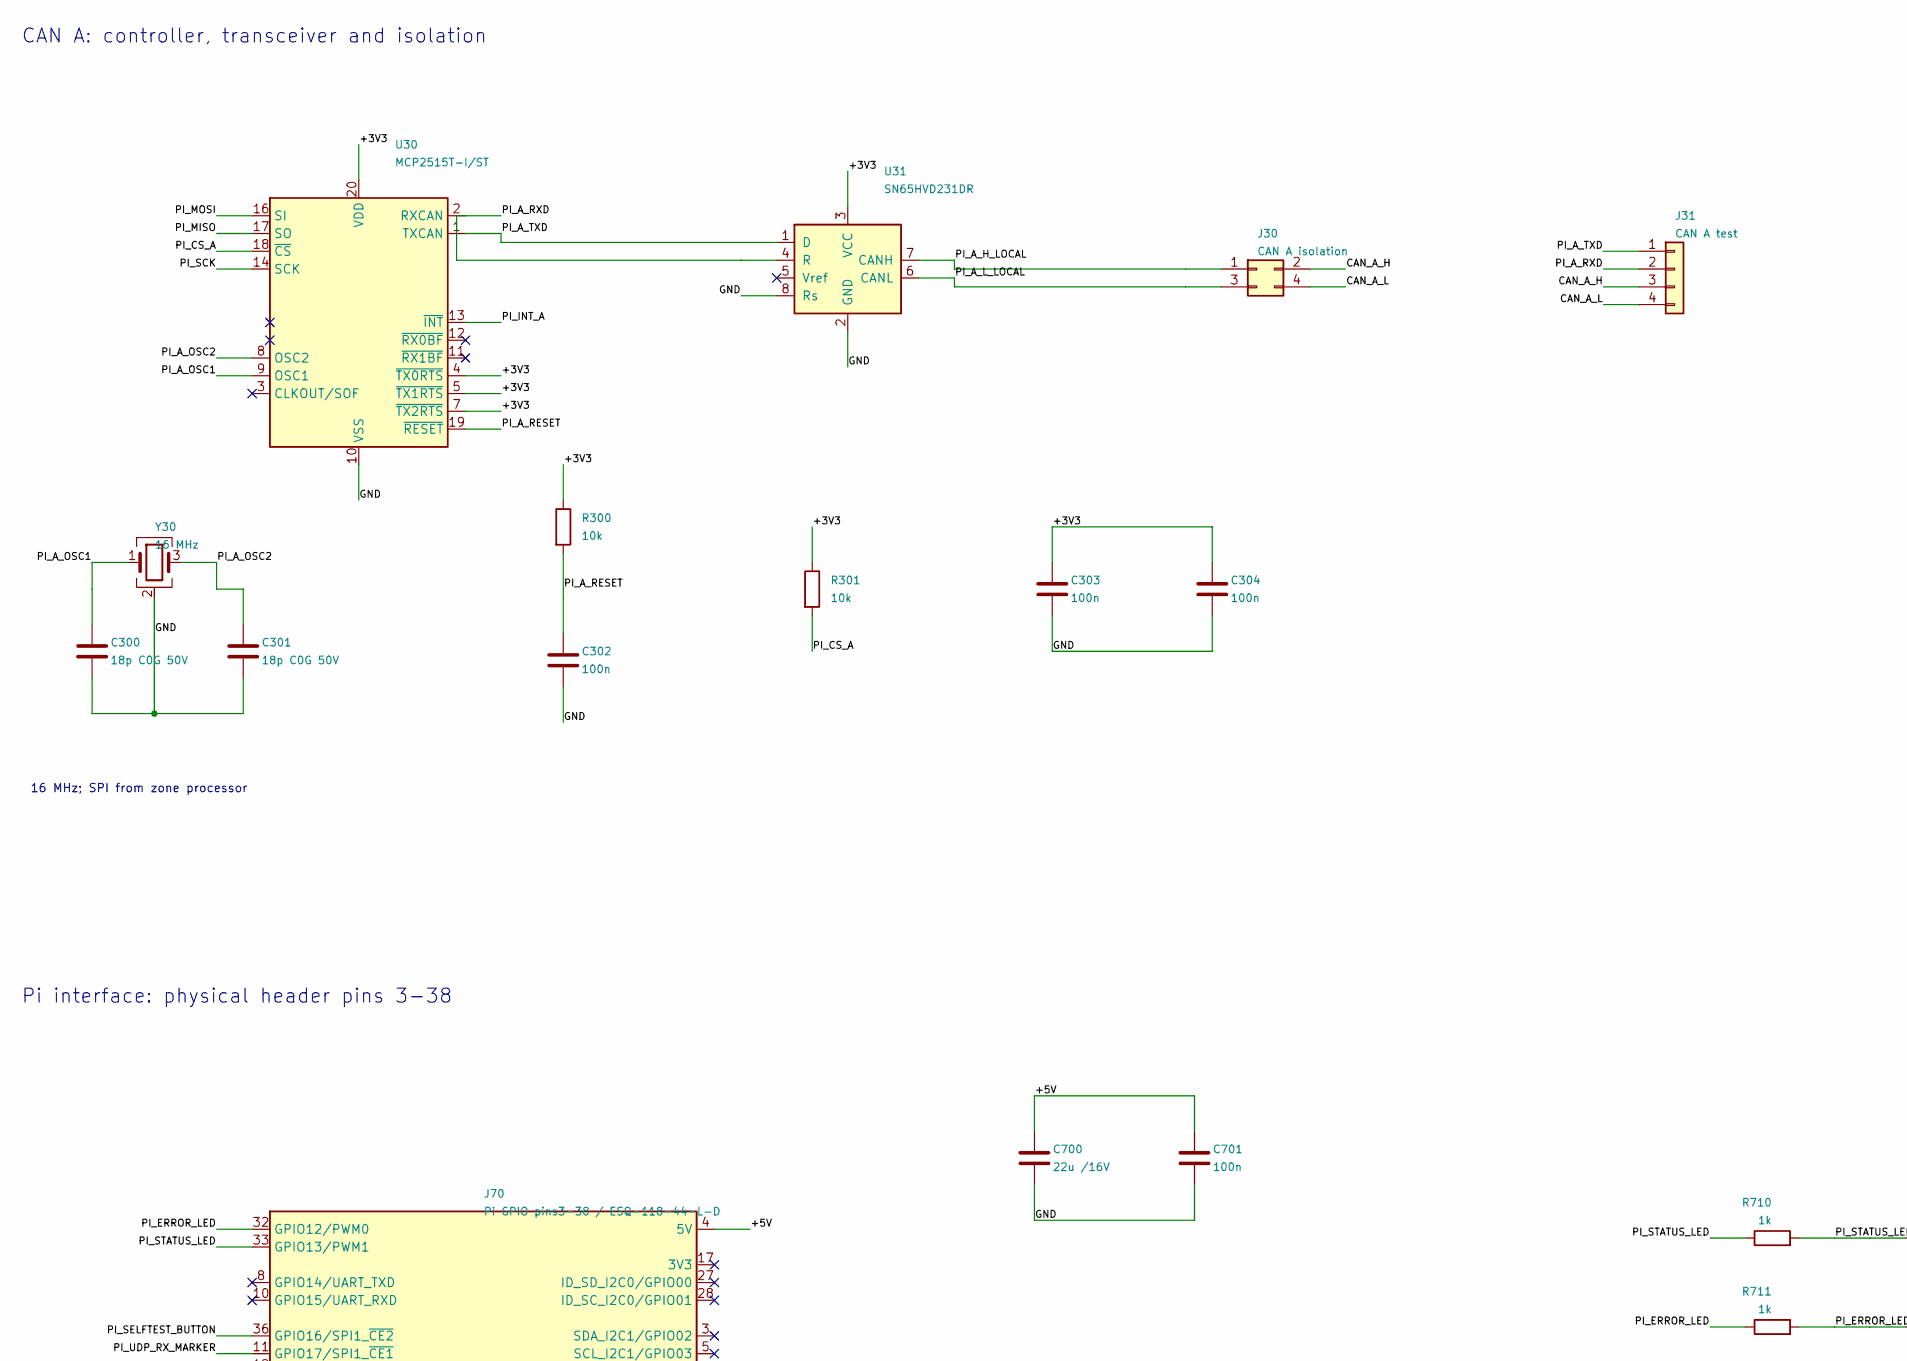
[picture p45: schematic Cockpit.kicad_sch, Cockpit: Raspberry Pi interface and dual CAN, part in row 1, column 1]

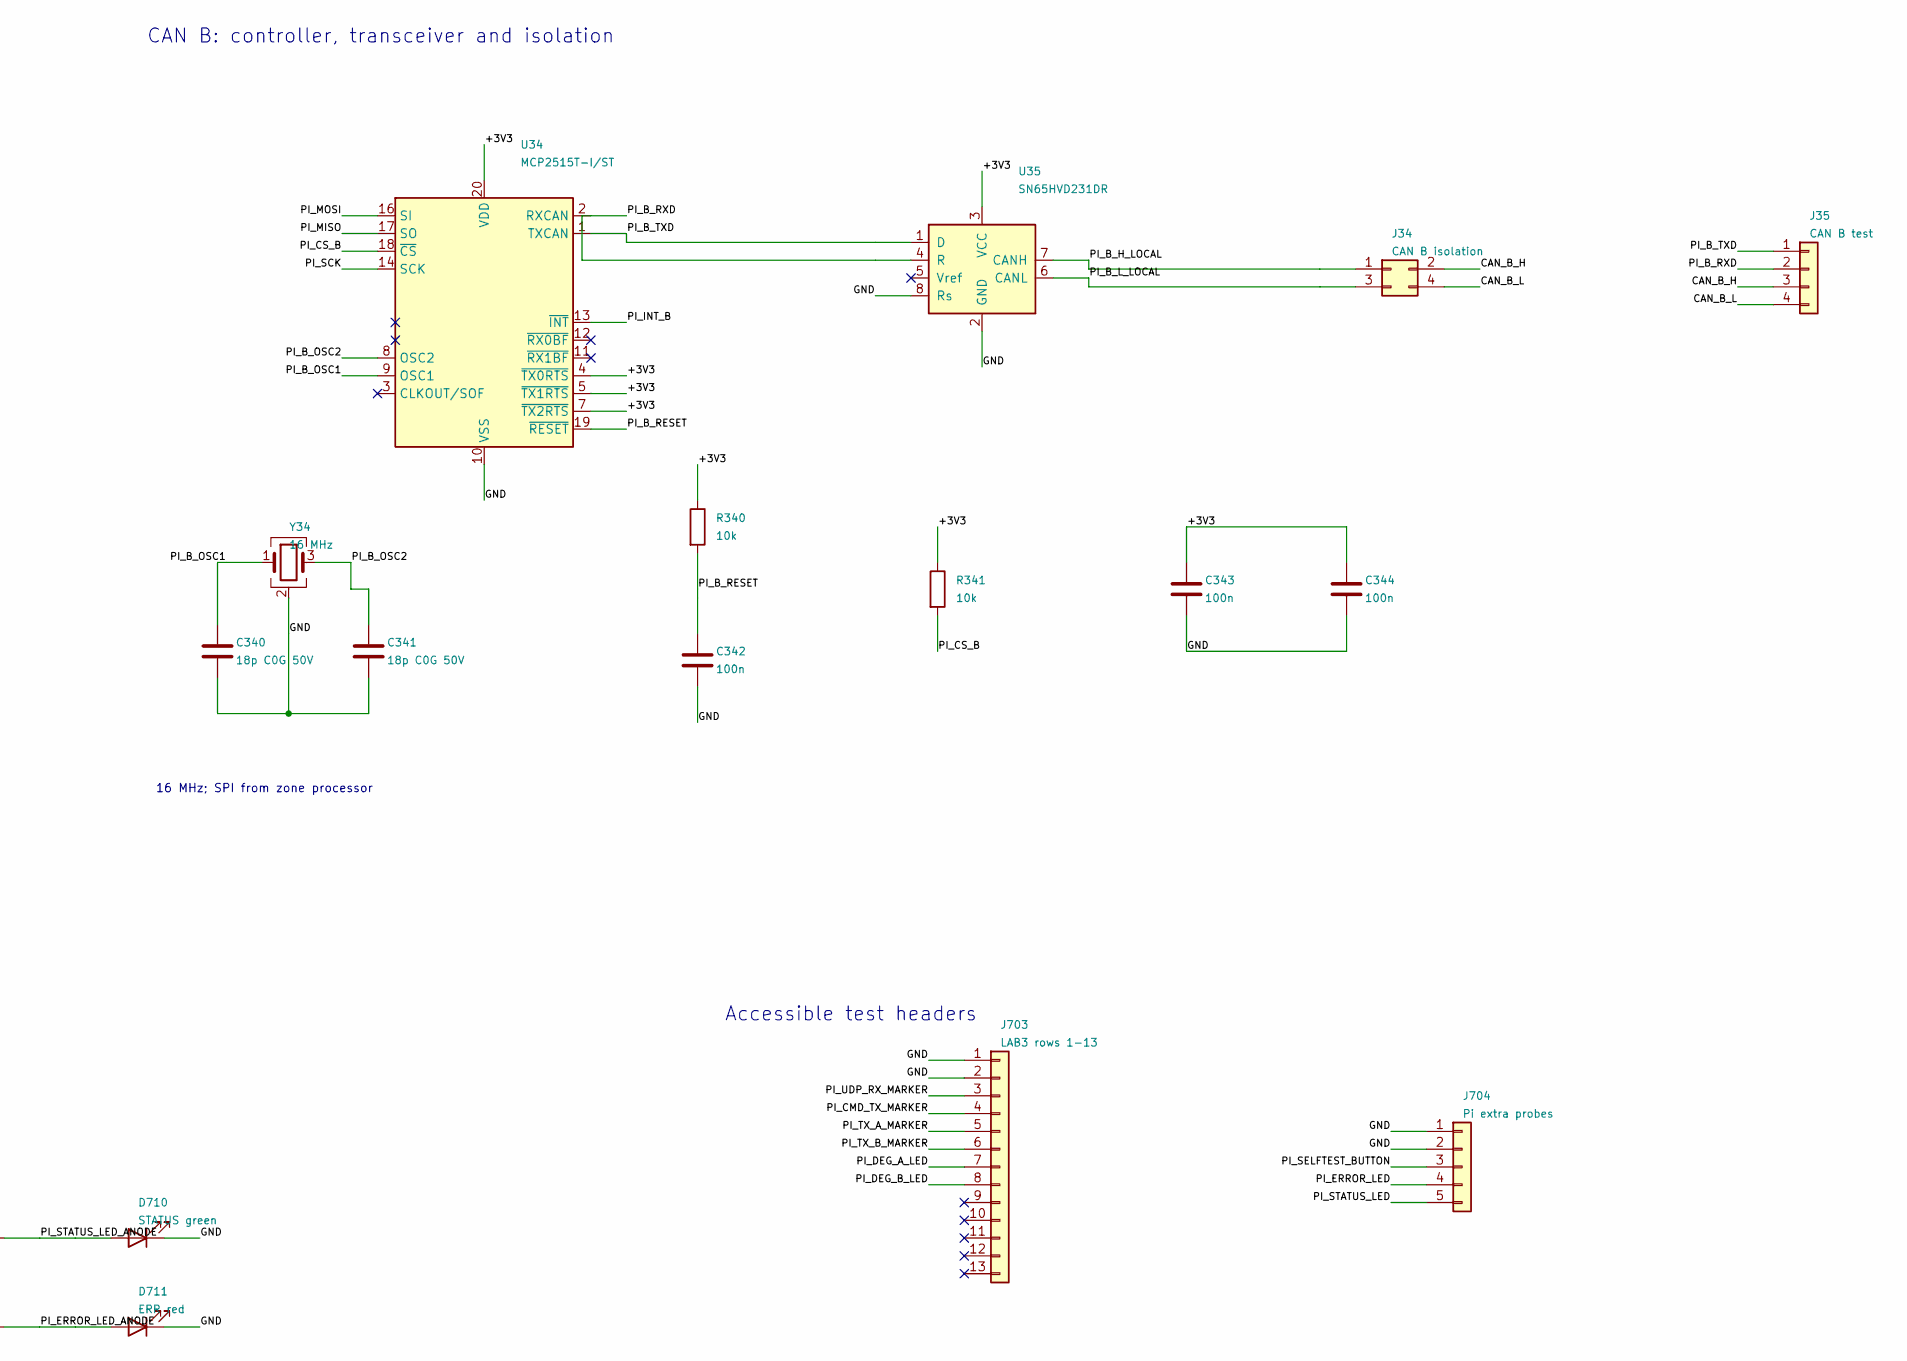
[picture p46: schematic Cockpit.kicad_sch, Cockpit: Raspberry Pi interface and dual CAN, part in row 1, column 2]

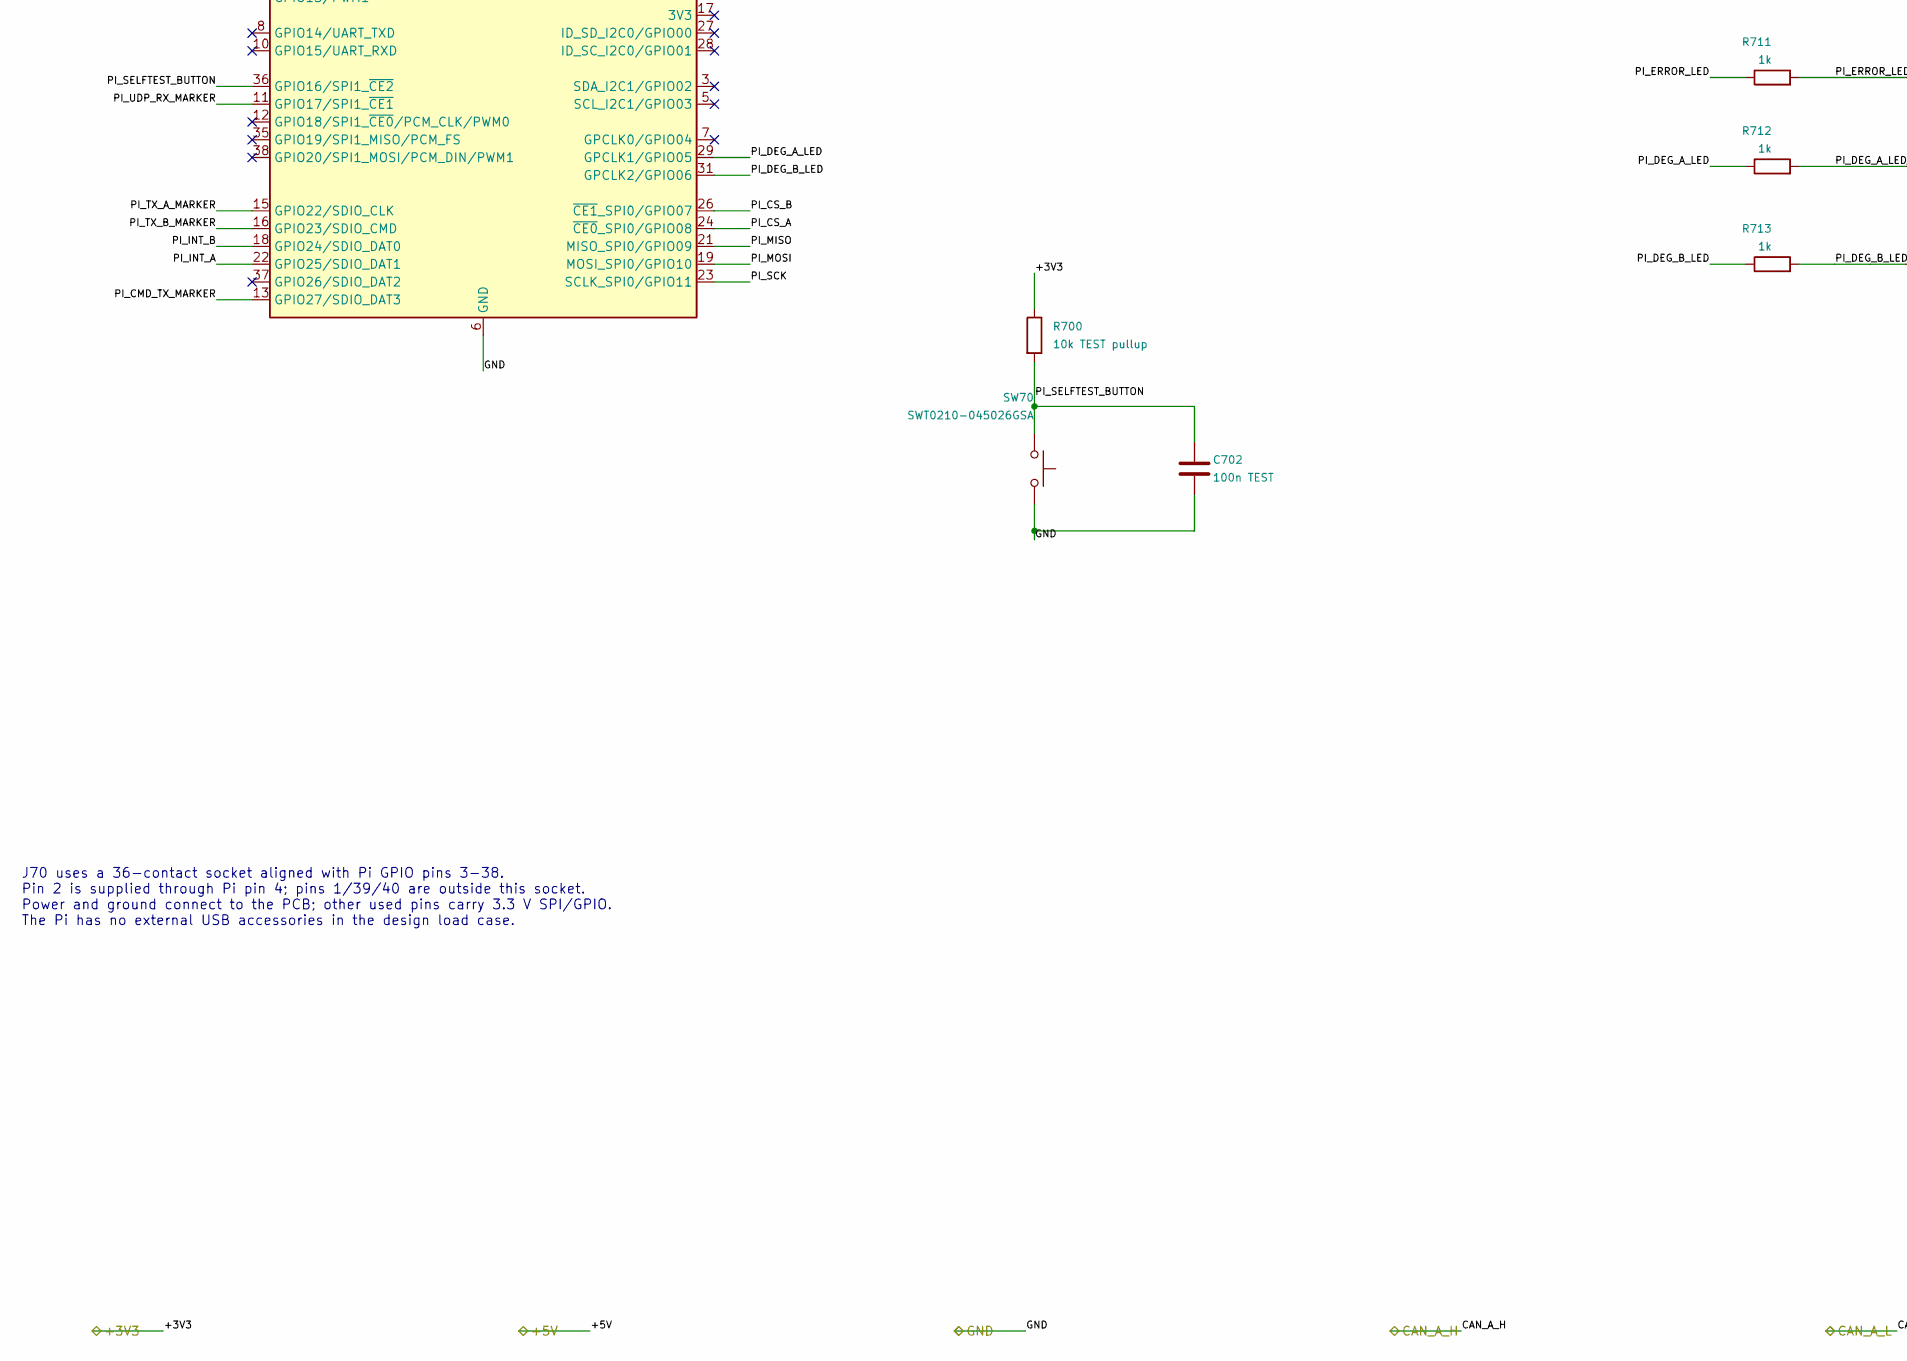
[picture p47: schematic Cockpit.kicad_sch, Cockpit: Raspberry Pi interface and dual CAN, part in row 2, column 1]

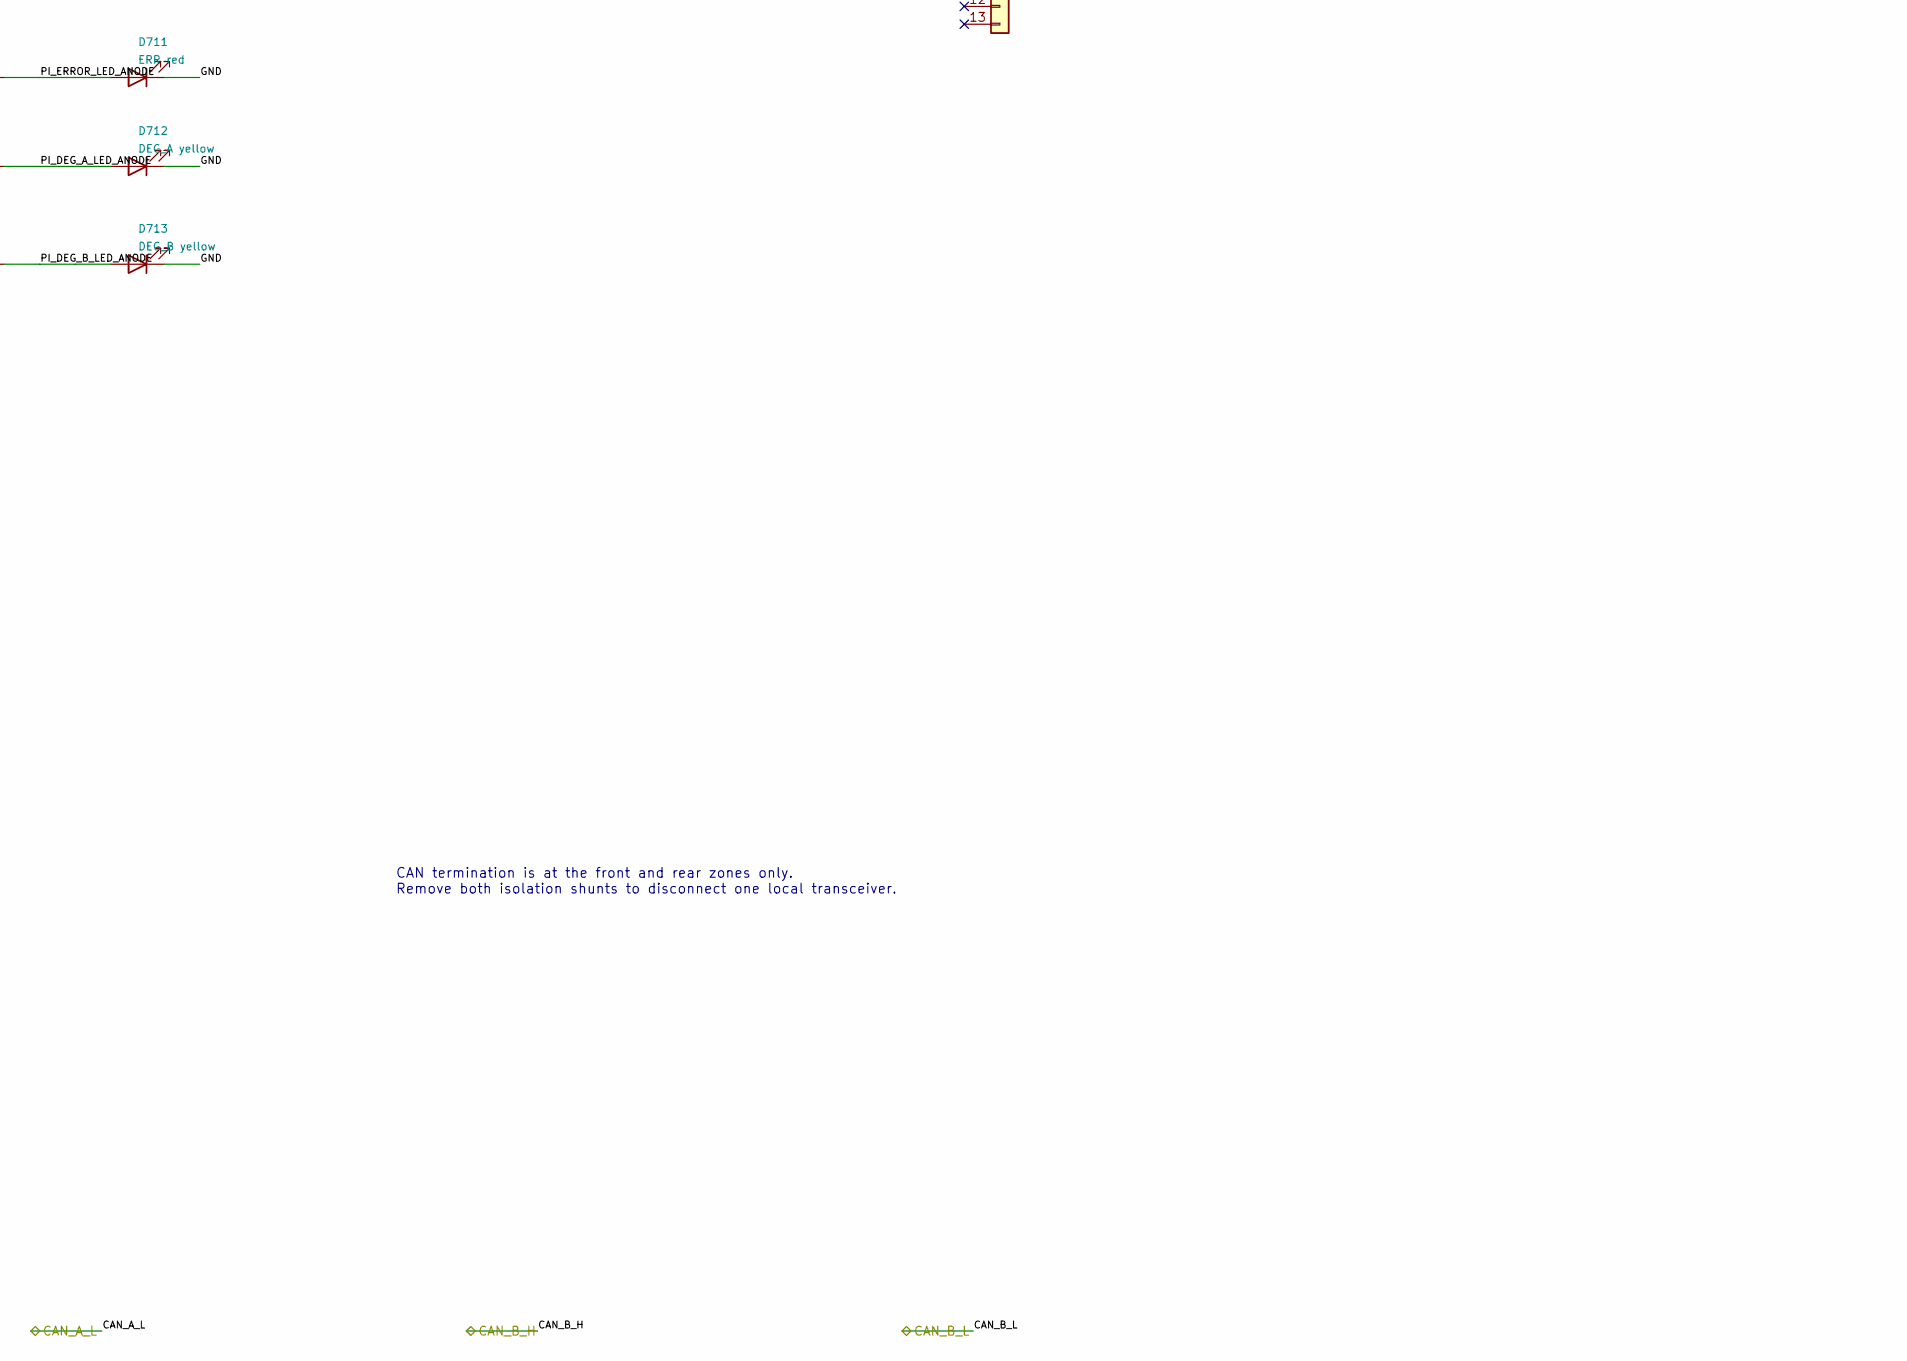
[picture p48: schematic Cockpit.kicad_sch, Cockpit: Raspberry Pi interface and dual CAN, part in row 2, column 2]

Parts:
C300, C301, C340, C341: 18p C0G 50V; C_0603_1608Metric; MPN GRM1885C1H180JA01D
C302, C303, C304, C342, C343, C344, C701: 100n; C_0603_1608Metric; MPN KGM15AR71C104KT
C700: 22u /16V; C_0805_2012Metric; MPN GRM219R61C226ME15L
C702: 100n TEST; C_0603_1608Metric; MPN KGM15AR71C104KT
D710: STATUS green; LED_0603_1608Metric; MPN LTST-C190GKT
D711: ERR red; LED_0603_1608Metric; MPN LTST-C190KRKT
D712: DEG_A yellow; LED_0603_1608Metric; MPN LTST-C190KSKT
D713: DEG_B yellow; LED_0603_1608Metric; MPN LTST-C190KSKT
J30: CAN A isolation; PinHeader_2x02_P2.54mm_Vertical
J31: CAN A test; PinHeader_1x04_P2.54mm_Vertical
J34: CAN B isolation; PinHeader_2x02_P2.54mm_Vertical
J35: CAN B test; PinHeader_1x04_P2.54mm_Vertical
J70: Pi GPIO pins3-38 / ESQ-118-44-L-D; Samtec_ESQ-118-44_2x18_PiPins3-38_H18.67; MPN ESQ-118-44-L-D
J703: LAB3 rows 1-13; PinHeader_1x13_P2.54mm_Vertical; MPN 2.54 mm breakaway header
J704: Pi extra probes; PinHeader_1x05_P2.54mm_Vertical; MPN 2.54 mm breakaway header
R300, R301, R340, R341: 10k; R_0603_1608Metric; MPN CRCW060310K0FKEA
R700: 10k TEST pullup; R_0603_1608Metric; MPN CRCW060310K0FKEA
R710, R711, R712, R713: 1k; R_0603_1608Metric; MPN ERJ-3EKF1001V
SW70: SWT0210-045026GSA; GCT_SWT0210_4.5x4.5mm; MPN SWT0210-045026GSA
U30, U34: MCP2515T-I/ST; TSSOP-20_4.4x6.5mm_P0.65mm; MPN MCP2515T-I/ST
U31, U35: SN65HVD231DR; SOIC-8_3.9x4.9mm_P1.27mm; MPN SN65HVD231DR
Y30, Y34: 16 MHz; Crystal_SMD_3225-4Pin_3.2x2.5mm; MPN CX3225SB16000H0FLJCC

Connections:
/+3V3: C303.1, C304.1, C343.1, C344.1, R300.1, R301.1, R340.1, R341.1, R700.1, U30.4 (~TX0RTS), U30.5 (~TX1RTS), U30.7 (~TX2RTS), U30.20 (VDD), U31.3 (VCC), U34.4 (~TX0RTS), U34.5 (~TX1RTS), U34.7 (~TX2RTS), U34.20 (VDD), U35.3 (VCC); also elsewhere on the board
/+5V: C700.1, C701.1, J70.4 (5V); also elsewhere on the board
/CAN_A_H: J30.2, J31.3; also elsewhere on the board
/CAN_A_L: J30.4, J31.4; also elsewhere on the board
/CAN_B_H: J34.2, J35.3; also elsewhere on the board
/CAN_B_L: J34.4, J35.4; also elsewhere on the board
/Cockpit zone/PI_A_H_LOCAL: J30.1, U31.7 (CANH)
/Cockpit zone/PI_A_L_LOCAL: J30.3, U31.6 (CANL)
/Cockpit zone/PI_A_OSC1: C300.1, U30.9 (OSC1), Y30.1
/Cockpit zone/PI_A_OSC2: C301.1, U30.8 (OSC2), Y30.3
/Cockpit zone/PI_A_RESET: C302.1, R300.2, U30.19 (~RESET)
/Cockpit zone/PI_A_RXD: J31.2, U30.2 (RXCAN), U31.4 (R)
/Cockpit zone/PI_A_TXD: J31.1, U30.1 (TXCAN), U31.1 (D)
/Cockpit zone/PI_B_H_LOCAL: J34.1, U35.7 (CANH)
/Cockpit zone/PI_B_L_LOCAL: J34.3, U35.6 (CANL)
/Cockpit zone/PI_B_OSC1: C340.1, U34.9 (OSC1), Y34.1
/Cockpit zone/PI_B_OSC2: C341.1, U34.8 (OSC2), Y34.3
/Cockpit zone/PI_B_RESET: C342.1, R340.2, U34.19 (~RESET)
/Cockpit zone/PI_B_RXD: J35.2, U34.2 (RXCAN), U35.4 (R)
/Cockpit zone/PI_B_TXD: J35.1, U34.1 (TXCAN), U35.1 (D)
/Cockpit zone/PI_CMD_TX_MARKER: J70.13 (GPIO27/SDIO_DAT3), J703.4
/Cockpit zone/PI_CS_A: J70.24 (~CE0_SPI0/GPIO08), R301.2, U30.18 (~CS)
/Cockpit zone/PI_CS_B: J70.26 (~CE1_SPI0/GPIO07), R341.2, U34.18 (~CS)
/Cockpit zone/PI_DEG_A_LED: J70.29 (GPCLK1/GPIO05), J703.7, R712.1
/Cockpit zone/PI_DEG_A_LED_ANODE: D712.2 (A), R712.2
/Cockpit zone/PI_DEG_B_LED: J70.31 (GPCLK2/GPIO06), J703.8, R713.1
/Cockpit zone/PI_DEG_B_LED_ANODE: D713.2 (A), R713.2
/Cockpit zone/PI_ERROR_LED: J70.32 (GPIO12/PWM0), J704.4, R711.1
/Cockpit zone/PI_ERROR_LED_ANODE: D711.2 (A), R711.2
/Cockpit zone/PI_INT_A: J70.22 (GPIO25/SDIO_DAT1), U30.13 (~INT)
/Cockpit zone/PI_INT_B: J70.18 (GPIO24/SDIO_DAT0), U34.13 (~INT)
/Cockpit zone/PI_MISO: J70.21 (MISO_SPI0/GPIO09), U30.17 (SO), U34.17 (SO)
/Cockpit zone/PI_MOSI: J70.19 (MOSI_SPI0/GPIO10), U30.16 (SI), U34.16 (SI)
/Cockpit zone/PI_SCK: J70.23 (SCLK_SPI0/GPIO11), U30.14 (SCK), U34.14 (SCK)
/Cockpit zone/PI_SELFTEST_BUTTON: C702.1, J70.36 (GPIO16/SPI1_~CE2), J704.3, R700.2, SW70.1
/Cockpit zone/PI_STATUS_LED: J70.33 (GPIO13/PWM1), J704.5, R710.1
/Cockpit zone/PI_STATUS_LED_ANODE: D710.2 (A), R710.2
/Cockpit zone/PI_TX_A_MARKER: J70.15 (GPIO22/SDIO_CLK), J703.5
/Cockpit zone/PI_TX_B_MARKER: J70.16 (GPIO23/SDIO_CMD), J703.6
/Cockpit zone/PI_UDP_RX_MARKER: J70.11 (GPIO17/SPI1_~CE1), J703.3
/GND: C300.2, C301.2, C302.2, C303.2, C304.2, C340.2, C341.2, C342.2, C343.2, C344.2, C700.2, C701.2, C702.2, D710.1 (K), D711.1 (K), D712.1 (K), D713.1 (K), J70.6 (GND), J70.9 (GND), J70.14 (GND), J70.20 (GND), J70.25 (GND), J70.30 (GND), J70.34 (GND), J703.1, J703.2, J704.1, J704.2, SW70.2, U30.10 (VSS), U31.2 (GND), U31.8 (Rs), U34.10 (VSS), U35.2 (GND), U35.8 (Rs), Y30.2 (G), Y30.4 (G), Y34.2 (G), Y34.4 (G); also elsewhere on the board

Notes on the sheet:
CAN A: controller, transceiver and isolation
16 MHz; SPI from zone processor
CAN B: controller, transceiver and isolation
Pi interface: physical header pins 3-38
Accessible test headers
J70 uses a 36-contact socket aligned with Pi GPIO pins 3-38. Pin 2 is supplied through Pi pin 4; pins 1/39/40 are outside this socket. Power and ground connect to the PCB; other used pins carry 3.3 V SPI/GPIO. The Pi has no external USB accessories in the design load case.
CAN termination is at the front and rear zones only. Remove both isolation shunts to disconnect one local transceiver.
