fmarples/18649_team4/lab4/KiCad/Lab4.kicad_pcb

## KiCad design lab4/KiCad/Lab4.kicad_pcb (continued)

Schematic: Rear.kicad_sch, Rear: drivetrain, encoders and dual CAN

Parts:
C3, C5, C6, C8, C202, C203, C204, C242, C243, C244, C801, C803: 100n; C_0603_1608Metric; MPN KGM15AR71C104KT
C4, C7: 1n; C_0603_1608Metric; MPN GCM1885C2A102FA16D
C200, C201, C240, C241: 18p C0G 50V; C_0603_1608Metric; MPN GRM1885C1H180JA01D
C600: 100n VDD19; C_0603_1608Metric; MPN KGM15AR71C104KT
C601: 100n VDD32; C_0603_1608Metric; MPN KGM15AR71C104KT
C602: 100n VDD48; C_0603_1608Metric; MPN KGM15AR71C104KT
C603: 100n VDD64; C_0603_1608Metric; MPN KGM15AR71C104KT
C604: 100n VBAT; C_0603_1608Metric; MPN KGM15AR71C104KT
C605: 4.7u VDD bulk; C_0805_2012Metric; MPN GRM21BR71C475KE51L
C606: 4.7u VCAP1; C_0805_2012Metric; MPN GRM21BR71C475KE51L
C607: 100n VDDA; C_0603_1608Metric; MPN KGM15AR71C104KT
C608: 1u VDDA; C_0603_1608Metric; MPN CC0603JRX7R7BB105
C609: 100n NRST; C_0603_1608Metric; MPN KGM15AR71C104KT
C610: 100n TEST; C_0603_1608Metric; MPN KGM15AR71C104KT
C800: 100n 50V; C_0603_1608Metric; MPN GRM188R71H104KA93D
C802: 470u 25V; CP_Radial_D10.0mm_P5.00mm; MPN EEU-FR1E471
C804, C805: 10u 16V 10% low-ESR; CP_EIA-3528-21_Kemet-B; MPN TPSB106K016R0800
D610: STATUS green; LED_0603_1608Metric; MPN LTST-C190GKT
D611: ERR red; LED_0603_1608Metric; MPN LTST-C190KRKT
D612: DEG_A yellow; LED_0603_1608Metric; MPN LTST-C190KSKT
D613: DEG_B yellow; LED_0603_1608Metric; MPN LTST-C190KSKT
D800, D801, D802, D803, D804, D805, D806, D807: SK520B; D_SMB; MPN SK520B
FB60: 600R @100MHz; L_0603_1608Metric; MPN 742863160
J2, J3: Current test; PinHeader_1x04_P2.54mm_Vertical
J20: CAN A isolation; PinHeader_2x02_P2.54mm_Vertical
J21: CAN A test; PinHeader_1x04_P2.54mm_Vertical
J24: CAN B isolation; PinHeader_2x02_P2.54mm_Vertical
J25: CAN B test; PinHeader_1x04_P2.54mm_Vertical
J80: LEFT motor; Hirose_DF63M-2P-3.96DSA_1x02_P3.96mm_Vertical; MPN DF63M-2P-3.96DSA
J81: RIGHT motor; Hirose_DF63M-2P-3.96DSA_1x02_P3.96mm_Vertical; MPN DF63M-2P-3.96DSA
J82: LEFT encoder; PinHeader_1x04_P2.54mm_Vertical; MPN 2.54 mm breakaway header
J83: RIGHT encoder; PinHeader_1x04_P2.54mm_Vertical; MPN 2.54 mm breakaway header
J600: BOOT recovery; PinHeader_1x02_P2.54mm_Vertical; MPN 2.54 mm breakaway header
J601: SWD (2.54mm); PinHeader_1x06_P2.54mm_Vertical; MPN 2.54 mm breakaway header
J602: 3.3V TTL UART; PinHeader_1x03_P2.54mm_Vertical; MPN 2.54 mm breakaway header
J603: LAB3 rows 1-13; PinHeader_1x13_P2.54mm_Vertical; MPN 2.54 mm breakaway header
J604: Additional probes; PinHeader_1x11_P2.54mm_Vertical; MPN 2.54 mm breakaway header
J605: Reserved / encoder probes; PinHeader_1x07_P2.54mm_Vertical; MPN 2.54 mm breakaway header
J650: REAR LEFT lamp; PinHeader_1x02_P2.54mm_Vertical; MPN 2.54 mm breakaway header
J651: REAR RIGHT lamp; PinHeader_1x02_P2.54mm_Vertical; MPN 2.54 mm breakaway header
JP20: TERM A; PinHeader_1x02_P2.54mm_Vertical
JP24: TERM B; PinHeader_1x02_P2.54mm_Vertical
Q650, Q651: MMBT3904; SOT-23; MPN MMBT3904-7-F
R3, R4, R6, R7, R200, R201, R240, R241, R804, R805, R806, R807: 10k; R_0603_1608Metric; MPN CRCW060310K0FKEA
R5, R8, R610, R611, R612, R613: 1k; R_0603_1608Metric; MPN ERJ-3EKF1001V
R202, R242: 120R; R_0603_1608Metric; MPN RC0603FR-07120RL
R600: 10k BOOT0; R_0603_1608Metric; MPN CRCW060310K0FKEA
R601: 10k NRST; R_0603_1608Metric; MPN CRCW060310K0FKEA
R602: 10k TEST pullup; R_0603_1608Metric; MPN CRCW060310K0FKEA
R630, R631, R632, R633, R634, R635: 10k boot pulldown; R_0603_1608Metric; MPN CRCW060310K0FKEA
R650, R651: 2.2k; R_0603_1608Metric; MPN CRCW06032K20FKEA
R660, R661: 100k; R_0603_1608Metric; MPN CRCW0603100KFKEA
R670, R671: 220R; R_0603_1608Metric; MPN CRCW0603220RFKEA
R800, R801, R802, R803: 100R; R_0603_1608Metric; MPN CRCW0603100RFKEA
SW60, SW61: SWT0210-045026GSA; GCT_SWT0210_4.5x4.5mm; MPN SWT0210-045026GSA
U2, U3: ACS712ELCTR-05B-T; SOIC-8_3.9x4.9mm_P1.27mm; MPN ACS712ELCTR-05B-T
U20, U24: MCP2515T-I/ST; TSSOP-20_4.4x6.5mm_P0.65mm; MPN MCP2515T-I/ST
U21, U25: SN65HVD231DR; SOIC-8_3.9x4.9mm_P1.27mm; MPN SN65HVD231DR
U60: STM32F401RET6TR; LQFP-64_10x10mm_P0.5mm; MPN STM32F401RET6TR
U80: L298N; ST_L298N_Multiwatt15V_D1.1; MPN L298N
U81: SN74LVC14APWR; TSSOP-14_4.4x5mm_P0.65mm; MPN SN74LVC14APWR
U82: MCP1700-4002E/TO; TO-92_Inline_Wide; MPN MCP1700-4002E/TO
Y20, Y24: 16 MHz; Crystal_SMD_3225-4Pin_3.2x2.5mm; MPN CX3225SB16000H0FLJCC

Connections:
/+3V3: C203.1, C204.1, C243.1, C244.1, C600.1, C601.1, C602.1, C603.1, C604.1, C605.1, C803.1, FB60.1, J600.1, J601.1, R200.1, R201.1, R240.1, R241.1, R601.1, R602.1, R804.1, R805.1, R806.1, R807.1, U20.4 (~TX0RTS), U20.5 (~TX1RTS), U20.7 (~TX2RTS), U20.20 (VDD), U21.3 (VCC), U24.4 (~TX0RTS), U24.5 (~TX1RTS), U24.7 (~TX2RTS), U24.20 (VDD), U25.3 (VCC), U60.1 (VBAT), U60.19 (VDD), U60.32 (VDD), U60.48 (VDD), U60.64 (VDD), U81.14 (VCC); also elsewhere on the board
/+5V: C3.1, C6.1, C801.1, C804.1, R670.1, R671.1, U2.8 (VCC), U3.8 (VCC), U80.9 (Vss), U82.2 (VI); also elsewhere on the board
/CAN_A_H: J20.2, J21.3, JP20.1 (A); also elsewhere on the board
/CAN_A_L: J20.4, J21.4, R202.2; also elsewhere on the board
/CAN_B_H: J24.2, J25.3, JP24.1 (A); also elsewhere on the board
/CAN_B_L: J24.4, J25.4, R242.2; also elsewhere on the board
/GND: C3.2, C4.2, C5.2, C6.2, C7.2, C8.2, C200.2, C201.2, C202.2, C203.2, C204.2, C240.2, C241.2, C242.2, C243.2, C244.2, C600.2, C601.2, C602.2, C603.2, C604.2, C605.2, C606.2, C607.2, C608.2, C609.2, C610.2, C800.2, C801.2, C802.2, C803.2, C804.2, C805.2, D610.1 (K), D611.1 (K), D612.1 (K), D613.1 (K), D801.2 (A), D803.2 (A), D805.2 (A), D807.2 (A), J2.4, J3.4, J82.2, J83.2, J601.3, J601.6, J602.3, J603.1, J603.2, J604.1, J604.2, J605.1, J605.2, Q650.2 (E), Q651.2 (E), R4.2, R7.2, R600.2, R630.2, R631.2, R632.2, R633.2, R634.2, R635.2, R660.2, R661.2, SW60.2, SW61.2, U2.5 (GND), U3.5 (GND), U20.10 (VSS), U21.2 (GND), U21.8 (Rs), U24.10 (VSS), U25.2 (GND), U25.8 (Rs), U60.12 (VSSA), U60.18 (VSS), U60.31 (VSS), U60.47 (VSS), U60.63 (VSS), U80.1 (SENSE_A), U80.8 (GND), U80.15 (SENSE_B), U81.7 (GND), U81.11 (5A), U81.13 (6A), U82.1 (GND), Y20.2 (G), Y20.4 (G), Y24.2 (G), Y24.4 (G); also elsewhere on the board
/Rear zone/ENC_4V: C805.1, J82.1, J83.1, U82.3 (VO)
/Rear zone/LEFT_ADC: C5.1, J2.3, J604.10, R5.2, U60.16 (PA2)
/Rear zone/LEFT_BRIDGE: U2.1 (IP+), U2.2 (IP+), U80.2 (OUT1)
/Rear zone/LEFT_ENC_A_IN: R800.2, U81.1 (1A)
/Rear zone/LEFT_ENC_A_RAW: J82.3, R800.1, R804.2
/Rear zone/LEFT_ENC_B_IN: R801.2, U81.3 (2A)
/Rear zone/LEFT_ENC_B_RAW: J82.4, R801.1, R805.2
/Rear zone/LEFT_FILTER: C4.1, U2.6 (FILTER)
/Rear zone/LEFT_MOTOR: D800.2 (A), D801.1 (K), J80.1, U2.3 (IP-), U2.4 (IP-)
/Rear zone/LEFT_RAW: J2.1, R3.1, U2.7 (VIOUT)
/Rear zone/LEFT_RETURN: D802.2 (A), D803.1 (K), J80.2, U80.3 (OUT2)
/Rear zone/LEFT_SCALED: J2.2, R3.2, R4.1, R5.1
/Rear zone/RIGHT_ADC: C8.1, J3.3, J604.11, R8.2, U60.17 (PA3)
/Rear zone/RIGHT_BRIDGE: U3.1 (IP+), U3.2 (IP+), U80.13 (OUT3)
/Rear zone/RIGHT_ENC_A_IN: R802.2, U81.5 (3A)
/Rear zone/RIGHT_ENC_A_RAW: J83.3, R802.1, R806.2
/Rear zone/RIGHT_ENC_B_IN: R803.2, U81.9 (4A)
/Rear zone/RIGHT_ENC_B_RAW: J83.4, R803.1, R807.2
/Rear zone/RIGHT_FILTER: C7.1, U3.6 (FILTER)
/Rear zone/RIGHT_MOTOR: D804.2 (A), D805.1 (K), J81.1, U3.3 (IP-), U3.4 (IP-)
/Rear zone/RIGHT_RAW: J3.1, R6.1, U3.7 (VIOUT)
/Rear zone/RIGHT_RETURN: D806.2 (A), D807.1 (K), J81.2, U80.14 (OUT4)
/Rear zone/RIGHT_SCALED: J3.2, R6.2, R7.1, R8.1
/Rear zone/R_A_H_LOCAL: J20.1, U21.7 (CANH)
/Rear zone/R_A_L_LOCAL: J20.3, U21.6 (CANL)
/Rear zone/R_A_OSC1: C200.1, U20.9 (OSC1), Y20.1
/Rear zone/R_A_OSC2: C201.1, U20.8 (OSC2), Y20.3
/Rear zone/R_A_RESET: C202.1, R200.2, U20.19 (~RESET)
/Rear zone/R_A_RXD: J21.2, U20.2 (RXCAN), U21.4 (R)
/Rear zone/R_A_TERM: JP20.2 (B), R202.1
/Rear zone/R_A_TXD: J21.1, U20.1 (TXCAN), U21.1 (D)
/Rear zone/R_BOOT0: J600.2, R600.1, U60.60 (BOOT0)
/Rear zone/R_B_H_LOCAL: J24.1, U25.7 (CANH)
/Rear zone/R_B_L_LOCAL: J24.3, U25.6 (CANL)
/Rear zone/R_B_OSC1: C240.1, U24.9 (OSC1), Y24.1
/Rear zone/R_B_OSC2: C241.1, U24.8 (OSC2), Y24.3
/Rear zone/R_B_RESET: C242.1, R240.2, U24.19 (~RESET)
/Rear zone/R_B_RXD: J25.2, U24.2 (RXCAN), U25.4 (R)
/Rear zone/R_B_TERM: JP24.2 (B), R242.1
/Rear zone/R_B_TXD: J25.1, U24.1 (TXCAN), U25.1 (D)
/Rear zone/R_CS_A: R201.2, U20.18 (~CS), U60.58 (PB6)
/Rear zone/R_CS_B: R241.2, U24.18 (~CS), U60.38 (PC7)
/Rear zone/R_DEG_A_LED: J603.7, R612.1, U60.26 (PB0)
/Rear zone/R_DEG_A_LED_ANODE: D612.2 (A), R612.2
/Rear zone/R_DEG_B_LED: J603.8, R613.1, U60.27 (PB1)
/Rear zone/R_DEG_B_LED_ANODE: D613.2 (A), R613.2
/Rear zone/R_DIR_A_MARKER: J603.11, U60.29 (PB10)
/Rear zone/R_ERROR_LED: J604.4, R611.1, U60.8 (PC0)
/Rear zone/R_ERROR_LED_ANODE: D611.2 (A), R611.2
/Rear zone/R_INT_A: U20.13 (~INT), U60.43 (PA10)
/Rear zone/R_INT_B: U24.13 (~INT), U60.57 (PB5)
/Rear zone/R_LEFT_ENABLE_PWM: J603.10, R630.1, U60.42 (PA9), U80.6 (EnA)
/Rear zone/R_LEFT_ENC_A: J605.3, U60.28 (PB2), U81.2 (1Y)
/Rear zone/R_LEFT_ENC_B: J605.4, U60.55 (PB3), U81.4 (2Y)
/Rear zone/R_LEFT_IN1: R632.1, U60.34 (PB13), U80.5 (IN1)
/Rear zone/R_LEFT_IN2: R633.1, U60.35 (PB14), U80.7 (IN2)
/Rear zone/R_MISO: U20.17 (SO), U24.17 (SO), U60.22 (PA6)
/Rear zone/R_MOSI: U20.16 (SI), U24.16 (SI), U60.23 (PA7)
/Rear zone/R_OVERLOAD_MARKER: J604.9, U60.52 (PC11)
/Rear zone/R_PID_MARKER: J604.7, U60.40 (PC9)
/Rear zone/R_PWM_SET_MARKER: J603.9, U60.62 (PB9)
/Rear zone/R_REAR_LEFT_LED: J603.12, R650.1, U60.24 (PC4)
/Rear zone/R_REAR_LEFT_LED_BASE: Q650.1 (B), R650.2, R660.1
/Rear zone/R_REAR_LEFT_LED_PLUS: J650.1, R670.2
/Rear zone/R_REAR_LEFT_LED_SINK: J650.2, Q650.3 (C)
/Rear zone/R_REAR_RIGHT_LED: J603.13, R651.1, U60.25 (PC5)
/Rear zone/R_REAR_RIGHT_LED_BASE: Q651.1 (B), R651.2, R661.1
/Rear zone/R_REAR_RIGHT_LED_PLUS: J651.1, R671.2
/Rear zone/R_REAR_RIGHT_LED_SINK: J651.2, Q651.3 (C)
/Rear zone/R_RELAY_TX_MARKER: J605.7, U60.37 (PC6)
/Rear zone/R_RESET_N: C609.1, J601.5, R601.2, SW60.1, U60.7 (NRST)
/Rear zone/R_RIGHT_ENABLE_PWM: J604.8, R631.1, U60.59 (PB7), U80.11 (EnB)
/Rear zone/R_RIGHT_ENC_A: J605.5, U60.56 (PB4), U81.6 (3Y)
/Rear zone/R_RIGHT_ENC_B: J605.6, U60.33 (PB12), U81.8 (4Y)
/Rear zone/R_RIGHT_IN3: R634.1, U60.36 (PB15), U80.10 (IN3)
/Rear zone/R_RIGHT_IN4: R635.1, U60.51 (PC10), U80.12 (IN4)
/Rear zone/R_RX_A_MARKER: J603.3, U60.10 (PC2)
/Rear zone/R_RX_B_MARKER: J603.4, U60.11 (PC3)
/Rear zone/R_SCK: U20.14 (SCK), U24.14 (SCK), U60.21 (PA5)
/Rear zone/R_SELFTEST_BUTTON: C610.1, J604.3, R602.2, SW61.1, U60.2 (PC13)
/Rear zone/R_STATUS_LED: R610.1, U60.50 (PA15)
/Rear zone/R_STATUS_LED_ANODE: D610.2 (A), R610.2
/Rear zone/R_STEER_TASK_MARKER: J604.6, U60.9 (PC1)
/Rear zone/R_SWCLK: J601.2, U60.49 (PA14)
/Rear zone/R_SWDIO: J601.4, U60.46 (PA13)
/Rear zone/R_TASK_PROBE: J604.5, U60.39 (PC8)
/Rear zone/R_TX_A_MARKER: J603.5, U60.14 (PA0)
/Rear zone/R_TX_B_MARKER: J603.6, U60.15 (PA1)
/Rear zone/R_UART_CONSOLE_RX: J602.2, U60.45 (PA12)
/Rear zone/R_UART_CONSOLE_TX: J602.1, U60.44 (PA11)
/Rear zone/R_VCAP1: C606.1, U60.30 (VCAP1)
/Rear zone/R_VDDA: C607.1, C608.1, FB60.2, U60.13 (VREF+)
/VBAT_PROTECTED: C800.1, C802.1, D800.1 (K), D802.1 (K), D804.1 (K), D806.1 (K), U80.4 (Vs); also elsewhere on the board

Notes on the sheet:
CAN A: controller, transceiver and isolation
16 MHz; SPI from zone processor
CAN B: controller, transceiver and isolation
STM32F401: processor, supplies and recovery
100 nF at each VDD pin; VCAP is a dedicated regulator output.
Motor H-bridge / output clamps / connectors
All flyback clamps are on the motor side of the ACS712. Recirculation can bypass the sensor; telemetry is not complete phase current.
Left motor current / ADC filter
Right motor current / ADC filter
Encoder power / 5 V-tolerant Schmitt inputs
Vehicle lamps
Accessible test headers

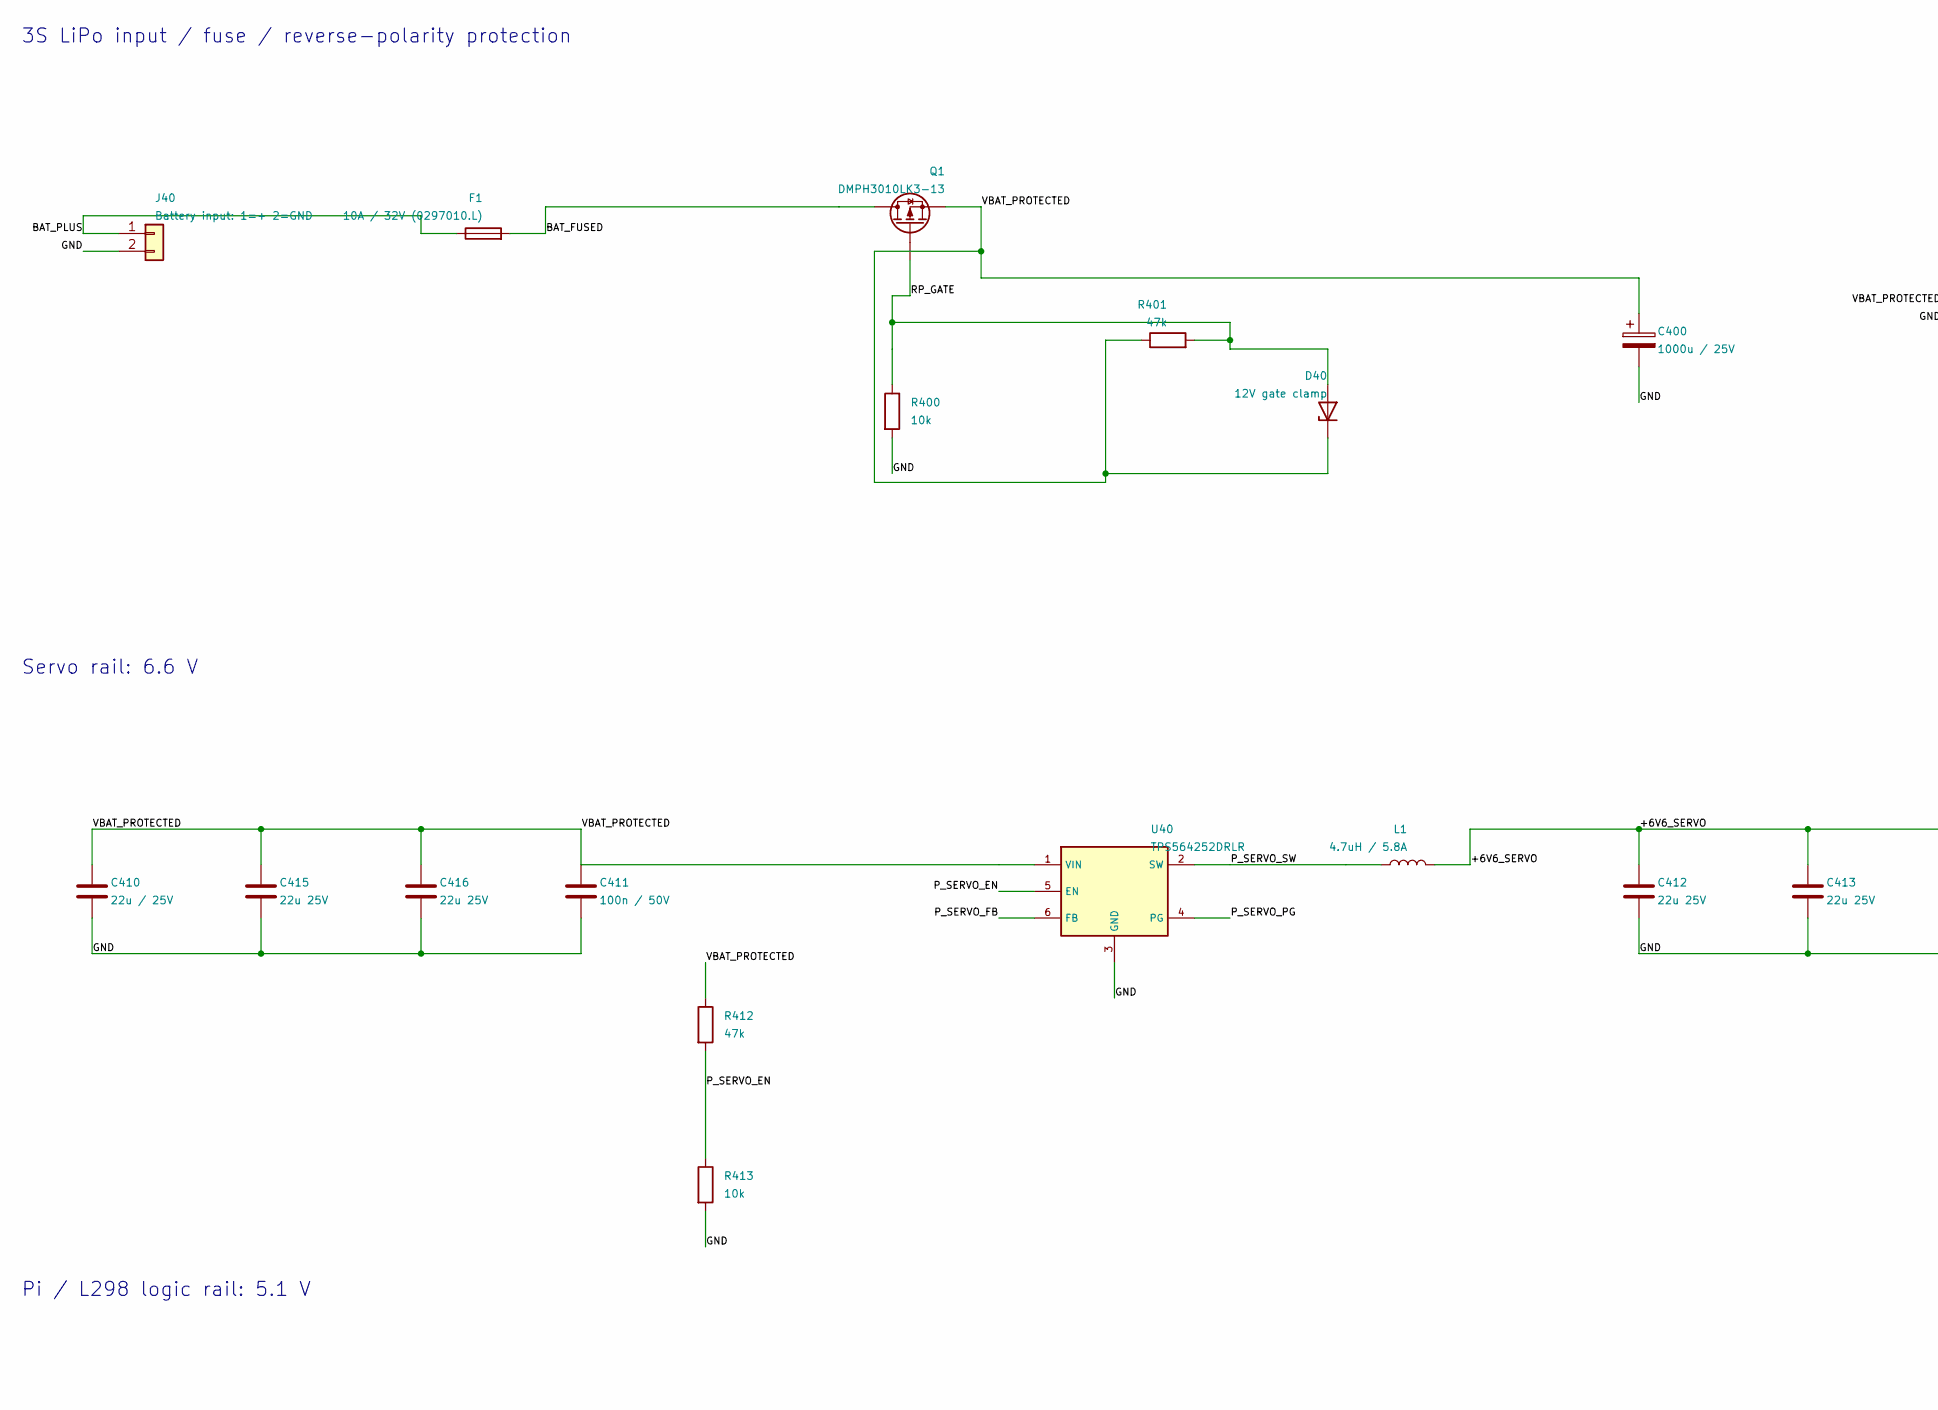
[picture p49: schematic Power.kicad_sch, Power: input protection and regulated rails, part in row 1, column 1]

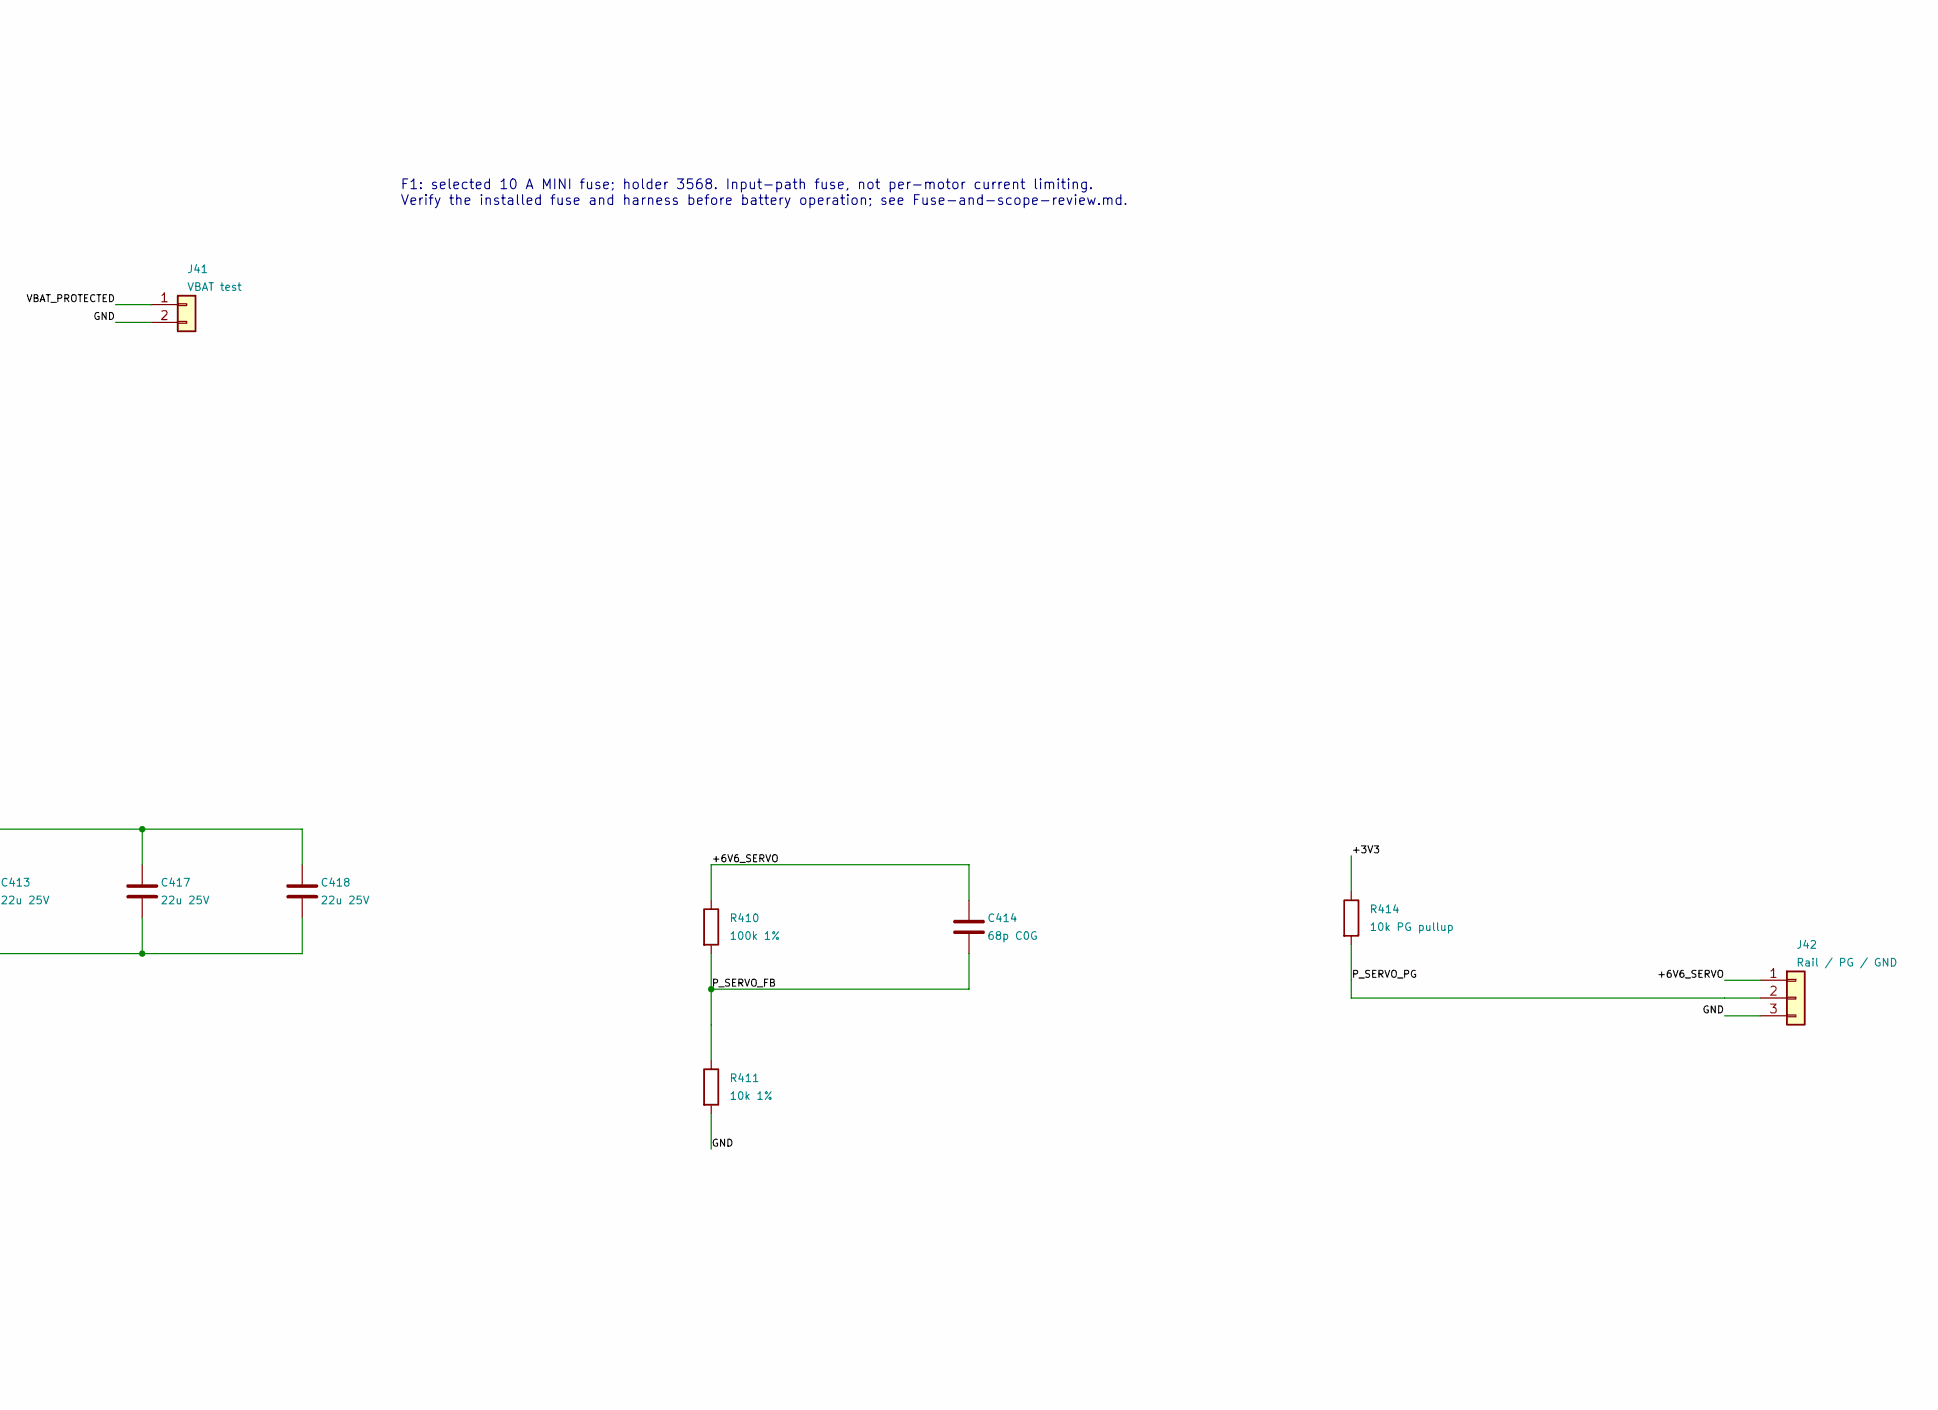
[picture p50: schematic Power.kicad_sch, Power: input protection and regulated rails, part in row 1, column 2]

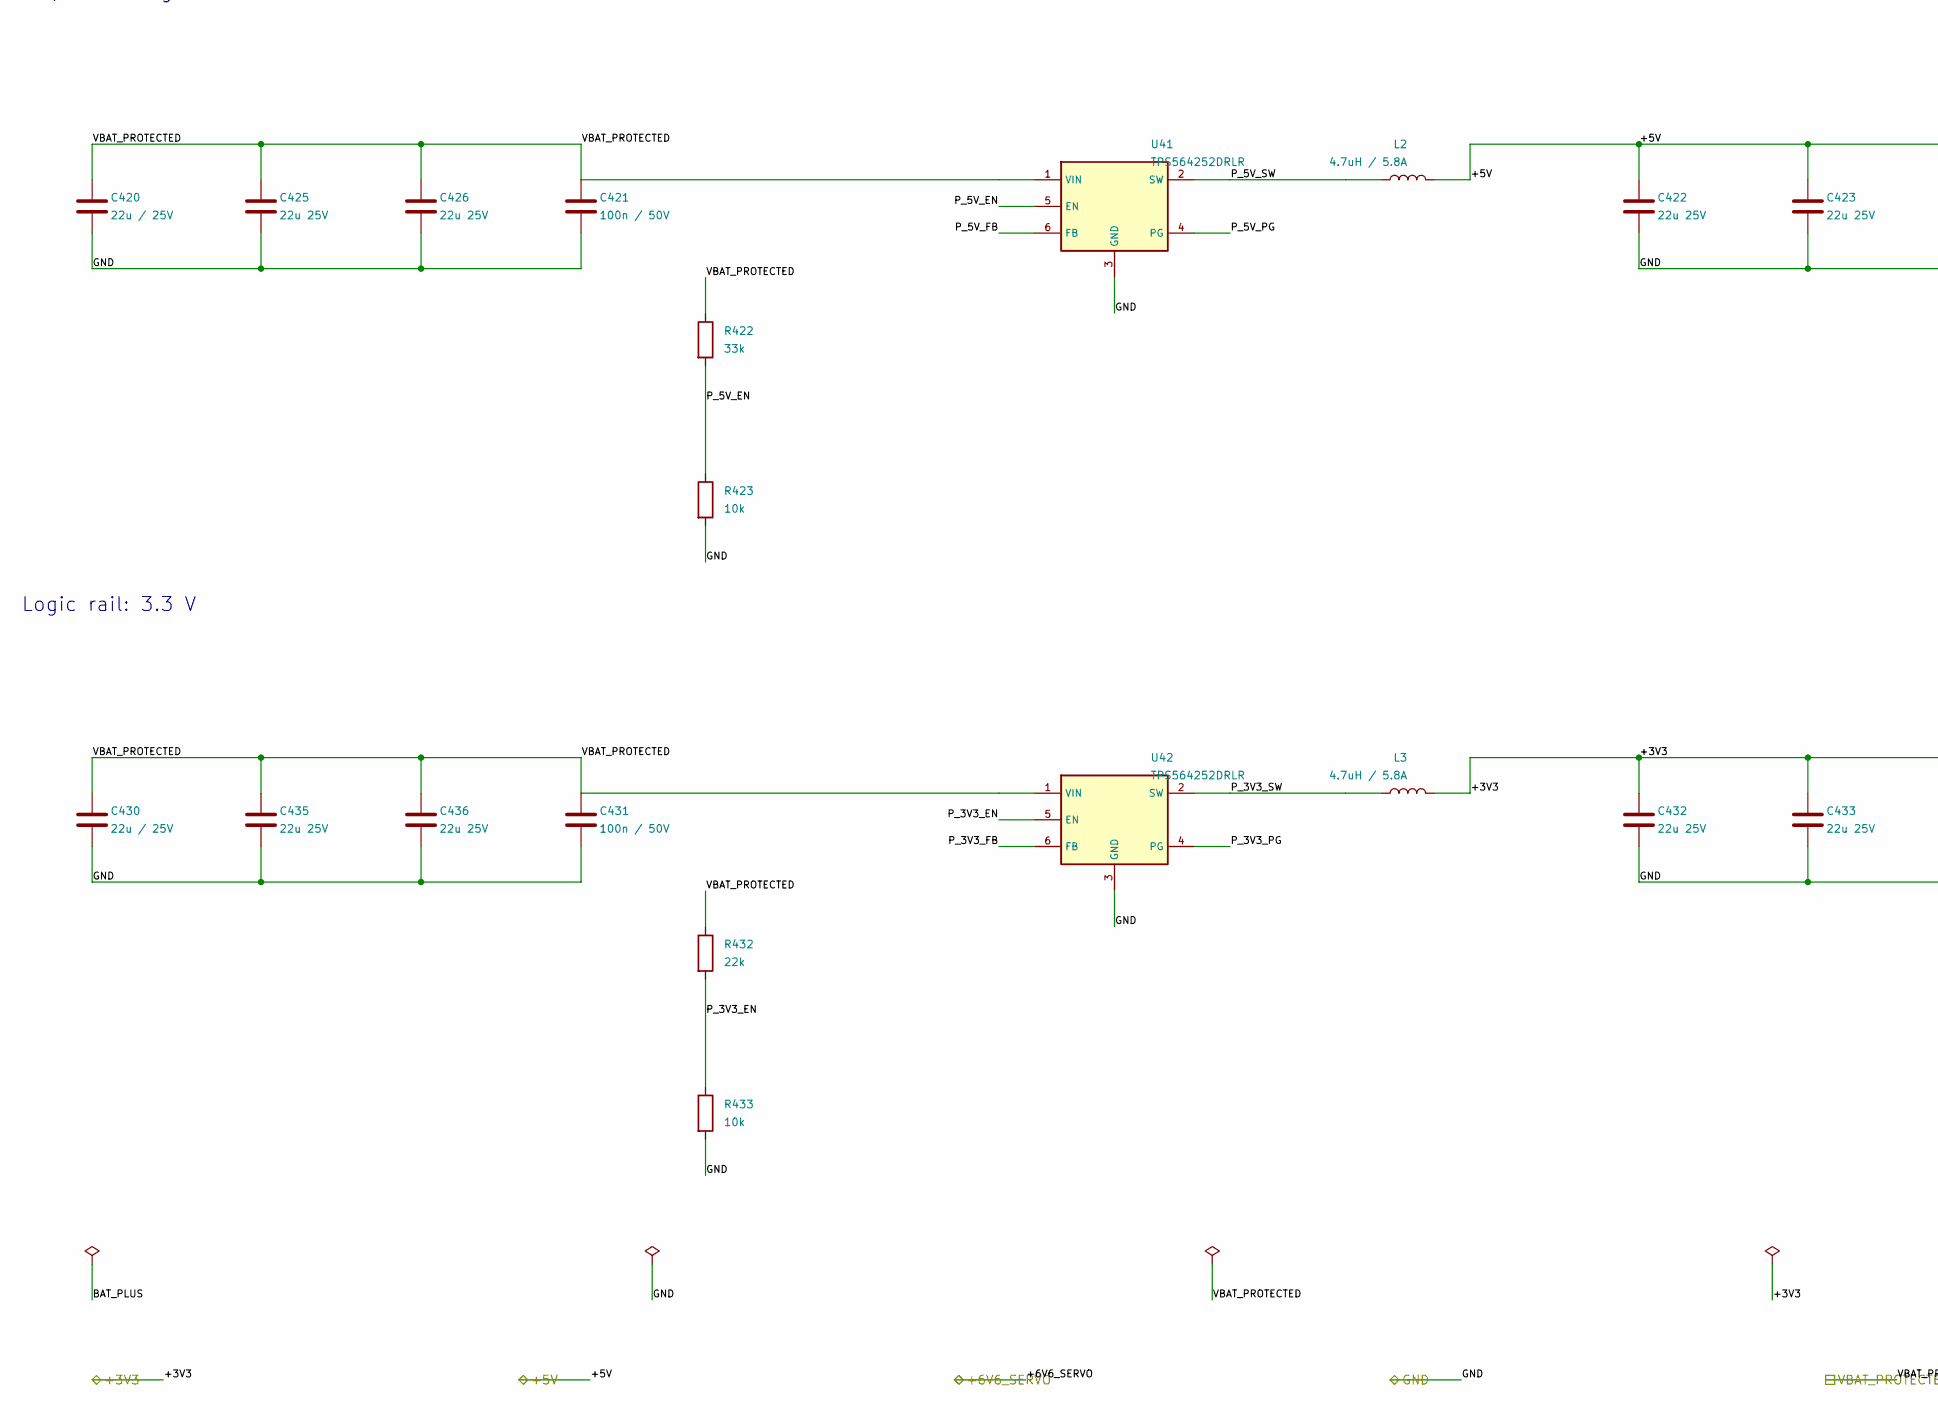
[picture p51: schematic Power.kicad_sch, Power: input protection and regulated rails, part in row 2, column 1]

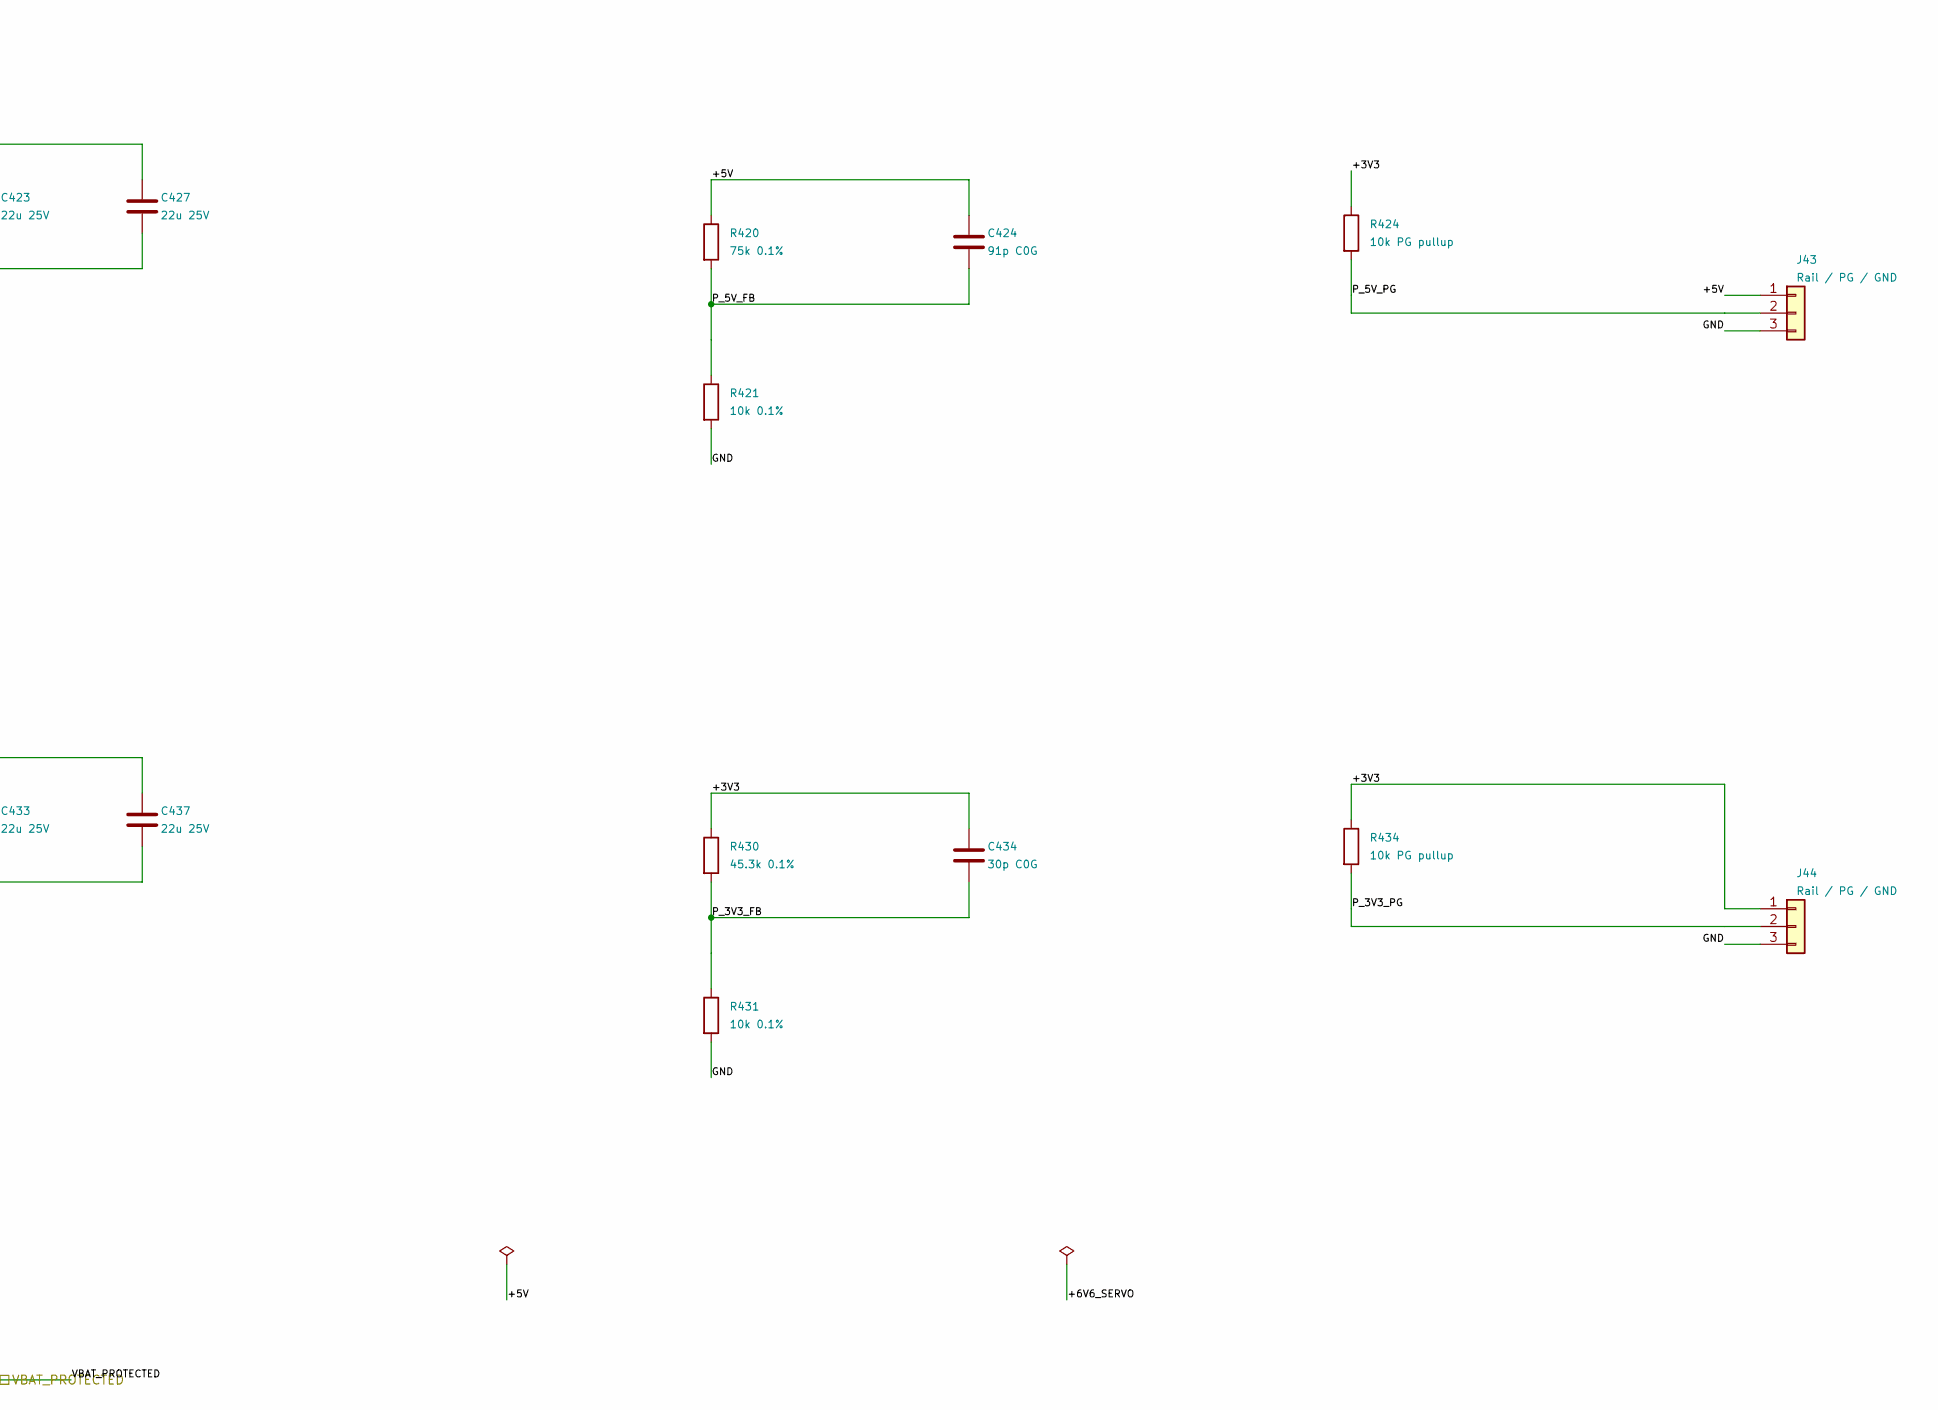
[picture p52: schematic Power.kicad_sch, Power: input protection and regulated rails, part in row 2, column 2]

Parts:
C400: 1000u / 25V; CP_Radial_D12.5mm_P5.00mm; MPN UPW1E102MHD
C410, C420, C430: 22u / 25V; C_1210_3225Metric; MPN GRM32ER61E226KE15L
C411, C421, C431: 100n / 50V; C_0603_1608Metric; MPN GRM188R71H104KA93D
C412, C413, C415, C416, C417, C418, C422, C423, C425, C426, C427, C432, C433, C435, C436, C437: 22u 25V; C_1210_3225Metric; MPN GRM32ER61E226KE15L
C414: 68p C0G; C_0603_1608Metric; MPN GRM1885C1H680JA01D
C424: 91p C0G; C_0603_1608Metric; MPN GRM1885C1H910JA01D
C434: 30p C0G; C_0603_1608Metric; MPN GRM1885C1H300JA01D
D40: 12V gate clamp; D_SOD-123F; MPN BZT52C12
F1: 10A / 32V (0297010.L); Fuseholder_Blade_Mini_Keystone_3568; MPN 3568
J40: Battery input: 1=+ 2=GND; Hirose_DF63M-2P-3.96DSA_1x02_P3.96mm_Vertical; MPN DF63M-2P-3.96DSA
J41: VBAT test; PinHeader_1x02_P2.54mm_Vertical
J42, J43, J44: Rail / PG / GND; PinHeader_1x03_P2.54mm_Vertical
L1, L2, L3: 4.7uH / 5.8A; Eaton_SDCHA1V8040; MPN SDCHA1V8040-4R7-R
Q1: DMPH3010LK3-13; TO-252-2; MPN DMPH3010LK3-13
R400, R413, R423, R433: 10k; R_0603_1608Metric; MPN CRCW060310K0FKEA
R401, R412: 47k; R_0603_1608Metric; MPN RC0603FR-0747KL
R410: 100k 1%; R_0603_1608Metric; MPN RC0603FR-07100KL
R411: 10k 1%; R_0603_1608Metric; MPN CRCW060310K0FKEA
R414, R424, R434: 10k PG pullup; R_0603_1608Metric; MPN CRCW060310K0FKEA
R420: 75k 0.1%; R_0603_1608Metric; MPN RT0603BRD0775KL
R421, R431: 10k 0.1%; R_0603_1608Metric; MPN RT0603BRD0710KL
R422: 33k; R_0603_1608Metric; MPN RC0603FR-0733KL
R430: 45.3k 0.1%; R_0603_1608Metric; MPN RT0603BRD0745K3L
R432: 22k; R_0603_1608Metric; MPN RC0603FR-0722KL
U40, U41, U42: TPS564252DRLR; SOT-563; MPN TPS564252DRLR

Connections:
/+3V3: C432.1, C433.1, C434.1, C437.1, J44.1, L3.2, R414.1, R424.1, R430.1, R434.1; also elsewhere on the board
/+5V: C422.1, C423.1, C424.1, C427.1, J43.1, L2.2, R420.1; also elsewhere on the board
/+6V6_SERVO: C412.1, C413.1, C414.1, C417.1, C418.1, J42.1, L1.2, R410.1; also elsewhere on the board
/GND: C400.2, C410.2, C411.2, C412.2, C413.2, C415.2, C416.2, C417.2, C418.2, C420.2, C421.2, C422.2, C423.2, C425.2, C426.2, C427.2, C430.2, C431.2, C432.2, C433.2, C435.2, C436.2, C437.2, J40.2, J41.2, J42.3, J43.3, J44.3, R400.2, R411.2, R413.2, R421.2, R423.2, R431.2, R433.2, U40.3 (GND), U41.3 (GND), U42.3 (GND); also elsewhere on the board
/Power/BAT_FUSED: F1.2, Q1.2 (D)
/Power/BAT_PLUS: F1.1, J40.1
/Power/P_3V3_EN: R432.2, R433.1, U42.5 (EN)
/Power/P_3V3_FB: C434.2, R430.2, R431.1, U42.6 (FB)
/Power/P_3V3_PG: J44.2, R434.2, U42.4 (PG)
/Power/P_3V3_SW: L3.1, U42.2 (SW)
/Power/P_5V_EN: R422.2, R423.1, U41.5 (EN)
/Power/P_5V_FB: C424.2, R420.2, R421.1, U41.6 (FB)
/Power/P_5V_PG: J43.2, R424.2, U41.4 (PG)
/Power/P_5V_SW: L2.1, U41.2 (SW)
/Power/P_SERVO_EN: R412.2, R413.1, U40.5 (EN)
/Power/P_SERVO_FB: C414.2, R410.2, R411.1, U40.6 (FB)
/Power/P_SERVO_PG: J42.2, R414.2, U40.4 (PG)
/Power/P_SERVO_SW: L1.1, U40.2 (SW)
/Power/RP_GATE: D40.2 (A), Q1.1 (G), R400.1, R401.2
/VBAT_PROTECTED: C400.1, C410.1, C411.1, C415.1, C416.1, C420.1, C421.1, C425.1, C426.1, C430.1, C431.1, C435.1, C436.1, D40.1 (K), J41.1, Q1.3 (S), R401.1, R412.1, R422.1, R432.1, U40.1 (VIN), U41.1 (VIN), U42.1 (VIN); also elsewhere on the board

Notes on the sheet:
3S LiPo input / fuse / reverse-polarity protection
F1: selected 10 A MINI fuse; holder 3568. Input-path fuse, not per-motor current limiting. Verify the installed fuse and harness before battery operation; see Fuse-and-scope-review.md.
Servo rail: 6.6 V
Pi / L298 logic rail: 5.1 V
Logic rail: 3.3 V

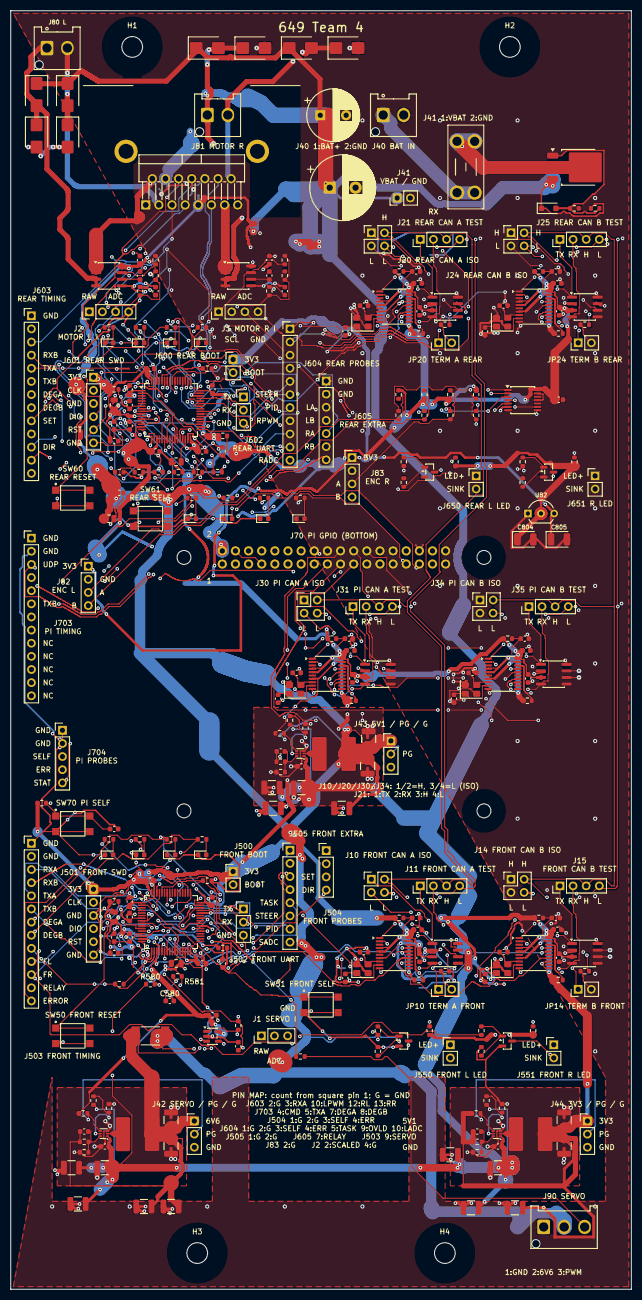
[picture p53: board Lab4.kicad_pcb from above]

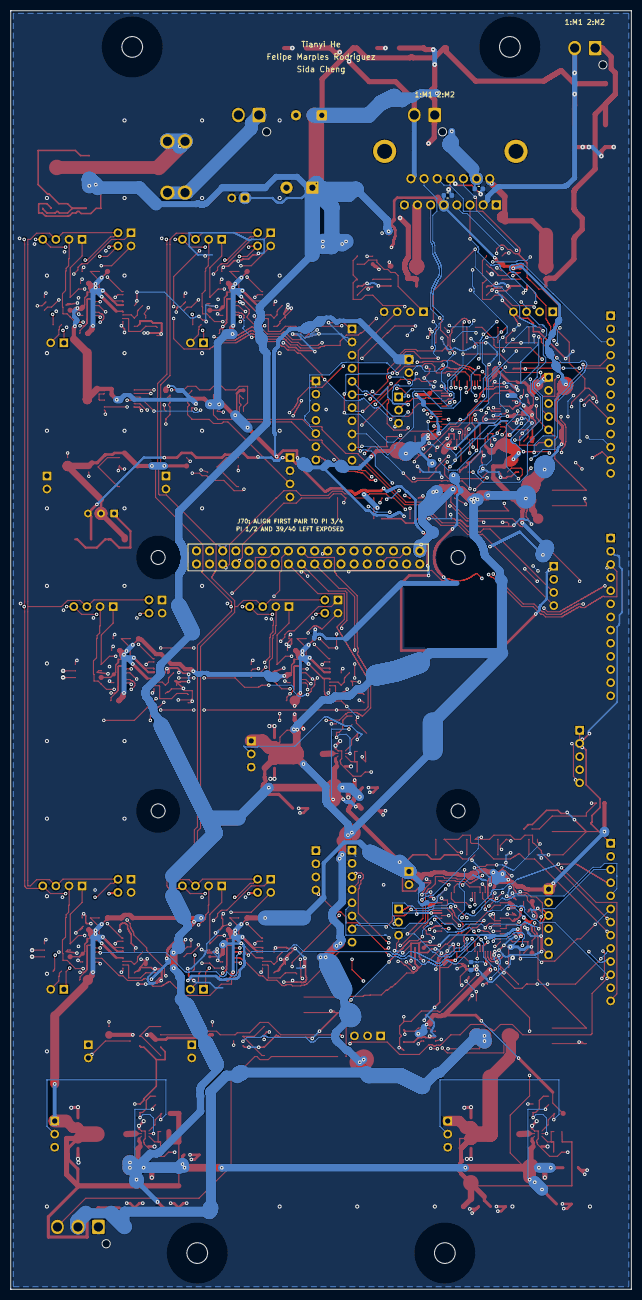
[picture p54: board Lab4.kicad_pcb from below]

Board: 4 copper layers, 120.0 x 247.2 mm, 309 parts (4 on the bottom side), 214 nets.

Other parts of the board:
H1, H2, H3, H4: M3 / 4.0mm clearance / 4mm exclusion; Chassis_support_M3_D4_4mm_edge
H5, H6, H7, H8: Pi support <=5.5mm hardware OD; Pi_support_M2.5_D5.5
HS80: 6396BG; Boyd_6396BG_StraightPins

Their connections:
/GND: HS80.MP1, HS80.MP2; also elsewhere on the board
