fmarples/18649_team4/pi/part2_bridge.py

#!/usr/bin/env python3
"""Wheel UDP -> CRC UART motor commands; STM status -> console/CSV.

Matching STM32 firmware drives motors. A latches a Pi-local hazard and silences
command TX so the MCU times out. Stale/invalid UDP otherwise sends a brake command.
"""
import argparse
import ipaddress
import socket
import time
from part2_protocol import (command, wheel_packet, pop_status, is_newer,
                            STATUS_UDP_PORT, status_frame)
from timing_gpio import create_trace

TX_PERIOD = 0.020
# 80 ms plus one brake frame targets the handout's stricter 100 ms response.
# This is a timing budget, not a measured whole-chain guarantee.
UDP_FRESH = 0.080


from bridge_diagnostics import BridgeDiagnostics, current_summary


# Pi-local A self-test: feed fresh wheel input; TX paths stay silent while active.
class HazardLatch:
    BUTTON = 1 << 0
    DOUBLE_MS = 400
    RELEASE_MS = 20

    def __init__(self):
        self.active = False
        self.was_down = False
        self.release_ms = None
        self.first_press_ms = None

    # Observe raw A at monotonic milliseconds; a held sample is not a new press.
    def update(self, now_ms, buttons):
        down = bool(buttons & self.BUTTON)
        if not down:
            if self.was_down:
                self.release_ms = now_ms
            self.was_down = False
            return
        if self.was_down:
            return
        self.was_down = True
        if self.release_ms is not None and now_ms - self.release_ms < self.RELEASE_MS:
            return  # Reject a short release/bounce, not a held press.
        if self.first_press_ms is not None and now_ms - self.first_press_ms <= self.DOUBLE_MS:
            self.active = False
            self.first_press_ms = None
        else:
            self.active = True  # Enter immediately, without waiting for a second press.
            self.first_press_ms = now_ms


def main():
    ap = argparse.ArgumentParser(description=__doc__)
    ap.add_argument('--serial', default='/dev/serial0')
    ap.add_argument('--mode', choices=('demo', 'live', 'bad-range', 'bad-crc'), default='live')
    ap.add_argument('--sender', help='Optional permitted laptop IPv4 address')
    ap.add_argument('--log', help='New CSV path for every received status frame')
    ap.add_argument('--trace-gpio', action='store_true', help='Reserve Pi BCM17/27 for scope markers (libgpiod v2)')
    ap.add_argument('--gpiochip', default='/dev/gpiochip0', help='Pi 4 BCM GPIO chip; verify using gpioinfo')
    ap.add_argument('--telemetry-host', type=ipaddress.IPv4Address,
                    help='Forward statuses to this laptop; otherwise learn its IP from valid wheel UDP')
    ap.add_argument('--telemetry-port', type=int, default=STATUS_UDP_PORT,
                    help='Laptop status listener; must not be command/force ports 8000/8001')
    args = ap.parse_args()
    if not 1 <= args.telemetry_port <= 65535 or args.telemetry_port in (8000, 8001):
        ap.error('Telemetry needs a separate port, not 8000 or 8001')
    telemetry_host = str(args.telemetry_host) if args.telemetry_host else None
    telemetry_error = None
    import serial
    udp = socket.socket(socket.AF_INET, socket.SOCK_DGRAM)
    if args.mode == 'live':
        udp.bind(('0.0.0.0', 8000))
    udp.setblocking(False)
    diagnostics = BridgeDiagnostics(args.log)
    try:
        with create_trace(args.trace_gpio, args.gpiochip) as trace, \
             serial.Serial(args.serial, 115200, timeout=0, write_timeout=0.050) as uart:
            def transmit(frame):
                trace.command_tx()
                if uart.write(frame) != len(frame):
                    raise OSError('Incomplete UART write; stopping bridge so STM32 times out.')
            uart.reset_input_buffer()
            started = time.monotonic()
            next_tx = started
            next_display = started
            last_udp = None
            previous_counter = None
            axes = None
            seq = 0
            buffer = bytearray()
            previous_status_seq = None
            previous_stm_ms = None
            no_status_notice = started + 2
            was_streaming = False
            discard_udp = False
            hazard = HazardLatch()
            diagnostics.message('MOTOR LINK mode=%s; UART=%s 115200 8N1; Ctrl+C stops TX.' %
                                (args.mode, args.serial))
            diagnostics.message('Live pedal commands can drive motors. Current validity comes from the STM32.')
            while True:
                now = time.monotonic()
                incoming = uart.read(4096)
                buffer.extend(incoming)
                for status in pop_status(buffer):
                    # Read-only, nonblocking return path. Never feed the proxy's force input.
                    if telemetry_host:
                        try:
                            udp.sendto(status_frame(status), (telemetry_host, args.telemetry_port))
                            telemetry_error = None
                        except OSError as error:
                            if telemetry_error != str(error):
                                diagnostics.message('Telemetry forwarding failed; vehicle link continues: ' + str(error))
                            telemetry_error = str(error)
                    status['pi_receive_s'] = now - started
                    gap = None if previous_status_seq is None else ((status['status_seq'] - previous_status_seq) & 0xffffffff)
                    interval = None if previous_stm_ms is None else ((status['stm_ms'] - previous_stm_ms) & 0xffffffff)
                    status['stm_interval_ms'] = interval if gap == 1 else None
                    previous_status_seq = status['status_seq']
                    previous_stm_ms = status['stm_ms']
                    no_status_notice = now + 2
                    diagnostics.status(status, now >= next_display)
                    if now >= next_display:
                        next_display = now + 0.25
                if now >= no_status_notice:
                    diagnostics.message('No valid STM status for 2s: check STM TX D8 -> Pi pin 10 and shared ground.')
                    no_status_notice = now + 2
                # Flush expired input before accepting a restarted UDP sequence.
                now = time.monotonic()  # Logging/status processing may have taken time.
                if last_udp is not None and now - last_udp >= UDP_FRESH:
                    if not hazard.active:
                        transmit(command(seq, 0, 32767, -32768, 0))
                        seq = (seq + 1) & 0xffffffff
                    axes = None
                    previous_counter = None
                    last_udp = None
                    discard_udp = True
                    if was_streaming:
                        diagnostics.message('UDP stale: brake sent; command transmission paused.')
                        was_streaming = False
                if args.mode == 'live':
                    # Bounded batch: still return to status handling under excess UDP load.
                    for _ in range(32):
                        try:
                            data, address = udp.recvfrom(4096)
                        except BlockingIOError:
                            discard_udp = False
                            break
                        trace.udp_rx()
                        # A scheduling pause must not turn old queued pedals into
                        # fresh input. Drain to empty before accepting recovery.
                        if discard_udp:
                            continue
                        if args.sender and address[0] != args.sender:
                            continue
                        try:
                            counter, *new_axes = wheel_packet(data)
                        except ValueError as err:
                            if not hazard.active:
                                transmit(command(seq, 0, 32767, -32768, 0))
                                seq = (seq + 1) & 0xffffffff
                            axes = None
                            # Keep the last valid counter/time while paused. Only
                            # a real freshness timeout permits a new baseline.
                            was_streaming = False
                            diagnostics.message('Rejected UDP input; TX paused%s: %s' %
                                                ('; brake sent' if not hazard.active else '; hazard latched', err))
                            continue
                        if not is_newer(counter, previous_counter):
                            continue
                        previous_counter = counter
                        if not args.telemetry_host:
                            telemetry_host = address[0]
                        axes = new_axes
                        last_udp = time.monotonic()
                        was_hazard = hazard.active
                        hazard.update(int(last_udp * 1000), axes[3])
                        axes[3] &= ~HazardLatch.BUTTON  # A is Pi-local; other buttons still reach the MCU.
                        if hazard.active != was_hazard:
                            diagnostics.message(
                                'A hazard latched; UART TX paused for MCU timeout.' if hazard.active else
                                'A hazard cleared; UART TX resumed.')
                        if hazard.active:
                            was_streaming = False
                            continue
                        # Forward every valid new UDP state outside the Pi hazard.
                        transmit(command(seq, *axes))
                        seq = (seq + 1) & 0xffffffff
                        next_tx = last_udp + TX_PERIOD
                        was_streaming = True
                elif now >= next_tx:
                    steering = (-20000, 0, 20000)[int(now - started) % 3]
                    axes = [40000 if args.mode == 'bad-range' else steering, 32767, 32767, 0]
                now = time.monotonic()
                if now >= next_tx and axes is not None and not hazard.active:
                    if args.mode != 'live' or (last_udp is not None and now - last_udp < UDP_FRESH):
                        frame = command(seq, *axes)
                        if args.mode == 'bad-crc':
                            frame = frame[:-1] + bytes([frame[-1] ^ 1])
                        transmit(frame)
                        seq = (seq + 1) & 0xffffffff
                    next_tx = now + TX_PERIOD
                time.sleep(0.001)
    except KeyboardInterrupt:
        diagnostics.message('Bridge stopped; STM should time out after the last valid command.')
    finally:
        udp.close()
        diagnostics.close()


if __name__ == '__main__':
    main()
