fmarples/18649_team4/lab4/export_review_package.py

"""Export a hash-checked KiCad review package; never marks fabrication released.

Run after check_fabrication.py and the BOM/placement checks. This creates a new
directory so stale files cannot silently enter a manufacturing archive.
"""
from pathlib import Path
import argparse
import hashlib
import json
import shutil
import subprocess
import zipfile

ROOT = Path(__file__).resolve().parent
LAYERS = 'F.Cu,In1.Cu,In2.Cu,B.Cu,F.Mask,B.Mask,F.SilkS,B.SilkS,F.Paste,B.Paste,Edge.Cuts'

def sha(path):
    return hashlib.sha256(path.read_bytes()).hexdigest()

def main():
    ap = argparse.ArgumentParser(description=__doc__)
    ap.add_argument('--kicad-cli', default='kicad-cli')
    ap.add_argument('--audit-dir', type=Path, required=True)
    ap.add_argument('--output-dir', type=Path, required=True)
    args = ap.parse_args()
    audit = json.loads((args.audit_dir/'summary.json').read_text())
    assert audit['automated_status'] == 'PASS'
    for name, digest in audit['source_sha256'].items():
        assert sha(ROOT/name) == digest, f'Stale audit: {name}'
    out = args.output_dir.resolve()
    out.mkdir(parents=True, exist_ok=False)
    gerber = out/'gerbers'
    gerber.mkdir()
    board = ROOT/'KiCad/Lab4.kicad_pcb'
    def cli(*command):
        subprocess.run([args.kicad_cli, *map(str, command)], check=True,
                       cwd=ROOT, timeout=300)
    cli('sch', 'export', 'pdf', '-o', out/'Lab4-Circuits.pdf',
        '--no-background-color', '--exclude-pdf-property-popups', ROOT/'KiCad/Lab4.kicad_sch')
    cli('pcb', 'export', 'gerbers', '-o', str(gerber)+'/', '-l', LAYERS,
        '--subtract-soldermask', '--check-zones', '--no-protel-ext', board)
    cli('pcb', 'export', 'drill', '-o', str(gerber)+'/', '--format', 'excellon',
        '--drill-origin', 'absolute', '--excellon-units', 'mm',
        '--excellon-separate-th', '--generate-map', '--map-format', 'pdf',
        '--generate-report', '--report-path', out/'Drill-report.txt', board)
    cli('pcb', 'export', 'pdf', '-o', out/'PCB-layers.pdf', '-l', LAYERS,
        '--cl', 'Edge.Cuts', '--mode-multipage', '--subtract-soldermask',
        '--check-zones', '--no-property-popups', '--scale', '0', board)
    cli('pcb', 'export', 'pos', '-o', out/'Positions-native.csv',
        '--format', 'csv', '--units', 'mm', '--side', 'both', board)
    for side in ('top', 'bottom'):
        cli('pcb', 'render', '-o', out/f'PCB-{side}.png', '--side', side,
            '--width', '1600', '--height', '1100', '--background', 'opaque', board)
    for filename in ('summary.json', 'drc.json', 'erc.json'):
        shutil.copy2(args.audit_dir/filename, out/filename)
    for filename in ('BOM-Hand-assembly.csv', 'Preliminary-BOM.csv', 'TEAM_4_BOM_Lab4.xlsx',
                     'Course-stock-v3.csv', 'Layer-stack.md',
                     'Lab4-Writeup.pdf', 'Fabrication-review.md',
                     'Power-margin-review.md', 'Assembly-options.md',
                     'Critical-package-review.md', 'Selected-package-check.json',
                     'Battery-LiPo.md', 'Course-updates-October29.md',
                     'Capacitor-bank-review.md', 'Power-route-revision.md',
                     'Power-route-revision-check.json', 'Fuse-and-scope-review.md',
                     'Pi-feed-review.md', 'Pi-feed-mesh-check.json',
                     'Prototype-operating-review.md', 'Prototype-power-check.json',
                     'Pi-operating-mesh-check.json', 'Power-budget.csv',
                     'Current-evidence.md',
                     'Actuator-design.md', 'Parts-review.md',
                     'Silkscreen-identification-review.md',
                     'Silkscreen-identification-check.json',
                     'November1-review.md', 'November1-review-check.json',
                     'November2-Anson-review.md', 'November2-Anson-review-check.json',
                     'Schematic-format-review.md', 'Schematic-format-check.json',
                     'Digital-geometry-check.json', 'Solder-via-check.json',
                     'CAN-geometry-review.md', 'CAN-geometry-check.json'):
        shutil.copy2(ROOT/filename, out/filename)
    warning = ('REVIEW ONLY - NOT RELEASED FOR FABRICATION\n\n'
        'Board name: 649 Team 4.\n'
        'Four copper layers; nominal 1.6 mm JLC04161H-7628 stack.\n'
        'Copper: 1 oz outer / 0.5 oz inner (35 / 15.2 / 15.2 / 35 um nominal).\n'
        'No 2 oz copper or controlled-impedance order is requested.\n'
        'This is a review export of the hashed sources, not an approved order.\n'
        'Prepared for course prototype review; team/TA acceptance and the order are not completed.\n'
        'See Prototype-operating-review.md for load assumptions, deferred stress work and required bring-up.\n'
        'The 10 A input fuse is conditional; no sustained high-current or powered qualification is claimed.\n'
        'This revision addresses Anson\'s November 2 schematic and placement review.\n'
        'The schematic is redrawn with unchanged pin nets; F1 identifies the existing 10 A candidate.\n'
        'Motor clamps, J80 and three bypass capacitors move; C500/C800/C801 are now bottom-side SMT.\n'
        'Two local CAN pairs are rerouted together; power/return and manufacturing checks are refreshed.\n'
        'Holes, outline, stack and BOM quantities are unchanged. Group names are on bottom silkscreen.\n'
        'See November2-Anson-review.md; older revision records describe their dated sources.\n'
        'Original 6945466 was submitted; 4895895 was linked to staff. These new files have not been sent.\n'
        '3D views use available library models; omitted custom parts are not fit evidence.\n'
        'Native positions use KiCad rotation conventions and mm/absolute origin.\n'
        'The team hand-assembly plan remains in force. No PCBA upload is authorized.\n')
    (out/'REVIEW-ONLY.txt').write_text(warning, encoding='utf-8')
    with zipfile.ZipFile(out/'Gerbers-REVIEW-ONLY.zip', 'w', zipfile.ZIP_DEFLATED) as z:
        for path in sorted(gerber.iterdir()):
            z.write(path, path.name)
        z.write(out/'REVIEW-ONLY.txt', 'REVIEW-ONLY.txt')
    for name, digest in audit['source_sha256'].items():
        assert sha(ROOT/name) == digest, f'Export changed source: {name}'
    manifest = dict(fabrication_release=False, copper_layers=4,
        source_sha256=audit['source_sha256'],
        files={str(p.relative_to(out)).replace('\\','/'):sha(p)
               for p in sorted(out.rglob('*')) if p.is_file()})
    (out/'manifest.json').write_text(json.dumps(manifest, indent=2)+'\n')
    print(f'Review package created: {out}; fabrication_release=False')

if __name__ == '__main__':
    main()
