fmarples/18649_team4/lab4/check_routing.py

"""Verify routed regulator, MCU, CAN, host and signal copper with KiCad's graph.

Run with KiCad's Python. This checks saved copper, not just schematic net names.
DRC, loop/thermal review and the rest of the board are separate requirements.
Zone objects can contain multiple filled islands. The grouped-zone graph is
not an island-continuity proof; inspect native DRC's unconnected items too.
"""
from pathlib import Path
from collections import Counter
import argparse
import hashlib
import json
import pcbnew as p

ROOT = Path(__file__).resolve().parent
parser = argparse.ArgumentParser(description=__doc__)
parser.add_argument('--board', type=Path, default=ROOT/'KiCad/Lab4.kicad_pcb')
parser.add_argument('--output', type=Path, default=ROOT/'Routing-check.json')
args = parser.parse_args()
source = args.board
board = p.LoadBoard(str(source))
board.BuildConnectivity()
connectivity = board.GetConnectivity()
pads = {(f.GetReference(), a.GetNumber()): a
        for f in board.GetFootprints() for a in f.Pads()}
pad_keys = {a.m_Uuid.AsString(): key for key, a in pads.items()}
reachable_cache = {}
physical_reachable_cache = {}


def reachable(seed):
    """Walk physically touching copper of the seed's net, including vias/zones."""
    seed_uid = seed.m_Uuid.AsString()
    if seed_uid in reachable_cache:
        return reachable_cache[seed_uid]
    # This API already returns the full connected component, not neighbours.
    seen = {a.m_Uuid.AsString() for a in connectivity.GetConnectedItems(seed)
            if a.GetNetCode() == seed.GetNetCode()}
    seen.add(seed_uid)
    result = {pad_keys[uid] for uid in seen if uid in pad_keys}
    for uid in seen:
        reachable_cache[uid] = result
        physical_reachable_cache[uid] = seen
    return result


checks = []
errors = []
def check_group(reference, name, members):
    seed = pads[members[0]]
    same_net = all(pads[m].GetNetCode() == seed.GetNetCode() for m in members)
    missing = sorted(set(members)-reachable(seed))
    if not same_net or missing:
        errors.append({'reference': reference, 'group': name, 'same_net': same_net,
                       'unreachable_pads': missing})
    checks.append({'reference': reference, 'group': name, 'net': seed.GetNetname(),
                   'pads': ['.'.join(m) for m in members],
                   'physically_connected': same_net and not missing})

check_group('Battery', 'ADC divider/filter', [('U50','17'),('R580','2'),('R581','1'),('C580','1')])
check_group('Battery', 'protected input', [('R580','1'),('C410','1')])
check_group('Battery', 'sense ground', [('R581','2'),('C580','2'),('U50','18')])

for k in range(3):
    u, ind, j, base = f'U{40+k}', f'L{k+1}', f'J{42+k}', 410+10*k
    groups = {
        'SW': [(u, '2'), (ind, '1')],
        'FB': [(u, '6'), (f'R{base}', '2'), (f'R{base+1}', '1'), (f'C{base+4}', '2')],
        'EN': [(u, '5'), (f'R{base+2}', '2'), (f'R{base+3}', '1')],
        'PG': [(u, '4'), (f'R{base+4}', '2'), (j, '2')],
        'local VIN': [(u, '1'), (f'C{base}', '1'), (f'C{base+1}', '1'), (f'R{base+2}', '1')],
        'local output': [(ind, '2'), (f'C{base+2}', '1'), (f'C{base+3}', '1'),
                         (f'R{base}', '1'), (f'C{base+4}', '1'), (j, '1')],
        'local ground': [(u, '3'), (f'C{base}', '2'), (f'C{base+1}', '2'),
                         (f'C{base+2}', '2'), (f'C{base+3}', '2'),
                         (f'R{base+1}', '2'), (f'R{base+3}', '2'), (j, '3')],
    }
    for name, members in groups.items():
        check_group(u, name, members)
    for offset in [5,6,7]+([8] if k==0 else []):
        ref=f'C{base+offset}'
        check_group(u, ref+' positive',[(ref,'1'),(f'C{base}' if offset in [5,6] else ind,'1' if offset in [5,6] else '2')])
        check_group(u, ref+' ground',[(ref,'2'),(u,'3')])

for n in [10, 14, 20, 24, 30, 34]:
    u, t, j, test, y, base = f'U{n}', f'U{n+1}', f'J{n}', f'J{n+1}', f'Y{n}', n*10
    groups = {
        'OSC1': [(u, '9'), (y, '1'), (f'C{base}', '1')],
        'OSC2': [(u, '8'), (y, '3'), (f'C{base+1}', '1')],
        'RESET': [(u, '19'), (f'C{base+2}', '1'), (f'R{base}', '2')],
        'local supply': [(u, a) for a in ['4', '5', '7', '20']] +
                        [(t, '3'), (f'C{base+3}', '1'), (f'C{base+4}', '1'),
                         (f'R{base}', '1'), (f'R{base+1}', '1')],
        'CS pullup': [(u, '18'), (f'R{base+1}', '2')],
        'TXD': [(u, '1'), (t, '1'), (test, '1')],
        'RXD': [(u, '2'), (t, '4'), (test, '2')],
        'local ground': [(u, '10'), (t, '2'), (t, '8'), (y, '2'), (y, '4')] +
                        [(f'C{base+i}', '2') for i in range(5)],
        'CAN H to isolation': [(t, '7'), (j, '1')],
        'CAN L to isolation': [(t, '6'), (j, '3')],
        'backbone H node': [(j, '2'), (test, '3')],
        'backbone L node': [(j, '4'), (test, '4')],
    }
    if n < 30:
        groups['backbone H node'].append((f'JP{n}', '1'))
        groups['backbone L node'].append((f'R{base+2}', '2'))
        groups['termination resistor'] = [(f'JP{n}', '2'), (f'R{base+2}', '1')]
    for name, members in groups.items():
        check_group(u, name, members)

for n in [50, 60]:
    u, base = f'U{n}', n*10
    groups = {
        'local supply': [(u, a) for a in ['1', '19', '32', '48', '64']] +
                        [(f'C{base+i}', '1') for i in range(6)] +
                        [(f'FB{n}', '1'), (f'R{base+1}', '1'), (f'R{base+2}', '1')],
        'VCAP': [(u, '30'), (f'C{base+6}', '1')],
        'VDDA': [(u, '13'), (f'C{base+7}', '1'), (f'C{base+8}', '1'), (f'FB{n}', '2')],
        'RESET': [(u, '7'), (f'C{base+9}', '1'), (f'R{base+1}', '2'), (f'SW{n}', '1')],
        'self test': [(u, '2'), (f'C{base+10}', '1'), (f'R{base+2}', '2'), (f'SW{n+1}', '1')],
        'BOOT0': [(u, '60'), (f'R{base}', '1')],
        'local ground': [(u, a) for a in ['12', '18', '31', '47', '63']] +
                        [(f'C{base+i}', '2') for i in range(11)] +
                        [(f'R{base}', '2'), (f'SW{n}', '2'), (f'SW{n+1}', '2')],
    }
    for name, members in groups.items():
        check_group(u, name, members)

# Backbone pads must connect across all three zones, with termination on the
# bus side of the isolation jumpers. Local transceiver nets are separate.
for bus in ['A', 'B']:
    for signal in ['H', 'L']:
        net = f'/CAN_{bus}_{signal}'
        members = sorted(key for key, a in pads.items() if a.GetNetname() == net)
        assert len(members) == 8, (net, members)
        check_group(f'CAN_{bus}', f'{signal} backbone', members)

# Check the retained Lab 3 host mapping, including each CS pull-up. The three
# shared SPI signals reach both controllers; CS and INT remain independent.
for host, ca, cb, host_pins in [
        ('U50', 10, 14, ['21', '22', '23', '58', '38', '43', '57']),
        ('U60', 20, 24, ['21', '22', '23', '58', '38', '43', '57']),
        ('J70', 30, 34, ['23', '21', '19', '24', '26', '22', '18'])]:
    for name, hp, cp in zip(['host SCK', 'host MISO', 'host MOSI'],
                            host_pins[:3], ['14', '17', '16']):
        check_group(host, name, [(host, hp), (f'U{ca}', cp), (f'U{cb}', cp)])
    for name, hp, controller in [('host CS A', host_pins[3], ca),
                                 ('host CS B', host_pins[4], cb)]:
        check_group(host, name, [(host, hp), (f'U{controller}', '18'),
                                (f'R{controller*10+1}', '2')])
    for name, hp, controller in [('host INT A', host_pins[5], ca),
                                 ('host INT B', host_pins[6], cb)]:
        check_group(host, name, [(host, hp), (f'U{controller}', '13')])

# Expected endpoints are fixed from the reviewed schematic, not inferred
# from the copper being tested. Supply/load-current paths are separate.
signal_groups = {
    '/Rear zone/R_DEG_A_LED': 'J603.7 R612.1 U60.26',
    '/Rear zone/R_DEG_B_LED': 'J603.8 R613.1 U60.27',
    '/Rear zone/R_REAR_RIGHT_LED': 'J603.13 R651.1 U60.25',
    '/Rear zone/R_RX_A_MARKER': 'J603.3 U60.10',
    '/Rear zone/R_RX_B_MARKER': 'J603.4 U60.11',
    '/Rear zone/R_TX_A_MARKER': 'J603.5 U60.14',
    '/Rear zone/R_OVERLOAD_MARKER': 'J604.9 U60.52',
    '/Front zone/F_DEG_A_LED': 'J503.7 R512.1 U50.26',
    '/Front zone/F_TX_B_MARKER': 'J503.6 U50.15',
    '/Rear zone/R_PID_MARKER': 'J604.7 U60.40',
    '/Rear zone/R_STATUS_LED': 'R610.1 U60.50',
    '/Front zone/F_FRONT_RIGHT_LED': 'J503.11 R551.1 U50.61',
    '/Front zone/F_RX_A_MARKER': 'J503.3 U50.10',
    '/Front zone/F_STATUS_LED': 'R510.1 U50.50',
    '/Front zone/F_STEER_TASK_MARKER': 'J504.6 U50.9',
    '/Rear zone/R_DIR_A_MARKER': 'J603.11 U60.29',
    '/Rear zone/R_LEFT_IN2': 'R633.1 U60.35 U80.7',
    '/Rear zone/R_TASK_PROBE': 'J604.5 U60.39',
    '/Cockpit zone/PI_CMD_TX_MARKER': 'J70.13 J703.4',
    '/Cockpit zone/PI_DEG_A_LED': 'J70.29 J703.7 R712.1',
    '/Cockpit zone/PI_DEG_A_LED_ANODE': 'D712.2 R712.2',
    '/Cockpit zone/PI_DEG_B_LED': 'J70.31 J703.8 R713.1',
    '/Cockpit zone/PI_DEG_B_LED_ANODE': 'D713.2 R713.2',
    '/Cockpit zone/PI_ERROR_LED': 'J70.32 J704.4 R711.1',
    '/Cockpit zone/PI_ERROR_LED_ANODE': 'D711.2 R711.2',
    '/Cockpit zone/PI_SELFTEST_BUTTON': 'C702.1 J70.36 J704.3 R700.2 SW70.1',
    '/Cockpit zone/PI_STATUS_LED': 'J70.33 J704.5 R710.1',
    '/Cockpit zone/PI_STATUS_LED_ANODE': 'D710.2 R710.2',
    '/Cockpit zone/PI_TX_A_MARKER': 'J70.15 J703.5',
    '/Cockpit zone/PI_TX_B_MARKER': 'J70.16 J703.6',
    '/Cockpit zone/PI_UDP_RX_MARKER': 'J70.11 J703.3',
    '/Front zone/F_BOOT0': 'J500.2 R500.1 U50.60',
    '/Front zone/F_DEG_A_LED_ANODE': 'D512.2 R512.2',
    '/Front zone/F_DEG_B_LED_ANODE': 'D513.2 R513.2',
    '/Front zone/F_DIR_A_MARKER': 'J505.4 U50.29',
    '/Front zone/F_ERROR_LED': 'J503.13 J504.4 R511.1 U50.8',
    '/Front zone/F_ERROR_LED_ANODE': 'D511.2 R511.2',
    '/Front zone/F_FRONT_LEFT_LED_BASE': 'Q550.1 R550.2 R560.1',
    '/Front zone/F_FRONT_LEFT_LED_PLUS': 'J550.1 R570.2',
    '/Front zone/F_FRONT_LEFT_LED_SINK': 'J550.2 Q550.3',
    '/Front zone/F_FRONT_RIGHT_LED_BASE': 'Q551.1 R551.2 R561.1',
    '/Front zone/F_FRONT_RIGHT_LED_PLUS': 'J551.1 R571.2',
    '/Front zone/F_FRONT_RIGHT_LED_SINK': 'J551.2 Q551.3',
    '/Front zone/F_PID_MARKER': 'J504.7 U50.40',
    '/Front zone/F_PWM_SET_MARKER': 'J505.3 U50.62',
    '/Front zone/F_RELAY_TX_MARKER': 'J503.12 U50.37',
    '/Front zone/F_RESET_N': 'C509.1 J501.5 R501.2 SW50.1 U50.7',
    '/Front zone/F_SELFTEST_BUTTON': 'C510.1 J504.3 R502.2 SW51.1 U50.2',
    '/Front zone/F_SERVO_PWM': 'J503.9 R530.1 R540.1 U50.42',
    '/Front zone/F_STATUS_LED_ANODE': 'D510.2 R510.2',
    '/Front zone/F_SWCLK': 'J501.2 U50.49',
    '/Front zone/F_SWDIO': 'J501.4 U50.46',
    '/Front zone/F_TX_A_MARKER': 'J503.5 U50.14',
    '/Front zone/SERVO_ADC': 'C2.1 J1.2 J504.8 R2.2 U50.16',
    '/Front zone/SERVO_PWM_OUT': 'J90.3 R540.2',
    '/Front zone/SERVO_RAW': 'J1.1 R2.1 U1.1',
    '/Rear zone/LEFT_ADC': 'C5.1 J2.3 J604.10 R5.2 U60.16',
    '/Rear zone/LEFT_ENC_A_IN': 'R800.2 U81.1',
    '/Rear zone/LEFT_ENC_A_RAW': 'J82.3 R800.1 R804.2',
    '/Rear zone/LEFT_ENC_B_IN': 'R801.2 U81.3',
    '/Rear zone/LEFT_ENC_B_RAW': 'J82.4 R801.1 R805.2',
    '/Rear zone/LEFT_FILTER': 'C4.1 U2.6',
    '/Rear zone/LEFT_RAW': 'J2.1 R3.1 U2.7',
    '/Rear zone/LEFT_SCALED': 'J2.2 R3.2 R4.1 R5.1',
    '/Rear zone/RIGHT_ADC': 'C8.1 J3.3 J604.11 R8.2 U60.17',
    '/Rear zone/RIGHT_ENC_A_IN': 'R802.2 U81.5',
    '/Rear zone/RIGHT_ENC_A_RAW': 'J83.3 R802.1 R806.2',
    '/Rear zone/RIGHT_ENC_B_IN': 'R803.2 U81.9',
    '/Rear zone/RIGHT_ENC_B_RAW': 'J83.4 R803.1 R807.2',
    '/Rear zone/RIGHT_FILTER': 'C7.1 U3.6',
    '/Rear zone/RIGHT_RAW': 'J3.1 R6.1 U3.7',
    '/Rear zone/RIGHT_SCALED': 'J3.2 R6.2 R7.1 R8.1',
    '/Rear zone/R_BOOT0': 'J600.2 R600.1 U60.60',
    '/Rear zone/R_DEG_A_LED_ANODE': 'D612.2 R612.2',
    '/Rear zone/R_DEG_B_LED_ANODE': 'D613.2 R613.2',
    '/Rear zone/R_ERROR_LED_ANODE': 'D611.2 R611.2',
    '/Rear zone/R_LEFT_ENABLE_PWM': 'J603.10 R630.1 U60.42 U80.6',
    '/Rear zone/R_LEFT_ENC_A': 'J605.3 U60.28 U81.2',
    '/Rear zone/R_LEFT_ENC_B': 'J605.4 U60.55 U81.4',
    '/Rear zone/R_LEFT_IN1': 'R632.1 U60.34 U80.5',
    '/Rear zone/R_PWM_SET_MARKER': 'J603.9 U60.62',
    '/Rear zone/R_REAR_LEFT_LED_BASE': 'Q650.1 R650.2 R660.1',
    '/Rear zone/R_REAR_LEFT_LED_PLUS': 'J650.1 R670.2',
    '/Rear zone/R_REAR_LEFT_LED_SINK': 'J650.2 Q650.3',
    '/Rear zone/R_REAR_RIGHT_LED_BASE': 'Q651.1 R651.2 R661.1',
    '/Rear zone/R_REAR_RIGHT_LED_PLUS': 'J651.1 R671.2',
    '/Rear zone/R_REAR_RIGHT_LED_SINK': 'J651.2 Q651.3',
    '/Rear zone/R_RIGHT_ENABLE_PWM': 'J604.8 R631.1 U60.59 U80.11',
    '/Rear zone/R_RIGHT_ENC_B': 'J605.6 U60.33 U81.8',
    '/Rear zone/R_RIGHT_IN3': 'R634.1 U60.36 U80.10',
    '/Rear zone/R_RIGHT_IN4': 'R635.1 U60.51 U80.12',
    '/Rear zone/R_SELFTEST_BUTTON': 'C610.1 J604.3 R602.2 SW61.1 U60.2',
    '/Rear zone/R_STATUS_LED_ANODE': 'D610.2 R610.2',
    '/Rear zone/R_SWCLK': 'J601.2 U60.49',
    '/Rear zone/R_SWDIO': 'J601.4 U60.46',
    '/Rear zone/R_TX_B_MARKER': 'J603.6 U60.15',
    '/Rear zone/R_RELAY_TX_MARKER': 'J605.7 U60.37',
    '/Rear zone/R_STEER_TASK_MARKER': 'J604.6 U60.9',
}
for net, endpoints in signal_groups.items():
    members = [tuple(endpoint.split('.')) for endpoint in endpoints.split()]
    assert all(pads[m].GetNetname() == net for m in members), (net, members)
    check_group('signal', net, members)

# Board-wide branches are checked individually: these do not claim that all
# loads already reach the regulator. Kelvin geometry is reviewed separately.
power_branches = [
    ('C1.1', 'U1.5'), ('C803.1', 'U81.14'), ('R805.1', 'R806.1'),
    ('C503.1', 'J501.1'), ('C1.1', 'C500.1'), ('C503.1', 'J500.1'),
    ('C244.1', 'C803.1'), ('C803.1', 'R805.1'), ('J501.1', 'R700.1'),
    ('C1.1', 'R424.1'), ('C600.1', 'R804.1'),
]
for a, b in power_branches:
    check_group('3V3 branch', f'{a} to {b}', [tuple(a.split('.')), tuple(b.split('.'))])
check_group('encoder power','4V output and both encoders',[('U82','3'),('C805','1'),('J82','1'),('J83','1')])
check_group('encoder power','5V input and bypass',[('L2','2'),('U82','2'),('C804','1')])
check_group('encoder power','ground',[('U82','1'),('C804','2'),('C805','2')])
check_group('servo sense', 'Kelvin IN+', [('R1', '1'), ('U1', '3')])
check_group('servo sense', 'Kelvin IN-', [('R1', '2'), ('U1', '4')])
check_group('servo power', 'regulator to shunt', [('L1', '2'), ('R1', '1')])
check_group('servo power', 'shunt to connector', [('R1', '2'), ('J90', '2')])
check_group('5V distribution', 'regulator and every load group', [
    ('L2', '2'), ('J70', '4'), ('U80', '9'),
    ('U2', '8'), ('U3', '8'), ('C700', '1'), ('C701', '1'),
    ('R570', '1'), ('R571', '1'), ('R670', '1'), ('R671', '1')])
for endpoints in ['U80.2 U2.1 U2.2',
                  'U80.13 U3.1 U3.2',
                  'U2.3 U2.4 J80.1 D800.2 D801.1',
                  'U3.3 U3.4 J81.1 D804.2 D805.1',
                  'U80.3 J80.2 D802.2 D803.1',
                  'U80.14 J81.2 D806.2 D807.1']:
    check_group('motor output', endpoints,
                [tuple(s.split('.')) for s in endpoints.split()])
check_group('rear UART', 'TX', [('U60', '44'), ('J602', '1')])
check_group('rear UART', 'RX', [('U60', '45'), ('J602', '2')])
check_group('filter ground', 'left', [('C5', '2'), ('U2', '5')])
check_group('filter ground', 'right', [('C8', '2'), ('U3', '5')])
check_group('3V3 branch', 'rear pull-up to encoder supply', [('R201', '1'), ('R805', '1')])
check_group('3V3 branch', 'encoder pull-up to bypass', [('R806', '1'), ('C803', '1')])

# October 26 supply joins and MCU connections. These checks deliberately use
# fixed schematic endpoints, so removing their copper must fail the check.
for endpoints in ['C104.1 R140.1', 'R806.1 R602.1', 'R141.1 J44.1',
                  'R806.1 J600.1', 'R340.1 C304.1', 'J500.1 R100.1',
                  'J500.1 R301.1', 'C601.1 R300.1', 'R414.1 C1.1']:
    check_group('3V3 branch', endpoints, [tuple(s.split('.')) for s in endpoints.split()])
for endpoints in ['C3.1 U2.8', 'C6.1 U3.8', 'C801.1 U80.9',
                  'C700.1 C701.1', 'C700.1 J70.4',
                  'R570.1 R571.1', 'R670.1 R671.1']:
    check_group('5V local branch', endpoints, [tuple(s.split('.')) for s in endpoints.split()])
for net, endpoints in {
        '/Front zone/F_FRONT_LEFT_LED': 'J503.10 R550.1 U50.20',
        '/Front zone/F_TASK_PROBE': 'J504.5 U50.39',
        '/Front zone/F_UART_CONSOLE_TX': 'J502.1 U50.44',
        '/Front zone/F_UART_CONSOLE_RX': 'J502.2 U50.45',
        '/Front zone/F_RX_B_MARKER': 'J503.4 U50.11',
        '/Front zone/F_DEG_B_LED': 'J503.8 R513.1 U50.27',
        '/Rear zone/R_ERROR_LED': 'J604.4 R611.1 U60.8',
        '/Rear zone/R_RIGHT_ENC_A': 'J605.5 U60.56 U81.6',
        '/Rear zone/R_REAR_LEFT_LED': 'J603.12 R650.1 U60.24',
}.items():
    members = [tuple(s.split('.')) for s in endpoints.split()]
    assert all(pads[m].GetNetname() == net for m in members)
    check_group('signal', net, members)

# Check every physical pad, including the fuse holder's repeated pin numbers.
# Exclude pours during traversal so a stale zone cannot hide a missing trace.
for net in ['/Power/BAT_PLUS', '/Power/BAT_FUSED', '/Power/RP_GATE',
            '/VBAT_PROTECTED', '/+3V3']:
    physical_pads = [a for f in board.GetFootprints() for a in f.Pads()
                     if a.GetNetname() == net]
    seed = physical_pads[0]
    seen = {a.m_Uuid.AsString() for a in
            connectivity.GetConnectedItems(seed, p.EXCLUDE_ZONES)}
    seen.add(seed.m_Uuid.AsString())
    missing = [a for a in physical_pads if a.m_Uuid.AsString() not in seen]
    if missing:
        errors.append({'reference': 'supply distribution', 'group': net,
                       'unreachable_pad_uuids': [a.m_Uuid.AsString() for a in missing]})
    checks.append({'reference': 'supply distribution', 'group': net, 'net': net,
                   'pads': [a.GetParentFootprint().GetReference()+'.'+a.GetNumber()
                            for a in physical_pads],
                   'physically_connected': not missing, 'zones_excluded': True})

# These new ground bridges must have explicit copper continuity. In particular,
# a common zone object containing two separate islands must not satisfy them.
for endpoints in ['Q551.2 R561.2', 'U1.2 C1.2', 'U1.2 C2.2',
                  'D711.1 D712.1', 'D801.2 D803.2', 'C606.2 R633.2']:
    members = [tuple(s.split('.')) for s in endpoints.split()]
    seed, target = [pads[m] for m in members]
    # Exclude zones during traversal; filtering the returned objects afterward
    # would still permit a connection that went through a zone.
    seen = {a.m_Uuid.AsString() for a in
            connectivity.GetConnectedItems(seed, p.EXCLUDE_ZONES)
            if a.GetNetCode() == seed.GetNetCode()}
    seen.add(seed.m_Uuid.AsString())
    connected = (seed.GetNetname() == target.GetNetname() == '/GND'
                 and target.m_Uuid.AsString() in seen)
    checks.append({'reference': 'ground bridge', 'group': endpoints, 'net': '/GND',
                   'pads': endpoints.split(), 'physically_connected': connected,
                   'zone_objects_excluded': True})
    if not connected:
        errors.append({'reference': 'ground bridge', 'group': endpoints,
                       'reason': 'No explicit copper path excluding zone objects'})

# The two physical pads of each switch pole must both reach the local circuit.
for ref in ['SW50', 'SW51', 'SW60', 'SW61', 'SW70']:
    fp = next(f for f in board.GetFootprints() if f.GetReference() == ref)
    for pin in ['1', '2']:
        physical = [a for a in fp.Pads() if a.GetNumber() == pin]
        reachable(physical[0])
        if any(a.m_Uuid.AsString() not in physical_reachable_cache[physical[0].m_Uuid.AsString()] for a in physical):
            errors.append({'reference': ref, 'group': 'physical switch pads', 'pin': pin})

# Track the previously incomplete MCU signals from the reviewed schematic.
# Derive their current status from copper, rather than a stale hand-written list.
pending_signal_groups = {
    '/Front zone/F_DEG_A_LED': 'J503.7 R512.1 U50.26',
    '/Front zone/F_DEG_B_LED': 'J503.8 R513.1 U50.27',
    '/Front zone/F_FRONT_LEFT_LED': 'J503.10 R550.1 U50.20',
    '/Front zone/F_FRONT_RIGHT_LED': 'J503.11 R551.1 U50.61',
    '/Front zone/F_RX_A_MARKER': 'J503.3 U50.10',
    '/Front zone/F_RX_B_MARKER': 'J503.4 U50.11',
    '/Front zone/F_STATUS_LED': 'R510.1 U50.50',
    '/Front zone/F_STEER_TASK_MARKER': 'J504.6 U50.9',
    '/Front zone/F_TASK_PROBE': 'J504.5 U50.39',
    '/Front zone/F_TX_A_MARKER': 'J503.5 U50.14',
    '/Front zone/F_TX_B_MARKER': 'J503.6 U50.15',
    '/Front zone/F_UART_CONSOLE_RX': 'J502.2 U50.45',
    '/Front zone/F_UART_CONSOLE_TX': 'J502.1 U50.44',
    '/Rear zone/R_DEG_A_LED': 'J603.7 R612.1 U60.26',
    '/Rear zone/R_DEG_B_LED': 'J603.8 R613.1 U60.27',
    '/Rear zone/R_DIR_A_MARKER': 'J603.11 U60.29',
    '/Rear zone/R_ERROR_LED': 'J604.4 R611.1 U60.8',
    '/Rear zone/R_LEFT_IN2': 'R633.1 U60.35 U80.7',
    '/Rear zone/R_OVERLOAD_MARKER': 'J604.9 U60.52',
    '/Rear zone/R_PID_MARKER': 'J604.7 U60.40',
    '/Rear zone/R_REAR_LEFT_LED': 'J603.12 R650.1 U60.24',
    '/Rear zone/R_REAR_RIGHT_LED': 'J603.13 R651.1 U60.25',
    '/Rear zone/R_RELAY_TX_MARKER': 'J605.7 U60.37',
    '/Rear zone/R_RIGHT_ENC_A': 'J605.5 U60.56 U81.6',
    '/Rear zone/R_RIGHT_IN3': 'R634.1 U60.36 U80.10',
    '/Rear zone/R_RX_A_MARKER': 'J603.3 U60.10',
    '/Rear zone/R_RX_B_MARKER': 'J603.4 U60.11',
    '/Rear zone/R_STATUS_LED': 'R610.1 U60.50',
    '/Rear zone/R_STEER_TASK_MARKER': 'J604.6 U60.9',
    '/Rear zone/R_TASK_PROBE': 'J604.5 U60.39',
    '/Rear zone/R_TX_A_MARKER': 'J603.5 U60.14',
}
unfinished_signal_nets = []
for net, endpoints in pending_signal_groups.items():
    members = [tuple(s.split('.')) for s in endpoints.split()]
    assert all(pads[m].GetNetname() == net for m in members), (net, members)
    if set(members) - reachable(pads[members[0]]):
        unfinished_signal_nets.append(net)

tracks = list(board.GetTracks())
# Each unused Pi supply/EEPROM pin has its own no-connect marker. In
# particular, the two Pi 3V3 outputs must not share an accidental PCB net.
for pin in ['17', '27', '28']:
    a = pads[('J70', pin)]
    isolated = ({key for key, q in pads.items() if q.GetNetCode() == a.GetNetCode()}
                == {('J70', pin)} and
                not any(t.GetNetCode() == a.GetNetCode() for t in tracks))
    checks.append({'reference': 'J70', 'group': 'unused pin '+pin,
                   'net': a.GetNetname(), 'isolated_without_copper': isolated})
    if not isolated:
        errors.append({'reference': 'J70', 'group': 'unused pin '+pin})

# A ground pour can connect these pads without a deliberate feedback branch.
# Check the new branches with zones excluded from the traversal itself.
for u, r in [('U40', 'R411'), ('U41', 'R421'), ('U42', 'R431')]:
    a, c = pads[(r, '2')], pads[(u, '3')]
    seen = {q.m_Uuid.AsString() for q in connectivity.GetConnectedItems(a, p.EXCLUDE_ZONES)}
    connected = c.m_Uuid.AsString() in seen
    checks.append({'reference': u, 'group': 'feedback ground trace',
                   'pads': [r+'.2', u+'.3'], 'connected_excluding_zones': connected})
    if not connected:
        errors.append({'reference': u, 'group': 'feedback ground trace'})

# D612 uses an explicit ground trace instead of a starved local pour contact.
a = pads[('D612', '1')]
ground_bridge = any(
    q.Type() == p.PCB_VIA_T and q.GetNetname() == '/GND' and
    abs(p.ToMM(q.GetPosition().x) - 70.3325) < .001 and
    abs(p.ToMM(q.GetPosition().y) - 91.8) < .001
    for q in connectivity.GetConnectedItems(a, p.EXCLUDE_ZONES))
ground_bridge = ground_bridge and a.GetLocalZoneConnection() == p.ZONE_CONNECTION_NONE
checks.append({'reference': 'D612', 'group': 'explicit LED ground trace',
               'connected_excluding_zones': ground_bridge})
if not ground_bridge:
    errors.append({'reference': 'D612', 'group': 'explicit LED ground trace'})

vias = [t for t in tracks if t.Type() == p.PCB_VIA_T]
segments = [t for t in tracks if t.Type() == p.PCB_TRACE_T]
assert tracks and vias, 'No initial routing found'
assert len({t.m_Uuid.AsString() for t in tracks}) == len(tracks)
assert all(t.GetStart() != t.GetEnd() for t in segments)
assert board.GetCopperLayerCount() == 4, 'The reviewed layout uses four copper layers'
# In1 stays a ground reference plane. The November 1 neck-width correction
# adds only short same-net bridges between existing plated contacts; it does
# not introduce signal routing across this layer. Verify that restriction.
plated = list(vias) + [a for a in pads.values() if a.GetAttribute() == p.PAD_ATTRIB_PTH]
for t in segments:
    if t.GetLayer() != p.In1_Cu or t.GetNetname() == '/GND':
        continue
    assert p.ToMM(t.GetLength()) <= 2.0, 'Nonlocal routing on ground plane'
    for endpoint in (t.GetStart(), t.GetEnd()):
        assert any(a.GetNetCode() == t.GetNetCode() and
                   (a.GetPosition()-endpoint).EuclideanNorm() <= p.FromMM(.002)
                   for a in plated), 'Plane bridge must join plated contact centers'
assert any(not z.GetIsRuleArea() and z.GetLayer() == p.In1_Cu and
           z.GetNetname() == '/GND' for z in board.Zones()), 'Missing internal ground plane'
# Existing antenna/access reservations span the inner layers. The new
# mounting exclusions are one zone per layer; top heatsink metal has its own
# surface-only exclusions. check_mounting_clearance.py verifies all 32 hole
# zones and actual pad/track/via/fill separation independently.
assert all(z.GetLayerSet().Contains(p.In1_Cu) and z.GetLayerSet().Contains(p.In2_Cu)
           for z in board.Zones() if z.GetIsRuleArea() and not z.GetZoneName()), 'Inner-layer reservation missing'
clock_routes = []
for n in [10, 14, 20, 24, 30, 34]:
    for pin in ['8', '9']:
        net = pads[(f'U{n}', pin)].GetNetCode()
        copper = [t for t in tracks if t.GetNetCode() == net]
        top_only = all(t.Type() == p.PCB_TRACE_T and t.GetLayer() == p.F_Cu for t in copper)
        length = sum(p.ToMM(t.GetLength()) for t in copper if t.Type() == p.PCB_TRACE_T)
        clock_routes.append({'reference': f'U{n}', 'pin': pin,
                             'top_only_no_vias': top_only, 'total_branch_length_mm': round(length, 3)})
        if not top_only:
            errors.append({'reference': f'U{n}', 'group': 'clock layer', 'pin': pin})
report = {
    'status': 'PASS for checked copper connections only' if not errors else 'FAIL',
    'fabrication_release': False,
    'copper_layer_count': board.GetCopperLayerCount(),
    'track_segments_by_layer': dict(Counter(board.GetLayerName(t.GetLayer()) for t in segments)),
    'errors': errors,
    'counts': {'track_segments': len(segments), 'through_vias': len(vias),
               'copper_zones': sum(not z.GetIsRuleArea() for z in board.Zones()),
               'full_unconnected_count': connectivity.GetUnconnectedCount(False)},
    'segment_width_counts_mm': dict(Counter(round(p.ToMM(t.GetWidth()), 3) for t in segments)),
    'via_diameter_drill_counts_mm': dict(Counter(
        f'{p.ToMM(v.GetWidth(p.F_Cu)):.2f}/{p.ToMM(v.GetDrill()):.2f}' for v in vias)),
    'checks': checks,
    'clock_routes': clock_routes,
    'backbone_nets': [
        {'net': net,
         'total_copper_length_mm_all_branches': round(sum(p.ToMM(t.GetLength()) for t in segments if t.GetNetname() == net), 3),
         'through_vias': sum(t.GetNetname() == net for t in vias)}
        for net in ['/CAN_A_H', '/CAN_A_L', '/CAN_B_H', '/CAN_B_L']],
    'remaining': [
        'Zone graph checks do not prove island continuity; native DRC unconnected items are authoritative.',
        'Input power, the battery divider and all 3V3 pads are connected; the LiPo pair is selected, but power sizing and protection qualification remain open.',
        '5V distribution and motor/servo outputs are connected; review voltage drop, via sharing and thermal current capability separately.',
        'All CAN/MCU and encoder pull-up 3V3 groups now reach the regulator; trunk voltage drop/current capability still need review.',
        'CAN pair geometry, reference-plane continuity and signal-return paths need final review.',
        'Kelvin shunt inputs are connected; review their noise/loop geometry, feedback returns and thermal/current capability.',
        'Power-input and motor protection decisions remain open. Heatsink mounting is implemented; operating temperature is unqualified. No fabrication release.'],
    'unfinished_signal_nets': unfinished_signal_nets,
    'source_sha256': hashlib.sha256(source.read_bytes()).hexdigest(),
}
args.output.write_text(json.dumps(report, indent=2)+'\n', encoding='utf-8')
print(json.dumps({'status': report['status'], 'counts': report['counts'], 'errors': errors}, indent=2))
raise SystemExit(bool(errors))
