fmarples/18649_team4/stm32_zephyr/src/current_sense.h

#ifndef LAB_CURRENT_SENSE_H
#define LAB_CURRENT_SENSE_H
#include "current_cache.h"
/* Backend runs only in the priority-3 dedicated sampling workqueue. Return 0 on successful
 * acquisition, negative errno on failure. Set bits only for physically acquired
 * channels converted with the configured calibration, initially vendor nominal.
 * Upper ADC rail: -4320 mA motors, +4320 mA servo, not precise overrange
 * readings or symmetric current limits.
 * Signed mA are permitted; INT32_MIN is reserved.
 * Do ADC waits outside shared locks. No motor output or fault policy here. */
int current_backend_read(int32_t ma[3], uint32_t *valid_mask);
void current_sense_start(void); /* Main calls once; schedules the first work item. */
struct current_sample current_sense_snapshot(void);
#endif
