fmarples/18649_team4/pi/part2_protocol.py

"""Teaching link protocol v1. Little-endian integers; CRC-32/IEEE."""
import struct
import zlib

HEADER = b'L2\x01'
COMMAND = struct.Struct('<2sBBIiiiI')
STATUS = struct.Struct('<2sBBIIIIiiiiiiII')
STATUS_SIZE = STATUS.size + 4
# Upper-ADC-rail endpoint magnitude, not a symmetric current limit.
CURRENT_REPORT_MAX_MA = 4320
# Status order: reversed left/right motor sensors, unchanged servo sensor.
CURRENT_REPORT_ENDPOINTS_MA = (-CURRENT_REPORT_MAX_MA, -CURRENT_REPORT_MAX_MA,
                               CURRENT_REPORT_MAX_MA)
STATUS_UDP_PORT = 8002  # Never use the course proxy's force-feedback input on 8001.
STATUS_FIELDS = ('status_seq', 'stm_ms', 'command_seq', 'state', 'steer', 'throttle',
                 'brake', 'current_left_mA', 'current_right_mA', 'current_servo_mA',
                 'current_valid_mask', 'rejected')
STATES = ('WAITING', 'LINK_OK', 'ERROR_TIMEOUT', 'ERROR_BAD_INPUT', 'ERROR_RX_OVERFLOW',
          'ERROR_MOTOR', 'SELF_TEST', 'ERROR_ACTUATOR')


def command(seq, steer, throttle, brake, buttons=0):
    payload = COMMAND.pack(b'L2', 1, 1, seq & 0xffffffff, steer, throttle, brake, buttons)
    return payload + struct.pack('<I', zlib.crc32(payload))


def wheel_packet(data):
    """Decode raw course input, including A; the bridge consumes A before UART TX."""
    if len(data) != 276:
        raise ValueError('Expected a 276-byte Windows wheel packet')
    seq = struct.unpack_from('<I', data, 0)[0]
    steer, throttle = struct.unpack_from('<ii', data, 4)
    brake = struct.unpack_from('<i', data, 24)[0]
    if any(v < -32768 or v > 32767 for v in (steer, throttle, brake)):
        raise ValueError('Wheel axis is outside the calibrated signed raw range')
    buttons = sum(1 << i for i in range(11) if data[52 + i] & 0x80)
    return seq, steer, throttle, brake, buttons


# Re-encode a validated MCU status for read-only UDP forwarding, ignoring CSV metadata.
def status_frame(status):
    payload = STATUS.pack(b'L2', 1, 2, *(status[name] for name in STATUS_FIELDS))
    return payload + struct.pack('<I', zlib.crc32(payload))


def pop_status(buffer):
    """Yield complete valid frames; resynchronise after junk or corruption."""
    magic = HEADER + b'\x02'
    while len(buffer) >= 4:
        start = buffer.find(magic)
        if start < 0:
            del buffer[:-3]
            return
        del buffer[:start]
        if len(buffer) < STATUS_SIZE:
            return
        frame = bytes(buffer[:STATUS_SIZE])
        if zlib.crc32(frame[:-4]) != struct.unpack('<I', frame[-4:])[0]:
            del buffer[0]
            continue
        fields = STATUS.unpack(frame[:-4])
        del buffer[:STATUS_SIZE]
        yield dict(zip(STATUS_FIELDS, fields[3:]))


def is_newer(seq, previous):
    return previous is None or 0 < ((seq - previous) & 0xffffffff) < 0x80000000
