fmarples/18649_team4/tests/test_bridge_freshness.py

"""Exercise real bridge parsing/state logic with external UART/UDP/clock adapters."""
from collections import deque
from pathlib import Path
import struct
import sys
from types import SimpleNamespace
import unittest
from unittest.mock import patch

sys.path.insert(0, str(Path(__file__).resolve().parents[1] / 'pi'))
import part2_bridge as bridge
import part2_protocol as protocol


# Make a real course packet; only the external transports and clock are replaced.
def wheel(seq, throttle, buttons=0):
    packet = bytearray(276)
    struct.pack_into('<Iii', packet, 0, seq, 0, throttle)
    struct.pack_into('<i', packet, 24, 32767)
    for i in range(11):
        if buttons & (1 << i):
            packet[52 + i] = 0x80
    return bytes(packet)


# Run the real bridge until an external KeyboardInterrupt, recording its UART frames.
def capture(events, stop_at, pause_after_first_sleep=0, trace_events=None,
            received_status=b'', forwarded=None, fail_forward=False, extra_args=(), writes_out=None):
    queue = deque(events)
    clock = SimpleNamespace(now=0.0, slept=False)
    writes = [] if writes_out is None else writes_out
    class Trace:
        def __enter__(self): return self
        def __exit__(self, *args): pass
        def udp_rx(self):
            if trace_events is not None: trace_events.append('udp')
        def command_tx(self):
            if trace_events is not None: trace_events.append('tx')

    class Udp:
        def bind(self, address): pass
        def setblocking(self, value): pass
        def close(self): pass
        def sendto(self, data, address):
            if fail_forward: raise OSError('Simulated unreachable monitor')
            if forwarded is not None: forwarded.append((data, address))
            return len(data)
        def recvfrom(self, size):
            if not queue or queue[0][0] > clock.now:
                raise BlockingIOError
            return queue.popleft()[1], ('127.0.0.1', 9000)

    class Uart:
        delivered = False
        def __enter__(self): return self
        def __exit__(self, *args): pass
        def reset_input_buffer(self): pass
        def read(self, size):
            if clock.now <= 0 or self.delivered: return b''
            self.delivered = True
            return received_status
        def write(self, data):
            if trace_events is not None: trace_events.append('write')
            writes.append((clock.now, struct.unpack_from('<IiiiI', data, 4)))
            return len(data)

    def sleep(dt):
        elapsed = pause_after_first_sleep if not clock.slept and pause_after_first_sleep else dt
        # Avoid float drift at the exact debounce/double-press test boundaries.
        clock.now = round(clock.now + elapsed, 9)
        clock.slept = True
        if clock.now > stop_at:
            raise KeyboardInterrupt

    with patch.object(bridge, 'time', SimpleNamespace(monotonic=lambda: clock.now, sleep=sleep)), \
         patch.object(bridge.socket, 'socket', return_value=Udp()), \
         patch.object(bridge, 'create_trace', return_value=Trace()), \
         patch.dict(sys.modules, {'serial': SimpleNamespace(Serial=lambda *a, **kw: Uart())}), \
         patch.object(sys, 'argv', ['part2_bridge.py', '--mode', 'live', *extra_args]), \
         patch('builtins.print'):
        bridge.main()
    return writes


class BridgeFreshnessTests(unittest.TestCase):
    def test_a_latches_hazard_and_stops_all_uart_commands_until_double_press(self):
        events = [(0, wheel(1, -32768)), (.01, wheel(2, -32768, buttons=1))]
        # Keep valid wheel traffic alive; releasing A must not clear the latch.
        events += [(i * .02, wheel(i + 2, -32768)) for i in range(1, 31)]
        writes = capture(events, .62)
        self.assertEqual([fields[1:] for _, fields in writes],
                         [(0, -32768, 32767, 0)])
        self.assertTrue(all(t < .01 for t, _ in writes))

    def test_double_press_resumes_current_pedals_without_forwarding_a(self):
        writes = capture([(0, wheel(1, 32767)), (.01, wheel(2, -32768, 1)),
                          (.04, wheel(3, -32768)), (.08, wheel(4, -32768)),
                          (.12, wheel(5, -32768, 1 | (1 << 5))),
                          (.14, wheel(6, -32768, 1 | (1 << 4)))], .17)
        self.assertFalse(any(.01 <= t < .12 for t, _ in writes))
        resumed = [fields for t, fields in writes if t >= .12]
        self.assertGreaterEqual(len(resumed), 3)  # Includes a periodic refresh while A is held.
        self.assertEqual(resumed[0], (1, 0, -32768, 32767, 1 << 5))
        self.assertEqual(resumed[1], (2, 0, -32768, 32767, 1 << 4))
        self.assertTrue(all(fields[4] & 1 == 0 for _, fields in writes))

    def test_hazard_debounce_hold_and_double_press_boundaries(self):
        cases = [
            ('held A', {0: 1, .02: 1, .04: 1}, None, .06),
            ('short release bounce', {0: 1, .01: 0, .029: 1}, None, .05),
            ('20 ms release', {0: 1, .01: 0, .03: 1}, .03, .05),
            ('400 ms double press', {0: 1, .4: 1}, .4, .42),
            ('401 ms is not double press', {0: 1, .401: 1}, None, .42),
            ('fresh double clears old latch', {0: 1, .5: 1, .54: 0, .58: 1}, .58, .60),
        ]
        for name, presses, resume_at, stop_at in cases:
            with self.subTest(name=name):
                states = {round(i * .02, 3): 0 for i in range(int(stop_at / .02) + 1)}
                states.update(presses)
                events = [(t, wheel(seq, -32768, buttons))
                          for seq, (t, buttons) in enumerate(sorted(states.items()))]
                writes = capture(events, stop_at)
                if resume_at is None:
                    self.assertEqual(writes, [])
                else:
                    self.assertTrue(writes)
                    self.assertEqual(writes[0][0], resume_at)
                    self.assertTrue(all(t >= resume_at and fields[4] & 1 == 0
                                        for t, fields in writes))

    def test_hazard_silences_invalid_and_stale_brakes_and_survives_counter_restart(self):
        writes = capture([(0, wheel(100, -32768)), (.01, wheel(101, -32768, 1)),
                          (.02, b'bad'), (.03, wheel(100, -32768)),
                          (.15, wheel(1, -32768)), (.18, wheel(2, -32768, 1))], .21)
        self.assertEqual(writes[0][1], (0, 0, -32768, 32767, 0))
        self.assertFalse(any(.01 <= t < .18 for t, _ in writes))
        self.assertEqual(writes[1], (.18, (1, 0, -32768, 32767, 0)))

    def test_duplicate_old_and_invalid_packets_cannot_clear_hazard(self):
        writes = capture([(0, wheel(99, 32767)), (.01, wheel(100, -32768, 1)),
                          (.03, wheel(101, -32768)), (.06, wheel(101, -32768, 1)),
                          (.07, wheel(100, -32768, 1)), (.08, b'bad'),
                          (.09, wheel(102, -32768))], .12)
        self.assertEqual(writes, [(0, (0, 0, 32767, 32767, 0))])

    def test_status_is_still_forwarded_during_hazard_with_no_uart_tx(self):
        import zlib
        body = protocol.STATUS.pack(b'L2', 1, 2, 1, 60, 0, 2, 0, 32767, -32768,
                                    -1000, 0, 4320, 7, 0)
        status = body + struct.pack('<I', zlib.crc32(body))
        forwarded = []
        writes = capture([(0, wheel(1, -32768, 1))], .03,
                         received_status=status, forwarded=forwarded)
        self.assertEqual(writes, [])
        self.assertEqual(forwarded, [(status, ('127.0.0.1', 8002))])

    def test_forwards_only_valid_status_to_separate_laptop_port(self):
        import zlib
        body = protocol.STATUS.pack(b'L2', 1, 2, 1, 20, 0, 1, 0, 32767, 32767,
                                    -1000, 0, 4320, 7, 0)
        status = body + struct.pack('<I', zlib.crc32(body))
        corrupt = status[:-1] + bytes([status[-1] ^ 1])
        forwarded = []
        capture([(0, wheel(1, 32767))], .03, received_status=corrupt + status,
                forwarded=forwarded)
        self.assertEqual(forwarded, [(status, ('127.0.0.1', 8002))])

    def test_missing_or_unreachable_gui_does_not_change_command_path(self):
        import zlib
        body = protocol.STATUS.pack(b'L2', 1, 2, 1, 20, 0, 1, 0, 32767, 32767,
                                    -1000, 0, 4320, 7, 0)
        status = body + struct.pack('<I', zlib.crc32(body))
        events = [(0, wheel(1, -32768))]
        baseline = capture(events, .1)
        failed = capture(events, .1, received_status=status, fail_forward=True)
        self.assertEqual(failed, baseline)
        forwarded = []
        capture([], .01, received_status=status, forwarded=forwarded,
                extra_args=('--telemetry-host', '127.0.0.2', '--telemetry-port', '8123'))
        self.assertEqual(forwarded, [(status, ('127.0.0.2', 8123))])
        self.assertNotEqual(forwarded[0][1][1], 8001)

    def test_telemetry_cannot_target_force_or_command_port(self):
        for port in ('8000', '8001', '0', '65536'):
            with self.subTest(port=port), self.assertRaises(SystemExit) as error:
                capture([], .01, extra_args=('--telemetry-port', port))
            self.assertEqual(error.exception.code, 2)

    def test_trace_includes_invalid_udp_and_stop_frames(self):
        edges = []
        writes = capture([(0, wheel(1, 32767)), (0.001, b'bad')], .090, trace_events=edges)
        self.assertEqual(edges.count('udp'), 2)
        self.assertEqual(edges.count('tx'), len(writes))
        for i, event in enumerate(edges):
            if event == 'write': self.assertEqual(edges[i - 1], 'tx')
        self.assertTrue(any(fields[3] == -32768 for _, fields in writes))

    def test_timeout_discards_queued_throttle_instead_of_restarting(self):
        # The producer stops at 2 ms. A bridge scheduling pause ends at 120 ms.
        writes = capture([(0, wheel(100, -32768)), (0.001, wheel(101, -32768)),
                          (0.002, wheel(102, -32768))], 0.2, pause_after_first_sleep=0.12)
        after_pause = [fields for t, fields in writes if t >= 0.12]
        self.assertEqual(len(after_pause), 1)
        self.assertEqual(after_pause[0][1:4], (0, 32767, -32768))

    def test_invalid_input_does_not_accept_older_or_duplicate_pedals(self):
        writes = capture([(0, wheel(100, 32767)), (0.001, b'bad'),
                          (0.002, wheel(99, -32768)), (0.003, wheel(100, -32768)),
                          (0.004, wheel(101, -32768))], 0.015)
        drives = [(t, fields) for t, fields in writes if fields[2] == -32768]
        self.assertEqual(len(drives), 1)
        self.assertGreaterEqual(drives[0][0], 0.004)
        self.assertTrue(any(fields[3] == -32768 for _, fields in writes))

    def test_actual_timeout_allows_a_new_counter_baseline_after_invalid_input(self):
        writes = capture([(0, wheel(100, 32767)), (0.001, b'bad'),
                          (0.100, wheel(1, -32768))], 0.110)
        self.assertTrue(any(t >= 0.100 and fields[2] == -32768 for t, fields in writes))


if __name__ == '__main__':
    unittest.main()
