fmarples/18649_team4/tests/test_servo_console.py

import importlib.util
from pathlib import Path
import unittest
import json
import tempfile
spec = importlib.util.spec_from_file_location("servo_console", Path(__file__).parents[1] / "windows/servo_console.py")
console = importlib.util.module_from_spec(spec)
spec.loader.exec_module(console)

class CalibrationFileTests(unittest.TestCase):
    def test_team_preset_and_local_override(self):
        with tempfile.TemporaryDirectory() as directory:
            local = Path(directory) / 'calibration.json'
            selected, values = console.read_calibration(local)
            self.assertEqual(selected, console.TEAM_FILE)
            self.assertEqual(values, [1200, 1600, 2000])
            with self.assertRaises(FileNotFoundError):
                console.read_calibration(local, allow_fallback=False)
            local.write_text(json.dumps(dict(period_us=20000, left_us=1250,
                                            center_us=1550, right_us=1900)))
            self.assertEqual(console.read_calibration(local), (local, [1250, 1550, 1900]))
            local.write_text('{broken')
            with self.assertRaises(json.JSONDecodeError):
                console.read_calibration(local)  # Never mask a bad local calibration.

    def test_accept_both_directions_and_reject_bad_geometry(self):
        for points in ((1100, 1510, 1850), (1850, 1510, 1100)):
            data = dict(zip(("left_us", "center_us", "right_us"), points), period_us=20000)
            self.assertEqual(console.validate_calibration(data), list(points))
        for points in ((1500, 1500, 1800), (500, 2500, 1500), (499, 1500, 1800), (1100, True, 1850)):
            with self.assertRaises(ValueError):
                console.validate_calibration(dict(zip(("left_us", "center_us", "right_us"), points), period_us=20000))

    def test_waiting_status_and_auto_command(self):
        status = console.parse_status('SERVO OK mode=3 pulse=0 left=1200 center=1600 right=2000 marks=7 valid=1')
        self.assertEqual(console.describe(status),
                         'WAIT_CENTER: pulse=0 us; left=1200 center=1600 right=2000 us; calibration=READY')
        self.assertEqual(console.COMMANDS['auto'], 'AUTO')

    def test_wrong_period_missing_fields_and_error_responses(self):
        with self.assertRaises(ValueError):
            console.validate_calibration(dict(left_us=1100, center_us=1500, right_us=1850, period_us=1000))
        with self.assertRaises(ValueError):
            console.parse_status("SERVO OK mode=0")
        with self.assertRaises(ValueError):
            console.parse_status("SERVO ERR mode=0 pulse=0 left=0 center=0 right=0 marks=0 valid=0")
        self.assertEqual(console.parse_status("SERVO OK mode=0 pulse=0 left=0 center=0 right=0 marks=0 valid=0")["pulse"], 0)

if __name__ == "__main__":
    unittest.main()
