fmarples/18649_team4/(commit log)

2026-09-26 Initial UART starter code
2026-09-26 Add Tianyi Lab 2 UART wheel link
2026-09-26 docs: add project context, hardware record, encoder bring-up
    - AGENTS.md: Lab 2 scope, command path, pointers to handout, pin
    document, team Drive folder, BOM, and bring-up instructions, plus
    rules for separating confirmed, planned, and untested hardware state.
    - doc/HARDWARE.md: team BOM with confirmed parts and open questions,
    including the HW-688 buck converter and the confirmed external E5V
    power setup for the Nucleo.
    - doc/STM32_PINOUT.md: tentative pin assignments, encoder wiring,
    proposed steering and L298N revisions, and unresolved firmware issues.
    - doc/18-449_649 Lab2 - Sensors and Actuators v1_0.pdf: assignment source
    referenced by the documents above.
    - bringup/encode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
    [check_encoder_serial.py, main.c]
2026-09-26 feat: add guarded motor bring-up and encoder verification
    - bringup/motor_test/: add bounded forward trials, encoder motion guards, interrupt-driven UART RX, and cutoff-priority enforcement.
    - tests/: add host behavior tests and explicit serial, motion, idle, and PWM configuration checks.
    - doc/ and bringup/encoder_test/README.md: record wiring, provisional encoder calibration, motor polarities, bench results, and remaining limits.
    - .gitignore: keep Python caches, firmware builds, and local captures unversioned.
2026-09-26 feat: automate simultaneous motor characterization
    - bringup/motor_test/: add bounded kick/hold profiles and timestamped encoders
    - tests/: automate both-motor sweeps with fault/rest interlocks and regression checks
    - doc/: record startup thresholds, holding speeds, limits and ACS712 identification
    - README.md, handoff-motor-bringup.md: document results and repeatable workflow
2026-09-26 Implement Part 3.4 blinkers with UART integration and bench guide
2026-09-26 Add startup hazards and immediate button self-test latch
2026-09-26 Add opt-in steering calibration and wheel tracking bench
    [pwm-servo.yaml]
2026-09-26 feat: add continuous motor PID control with latched B1 stop
    - bringup/motor_test/src/: regulate average encoder RPM with full PID, measured duty thresholds, and a latched B1 stop.
    - bringup/motor_test/: enable floating-point control and add background start/stop scripts with persistent logs.
    - tests/: cover PID feedback, continuous operation, manual loading, shutdown, and host logging failures.
    - AGENTS.md, README.md, doc/, bringup/motor_test/README.md: record operating decisions, bench evidence, wiring, and lab requirements.
    [bench_control.c, bench_control.h, check_motor_hold.py, check_motor_pid.py, main.c, run_motor_sweep.py, start.py, stop.py]
2026-09-26 Record second HW-688 available for servo power
2026-09-26 Follow TA guidance for fixed 5 V servo bench supply
2026-09-26 feat: integrate pedal commands with encoder-based motor PID
    - stm32_zephyr/: connect CRC commands to pedal mapping, startup kick, PID, braking and latched B1 stop.
    - pi/: brake on stale or invalid UDP and discard stale queued input before recovery.
    - bringup/motor_test/: support full-duty measurements and immediate PID retargeting.
    - tests/, test_protocol.py: cover pedal boundaries, drive transitions, freshness and measurement endpoints.
    - AGENTS.md, README.md, PROTOCOL.md, PART4_*.md, doc/, handoff-motor-bringup.md: record calibration, full-duty results and pending hardware validation.
2026-09-27 Prepare Part 4 scheduling, timing probes and sensor handoff
    [PART4_MEASUREMENTS.csv, servo_calibration.json]
2026-09-27 feat: add ADC current sensing and centered-start steering
    - stm32_zephyr/src/current_backend.c, app.overlay, Kconfig, prj.conf: sample
    left/right/servo ACS712 5A outputs on ADC1 PA0/PA1/PB0 with nominal
    calibration and the user-selected +4320 mA reporting ceiling
    - stm32_zephyr/src/current_cache.{c,h}, current_sense.{c,h}, main.c: publish
    channel validity, acquisition errors and sample age; log a CURRENT line
    - pi/part2_protocol.py, pi/part2_bridge.py, test_protocol.py: mark ceiling
    readings in console output only; 56-byte wire layout unchanged
    - stm32_zephyr/src/servo_core.{c,h}, servo_bench.c, CMakeLists.txt,
    src/servo_calibration.h.in, windows/servo_console.py: embed the tracked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
    [actuators.c, check_part4_build.py, current_backend.c, current_cache.c, current_cache.h]
2026-09-27 feat: add wheel telemetry, input logs and managed sessions
    - windows/: add event-filtered logs, physical input changes and connected-only current charts
    - pi/: forward validated MCU telemetry on isolated UDP port 8002
    - start.py, stop.py, tools/wheel_session.py: manage owned GUI and Pi bridge sessions
    - stm32_zephyr/src/current_backend.c: prevent multi-channel ADC overrun hangs with single-channel reads
    - tests/: cover telemetry, input events, disconnected sensors, ADC recovery and session ownership
    - doc/, README.md, PROTOCOL.md, AGENTS.md: record deployment, grounding diagnosis, validation and usage
    [current_backend.c, current_telemetry.py, part2_bridge.py, part2_protocol.py, start.py, start_wheel_proxy.py, stop.py, telemetry_events.py]
2026-09-28 Keep diagnostic IO out of actuator command paths
2026-09-28 Prepare right-motor current sensing and three-channel display
2026-09-28 Record three-sensor flash and passive acquisition results
2026-09-28 Record three-sensor bench readings and right-wheel obstruction evidence
2026-09-28 Summarize September 28 stability and three-sensor bench work
2026-10-05 Correct motor current sensor polarity
    [current_backend.c, test_current_backend.c]
2026-10-05 Remove incorrect motor current polarity inversion
2026-10-05 Correct reversed motor sensor voltage conversion
    - stm32_zephyr/src/: reverse motor voltage slopes and preserve one-sided ADC clipping
    - pi/, windows/: recognize signed per-channel upper-rail endpoints without a symmetric cap
    - tests/, test_protocol.py: cover both directions, unclipped 5 A readings and signed clipping
    - AGENTS.md, README.md, PROTOCOL.md, PART4_TASK_TABLE.md, doc/: update conversion contracts and verification evidence
    [bridge_diagnostics.py, current_backend.c, current_sense.h, main.c, part2_protocol.py, telemetry_events.py, telemetry_gui.py, test_current_backend.c]
2026-10-09 fix: Handle A-button hazards locally on the Pi
    - pi/part2_bridge.py: latch A locally and silence all UART command paths during hazard
    - pi/part2_protocol.py: clarify that the bridge consumes raw A input before UART TX
    - tests/test_bridge_freshness.py: cover latch recovery, debounce, input faults and telemetry
    - PROTOCOL.md, PART4_TASK_TABLE.md, doc/: document timeout-based self-test and software verification
    [part2_bridge.py, part2_protocol.py, test_bridge_freshness.py]
2026-10-18 feat: Add GPIO tracing option to the wheel session launcher
    - tools/wheel_session.py: forward --trace-gpio, persist its state and require restart to enable it on an existing session
    - tests/test_session_launcher.py: cover tracing propagation, session reuse and the restart requirement
    - doc/ONE_CLICK_START.md: document tracing startup and upstream marker behavior
2026-10-20 Add Lab 4 PCB design sources, power calculations, and pin map
2026-10-23 Update Lab 4 circuits, assembly BOMs and measured PCB placement
2026-10-24 Prepare Lab 4 review package and align course assembly plan
2026-10-24 Record team cardboard battery fit check
2026-10-24 Document servo sources and provisional power estimates
2026-10-24 Record Lab 4 cable evidence and clarify review status
2026-10-24 Reconcile Lab 4 review schematic, sourcing and verification
2026-10-24 Record October 24 TA heatsink acceptance and measurement deferral
2026-10-24 Update battery sourcing options and Amazon exception
2026-10-25 Document servo adapter candidate and unresolved current rating
2026-10-25 Reconcile Lab 4 supplier links and latest battery review guidance
2026-10-25 Document provisional Amazon battery and published discharge limits
2026-10-25 Audit October 29 fabrication blockers and synchronize PCB metadata
2026-10-25 Add verified GCT switch footprints and refresh Lab 4 checks
2026-10-25 Refine regulator placement and verify buck support circuits
2026-10-25 Start regulator copper routing and verify local connectivity
2026-10-25 Route MCU and CAN local support circuits
2026-10-26 Route Lab 4 host interfaces and repair affected ground connections
2026-10-26 Route rear UART, servo sense inputs and initial supply branches
2026-10-26 Route four MCU signals and repair ground continuity
2026-10-26 Route output power paths and two MCU signals; correct copper checks
2026-10-26 Connect input power, encoder pull-ups and rear lamp; refine power vias
2026-10-26 Complete MCU routing and refine feedback and power transitions
2026-10-27 Refine power copper and document CAN geometry review
2026-10-27 Repair CAN ground reference and move 70 vias off solder pads
2026-10-27 Separate specialty and common parts in purchasing Excel BOM
2026-10-27 Record verified course Drive BOM upload
2026-10-27 Resolve nine more solder-pad via sites and refresh layout checks
2026-10-27 Clear remaining solder-pad via overlaps and record aperture checks
2026-10-27 Review Lab 4 voltage, capacitor and thermal margins
2026-10-27 Review ground-plane DC loss and additional component packages
2026-10-27 Record manufacturer capacitor model source and unresolved data
2026-10-27 Define heatsink mounting and calculate nominal vehicle clearances
2026-10-27 Apply hole-edge clearance and integrate heatsink and encoder supply
2026-10-27 Shorten Pi supply feed and refine power qualification review
2026-10-28 Document chassis CAD discrepancy without changing verified mounting pattern
2026-10-28 Correct chassis rear-hole correspondence and add labelled CAD details
2026-10-28 Select approved LiPo pair and add battery voltage monitor
2026-10-29 Add chassis mounting allowance and revise power capacitor banks
2026-10-29 Use verified CAD chassis supports and improve Pi supply routing
2026-10-29 Correct motor capacitor package and review power and manufacturing margins
2026-10-29 Extend Lab 4 package audit and record October 29 guidance
    Clarify retained Hirose adapters, assembly constraints, and optional motor protection/camera guidance. Refresh the shared-report PDF and checked review package. Preserve exact Lab 4 artifact bytes across Git so manifest hashes match published files; unrelated file changes are line-ending preservation only. CAD geometry and BOM quantities are unchanged; fabrication release remains false.
2026-10-29 Document required Lab 4 scope and verify Pi feed and fuse margins
2026-10-29 Fix L298 drill tolerance and refresh Lab 4 fabrication review
2026-10-29 Define prototype load budget and defer optional stress work
2026-10-30 Add team identification silkscreen and fabrication stack handoff
2026-11-01 Correct motor-side flyback clamps and apply staff copper rules
2026-11-02 Address Anson schematic and PCB placement review
2026-11-02 Match schematic organization to staff reference style
